CullenSharp/Etch-A-Tune/Prototype/Prttyp_V0.1_img1.jpg

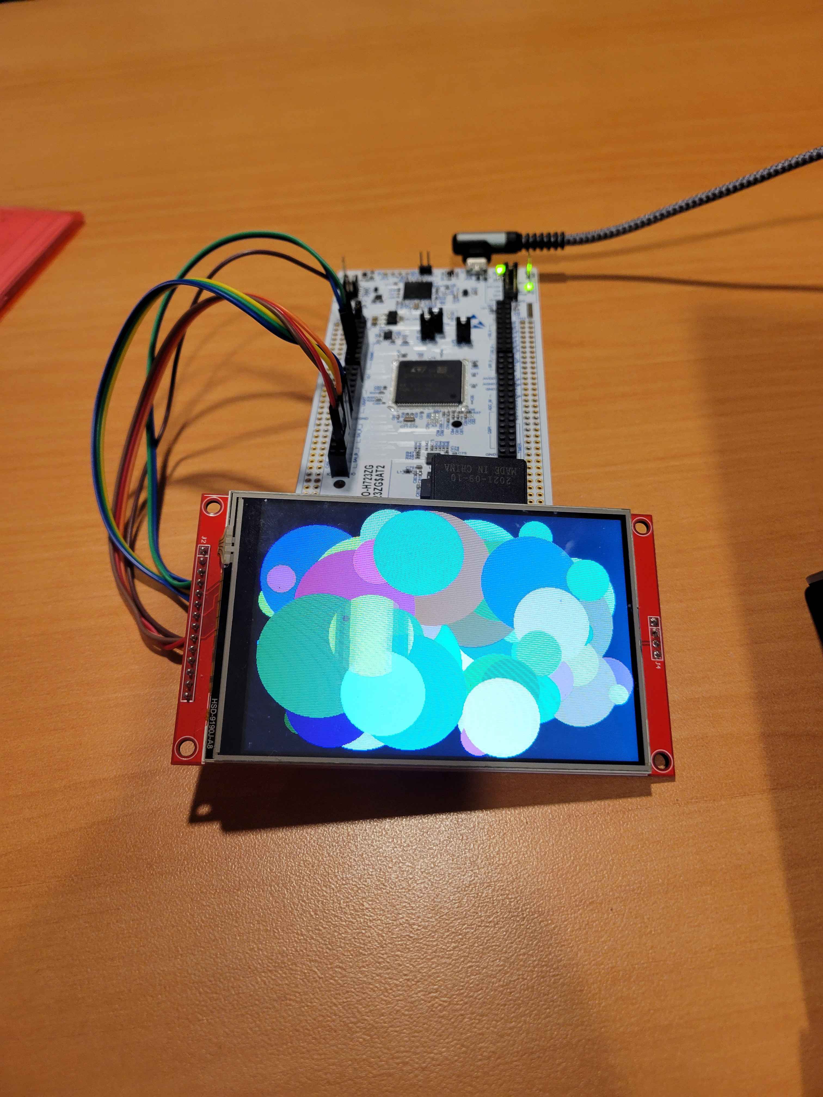
Prototype/Prttyp_V0.1_img1.jpg
