CullenSharp/Etch-A-Tune/Etch_A_Tune/Etch a Tune Bom.xlsx

Bill Of Materials for: [7] [Etch A Tune]
Last modified: [11/21/25]
PCB version: [PCB VERSION 1.0]
BOM revision: [BOM REVISION 1.0]
Qty | Reference Designators | Mfr | Mfr Part Number | Description | Dist | Dist Part Number | Cost Ea. | Cost Total
1 | BT1 | Keystone Electronics | 1042P | BATTERY HOLDER 18650 SMD | Digikey | 36-1042P-ND | $5.54 | $5.54
6 | C1,C2,C12,C25,C30,C31 | Samsung Electro-Mechanics | CL10B105KA8NNNC | CAP CER 1UF 25V X7R 0603 | Digikey | 1276-1184-1-ND | $0.08 | $0.48
20 | C3,C6,C7,C10,C11,C13,C14,C15,C16,C17,C18,C19,C20,C21,C22,C23,C24,C26,C28,C29 | Samsung Electro-Mechanics | CL10E104KC8VPNC | CAP CER 100NF 100V X8L 0603 | Digikey | 1276-CL10E104KC8VPNCCT-ND | $0.25 | $5.00
2 | C4,C9 | Samsung Electro-Mechanics | CL10A106KP8NNNC | CAP CER 10UF 10V X5R 0603 | Digikey | 1276-1192-1-ND | $0.08 | $0.16
1 | C5 | KEMET | C0603C220J5GACTU | CAP CER 22PF 50V C0G/NP0 0603 | Digikey | 399-C0603C220J5GACTUCT-ND | $0.12 | $0.12
1 | C8 | Cal-Chip Electronics, Inc. | GMC32X5R337M6R3NT | CAP1210 X5R 330UF 20% 6.3V | Digikey | 4713-GMC32X5R337M6R3NTCT-ND | $4.26 | $4.26
1 | C27 | Samsung Electro-Mechanics | CL10A475KO8NNNC | CAP CER 4.7UF 16V X5R 0603 | Digikey | 1276-1784-1-ND | $0.08 | $0.08
1 | C32 | KEMET | C0603C221K5RACTU | CAP CER 220PF 50V X7R 0603 | Digikey | 399-C0603C221K5RACTUCT-ND | $0.10 | $0.10
1 | C33 | KEMET | C0603C102J8HACAUTO | CAP CER 0603 1NF 10V ULTRA STABL | Digikey | 399-C0603C102J8HACAUTOCT-ND | $0.13 | $0.13
2 | C36,C37 | KEMET | CBR04C180F5GAC | CAP CER 18PF 50V C0G/NP0 0402 | Digikey | 399-8828-1-ND | $0.35 | $0.70
2 | CR1,CR2 | Toshiba Semiconductor and Storage | CMS06(TE12L,Q,M) | DIODE SCHOTTKY 30V 2A MFLAT | Digikey | CMS06QMCT-ND | $0.23 | $0.46
2 | D1,D2 | WÃ¼rth Elektronik | 150060GS75000 | LED GREEN CLEAR 0603 SMD | Digikey | 732-4971-1-ND | $0.15 | $0.30
1 | FB1 | Murata Electronics | BLM18AG601SN1D | FERRITE BEAD 600 OHM 0603 1LN | Digikey | 490-1014-1-ND | $0.10 | $0.10
1 | J1 | Amphenol | 75915-414LF | Board to Board & Mezzanine Connectors 14P VRT SR RECEPT MATTE TIN | Digikey | 609-75915-414LF-ND | $1.86 | $1.86
3 | J2,J3,J6 | Amphenol ICC (FCI) | 91601-304ALF | 4 Position Receptacle, Bottom or Top Entry Connector 0.100" (2.54mm) Surface Mount Gold | Digikey | 609-91601-304ALFCT-ND | $0.76 | $2.28
1 | J4 | Molex | 2171790001 | USB-C (USB TYPE-C) USB 2.0 Receptacle Connector 24 (16+8 Dummy) Position Surface Mount, Right Angle; Through Hole | Digikey | 900-2171790001CT-ND | $0.83 | $0.83
1 | J5 | Same Sky (Formerly CUI Devices) | SJ-3524-SMT-TR-PI | CONN JACK STEREO 3.5MM SMD R/A | Digikey | CP-3524SJPICT-ND | $1.22 | $1.22
1 | J7 | CNC Tech | 3220-10-0300-00 | CONN HEADER SMD 10POS 1.27MM | Digikey | 1175-1629-ND | $0.81 | $0.81
1 | L1 | Taiyo Yuden | BRL3225T1R0M | FIXED IND 1UH 2.2A 51.6 MOHM SMD | Digikey | 587-2164-1-ND | $0.18 | $0.18
2 | MT1,MT2 | Same Sky (Formerly CUI Devices) | RIC11-31S15D7-GSMT | ENCODER INCREM QUAD VERT SMD/SMT | Digikey | 2223-RIC11-31S15D7-GSMT-ND | $2.14 | $4.28
1 | R1 | TE Connectivity Passive Product | CRGCQ0603F27K | 27 kOhms Â±1% 0.1W, 1/10W Chip Resistor 0603 (1608 Metric) Automotive AEC-Q200, Moisture Resistant Thick Film | Digikey | A129705CT-ND | $0.10 | $0.10
1 | R2 | Panasonic Electronic Components | ERA-3AEB6040V | 604 Ohms Â±0.1% 0.1W, 1/10W Chip Resistor 0603 (1608 Metric) Automotive AEC-Q200 Thin Film | Digikey | P604DBCT-ND | $0.10 | $0.10
1 | R3 | YAGEO | RC0603JR-07330RL | 330 Ohms Â±5% 0.1W, 1/10W Chip Resistor 0603 (1608 Metric) Moisture Resistant Thick Film | Digikey | 311-330GRCT-ND | $0.10 | $0.10
1 | R4 | YAGEO | RC0603JR-072K2L | 2.2 kOhms Â±5% 0.1W, 1/10W Chip Resistor 0603 (1608 Metric) Moisture Resistant Thick Film | Digikey | 311-2.2KGRCT-ND | $0.11 | $0.11
1 | R5 | Panasonic Electronic Components | ERJ-3EKF3603V | 360 kOhms Â±1% 0.1W, 1/10W Chip Resistor 0603 (1608 Metric) Automotive AEC-Q200 Thick Film | Digikey | P360KHCT-ND | $0.10 | $0.10
1 | R6 | YAGEO | RC0603JR-07180KL | 180 kOhms Â±5% 0.1W, 1/10W Chip Resistor 0603 (1608 Metric) Moisture Resistant Thick Film | Digikey | 311-180KGRCT-ND | $0.10 | $0.10
14 | R7,R8,R9,R10,R11,R12,R13,R14,R15,R16,R17,R18,R19,R31 | YAGEO | RC0603FR-0710KL | 10 kOhms Â±1% 0.1W, 1/10W Chip Resistor 0603 (1608 Metric) Moisture Resistant Thick Film | Digikey | 311-10.0KHRCT-ND | $0.10 | $1.40
2 | R20,R21 | Stackpole Electronics Inc | RMCF0603FT10R0 | 10 Ohms Â±1% 0.1W, 1/10W Chip Resistor 0603 (1608 Metric) Automotive AEC-Q200 Thick Film | Digikey | RMCF0603FT10R0CT-ND | $0.10 | $0.20
2 | R22,R23 | YAGEO | RC0603JR-075K1L | 5.1 kOhms Â±5% 0.1W, 1/10W Chip Resistor 0603 (1608 Metric) Moisture Resistant Thick Film | Digikey | 311-5.1KGRCT-ND | $0.10 | $0.20
12 | R24,R25,R26,R27,R28,R29,R30,R33,R34,R35,R36,R39 | YAGEO | RC0603JR-070RL | RES 0 OHM JUMPER 1/10W 0603 | Digikey | 311-0.0GRCT-ND | $0.10 | $1.20
4 | R32,R37,R38,R40 | YAGEO | RC0603JR-070RL | RES 0 OHM JUMPER 1/10W 0603 | Digikey | 311-0.0GRCT-ND | $0.10 | $0.40
5 | S1,S2,S3,S4,S5 | OMRON Electronics | B3AL-1005P | Tactile Switches 4.50N OF Long Stroke Pink Button | Digikey | Z7816CT-ND | $1.53 | $7.65
1 | S6 | WÃ¼rth Elektronik | 450404015514 | Slide Switch SPDT Surface Mount | Digikey | 732-13665-1-ND | $0.80 | $0.80
1 | U1 | Texas Instruments | BQ29700DSER | Voltage and Current Protection for Single-Cell Li-Ion and Li-Polymer Batteries | Digikey | 296-43985-1-ND | $0.51 | $0.51
2 | U2,U3 | Texas Instruments | CSD16406Q3 | MOSFET N-CH 25V 19A/60A 8VSON | Digikey | 296-24251-1-ND | $1.65 | $3.30
1 | U4 | Texas Instruments | TPS62063DSGR | Buck Switching Regulator IC Positive Fixed 3.3V 1 Output 1.6A 8-WFDFN Exposed Pad | Digikey | 296-38304-1-ND | $2.12 | $2.12
1 | U5 | STMicroelectronics | STM32H7A3ZIT6Q | ARMÂ® CortexÂ®-M7 STM32H7 Microcontroller IC 32-Bit 280MHz 2MB (2M x 8) FLASH 144-LQFP (20x20) | Digikey | 497-STM32H7A3ZIT6Q-ND | $14.86 | $14.86
1 | U6 | Texas Instruments | BQ25170DSGR | 800-MA LINEAR BATTERY CHARGER FO | Digikey | 296-BQ25170DSGRCT-ND | $0.96 | $0.96
1 | Y2 | Abracon LLC | ABM8G-12.000MHZ-D2Y-T | CRYSTAL 12.0000MHZ 18PF SMD | Digikey | 535-ABM8G-12.000MHZ-D2Y-TCT-ND | $0.57 | $0.57
VERSION INFO
 |  |  |  |  |  |  | Total: | $63.67
Rev | Date
1.0r1 | 2025-11-21
