CullenSharp/Etch-A-Tune/Enclosure Parts/Painted Capture.pdf

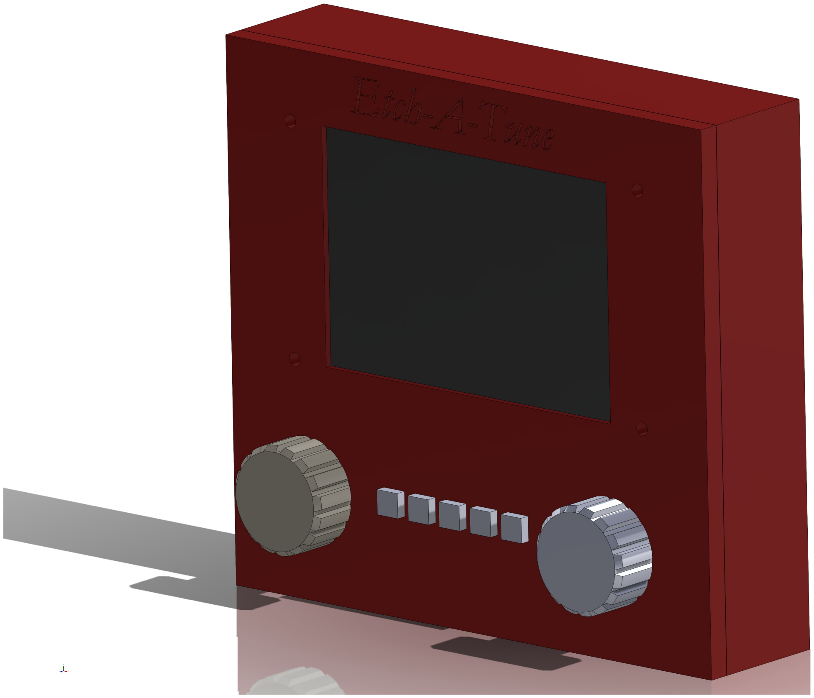
[picture p2: page 1]
