CullenSharp/Etch-A-Tune/Enclosure Parts/Assembly V1.SLDASM

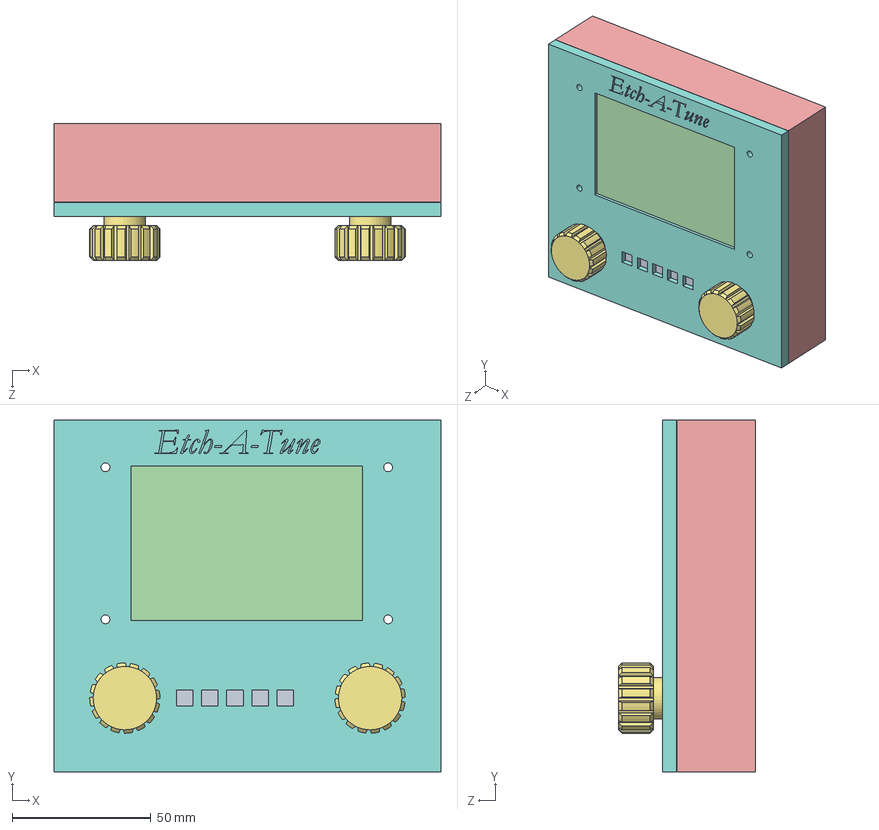
[picture p3: CAD file, 2025-12-13]
Enclosure Parts/Assembly V1.SLDASM
139.7 x 127.0 x 49.6 mm
Front Panel(Old Screen)
Knob x 2
PCB
Back Plate
Screen(Old)
Battery Holder
Battery Cover
Button x 5
