CullenSharp/Etch-A-Tune/Enclosure Parts/Front Panel.SLDPRT

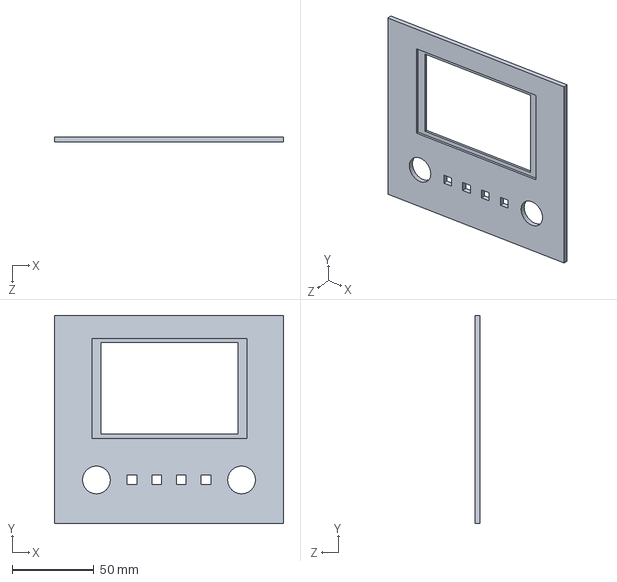
[picture p4: CAD file, 2025-12-13]
Enclosure Parts/Front Panel.SLDPRT
139.7 x 127.0 x 3.17 mm
