CullenSharp/Etch-A-Tune/Enclosure Parts/PCB.SLDPRT

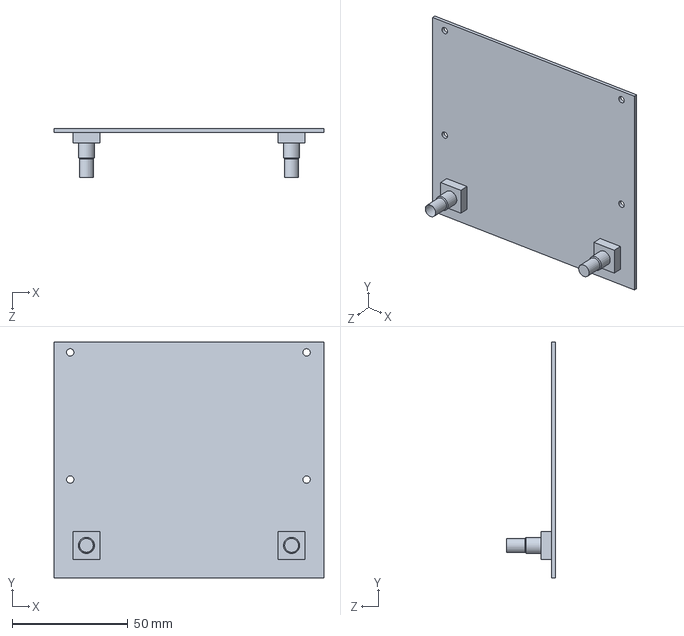
[picture p5: CAD file, 2025-12-13]
Enclosure Parts/PCB.SLDPRT
116.5 x 101.7 x 21.2 mm
