CullenSharp/Etch-A-Tune/Enclosure Parts/Screen.SLDPRT

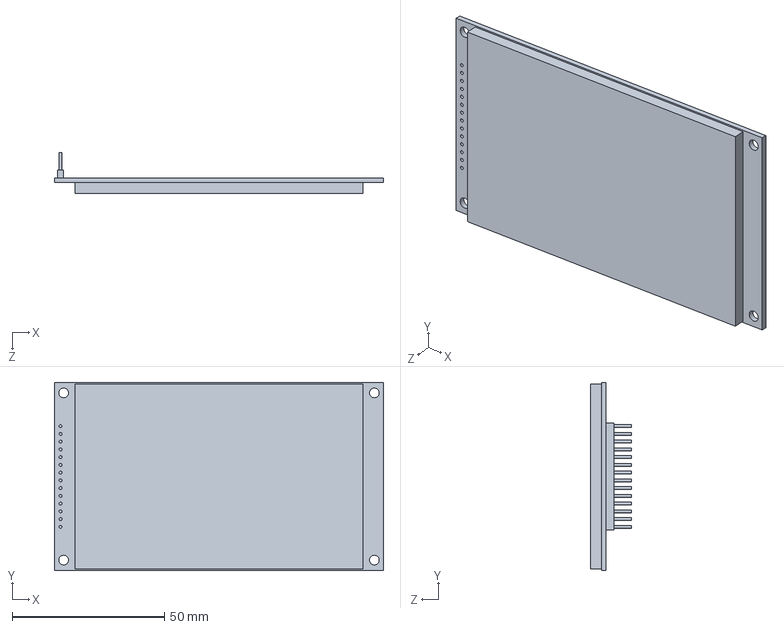
[picture p6: CAD file, 2025-12-13]
Enclosure Parts/Screen.SLDPRT
108.0 x 61.7 x 13.5 mm
