CullenSharp/Etch-A-Tune/Enclosure Parts/Front Panel Test Print V4.SLDPRT

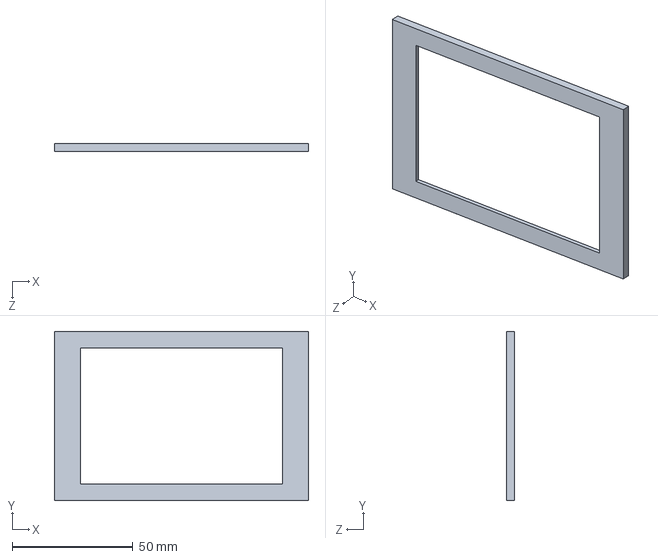
[picture p7: CAD file, 2025-12-13]
Enclosure Parts/Front Panel Test Print V4.SLDPRT
105.0 x 70.0 x 3.17 mm
