CullenSharp/Etch-A-Tune/Enclosure Parts/Back Plate.SLDPRT

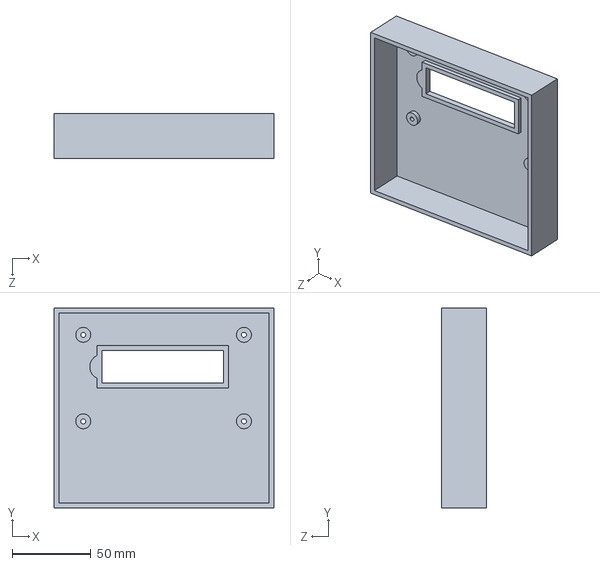
[picture p8: CAD file, 2025-12-13]
Enclosure Parts/Back Plate.SLDPRT
139.7 x 127.0 x 28.4 mm
