CullenSharp/Etch-A-Tune/Enclosure Parts/Battery Cover.SLDPRT

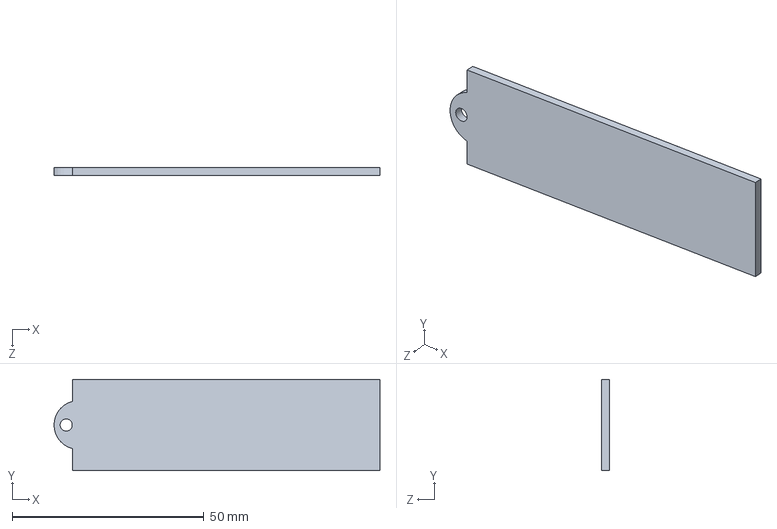
[picture p9: CAD file, 2025-12-13]
Enclosure Parts/Battery Cover.SLDPRT
85.0 x 23.8 x 2.00 mm
