CullenSharp/Etch-A-Tune/Enclosure Parts/Knob.SLDPRT

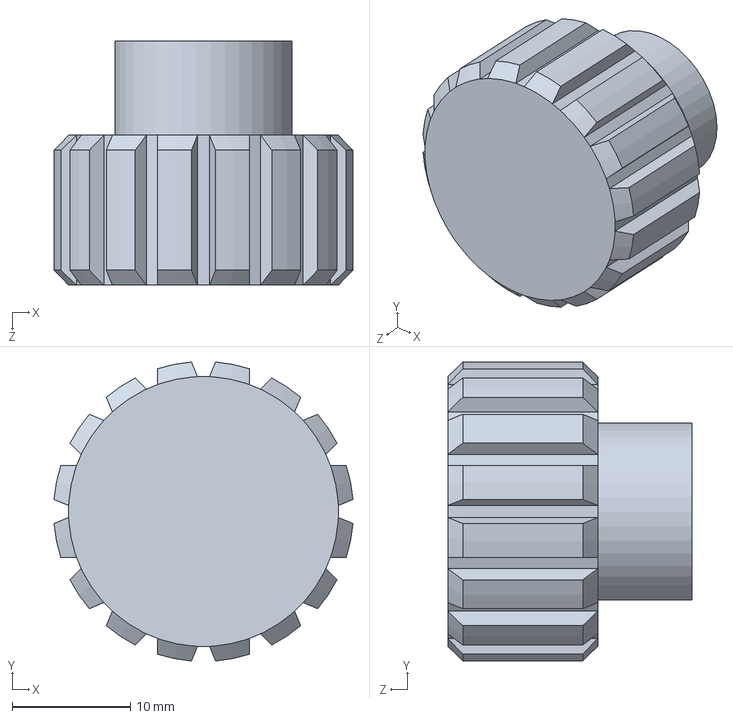
[picture p10: CAD file, 2025-12-13]
Enclosure Parts/Knob.SLDPRT
25.3 x 25.3 x 20.7 mm
