CullenSharp/Etch-A-Tune/Enclosure Parts/Battery Holder.SLDPRT

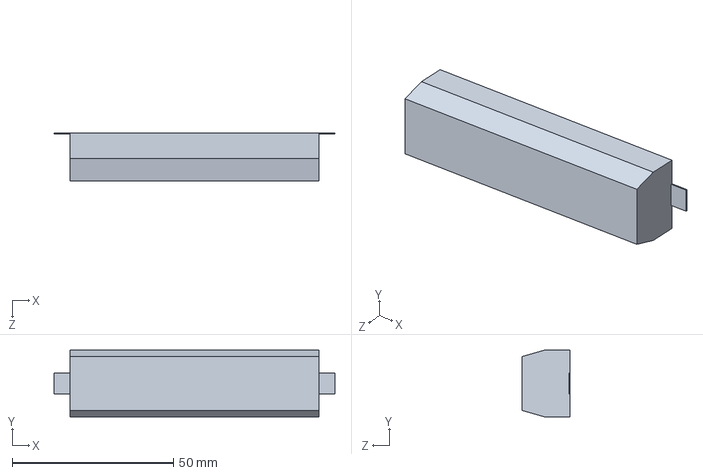
[picture p11: CAD file, 2025-12-13]
Enclosure Parts/Battery Holder.SLDPRT
87.1 x 20.6 x 15.0 mm
