CullenSharp/Etch-A-Tune/Enclosure Parts/Front Panel Test Print.SLDPRT

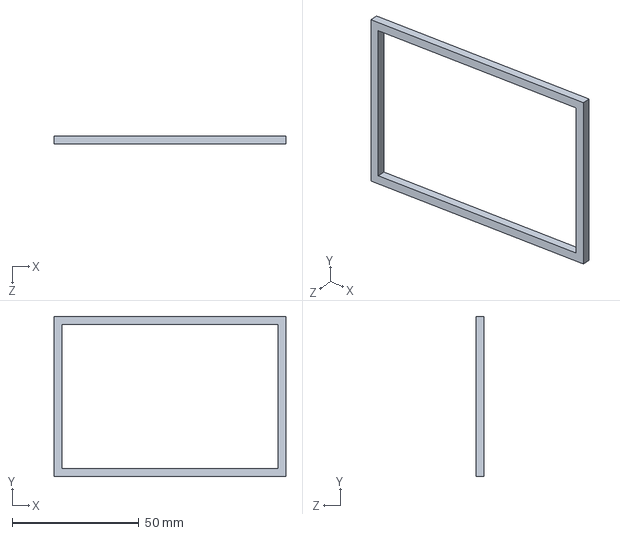
[picture p12: CAD file, 2025-12-13]
Enclosure Parts/Front Panel Test Print.SLDPRT
91.6 x 63.2 x 3.17 mm
