CullenSharp/Etch-A-Tune/Enclosure Parts/Button.SLDPRT

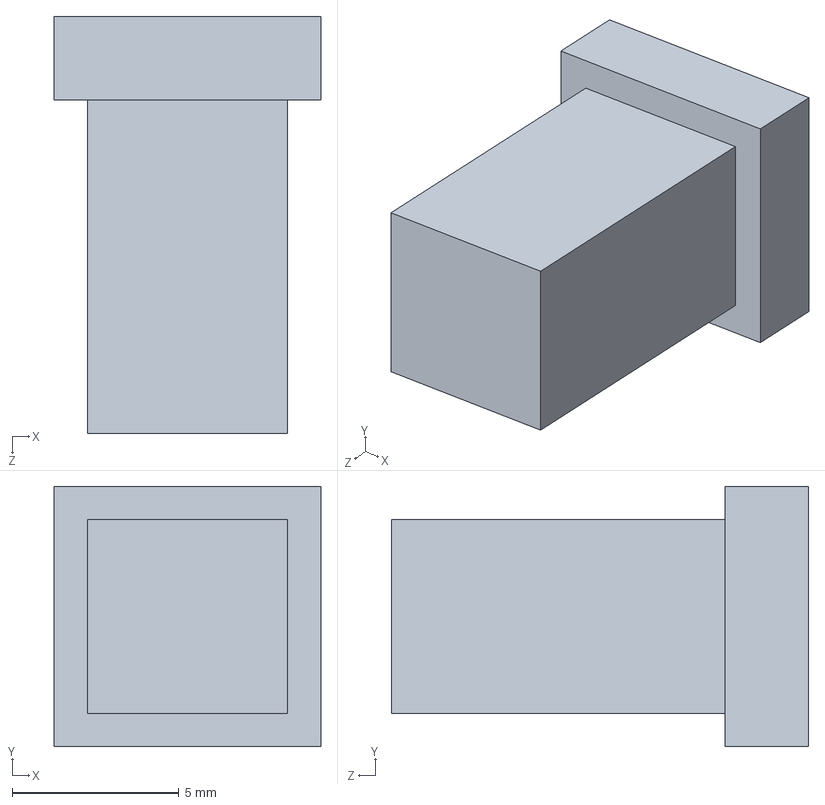
[picture p13: CAD file, 2025-12-13]
Enclosure Parts/Button.SLDPRT
8.00 x 7.80 x 12.5 mm
