CullenSharp/Etch-A-Tune/Enclosure Parts/Old Screen Assembly.SLDASM

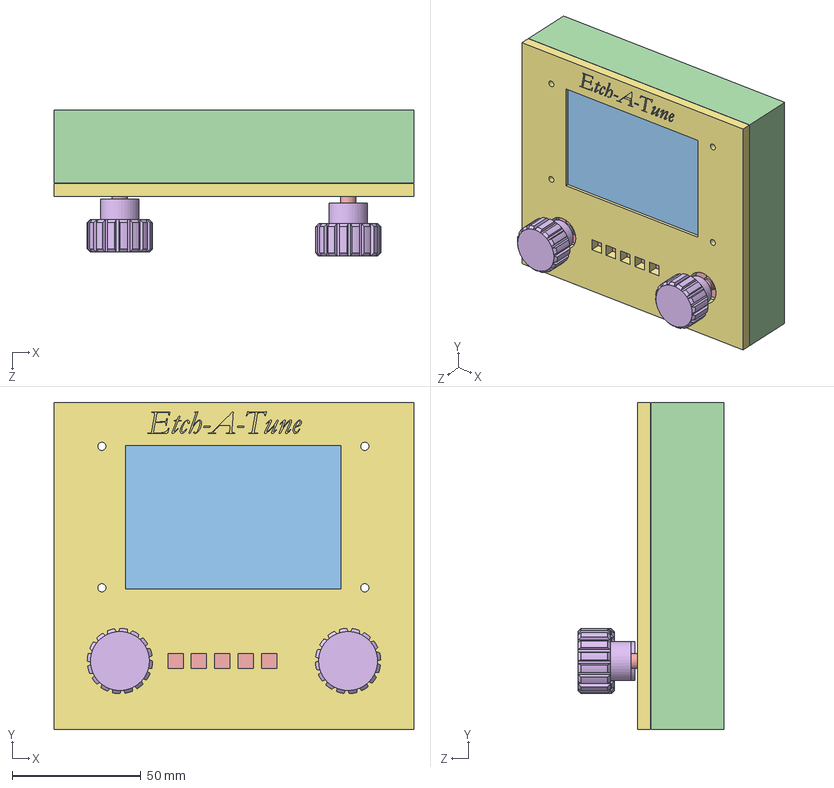
[picture p14: CAD file, 2025-12-13, an earlier design]
Enclosure Parts/Old Screen Assembly.SLDASM
139.7 x 127.0 x 56.8 mm
Front Panel(Old Screen)
Knob x 2
PCB
Back Plate
Screen(Old)
Battery Holder
Battery Cover
