CullenSharp/Etch-A-Tune/Enclosure Parts/Front Panel Test Print V3.STL

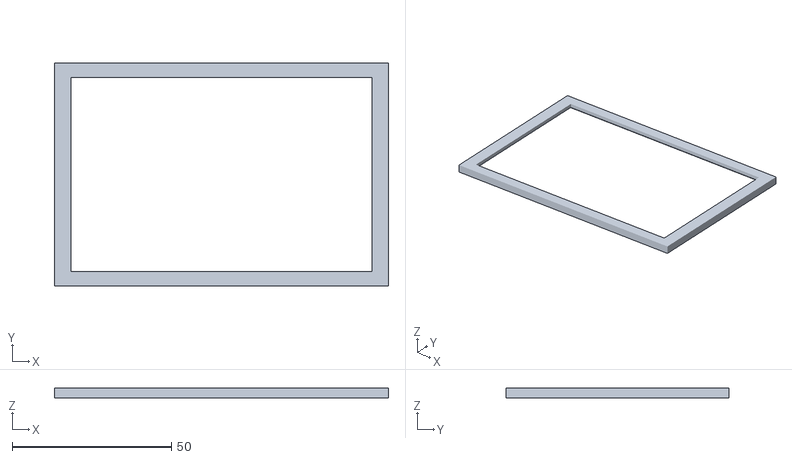
[picture p15: CAD file, 2025-12-13, an earlier design]
Enclosure Parts/Front Panel Test Print V3.STL
105.0 x 70.0 x 3.17
