CullenSharp/Etch-A-Tune/Enclosure Parts/Front Panel(Old Screen).SLDPRT

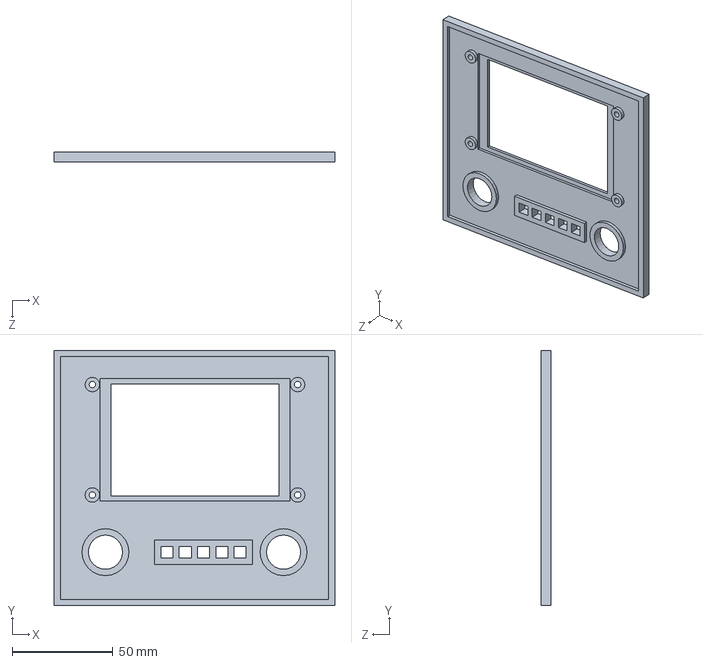
[picture p16: CAD file, 2025-12-13, an earlier design]
Enclosure Parts/Front Panel(Old Screen).SLDPRT
139.7 x 127.0 x 5.14 mm
