CullenSharp/Etch-A-Tune/(list of files, cad)

Other CAD files:
Enclosure Parts/Front Panel Test Print 2.SLDPRT
Enclosure Parts/Screen(Old).SLDPRT
Enclosure Parts/Front Panel Test Print 2.STL
Enclosure Parts/Front Panel Test Print V4.STL
