CullenSharp/Etch-A-Tune/Enclosure Parts/Assembly Capture.pdf

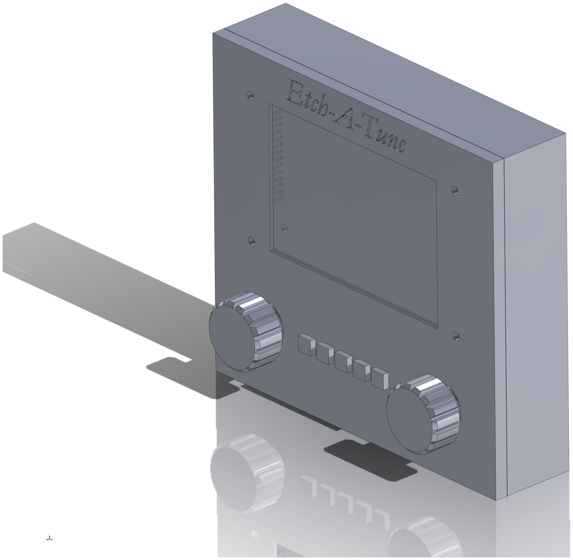
[picture p17: page 1]
