CullenSharp/Etch-A-Tune/Etch_A_Tune/Etch_a_Sketch_Schematic_V0.2/Etch A Tune PCB v.02.pdf

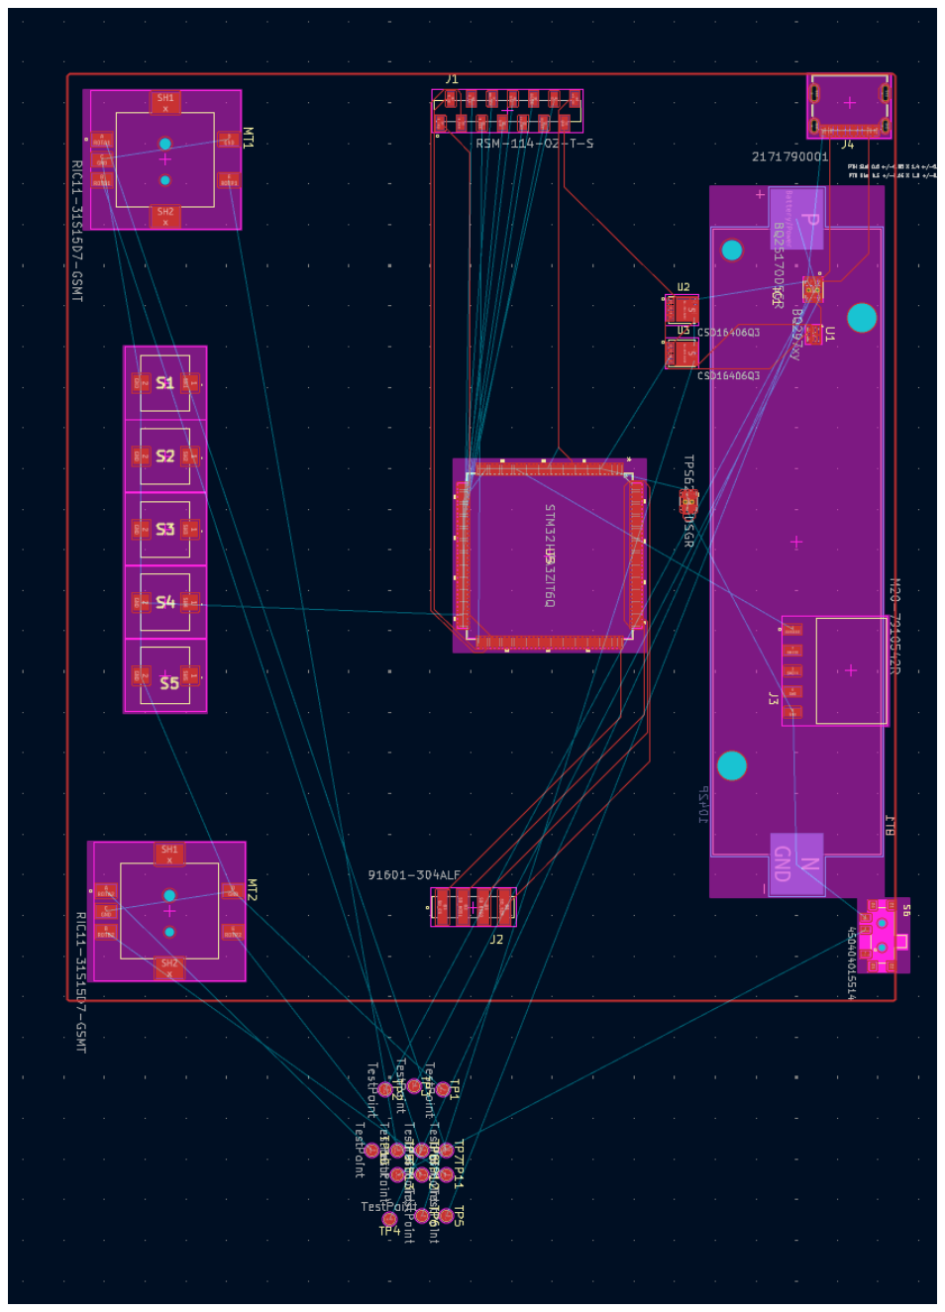
[picture p19: page 1]
