CullenSharp/Etch-A-Tune/Test Data/Test Image A 480x320.png

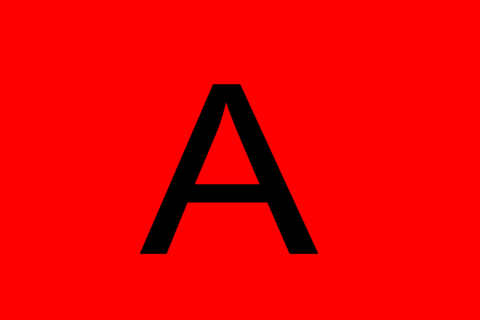
Test Data/Test Image A 480x320.png
