CullenSharp/Etch-A-Tune/Etch_A_Tune.pdf

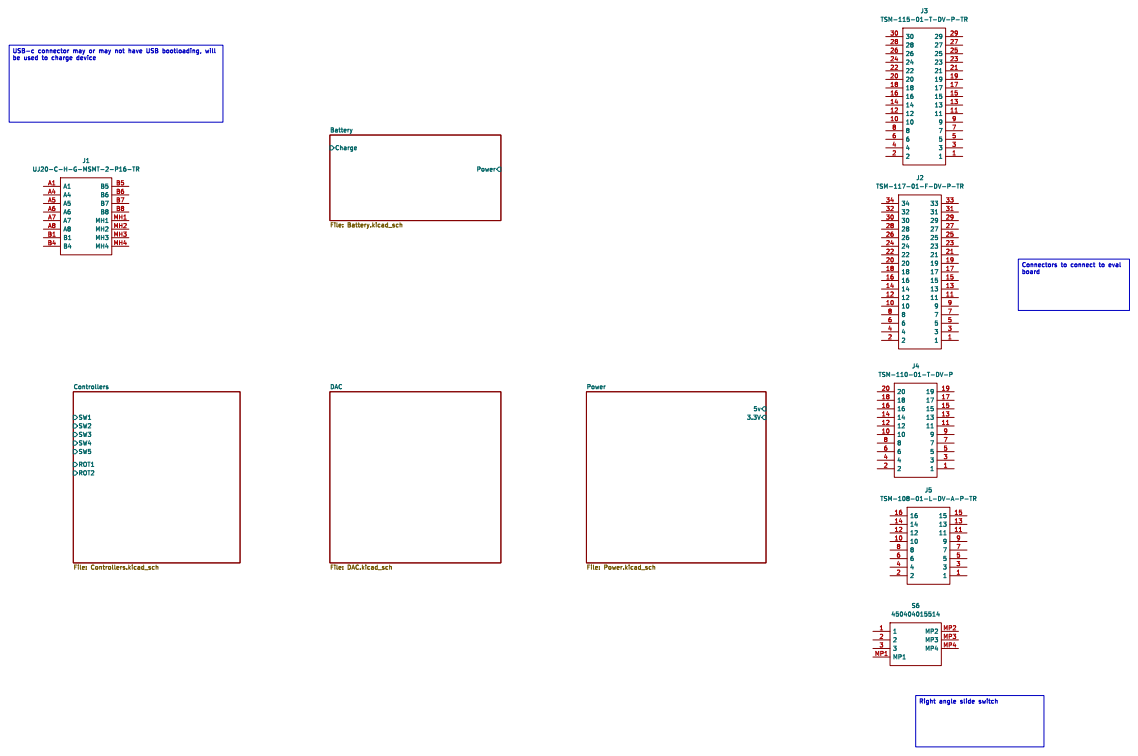
[picture p21: page 1]

File: DAC.kicad_sch SW3 ROT2 SW4 SW5 ROT1 SW2 SW1 Controllers File: Controllers.kicad_sch

Power File: Power.kicad_sch DAC

Right angle slide switch

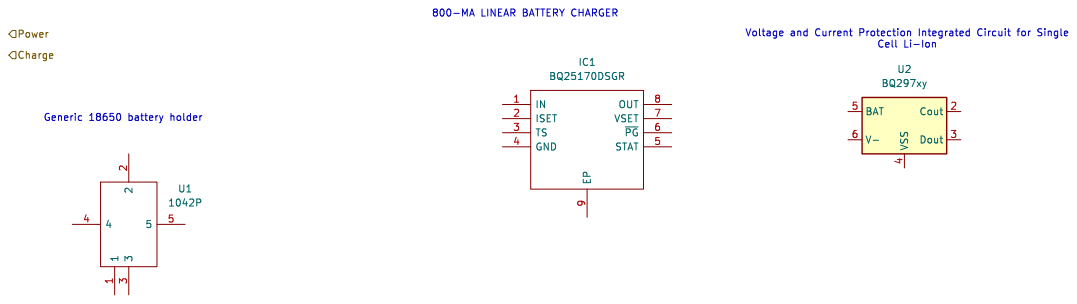
[picture p22: page 2]

9 OUT 8 VSET 7 ~{PG} 6 STAT 5

Id: 2/5 Title: File: Battery.kicad_sch Sheet: /Battery/

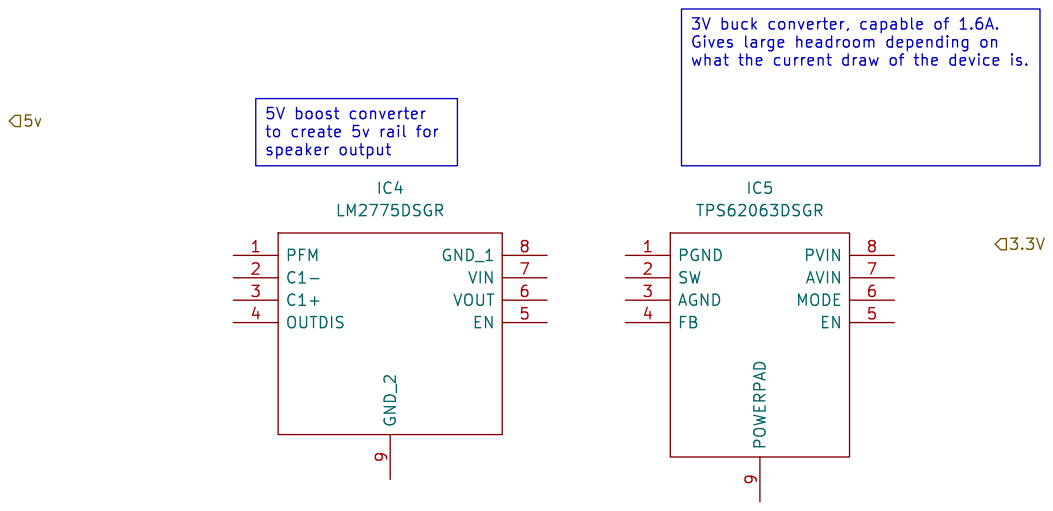
[picture p23: page 3]

to create 5v rail for speaker output

9 PVIN 8 AVIN 7 MODE 6 EN 5

Id: 3/5 Title: File: Power.kicad_sch Sheet: /Power/

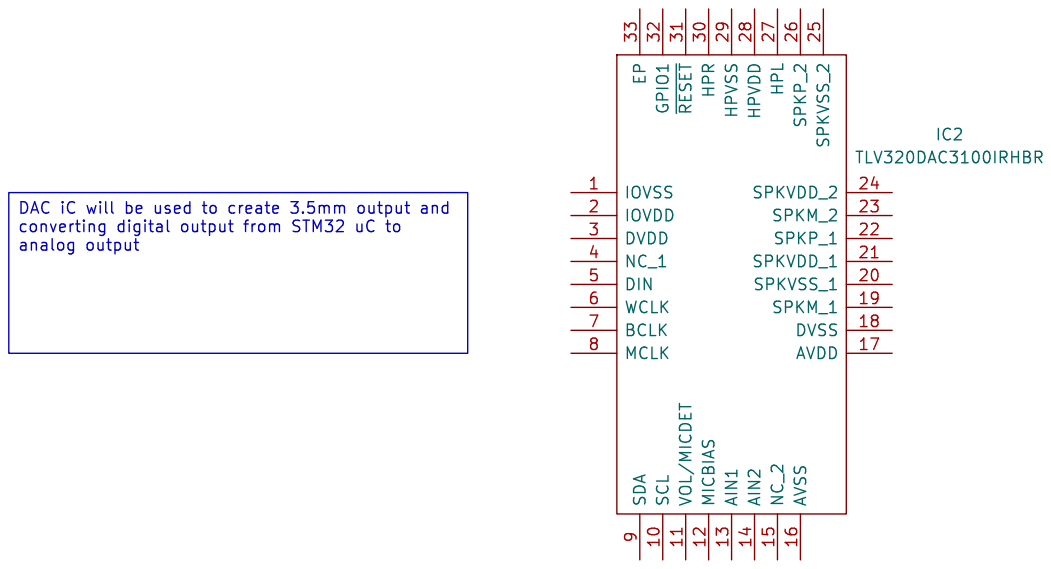
[picture p24: page 4]

9 GPIO1 32 SCL 10 ~{RESET}31 VOL/MICDET 11 HPR 30 MICBIAS 12 HPVSS 29 AIN1 13 HPVDD 28 AIN2 14 HPL 27 NC_2 15 SPKP_2 26 AVSS 16 SPKVSS_2 25 SPKVDD_2 24 SPKM_2 23 SPKP_1 22 SPKVDD_1 21 SPKVSS_1 20 SPKM_1 19 DVSS 18 AVDD 17

DAC iC will be used to create 3.5mm output and
analog output

Id: 4/5 Title: File: DAC.kicad_sch Sheet: /DAC/

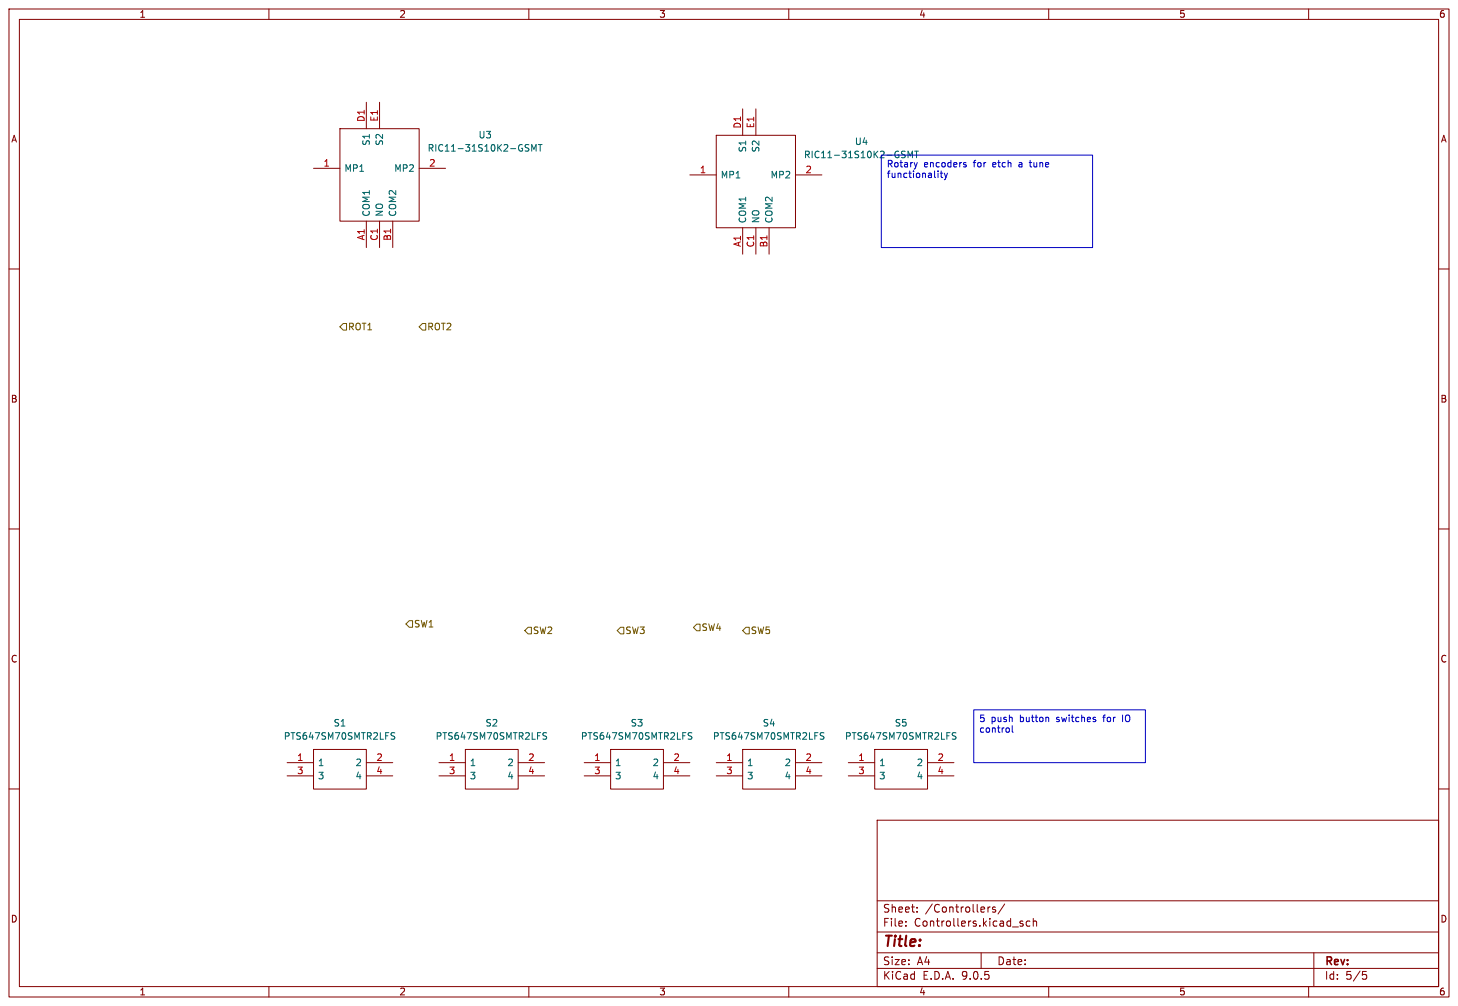
[picture p25: page 5]

Rotary encoders for etch a tune
functionality

5 push button switches for IO
control

Id: 5/5 Title: File: Controllers.kicad_sch Sheet: /Controllers/
