CullenSharp/Etch-A-Tune/Etch_A_Tune/Etch_a_Sketch_Schematic_V1.0/Etch_A_Tune.pdf

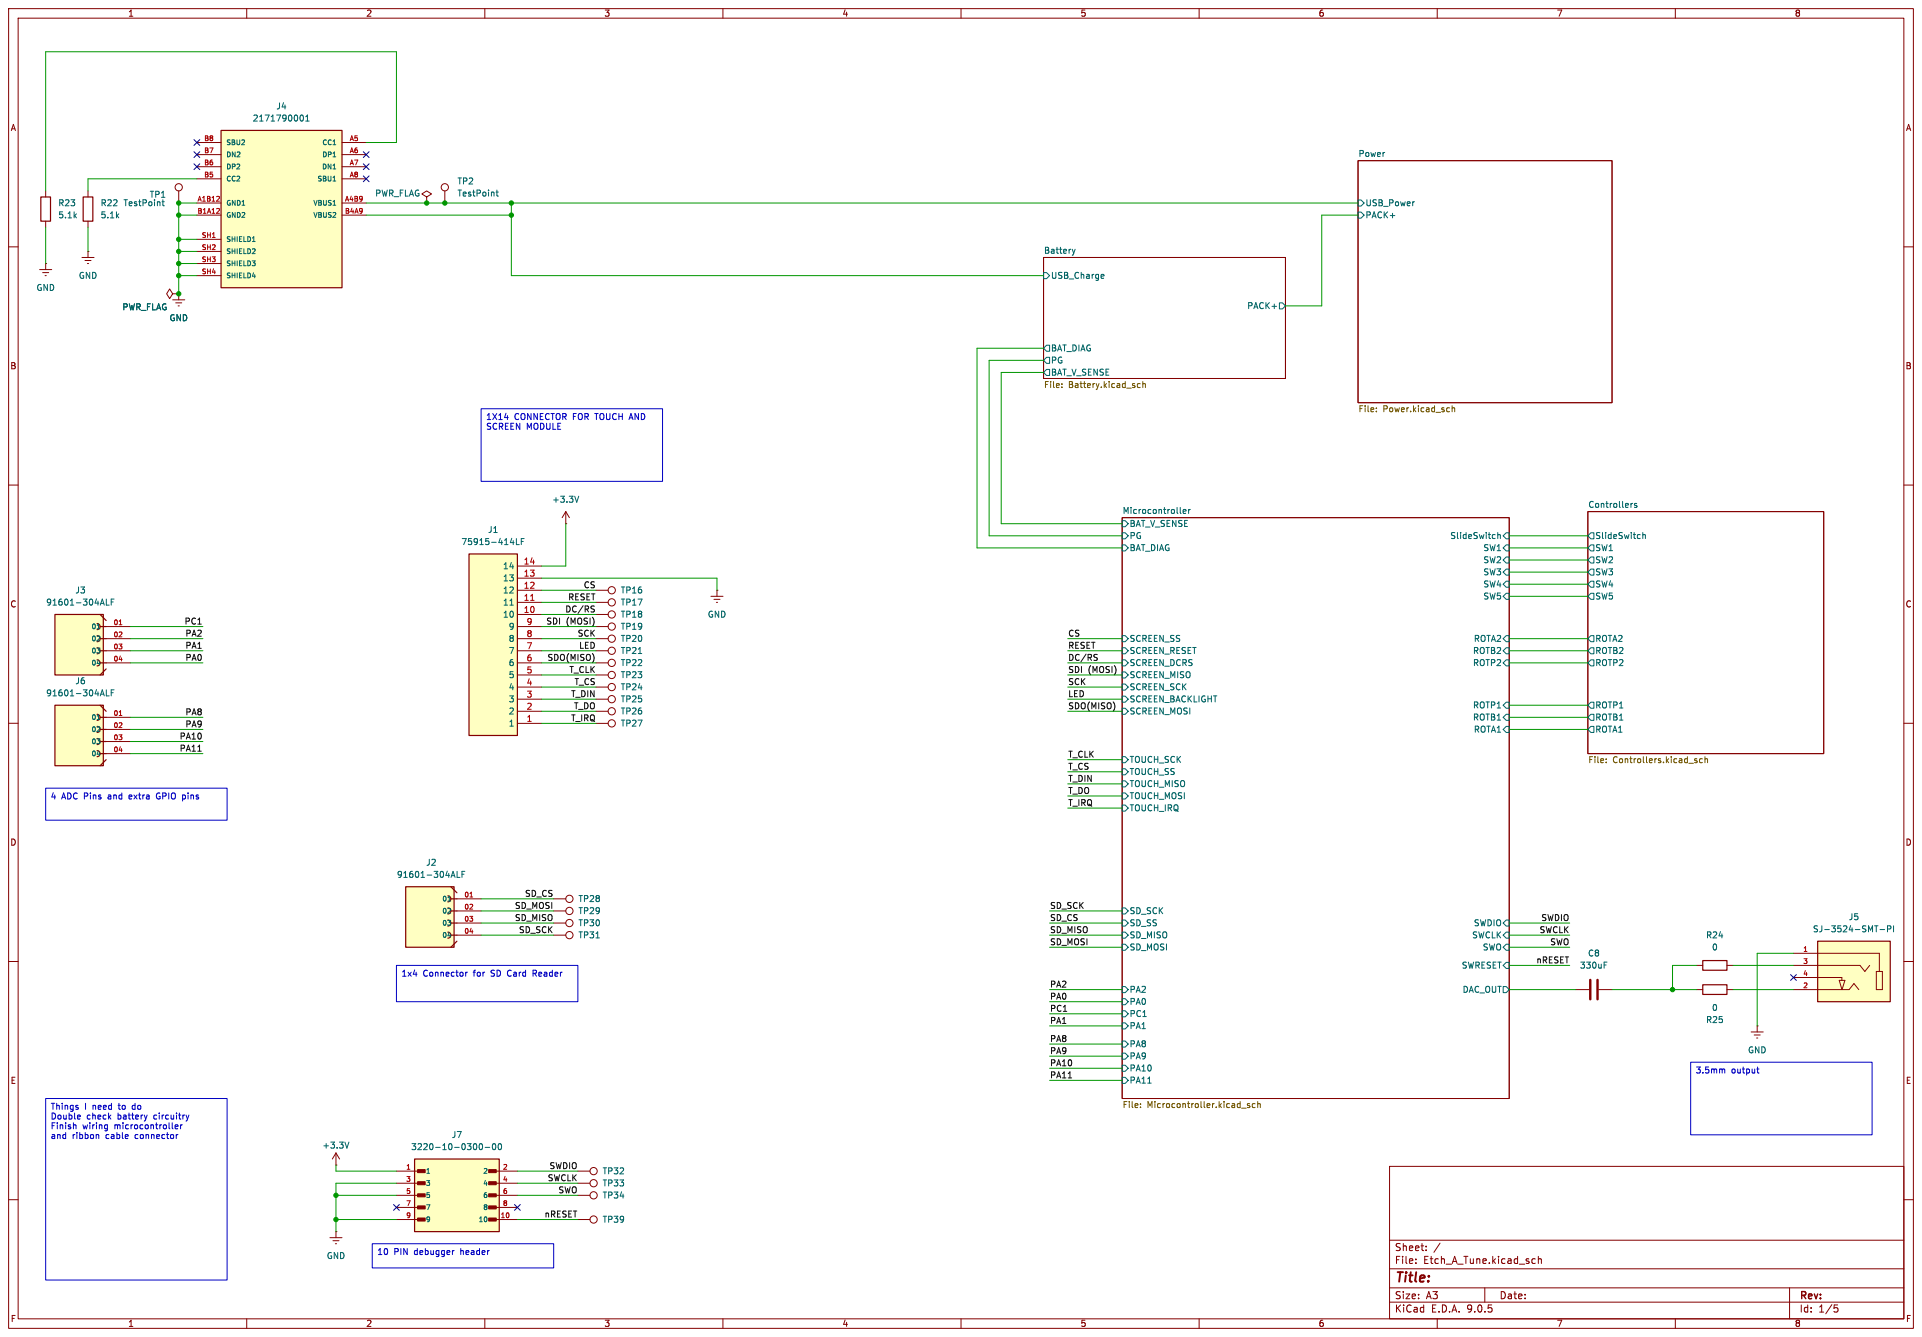
[picture p26: page 1]

1X14 CONNECTOR FOR TOUCH AND
SCREEN MODULE

SDO(MISO) SDI (MOSI) DC/RS RESET CS

3.5mm output 4 ADC Pins and extra GPIO pins

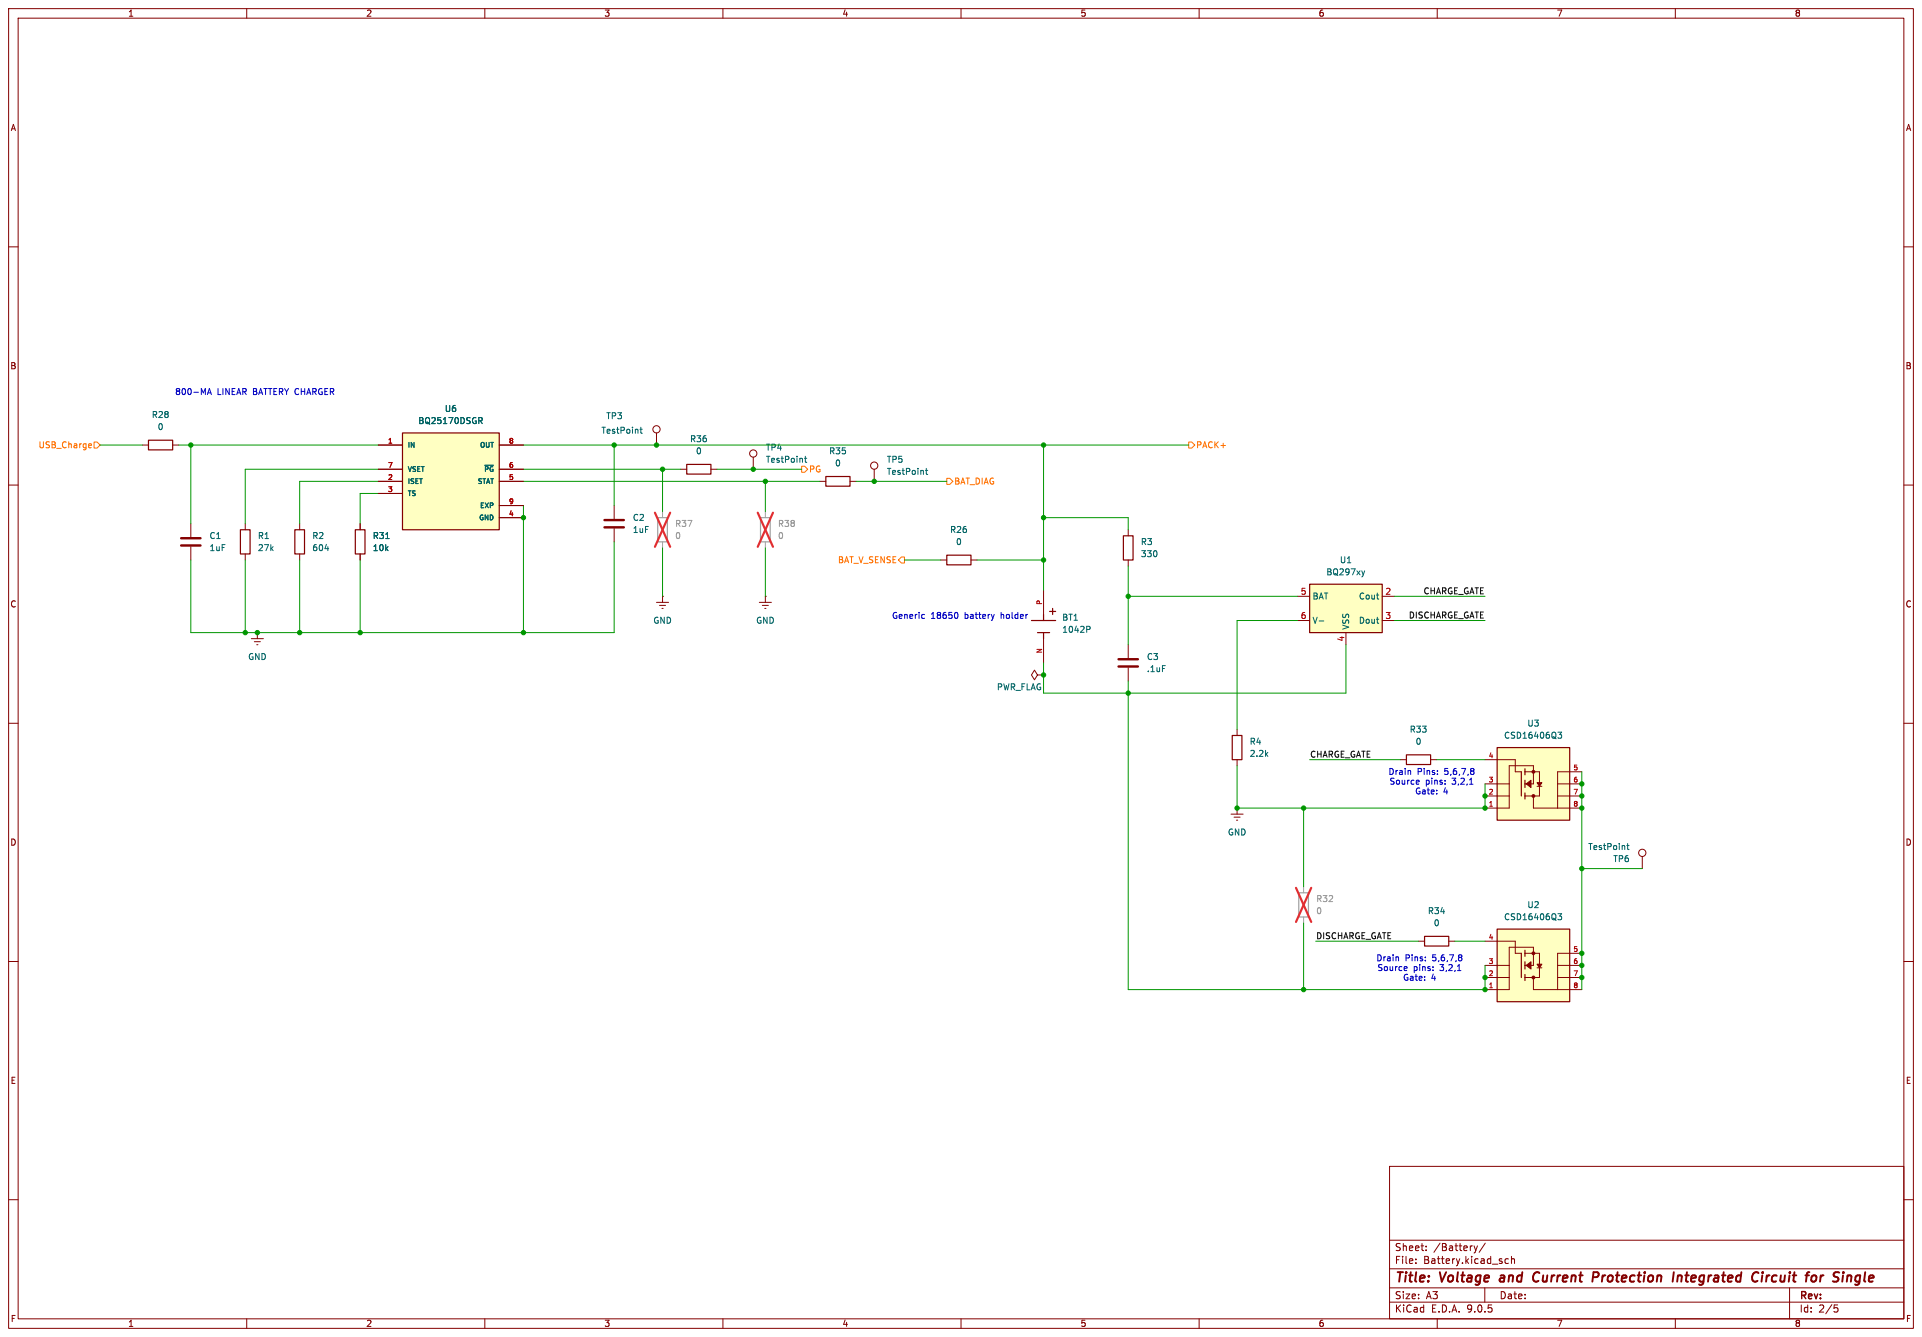
[picture p27: page 2]

Drain Pins: 5,6,7,8 Source pins: 3,2,1 Gate: 4 Generic 18650 battery holder U6 BQ25170DSGR

Id: 2/5 Title: Voltage and Current Protection Integrated Circuit for Single

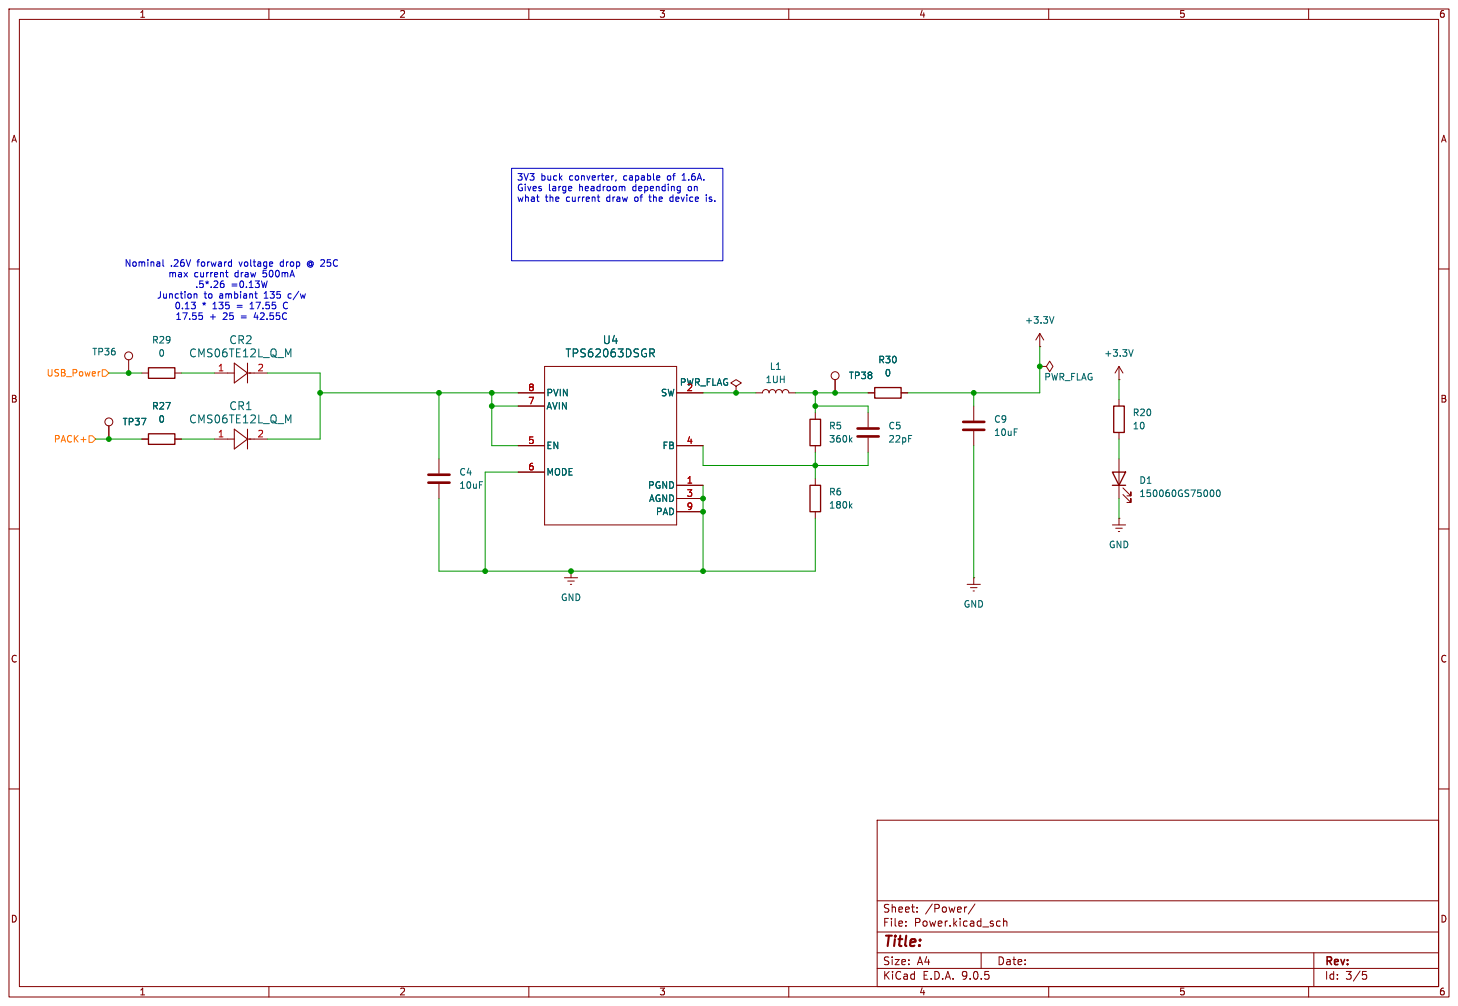
[picture p28: page 3]

Id: 3/5 Title: File: Power.kicad_sch Sheet: /Power/ C4

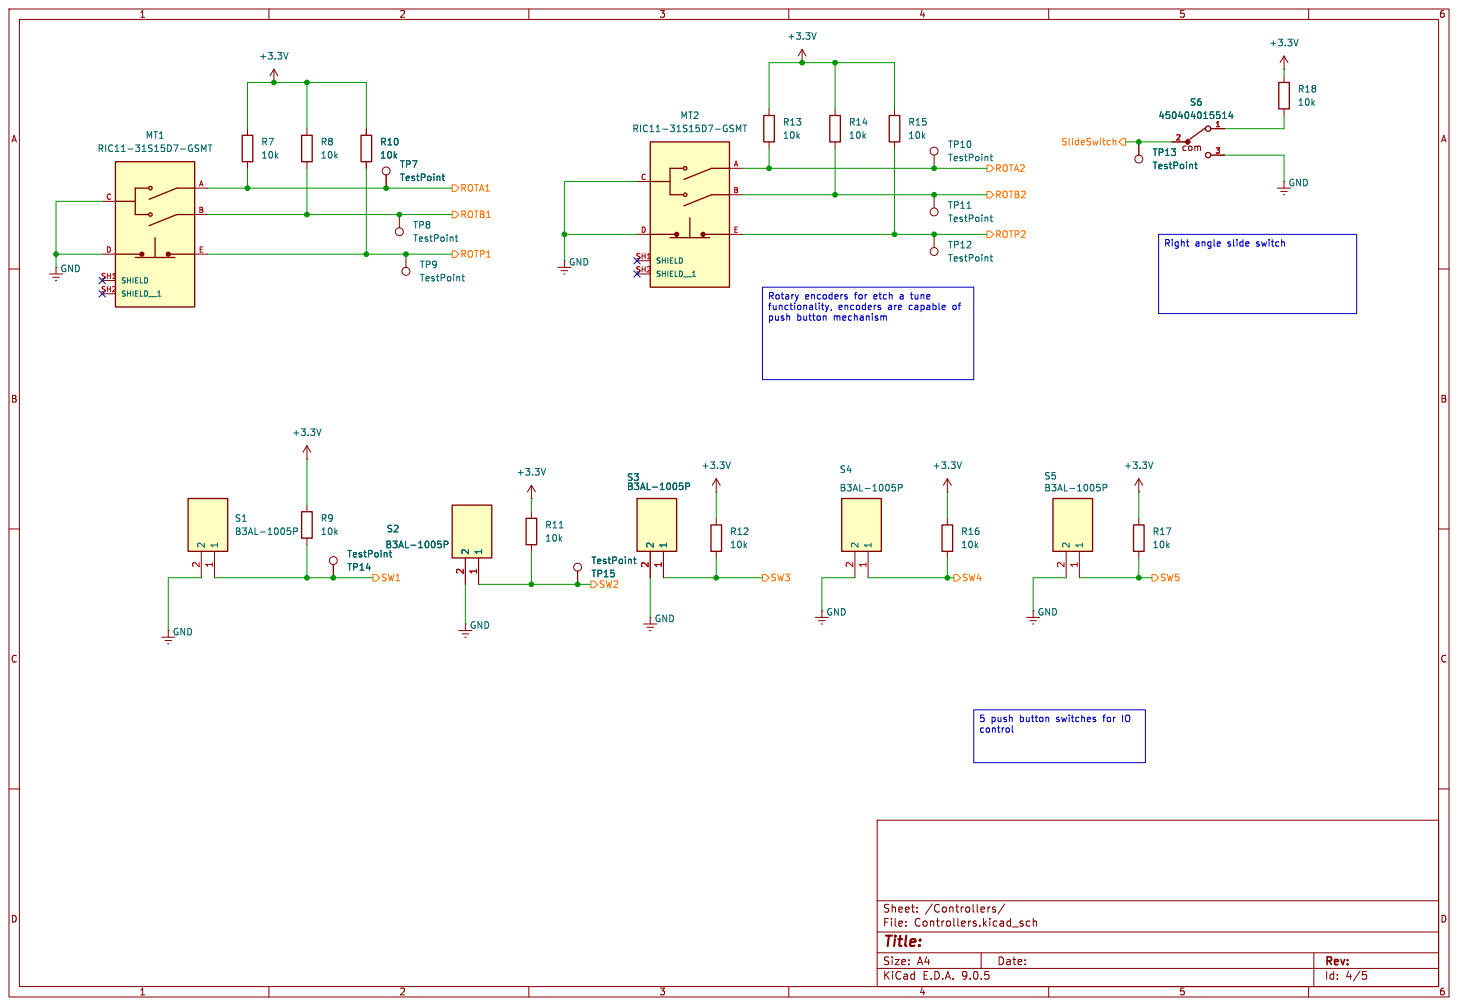
[picture p29: page 4]

E MT2 RIC11-31S15D7-GSMT

E MT1 RIC11-31S15D7-GSMT

Right angle slide switch Rotary encoders for etch a tune

5 push button switches for IO
control

Id: 4/5 Title: File: Controllers.kicad_sch Sheet: /Controllers/

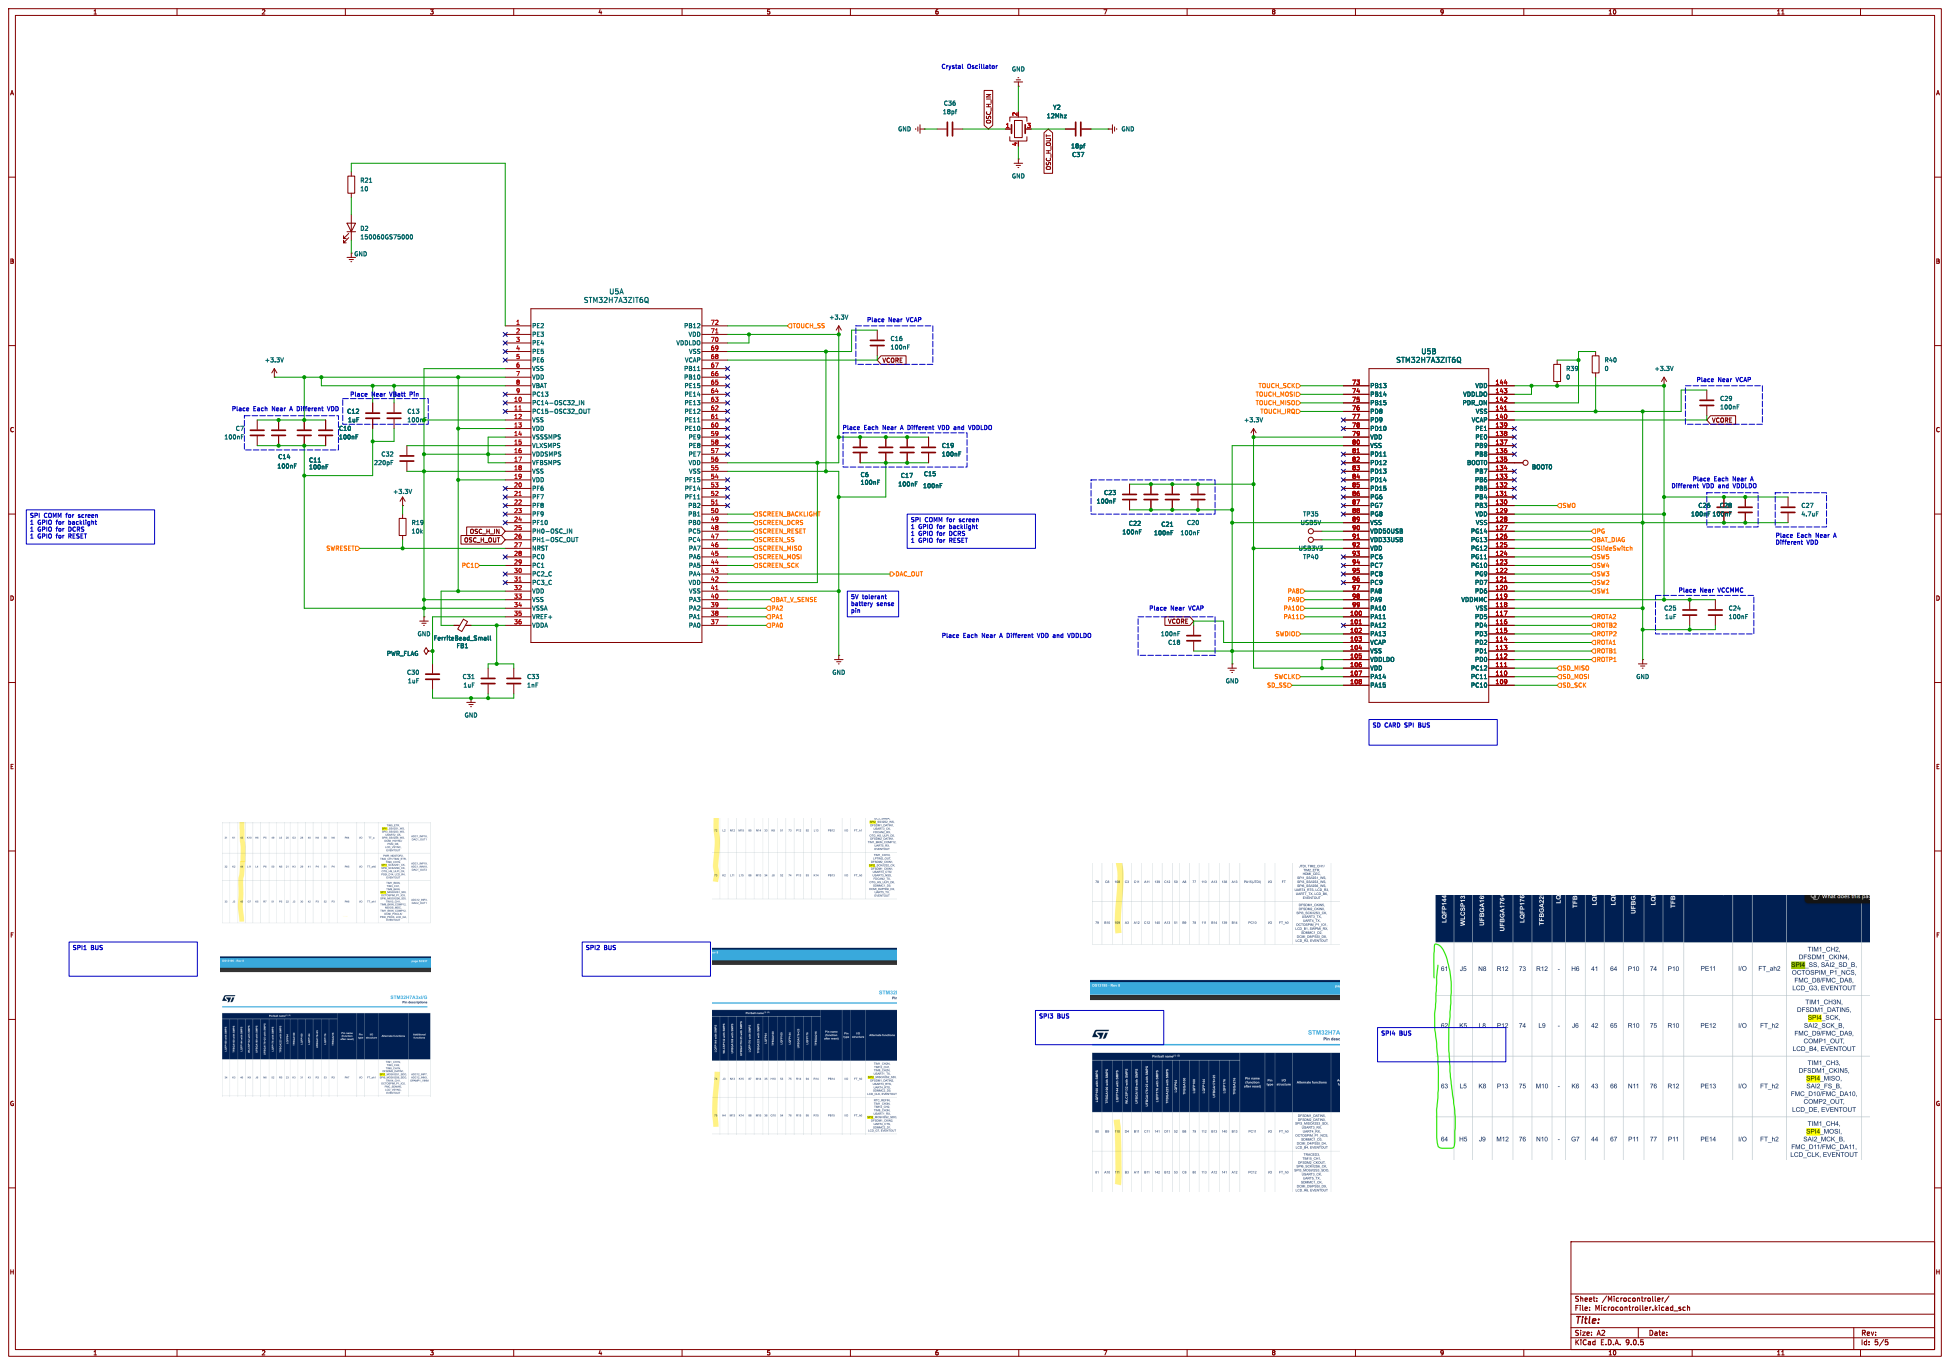
[picture p30: page 5]

SPI COMM for screen
1 GPIO for backlight 1 GPIO for DCRS
