CullenSharp/Etch-A-Tune/docs/ECE 411 Team 7 Design Review Notes.pdf

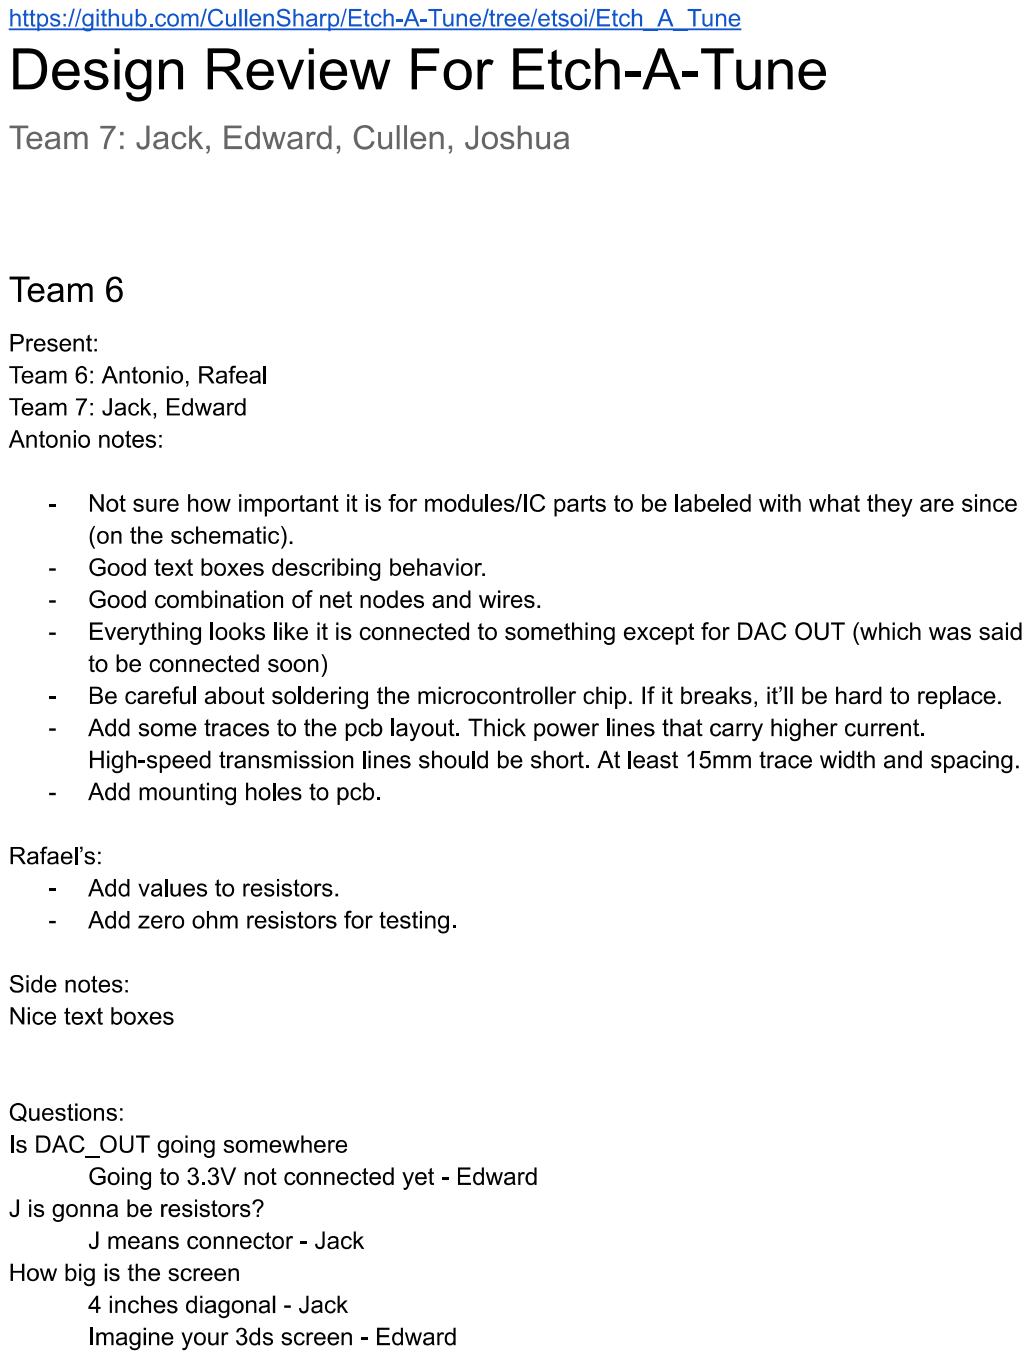
[picture p31: page 1]

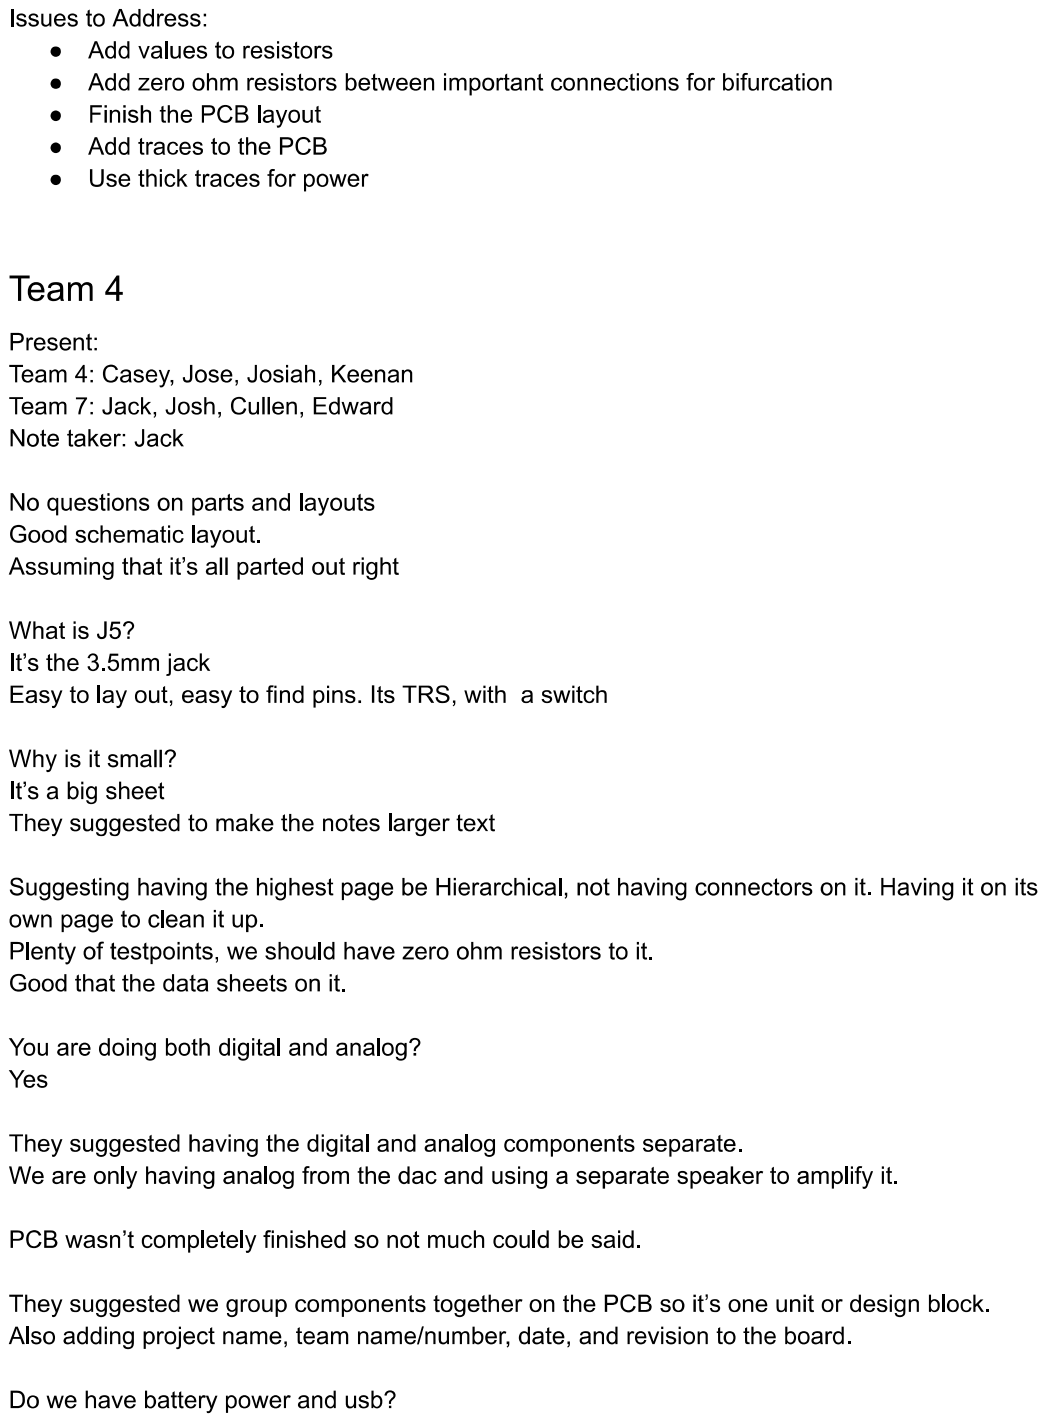
[picture p32: page 2]

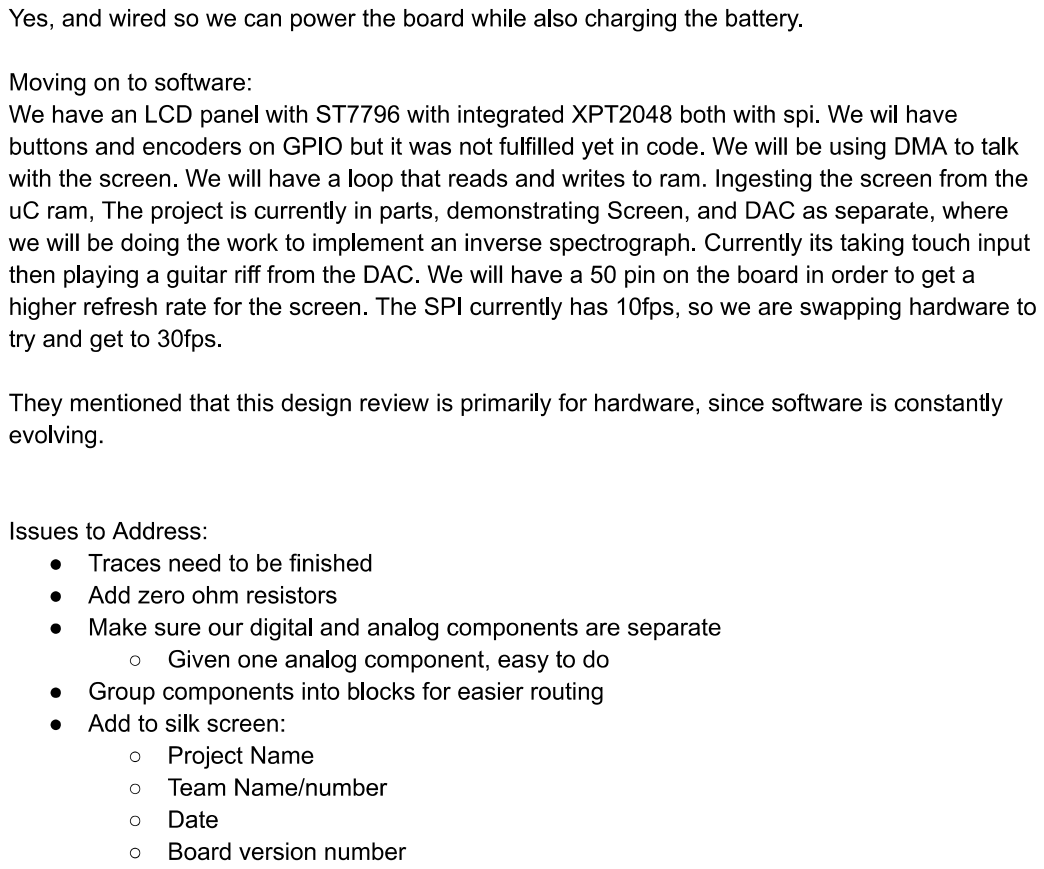
[picture p33: page 3]
