CullenSharp/Etch-A-Tune/docs/ECE 411 Team 7 Make a Decision.pdf

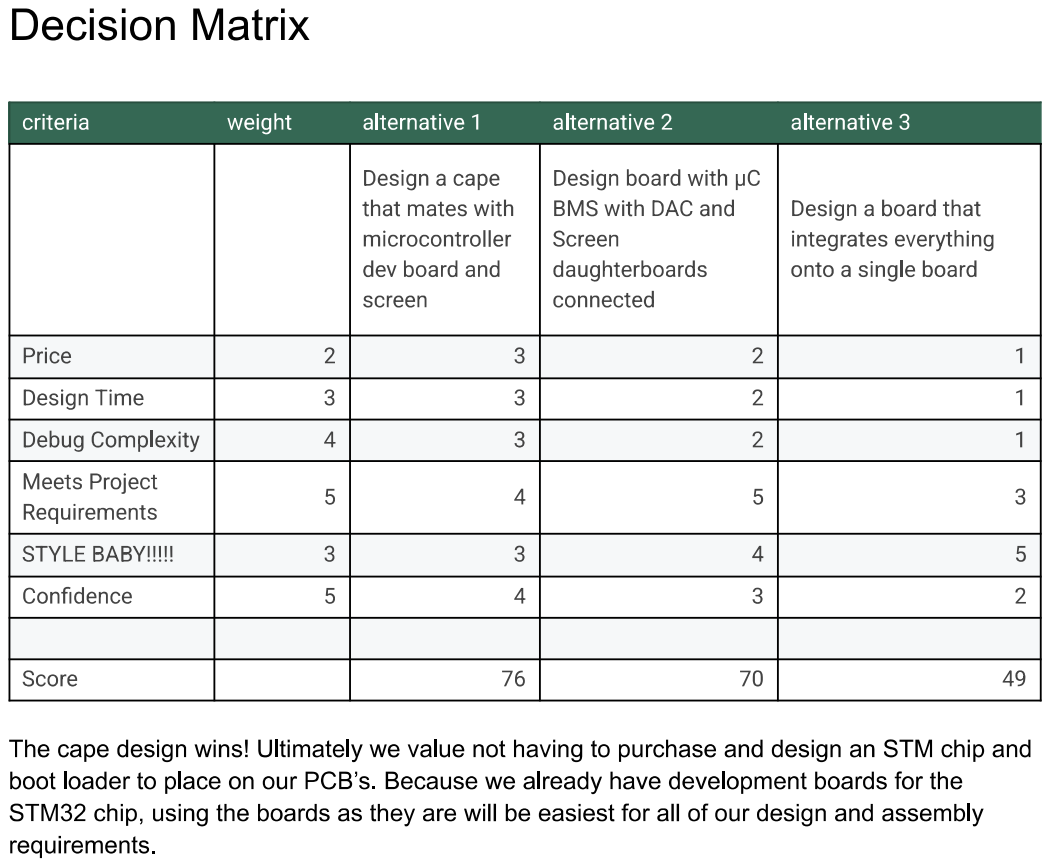
[picture p34: page 1]

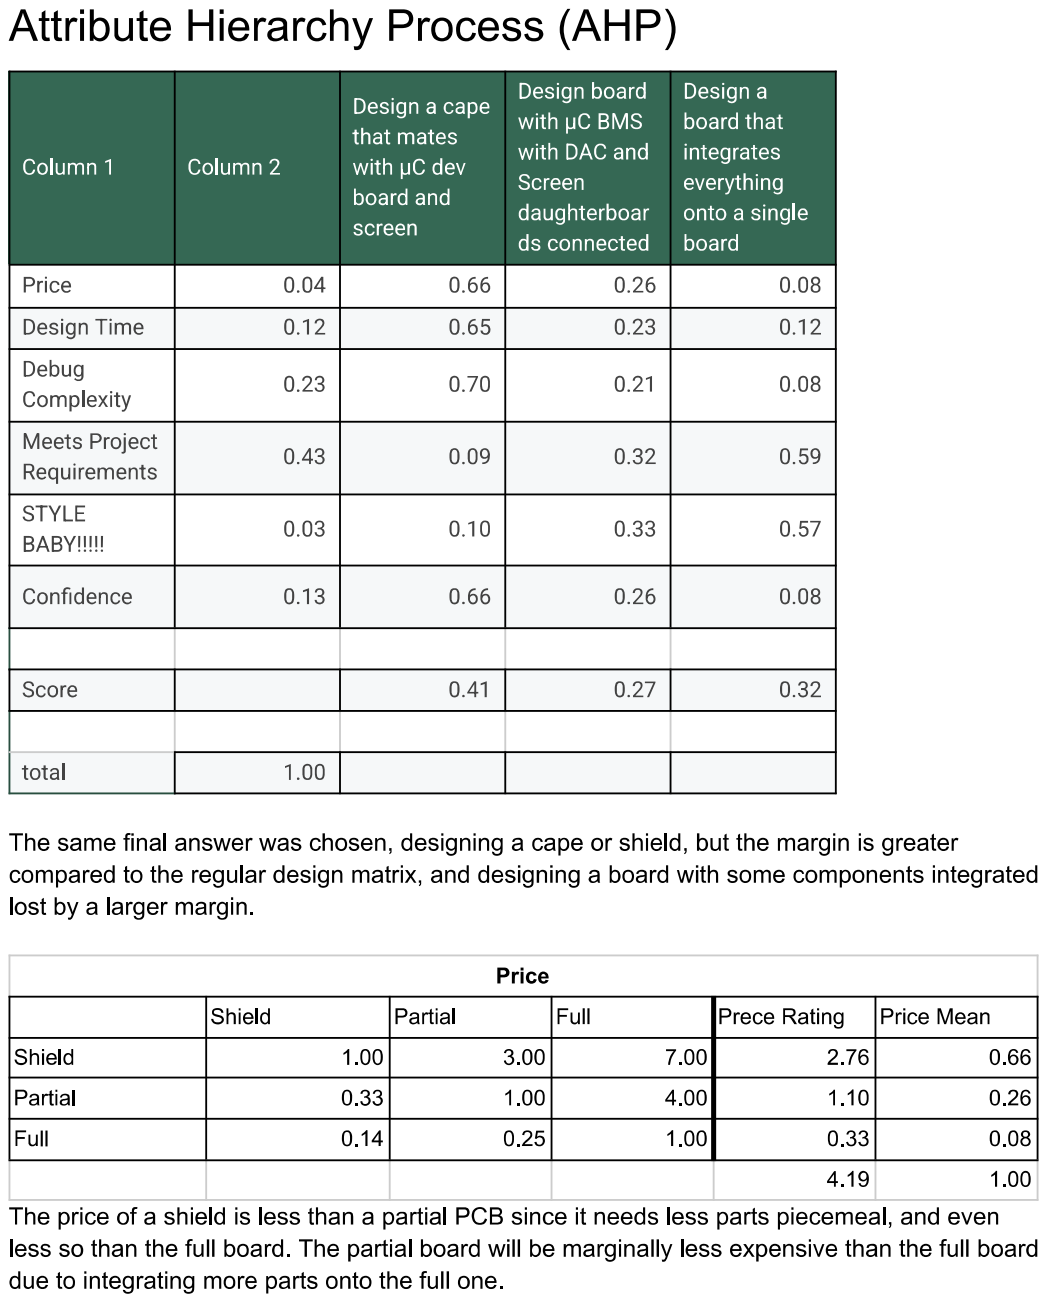
[picture p35: page 2]

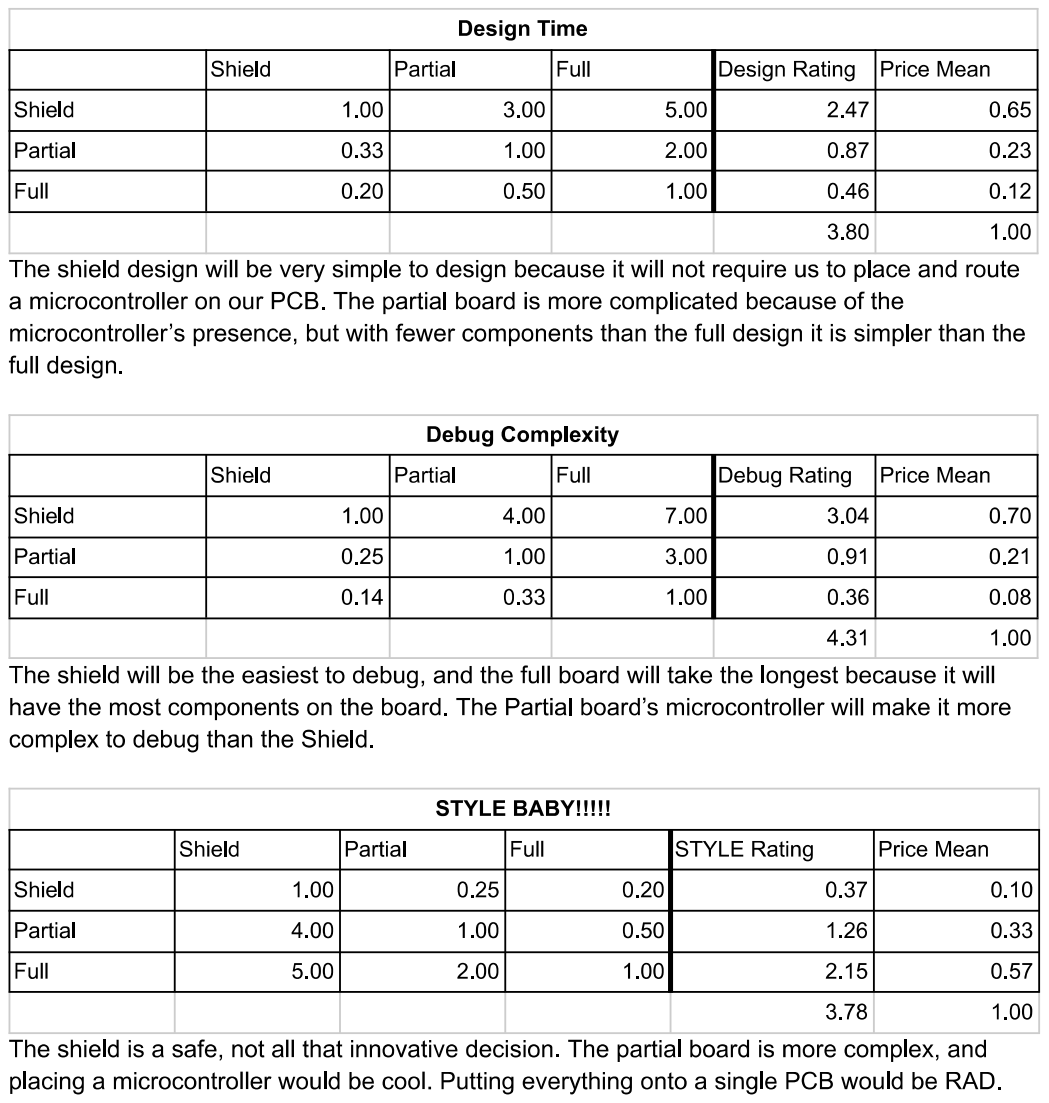
[picture p36: page 3]

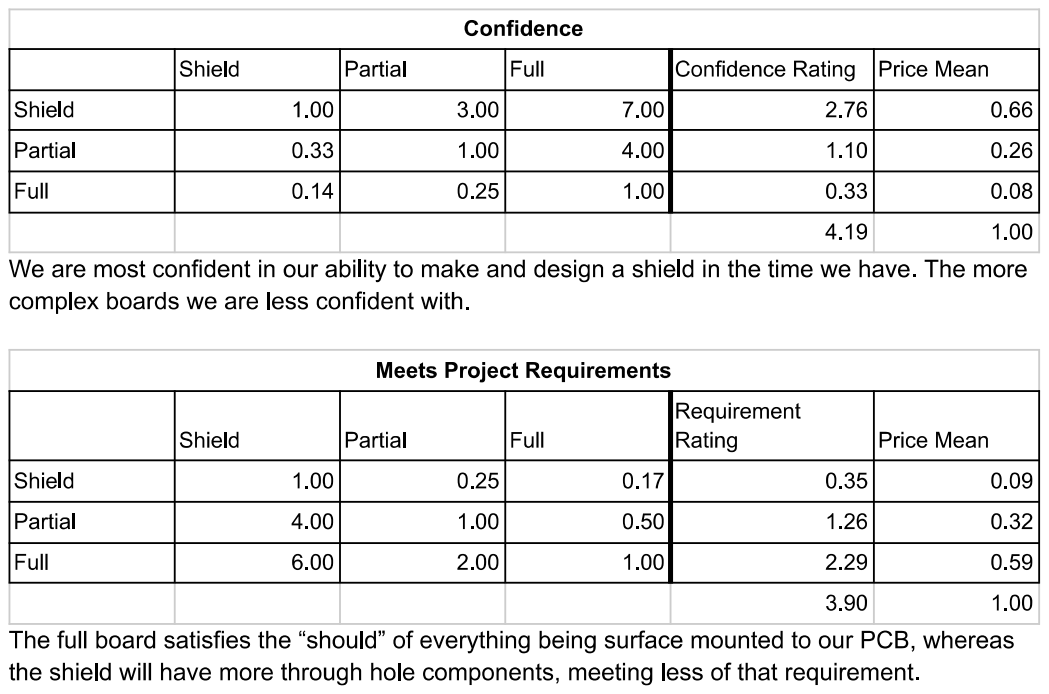
[picture p37: page 4]
