CullenSharp/Etch-A-Tune/Etch_A_Tune/Team7_HW_WK08_FINAL_CAD/Etch_A_Tune-B_Mask.pdf

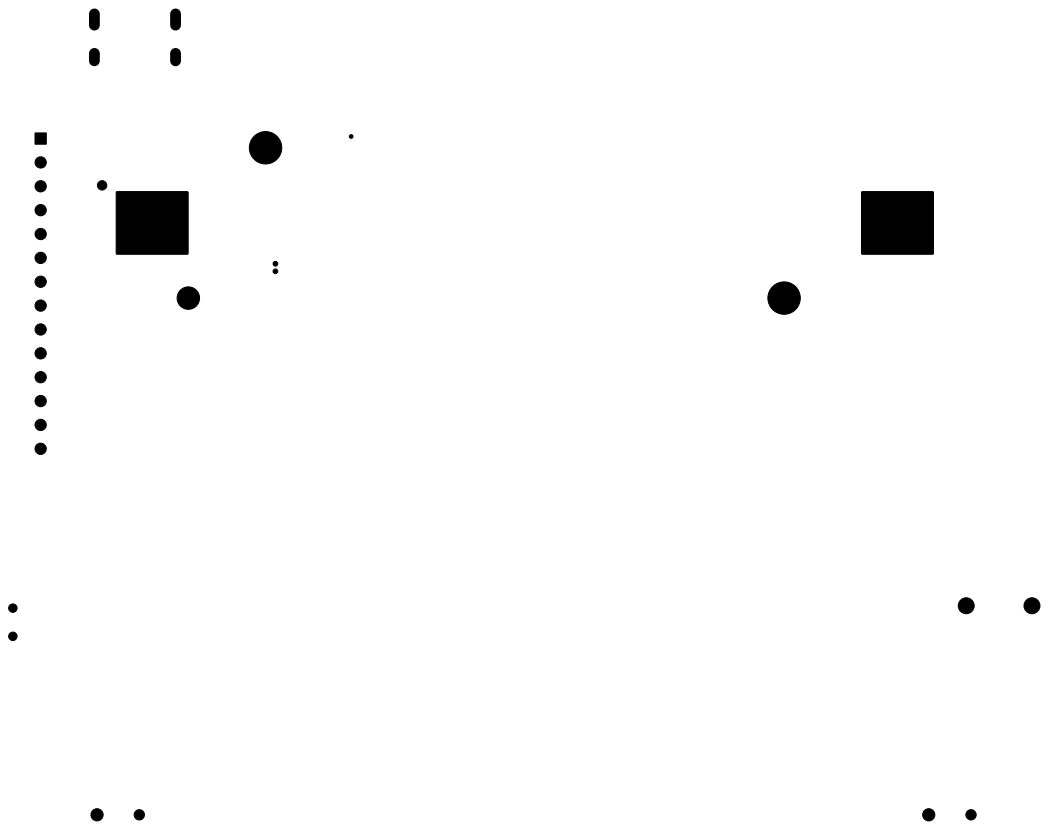
[picture p39: page 1]
