CullenSharp/Etch-A-Tune/Etch_A_Tune/Team7_HW_WK08_FINAL_CAD/Etch_A_Tune-Edge_Cuts.pdf

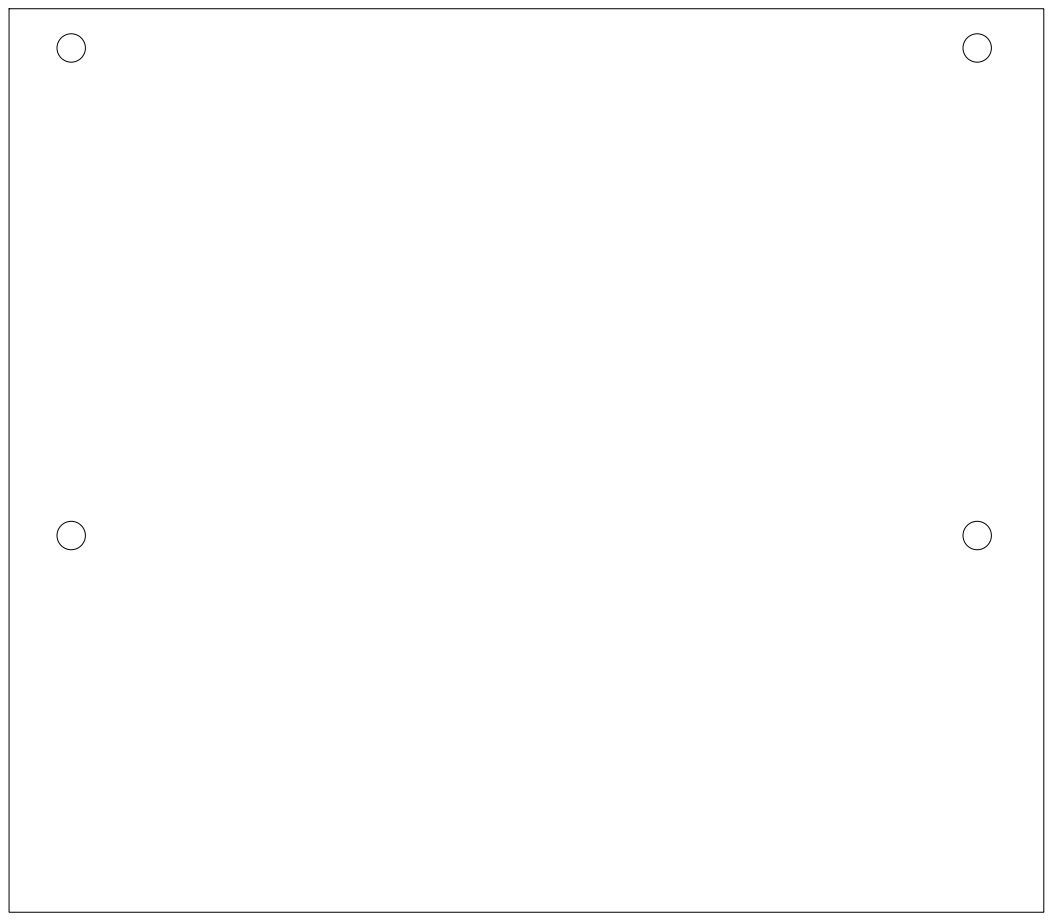
[picture p41: page 1]
