CullenSharp/Etch-A-Tune/Etch_A_Tune/Team7_HW_WK08_FINAL_CAD/Etch_A_Tune-F_Cu.pdf

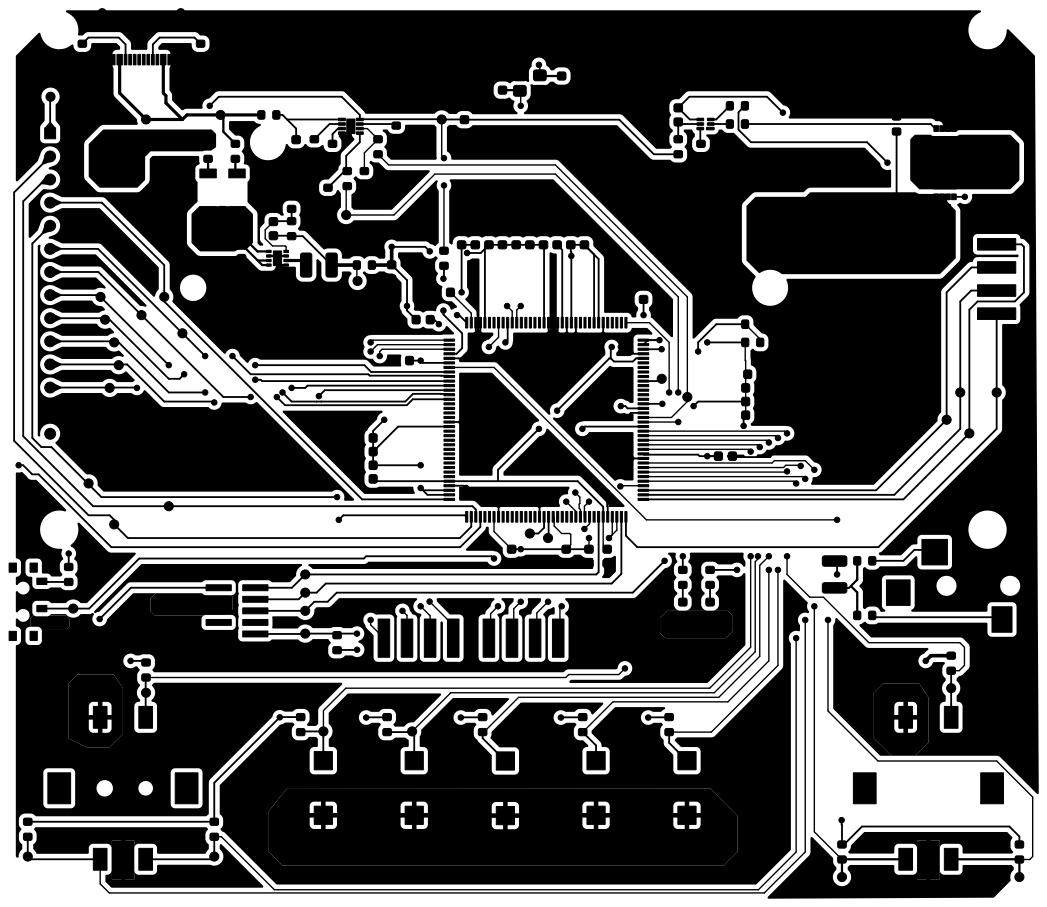
[picture p42: page 1]
