CullenSharp/Etch-A-Tune/Etch_A_Tune/Team7_HW_WK08_FINAL_CAD/Etch_A_Tune-F_Silkscreen.pdf

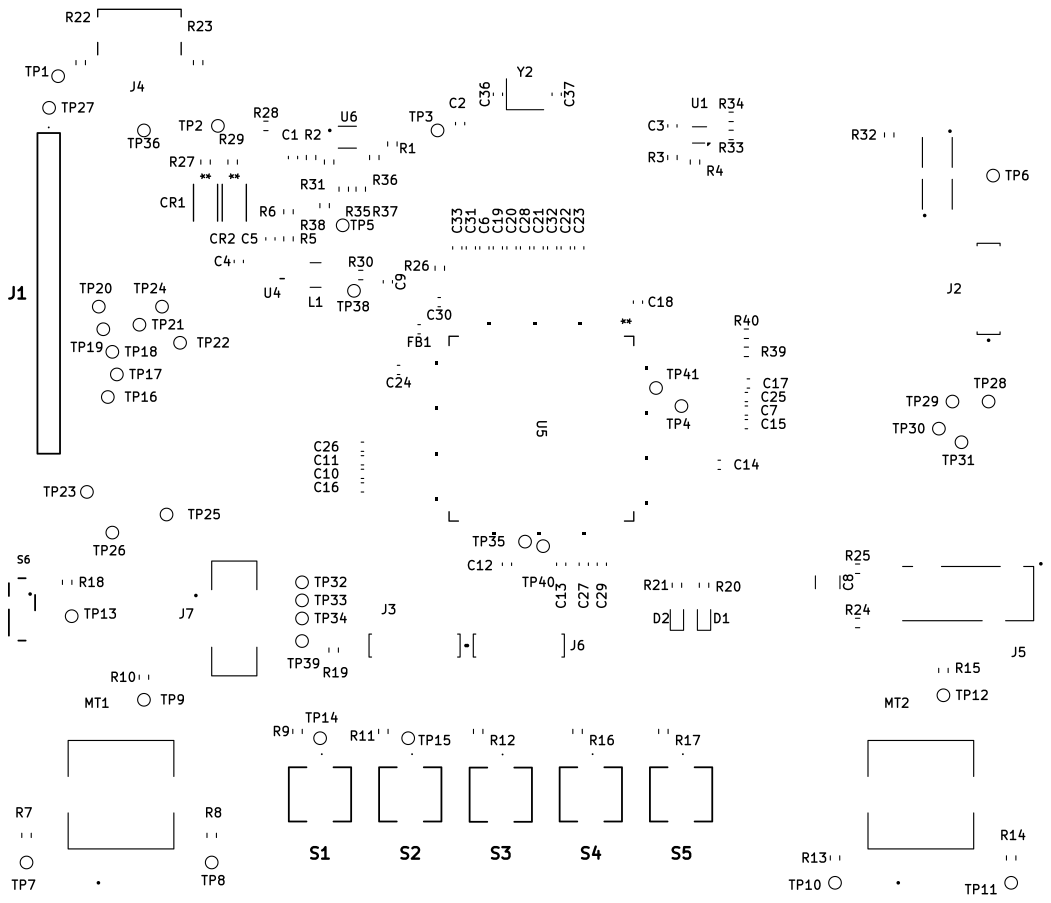
[picture p45: page 1]
