CullenSharp/Etch-A-Tune/docs/ECE 411 Team 7 Functional Decomposition.pdf

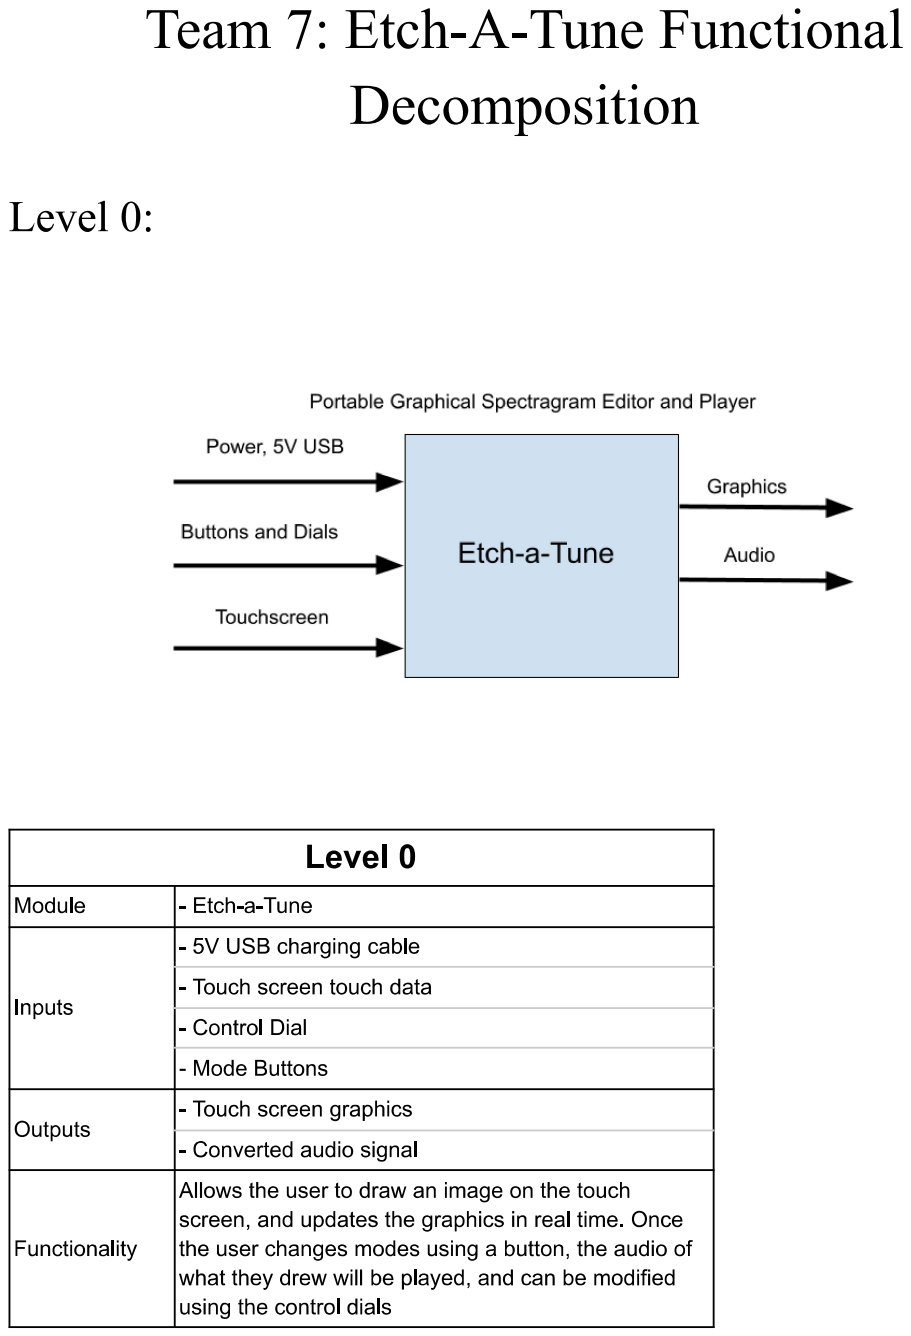
[picture p46: page 1]

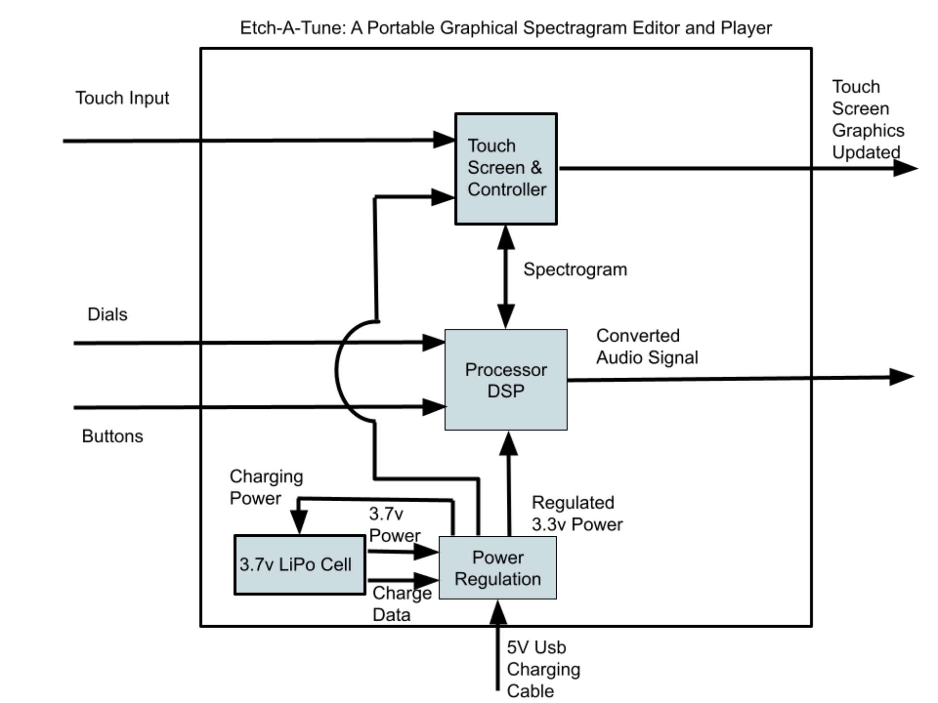
[picture p47: figure]
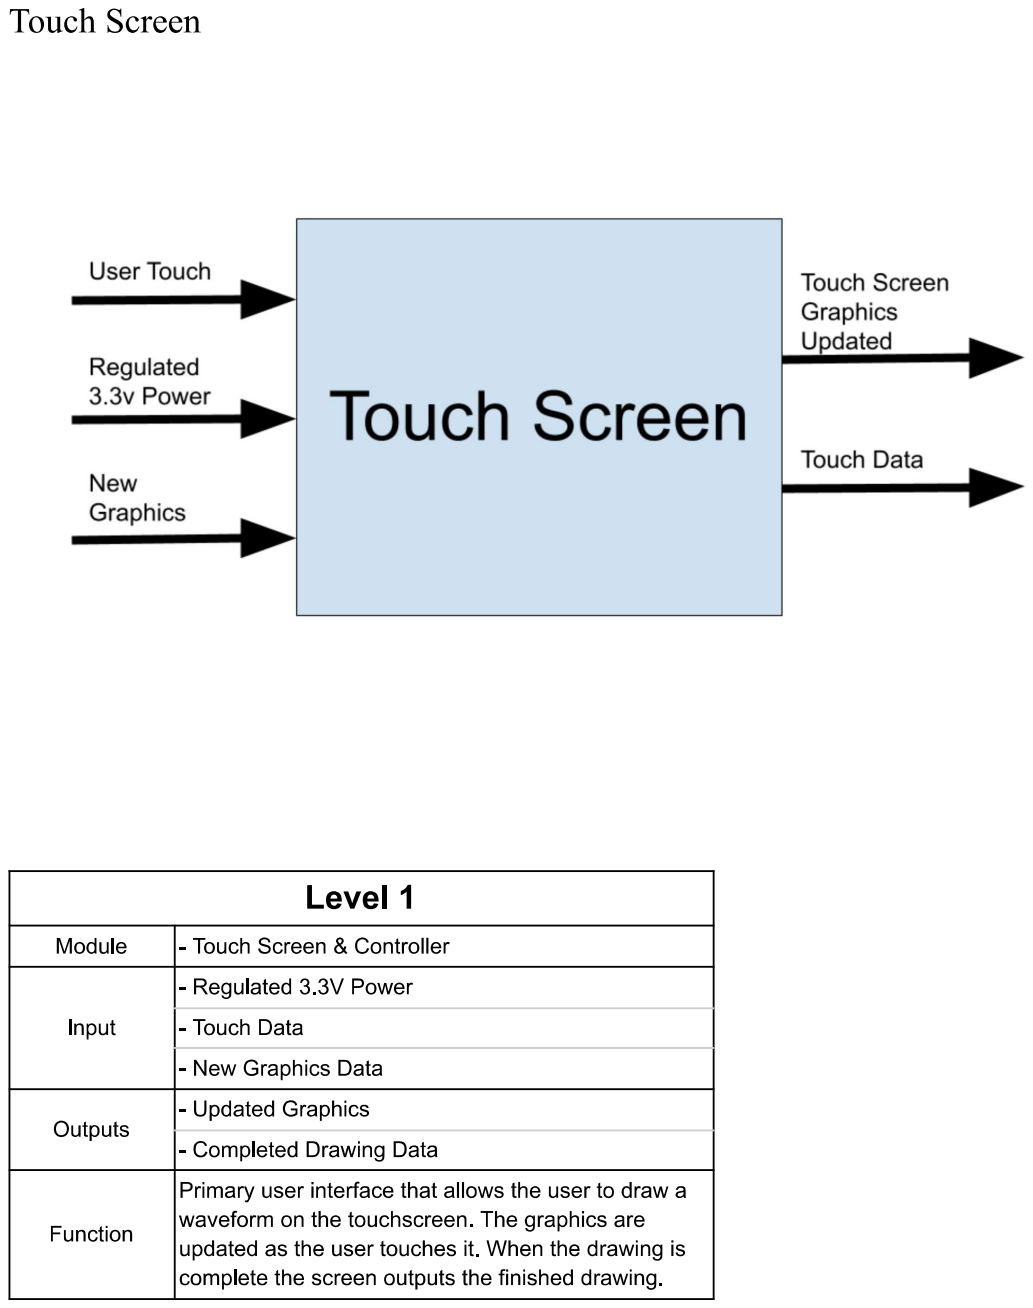
[picture p48: page 3]

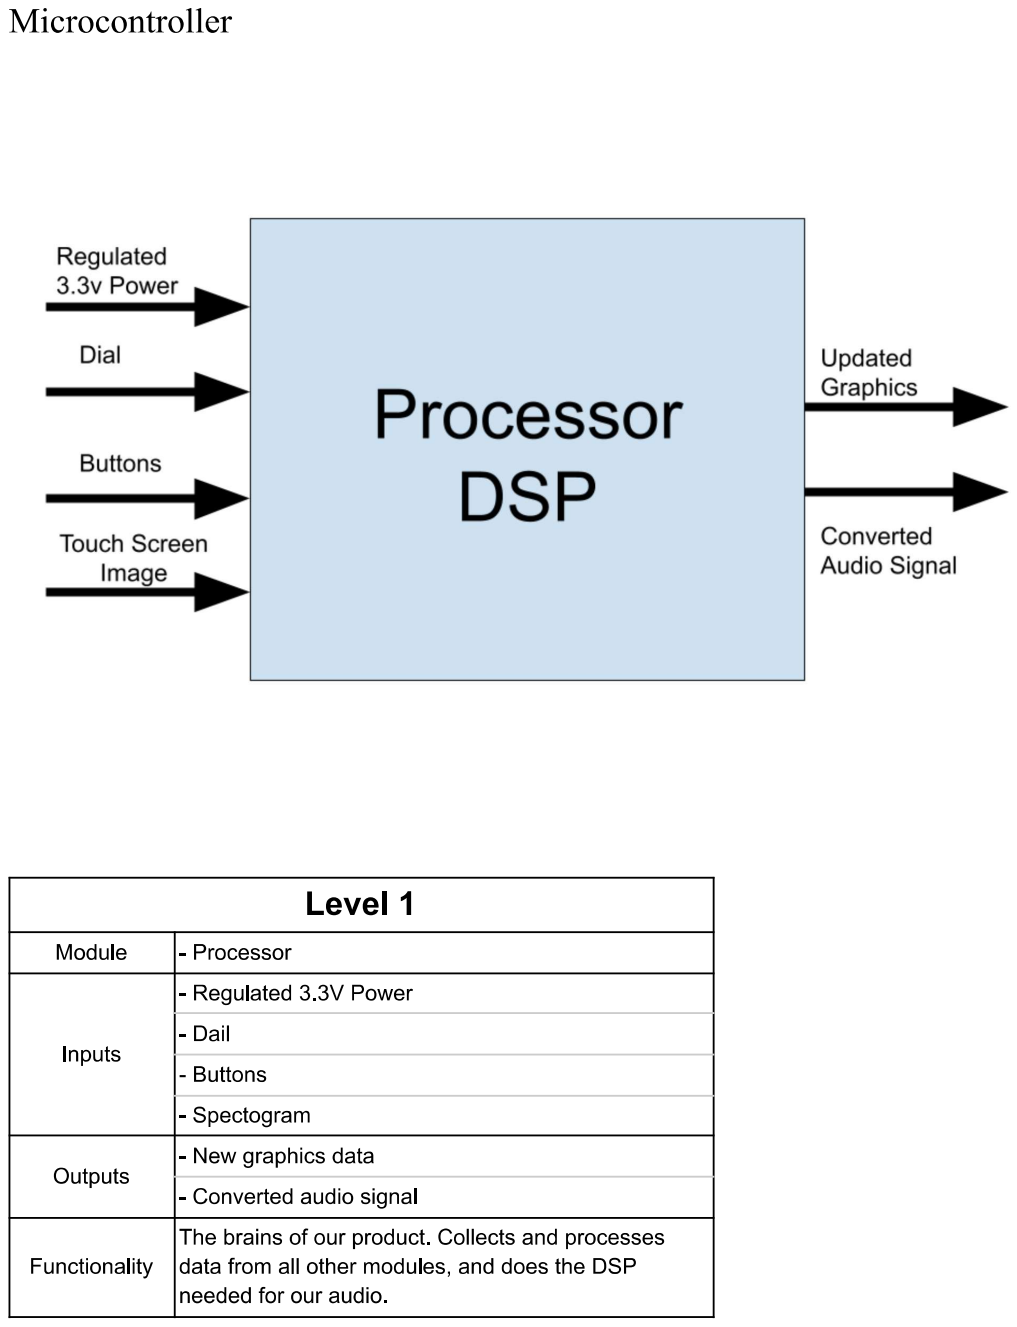
[picture p49: page 4]

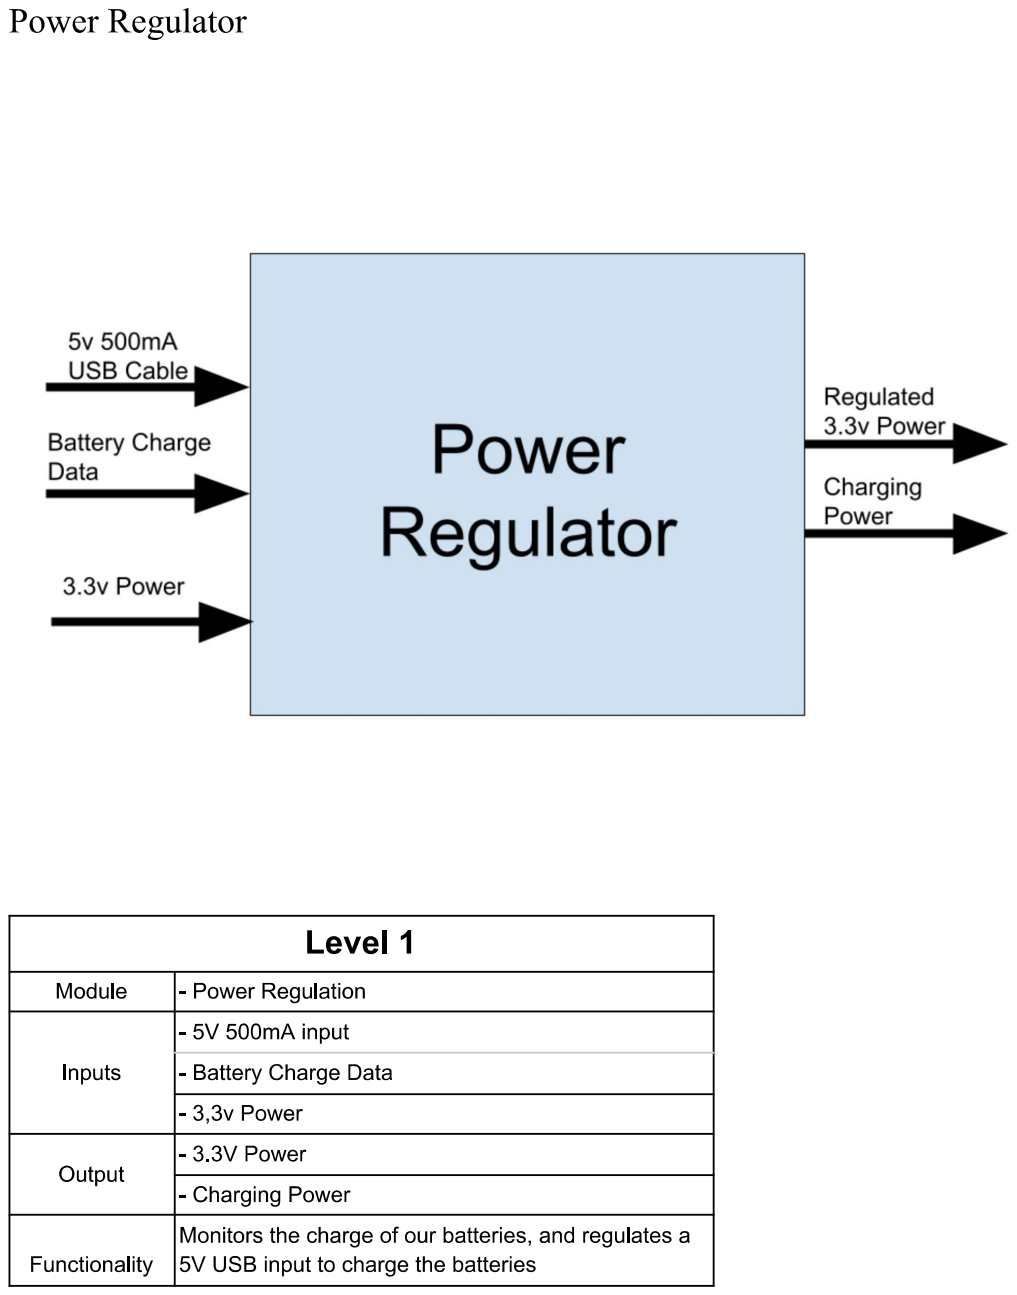
[picture p50: page 5]

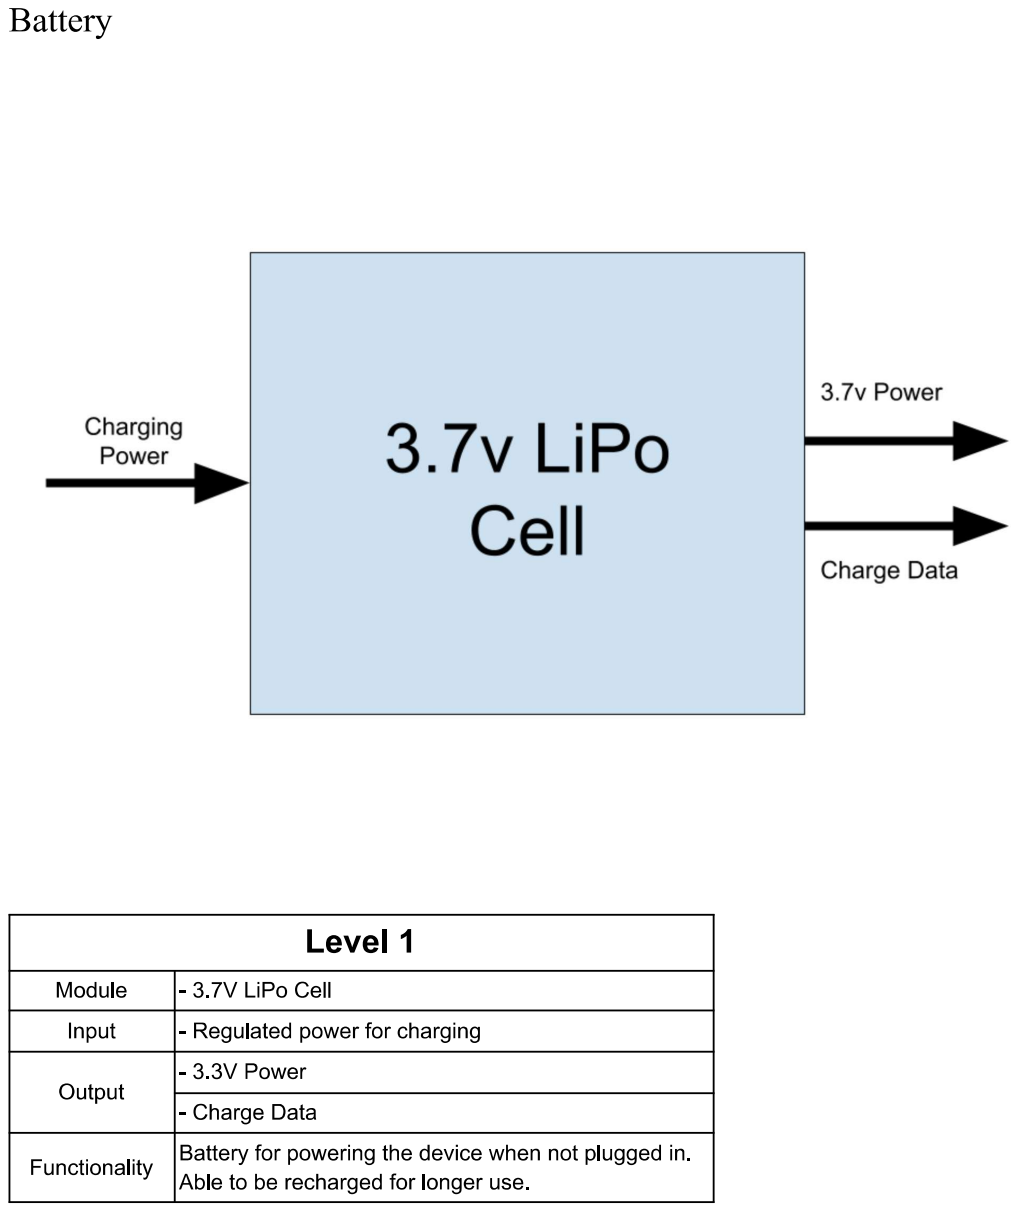
[picture p51: page 6]
