CullenSharp/Etch-A-Tune/docs/ECE 411 Team 7 Project Ideas Assignment.pdf

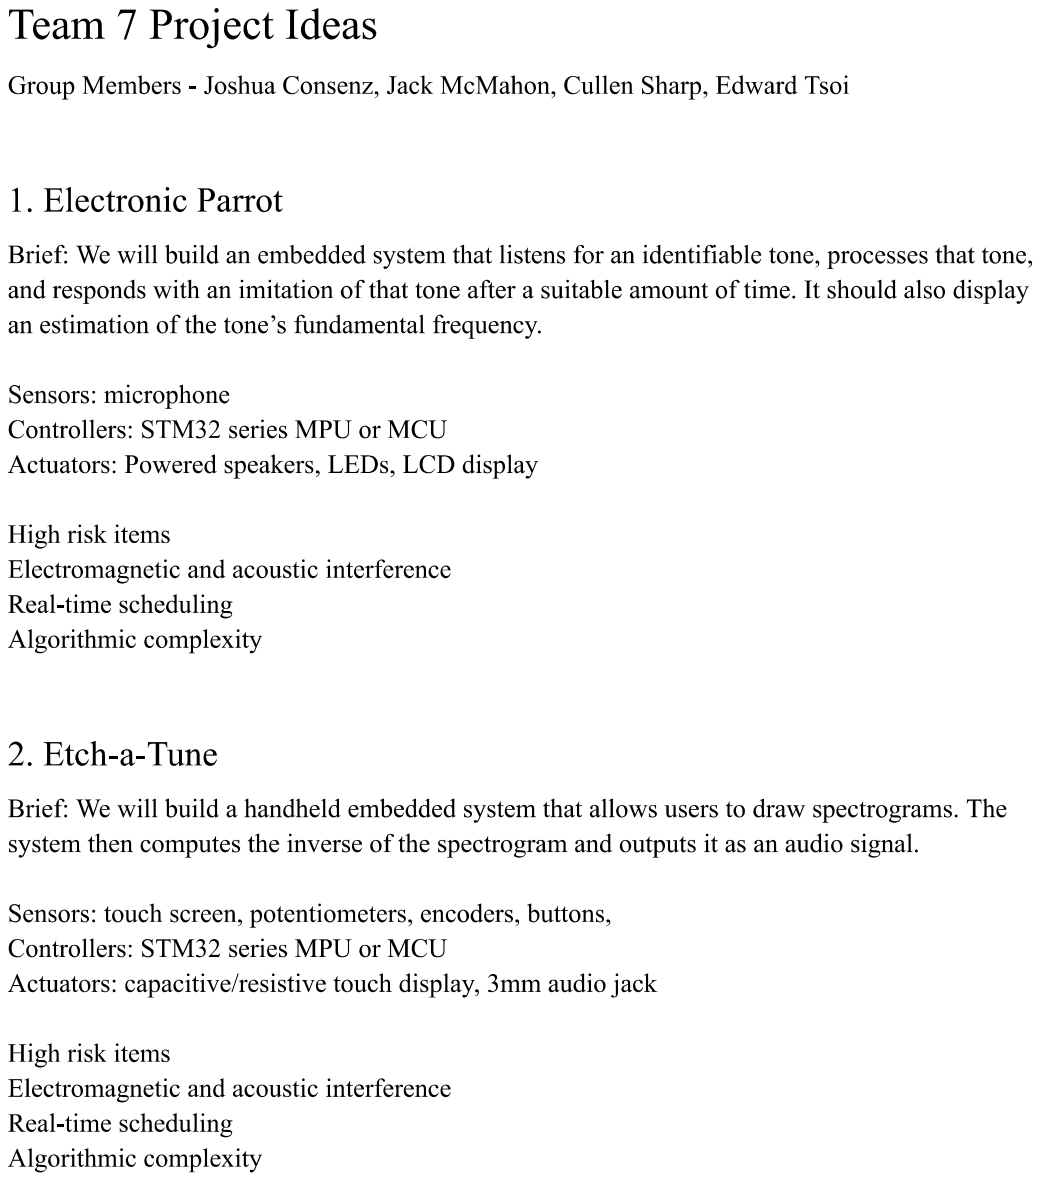
[picture p52: page 1]

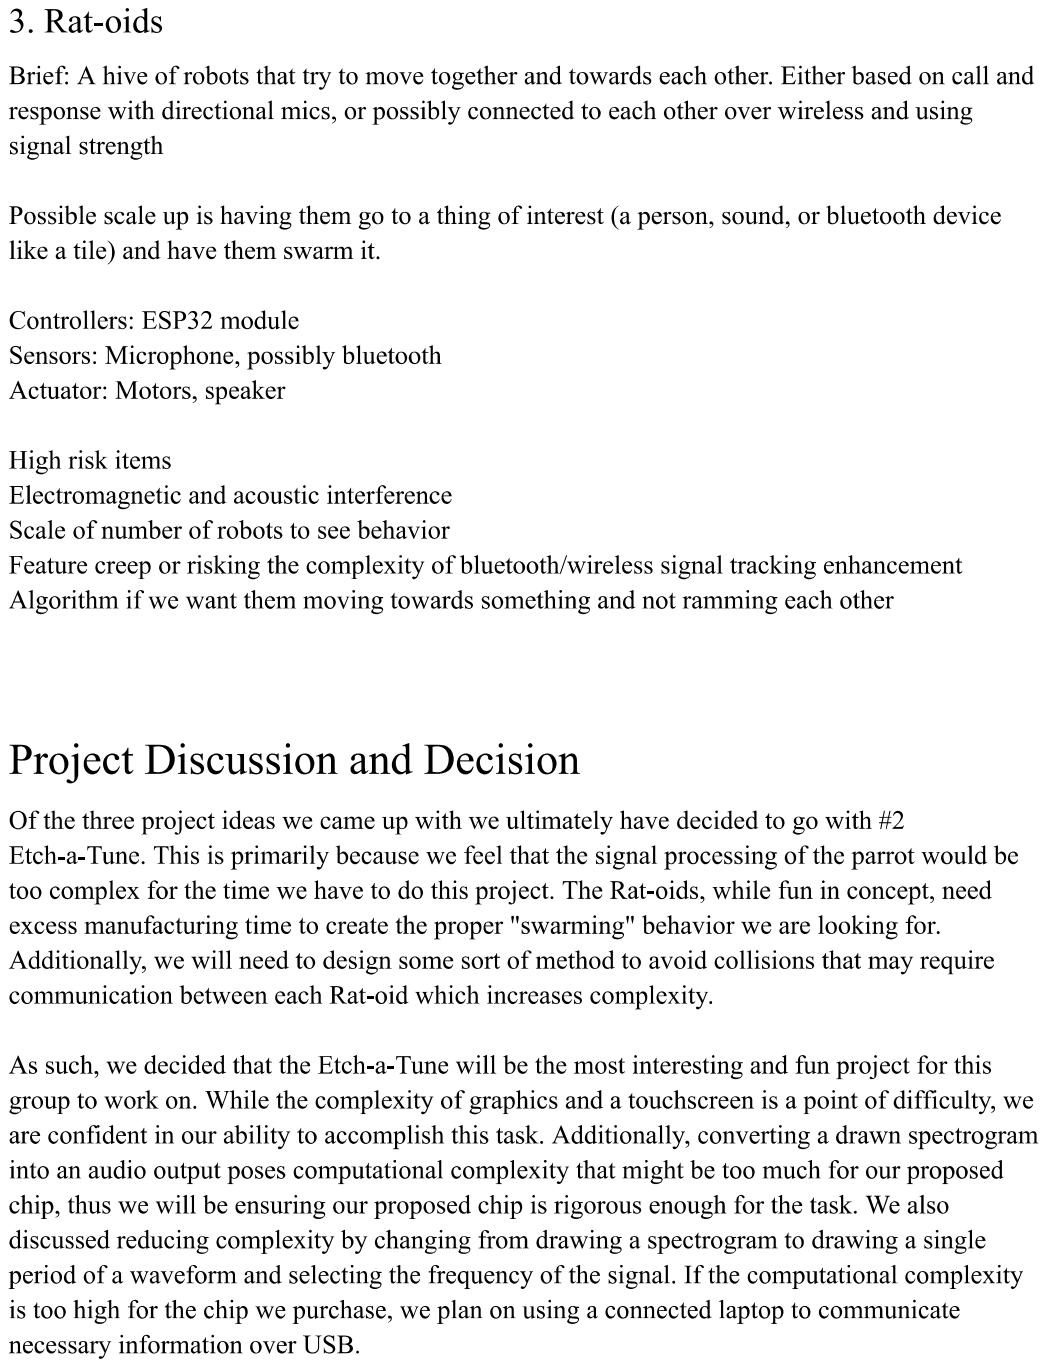
[picture p53: page 2]
