CullenSharp/Etch-A-Tune/docs/ECE 411 Team 7 PDS.pdf

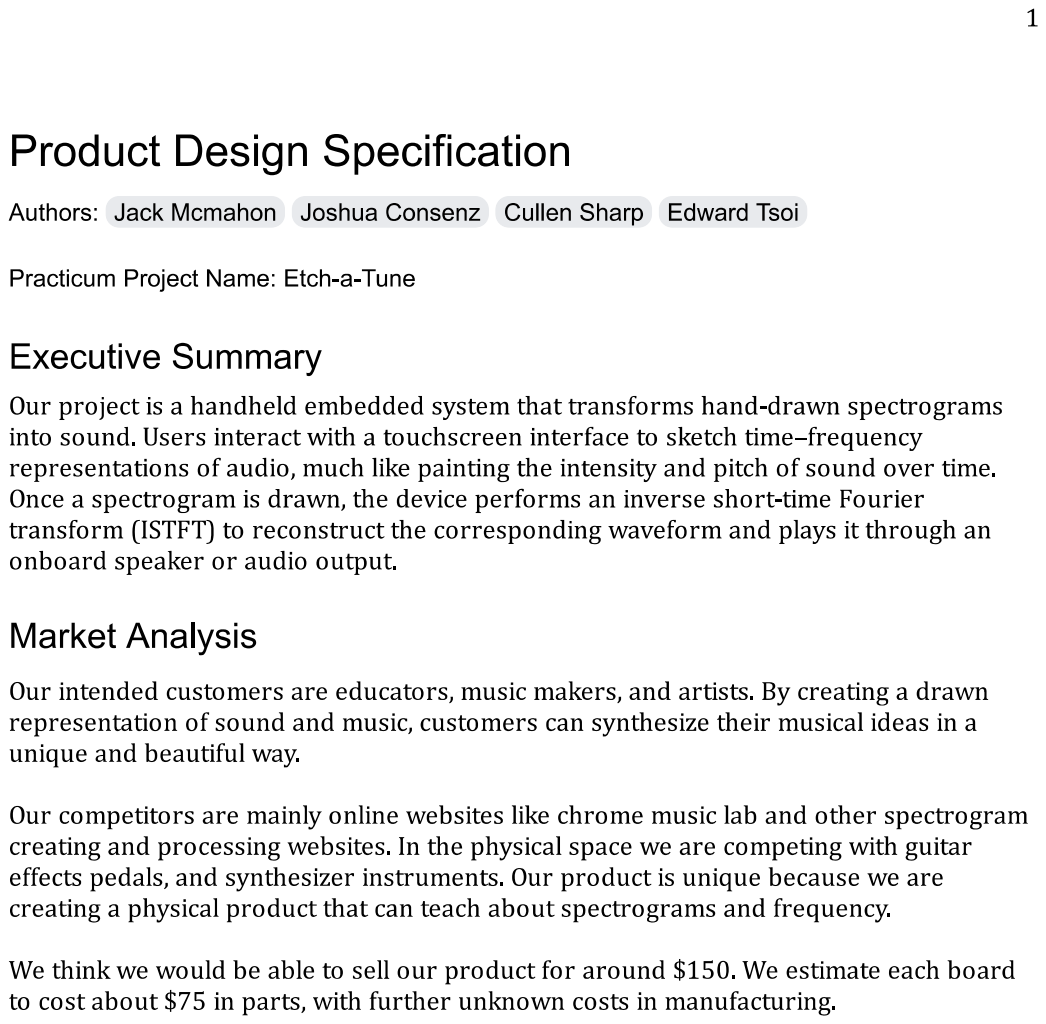
[picture p54: page 1]

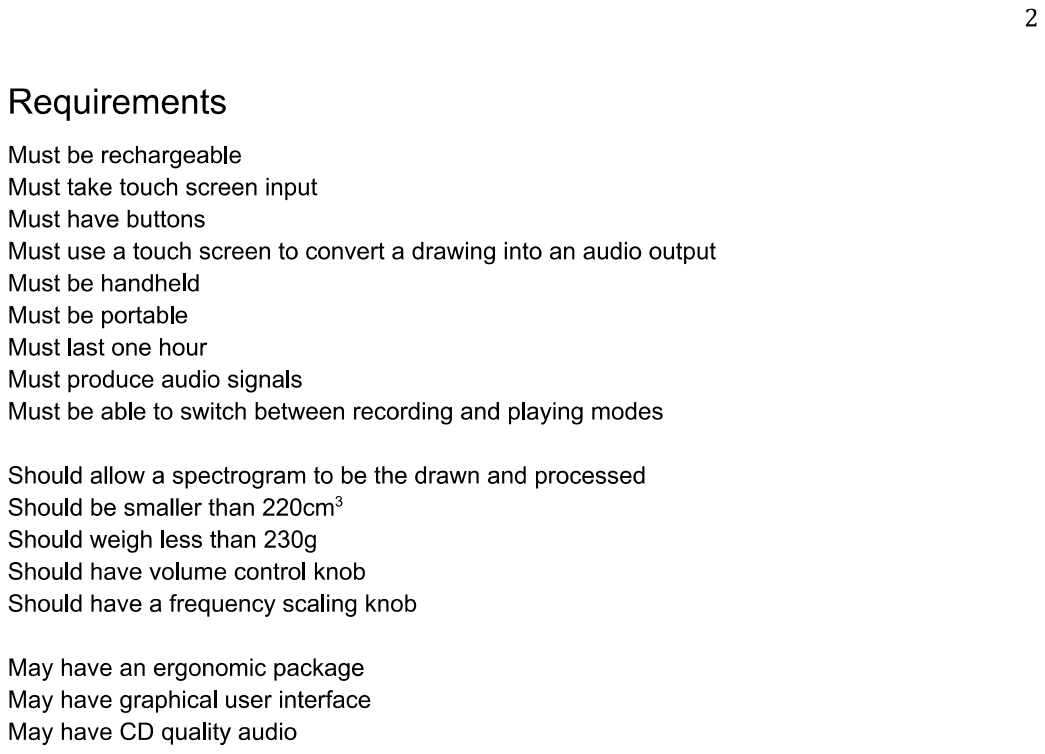
[picture p55: page 2]

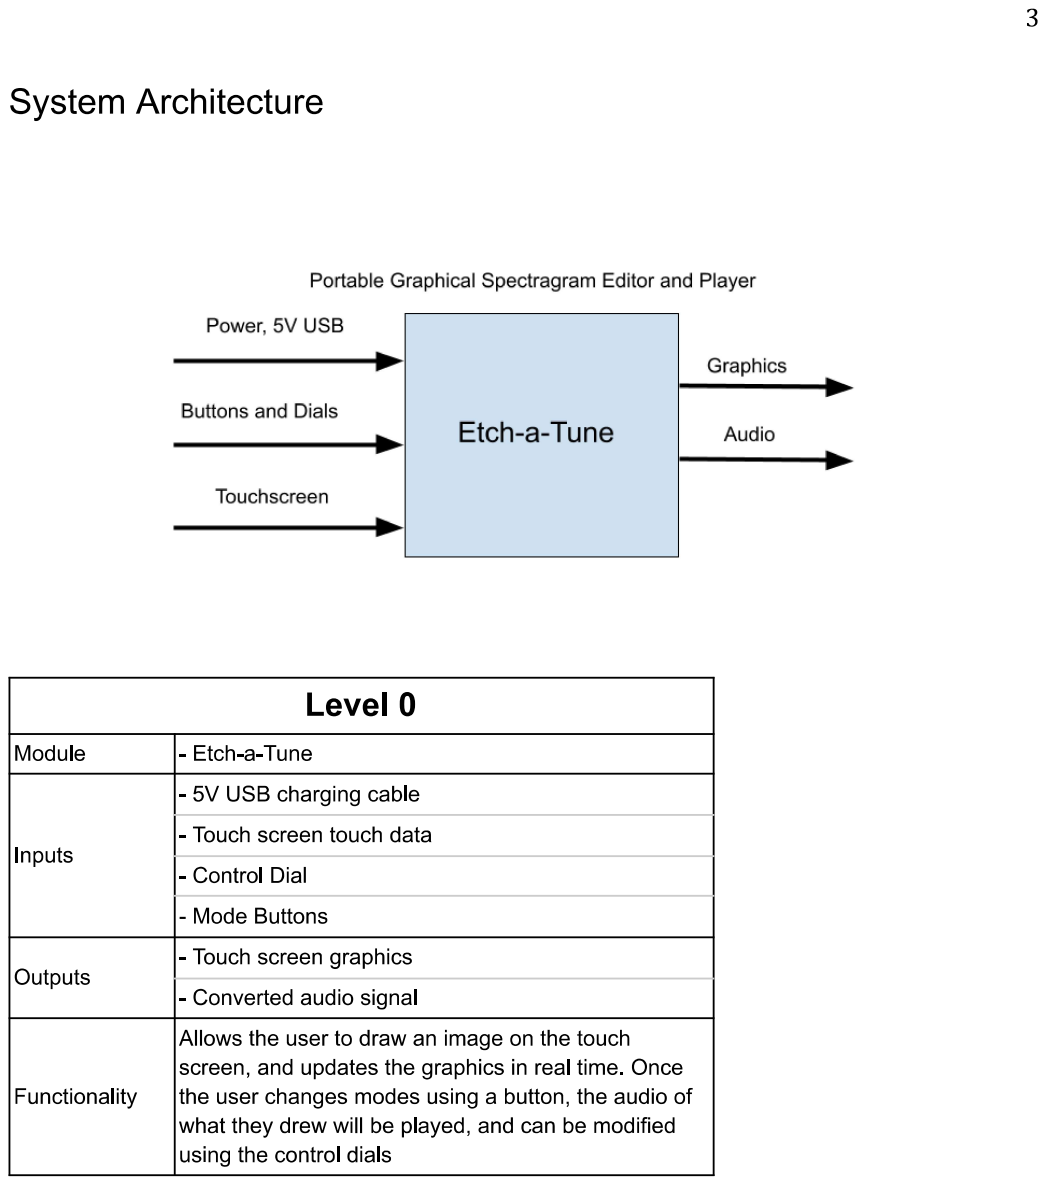
[picture p56: page 3]

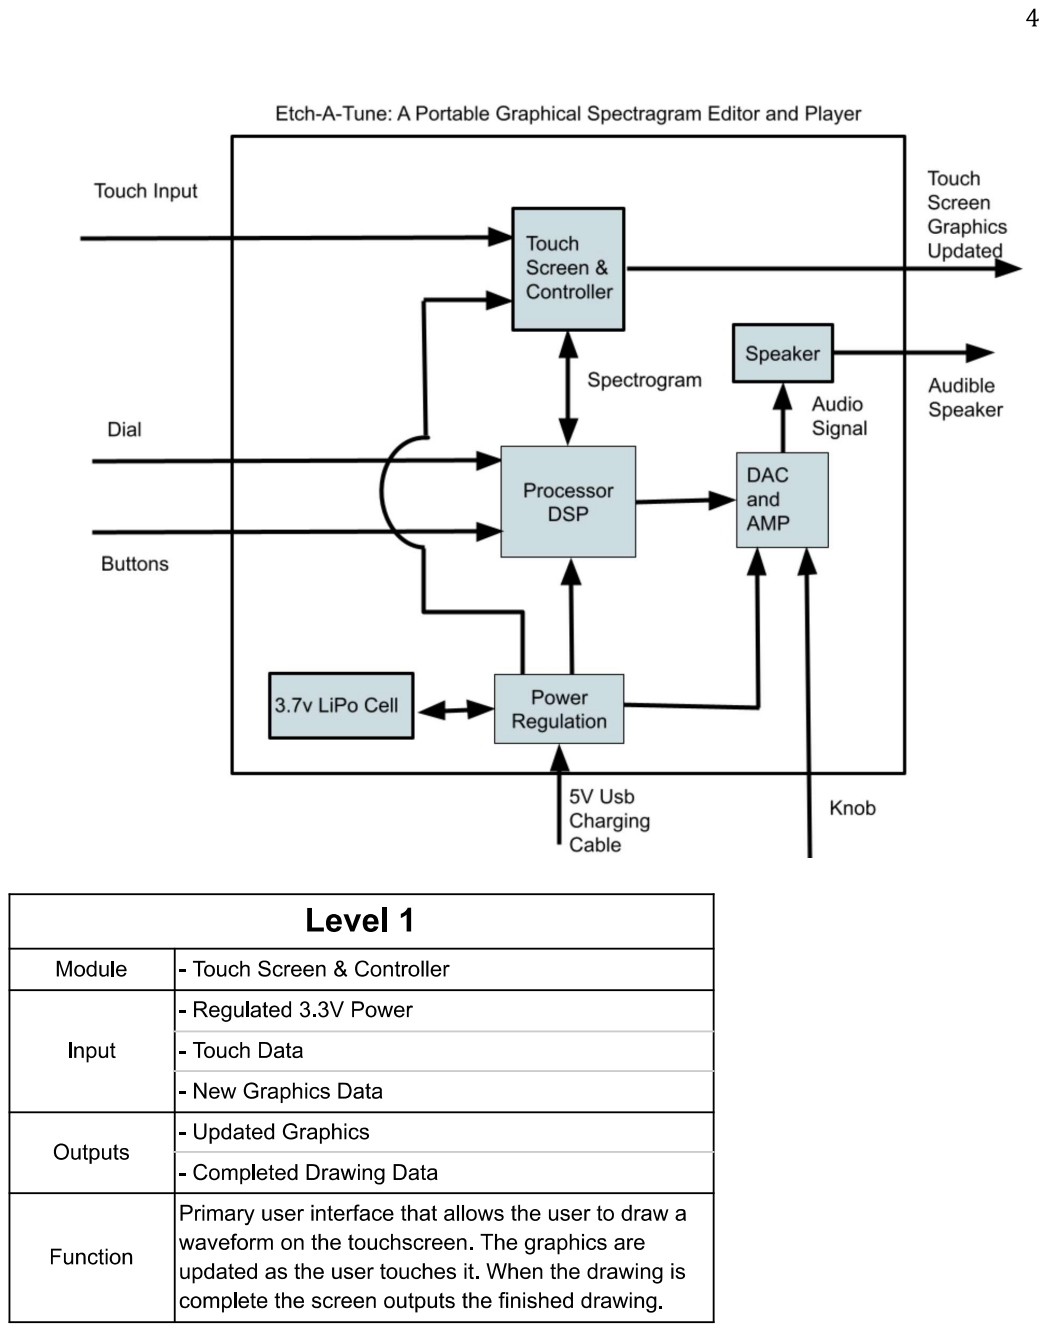
[picture p57: page 4]

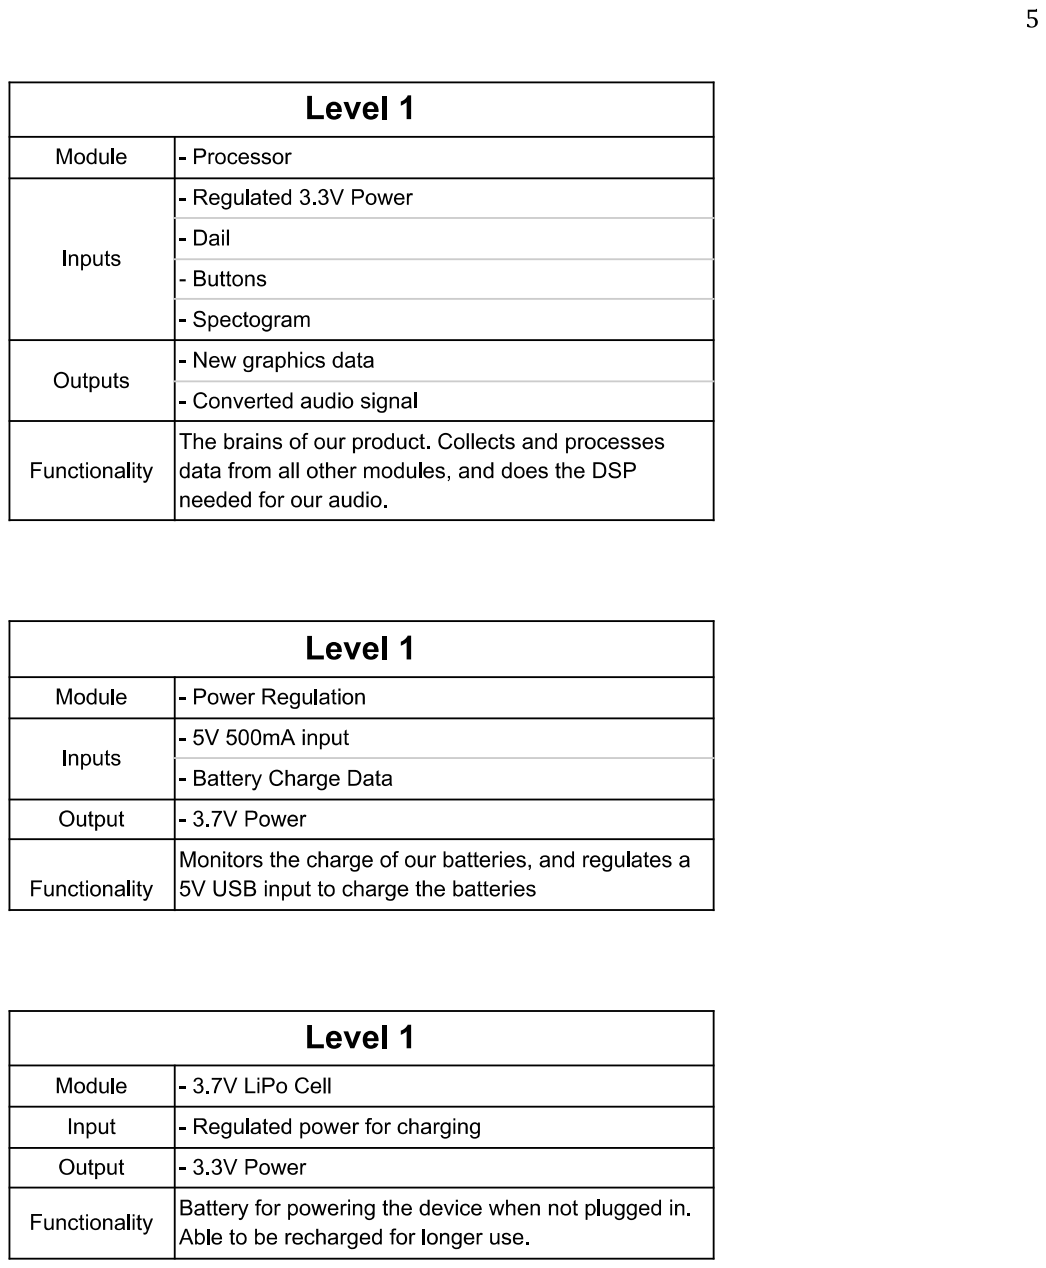
[picture p58: page 5]

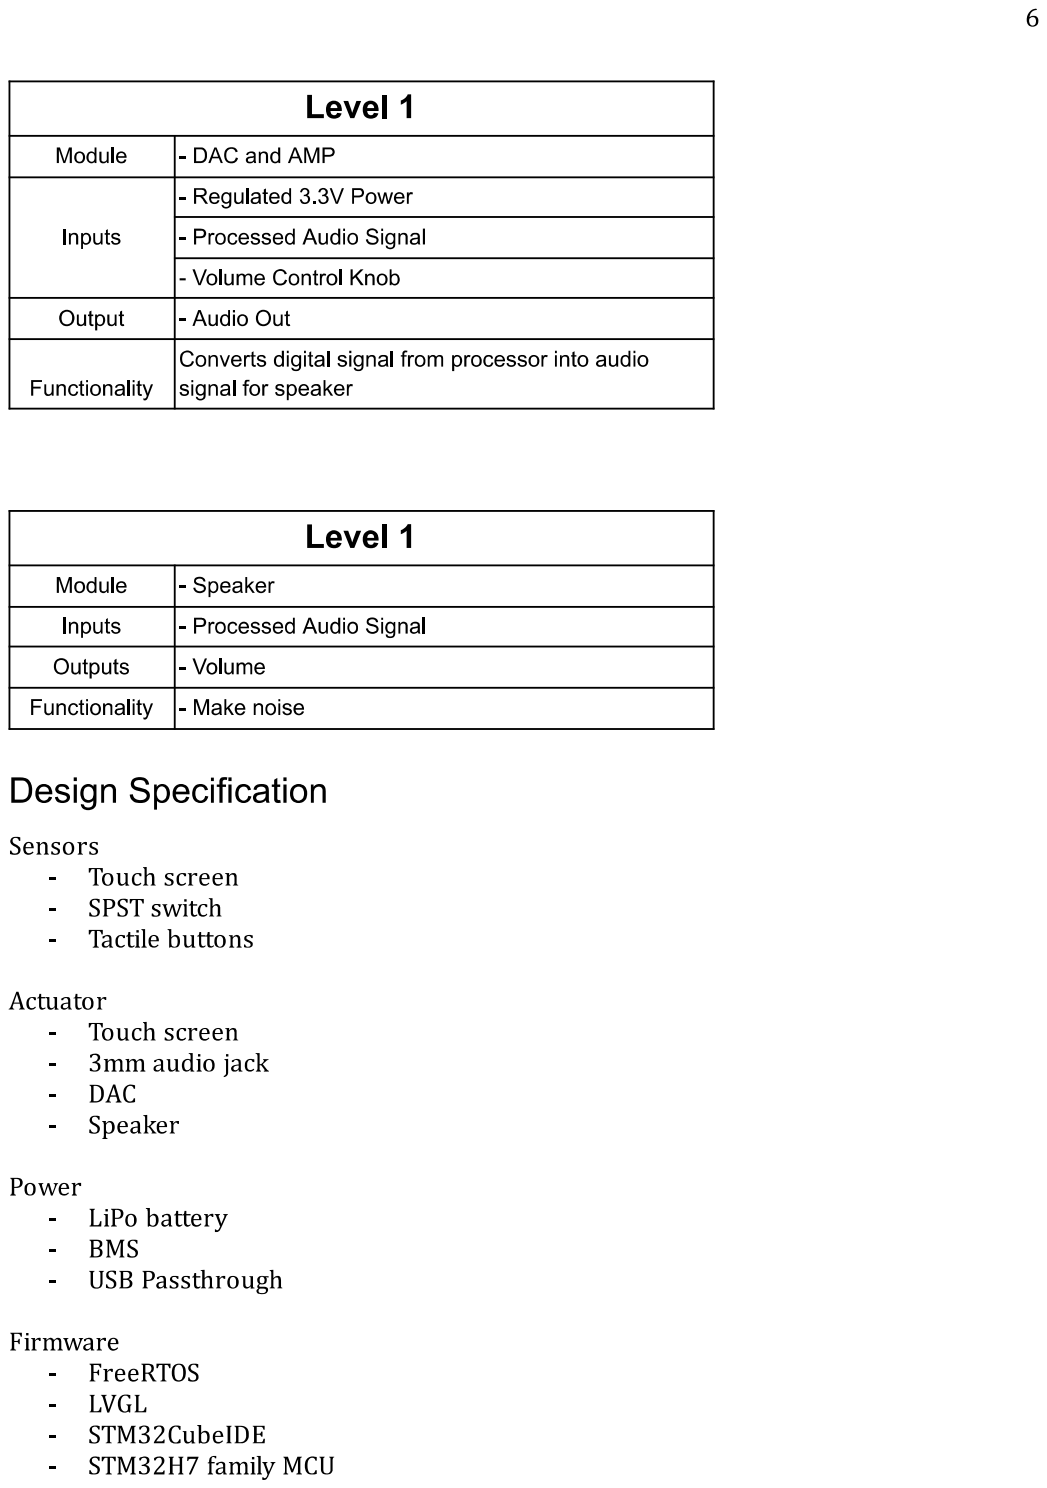
[picture p59: page 6]
