CullenSharp/Etch-A-Tune/Etch_A_Tune/Etch_a_Sketch_Schematic_V0.2/Etch_A_Tune.pdf

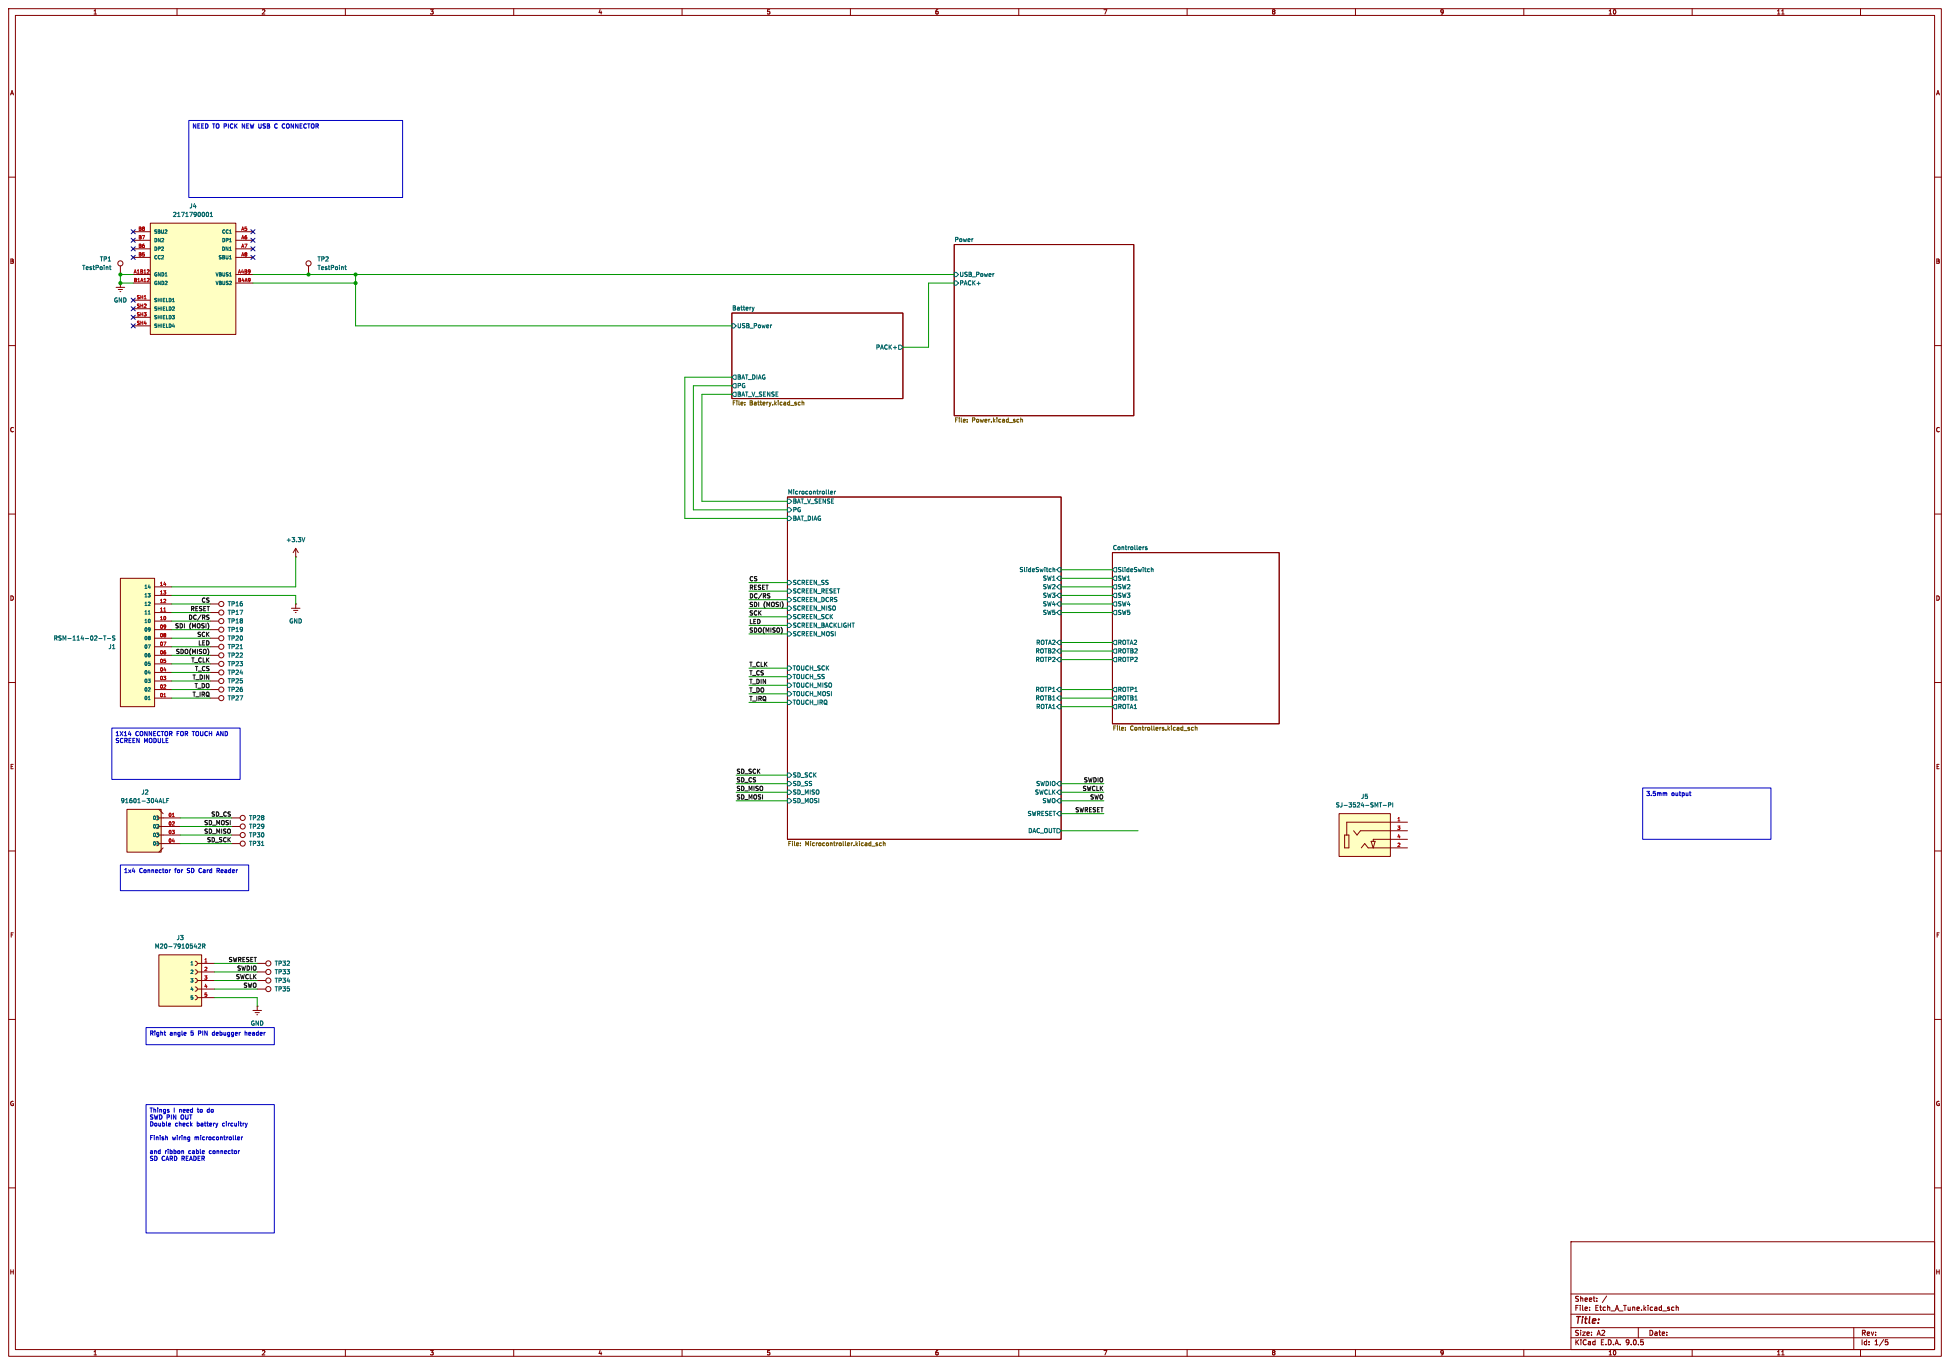
[picture p60: page 1]

NEED TO PICK NEW USB C CONNECTOR

PACK+ USB_Power Power File: Power.kicad_sch

SDI (MOSI) 1X14 CONNECTOR FOR TOUCH AND

SDI (MOSI) DC/RS RESET

2 J5 SJ-3524-SMT-PI GND

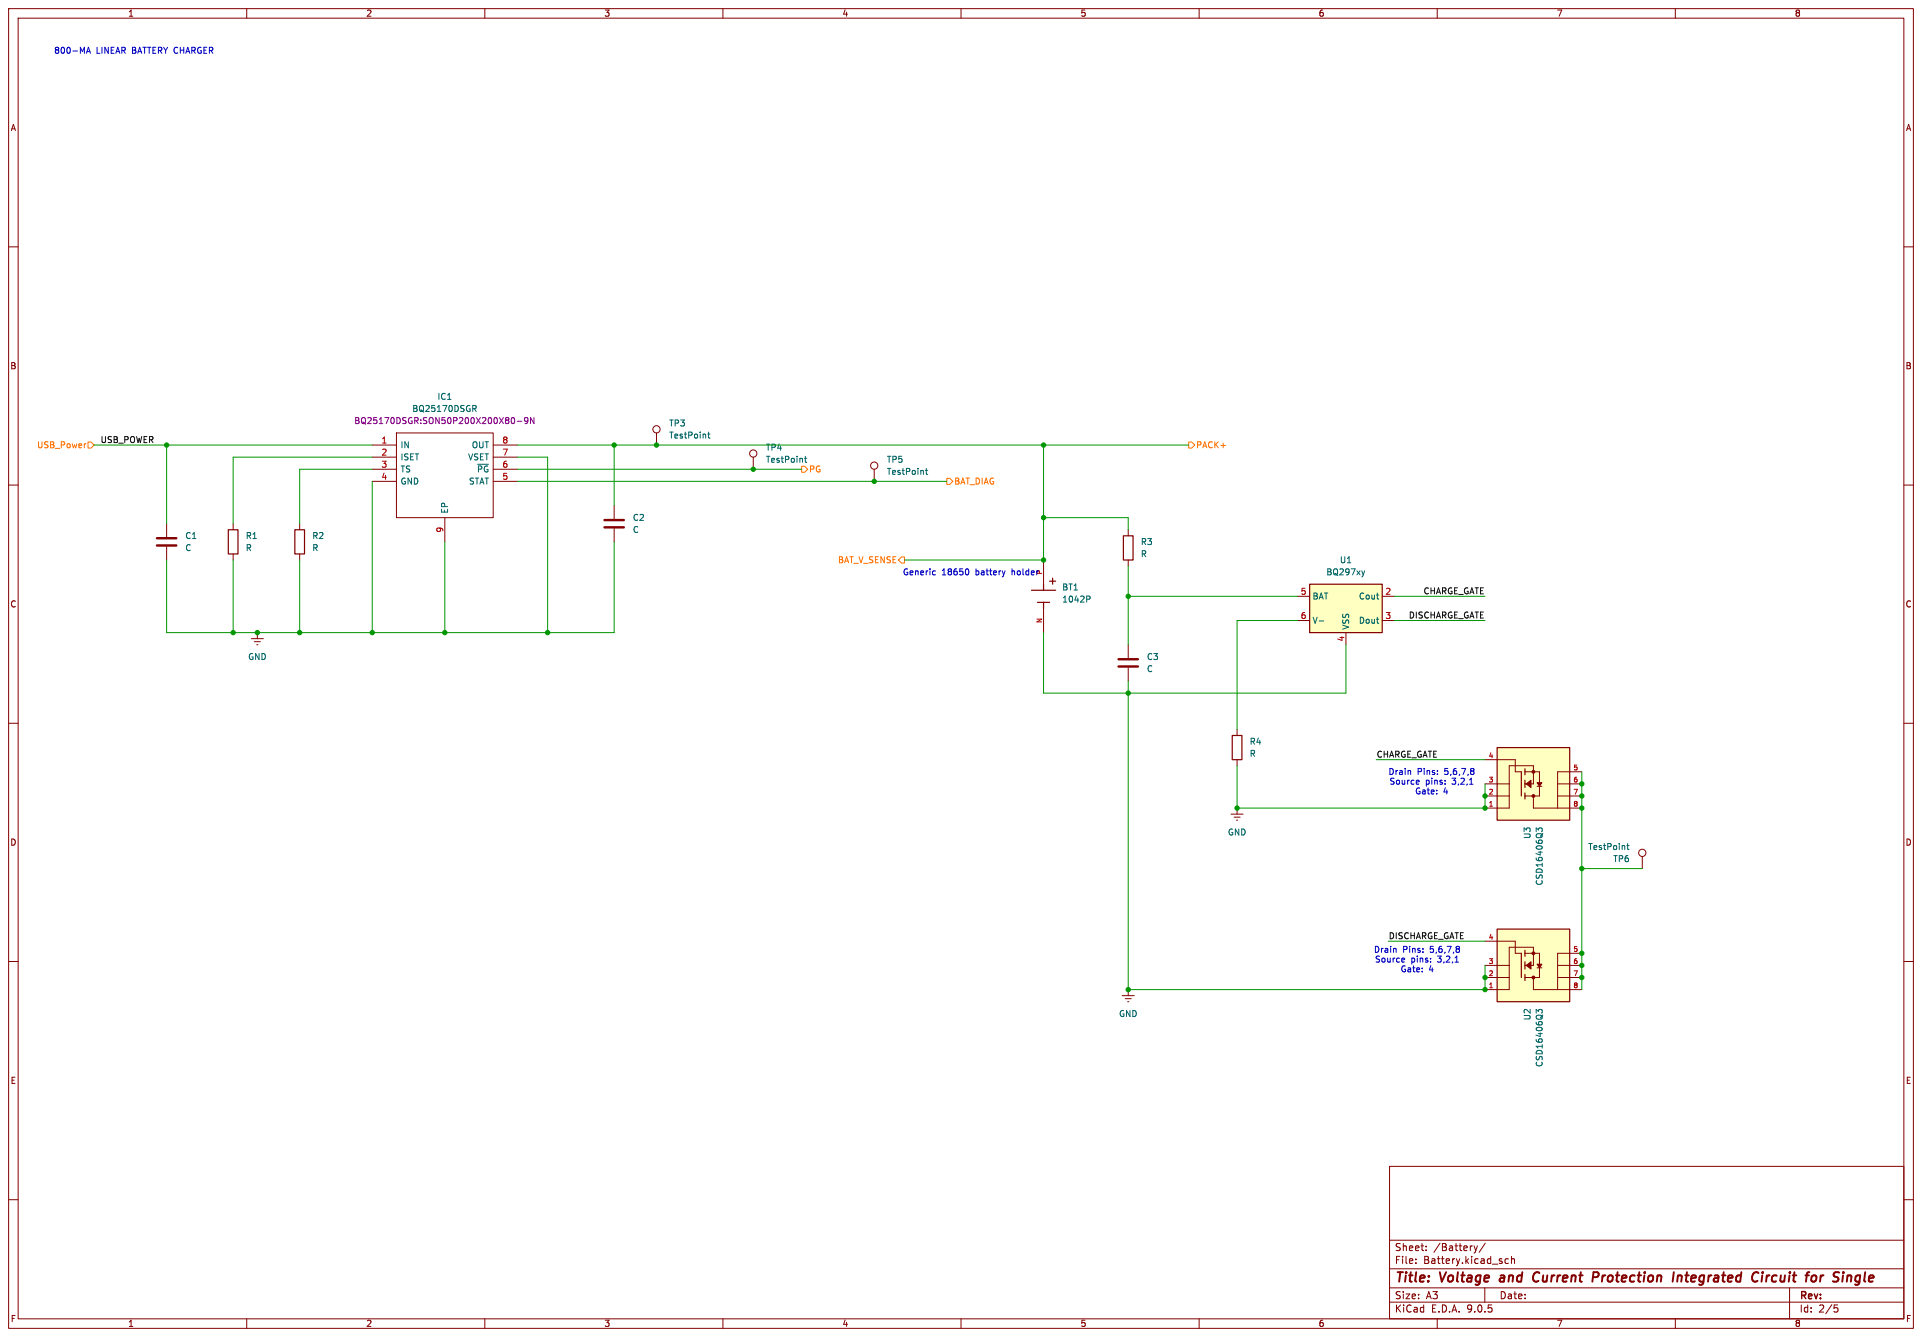
[picture p61: page 2]

9 OUT 8 VSET 7 ~{PG} 6 STAT 5

4 Cout 2 Dout 3 U1 BQ297xy C1 C GND GND

Id: 2/5 Title: Voltage and Current Protection Integrated Circuit for Single

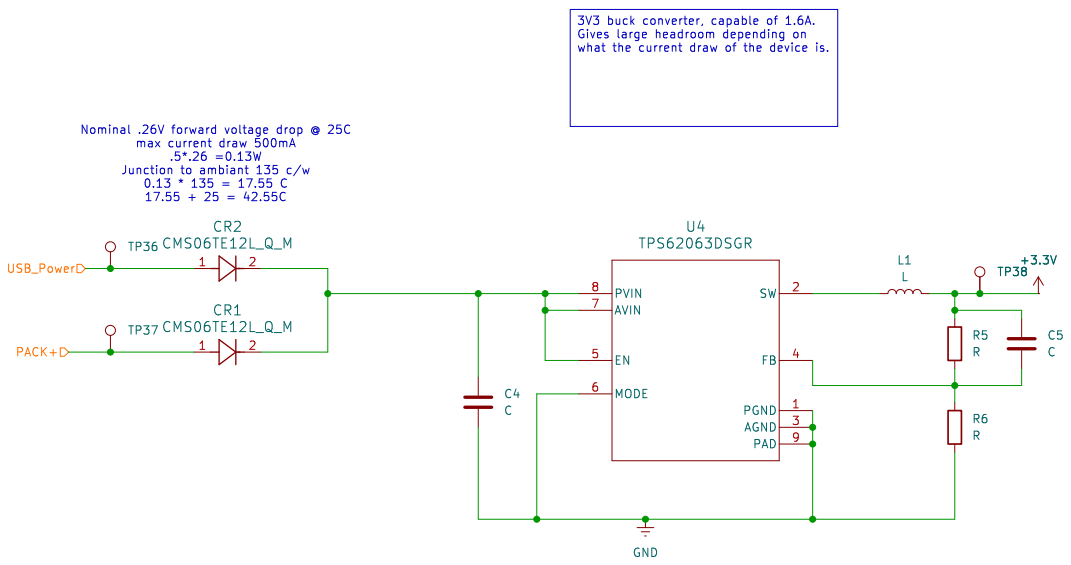
[picture p62: page 3]

Id: 3/5 Title: File: Power.kicad_sch Sheet: /Power/ C4 C

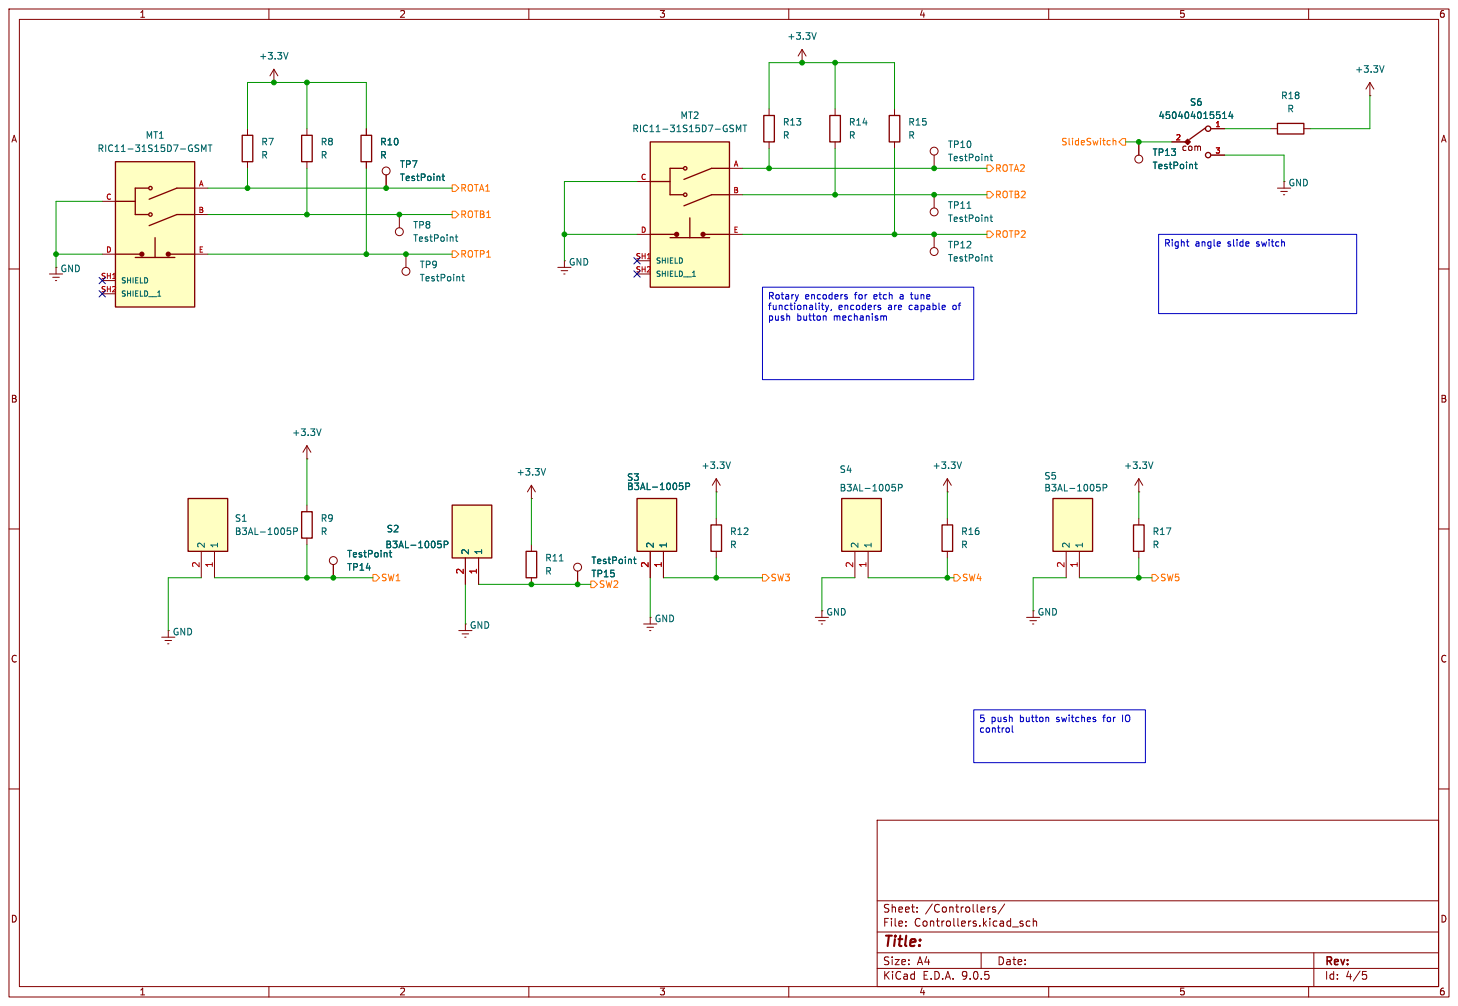
[picture p63: page 4]

E MT2 RIC11-31S15D7-GSMT

5 push button switches for IO
control

Id: 4/5 Title: File: Controllers.kicad_sch Sheet: /Controllers/

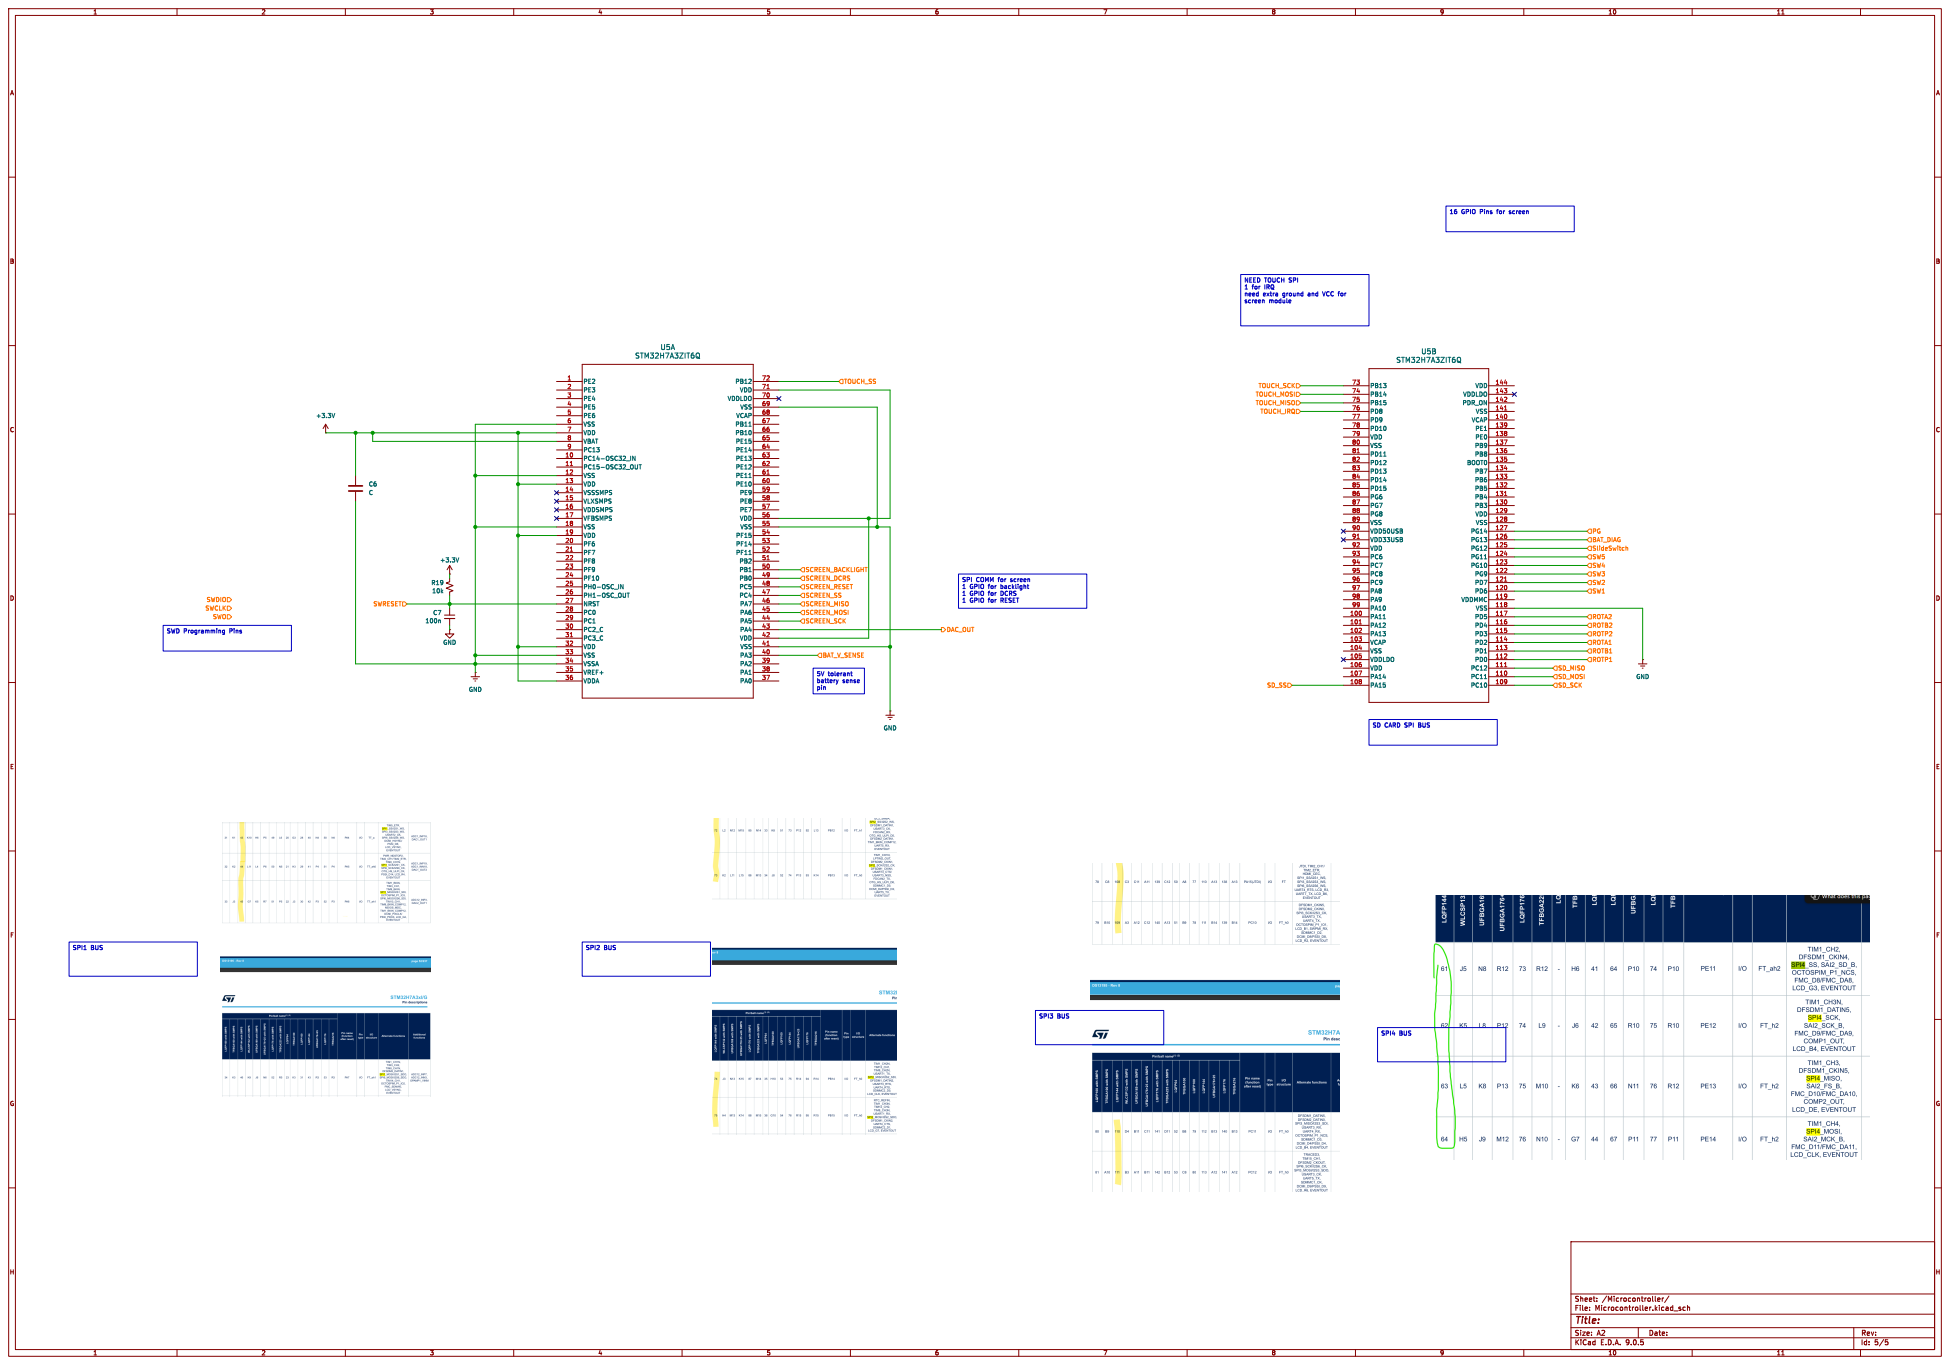
[picture p64: page 5]

16 GPIO Pins for screen

NEED TOUCH SPI 1 for IRQ

need extra ground and VCC for screen module

1 GPIO for backlight 1 GPIO for DCRS
