CullenSharp/Etch-A-Tune/Etch_A_Tune/Etch_a_Sketch_Schematic_V0.4/Etch_A_Tune.pdf

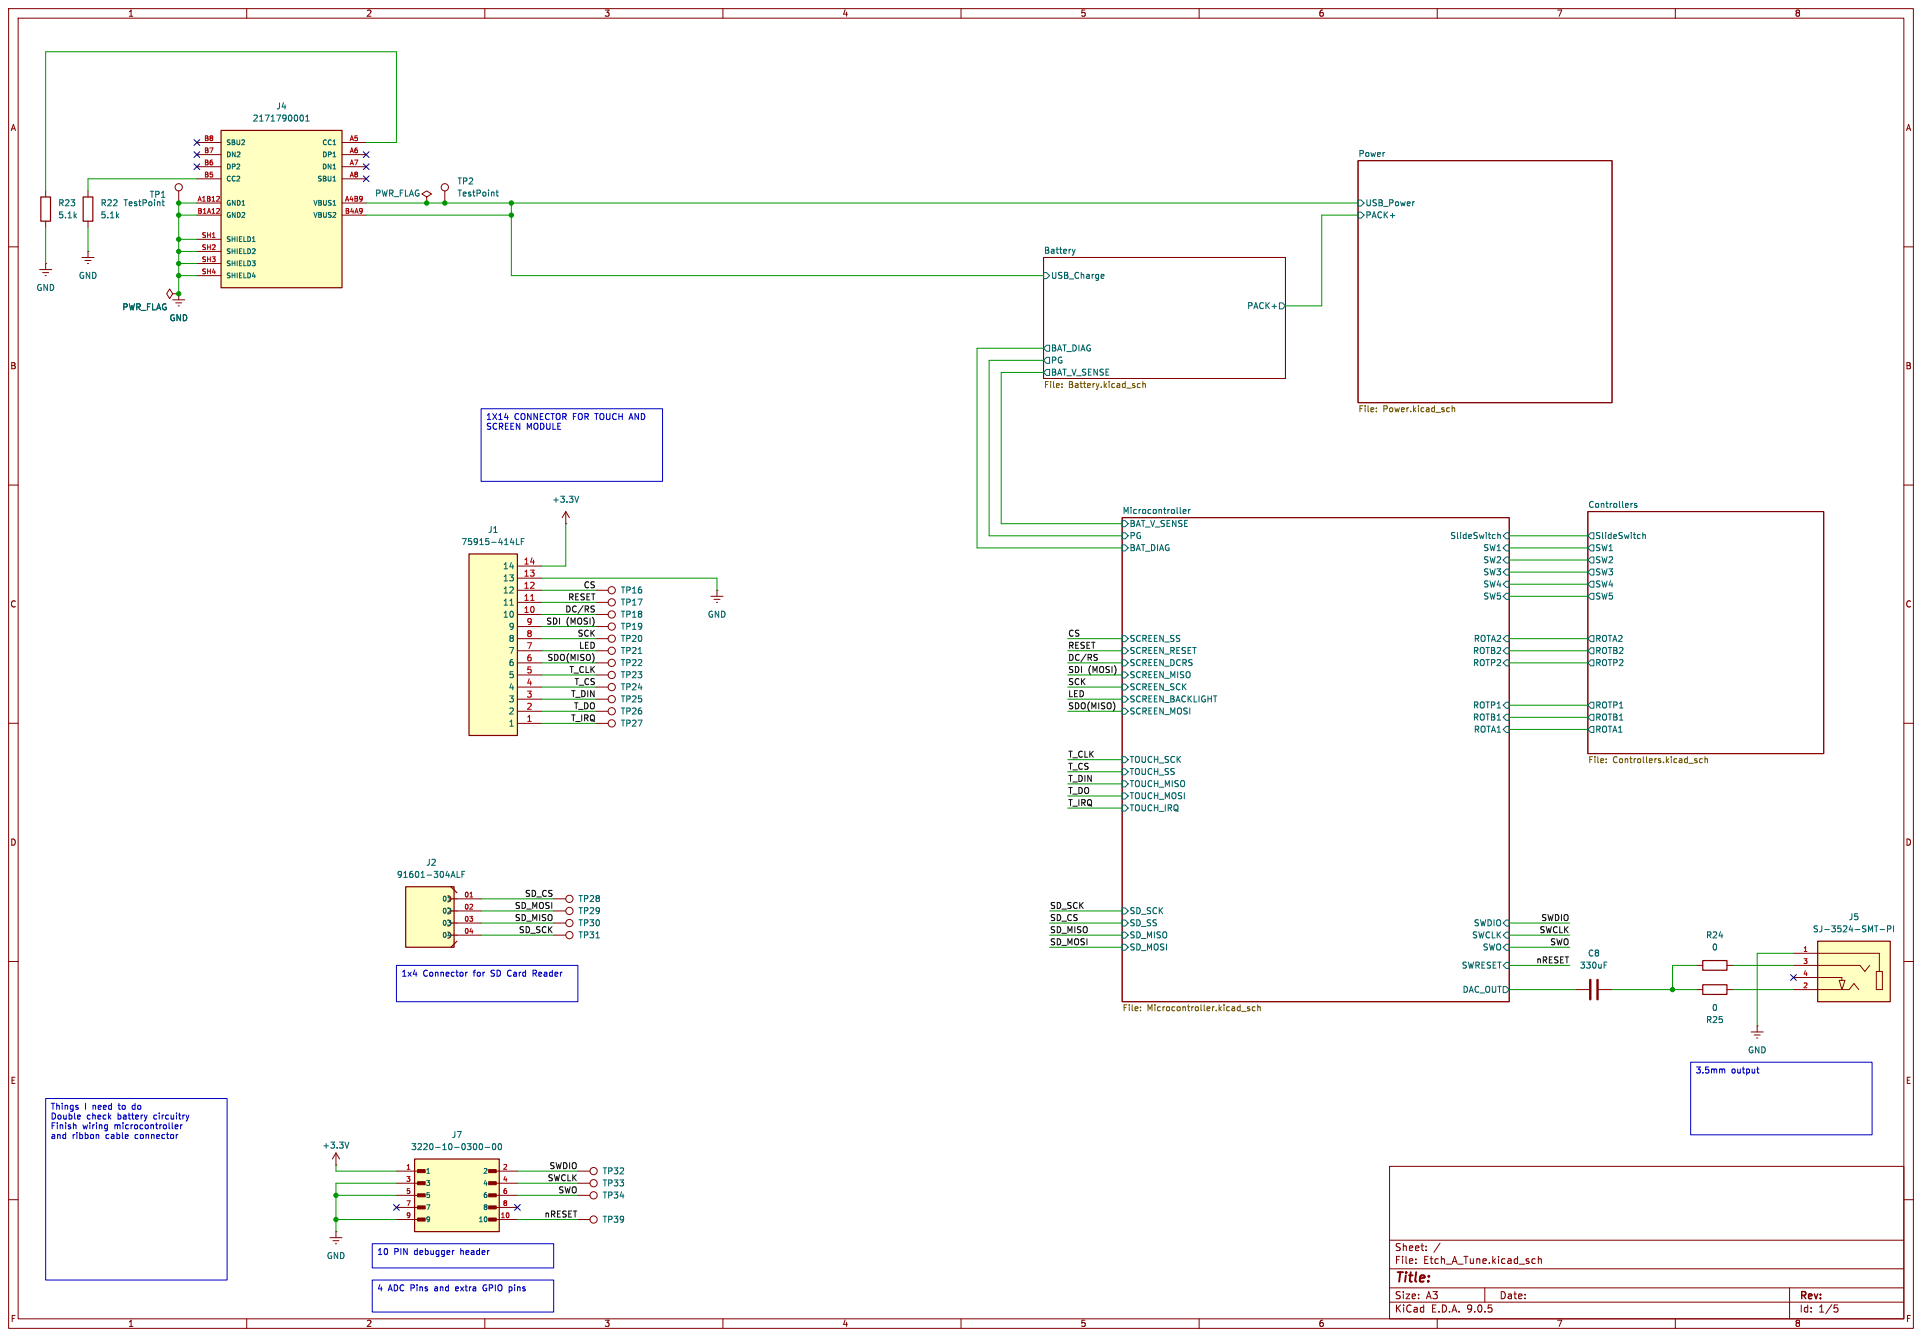
[picture p65: page 1]

PACK+ USB_Power Power File: Power.kicad_sch

1X14 CONNECTOR FOR TOUCH AND
SCREEN MODULE

SCK DC/RSCS
SD_CS RESET SDI (MOSI) LED

CSRESET SDI (MOSI) DC/RS

SCK
nRESET SDO(MISO) LED

10 PIN debugger header 4 ADC Pins and extra GPIO pins


Drain Pins: 5,6,7,8 Source pins: 3,2,1 Gate: 4

Id: 2/5 Title: Voltage and Current Protection Integrated Circuit for Single


Id: 3/5 Title: File: Power.kicad_sch Sheet: /Power/ C4

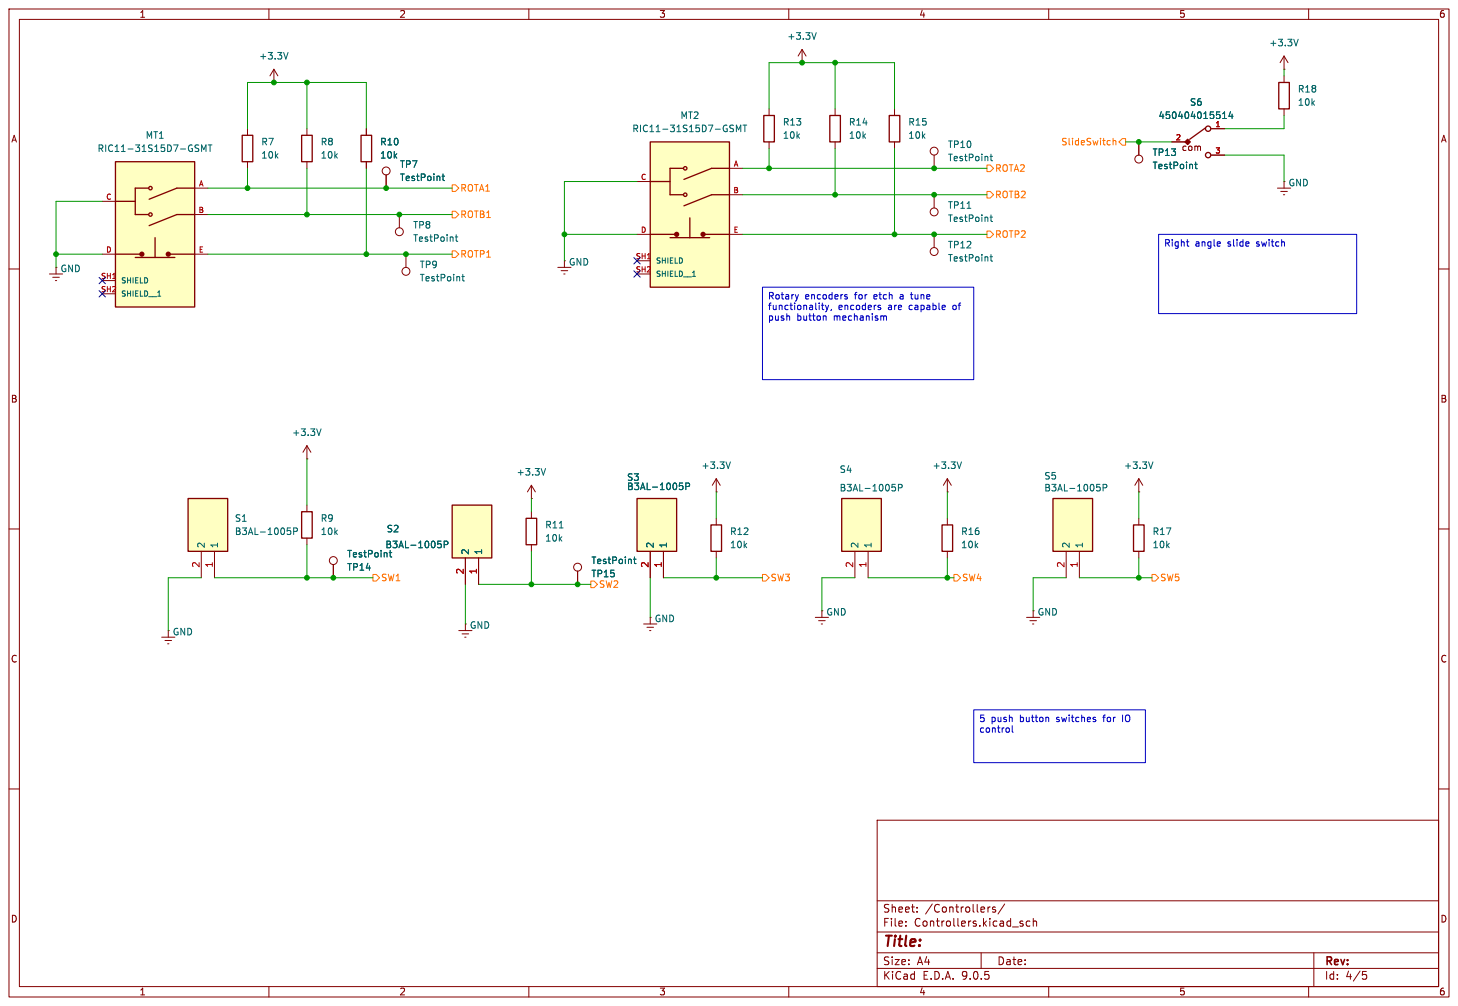
[picture p66: page 4]

E MT1 RIC11-31S15D7-GSMT

Right angle slide switch Rotary encoders for etch a tune

5 push button switches for IO
control

Id: 4/5 Title: File: Controllers.kicad_sch Sheet: /Controllers/

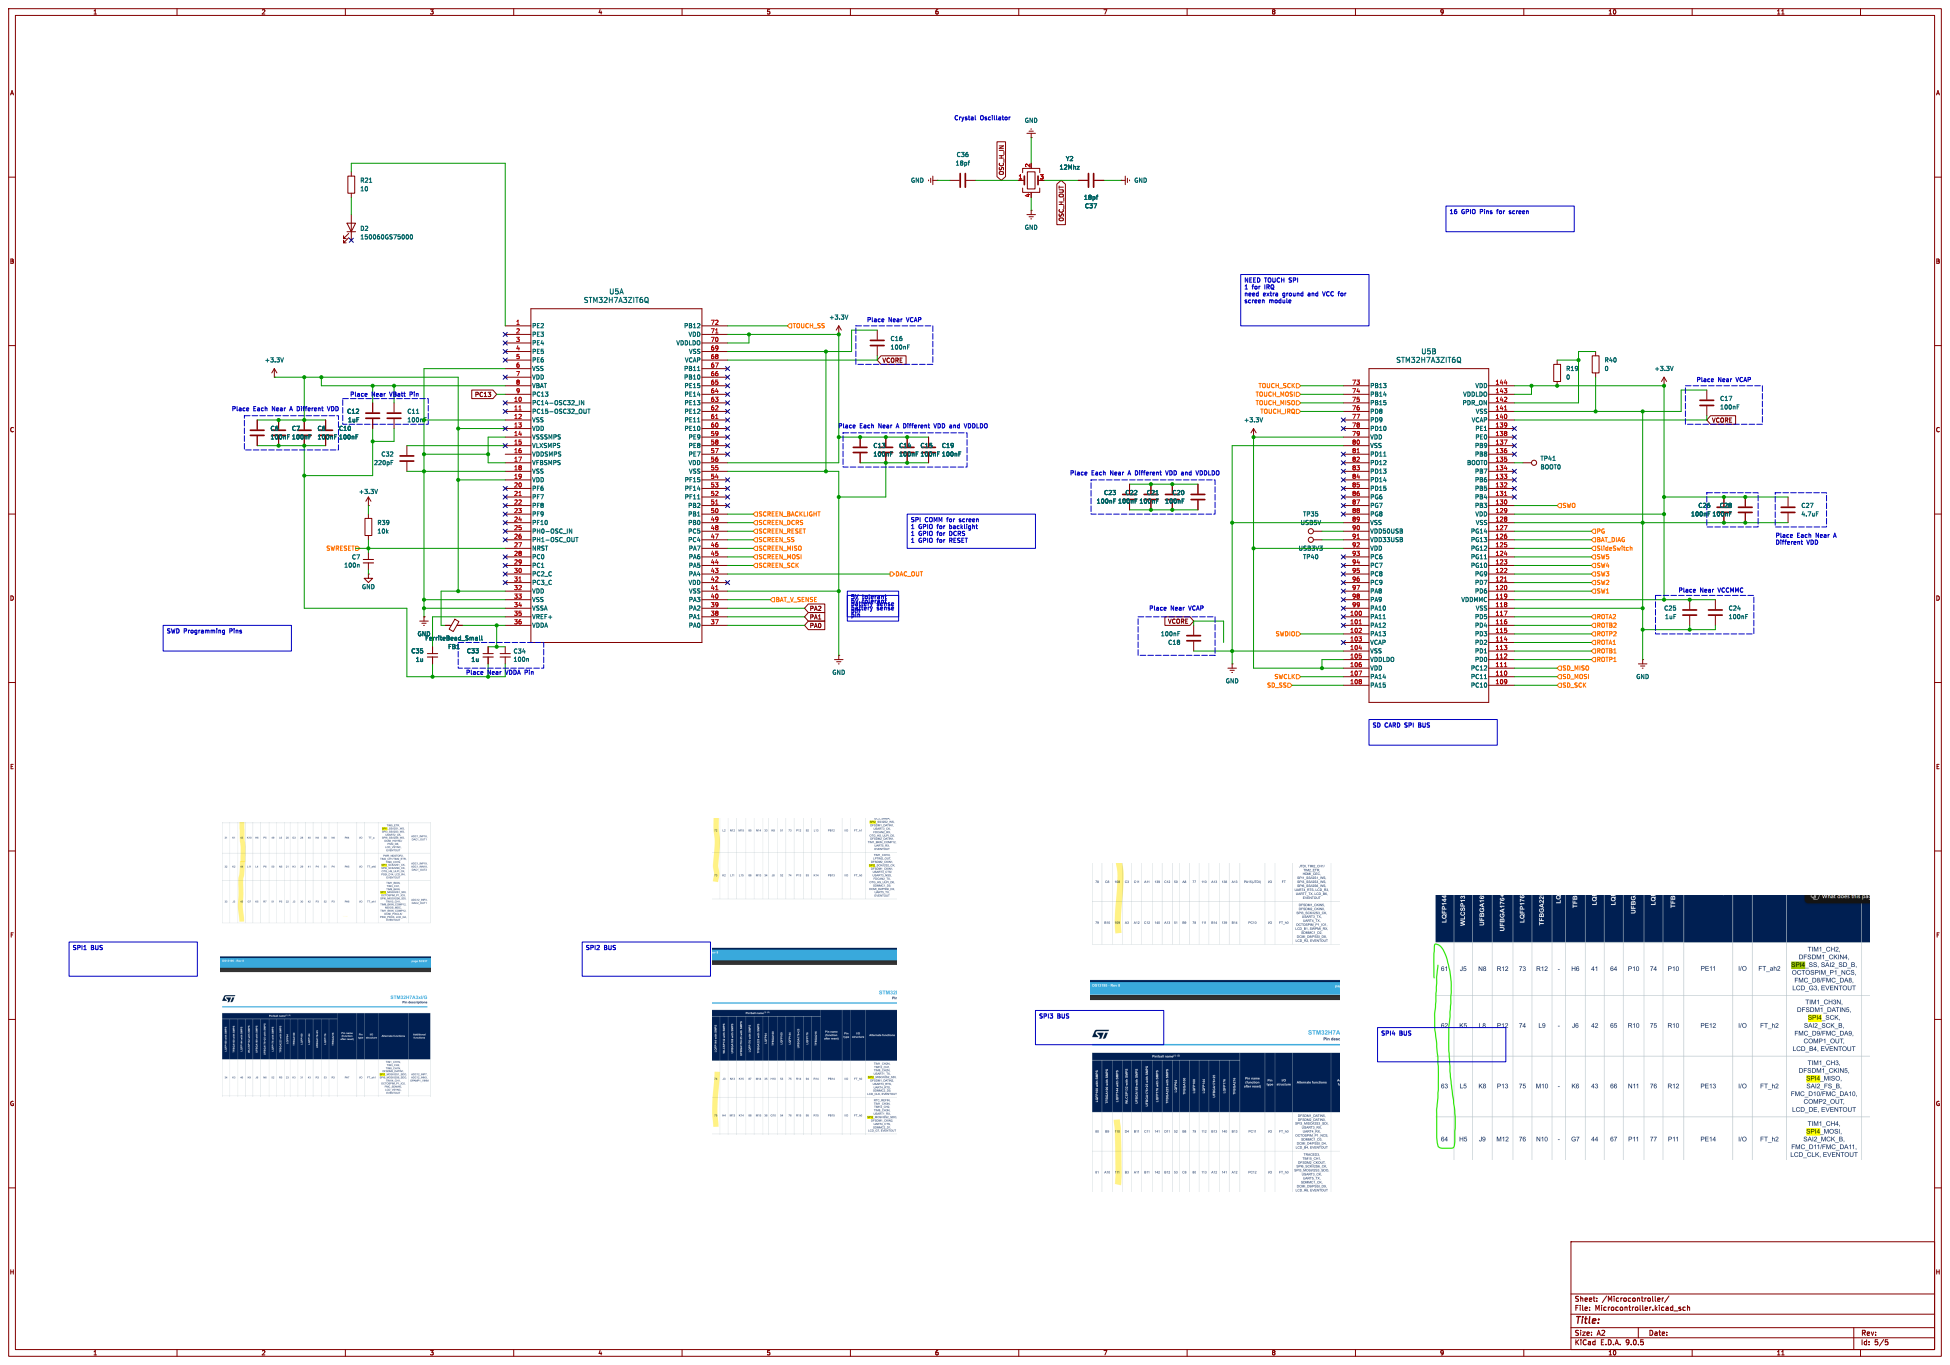
[picture p67: page 5]

16 GPIO Pins for screen

NEED TOUCH SPI 1 for IRQ

need extra ground and VCC for screen module

SPI COMM for screen
1 GPIO for backlight 1 GPIO for DCRS

SD CARD SPI BUS
