CullenSharp/Etch-A-Tune/Etch_A_Tune/Etch_a_Sketch_Schematic_V0.2/Etch_A_Tune_V_02.pdf

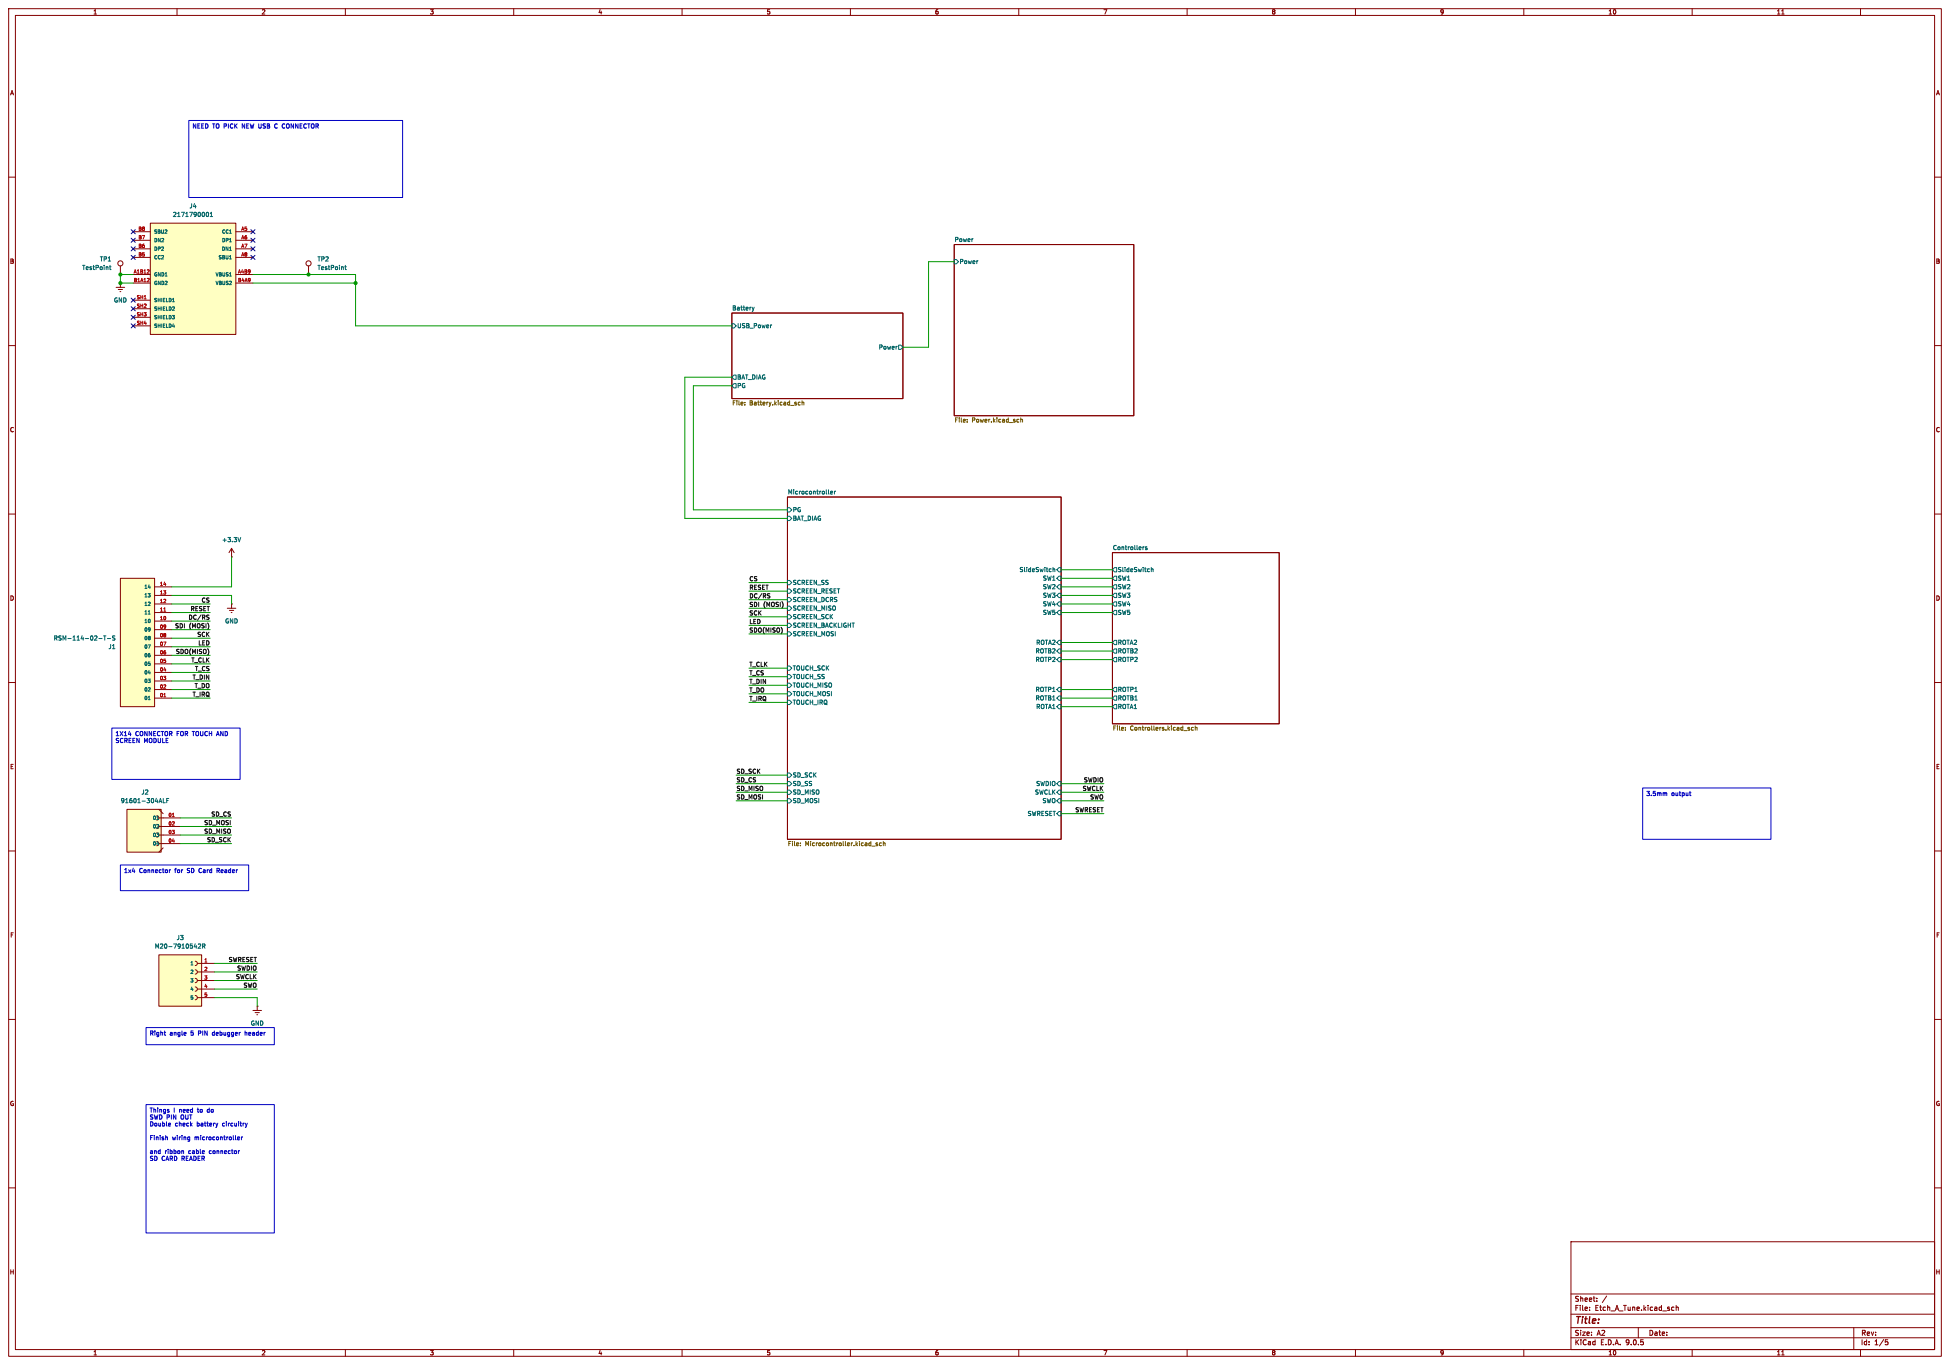
[picture p68: page 1]

NEED TO PICK NEW USB C CONNECTOR

Power Power File: Power.kicad_sch

SWDIO Microcontroller File: Microcontroller.kicad_sch

ROTB2 SlideSwitch ROTP1 ROTA1 ROTA2 ROTP2 ROTB1 SW5 SW3 SW4 SW2 SW1 Controllers File: Controllers.kicad_sch

SDI (MOSI) DC/RS RESET

1X14 CONNECTOR FOR TOUCH AND

3.5mm output Things I need to do SWD PIN OUT Double check battery circuitry Finish wiring microcontroller and ribbon cable connector SD CARD READER

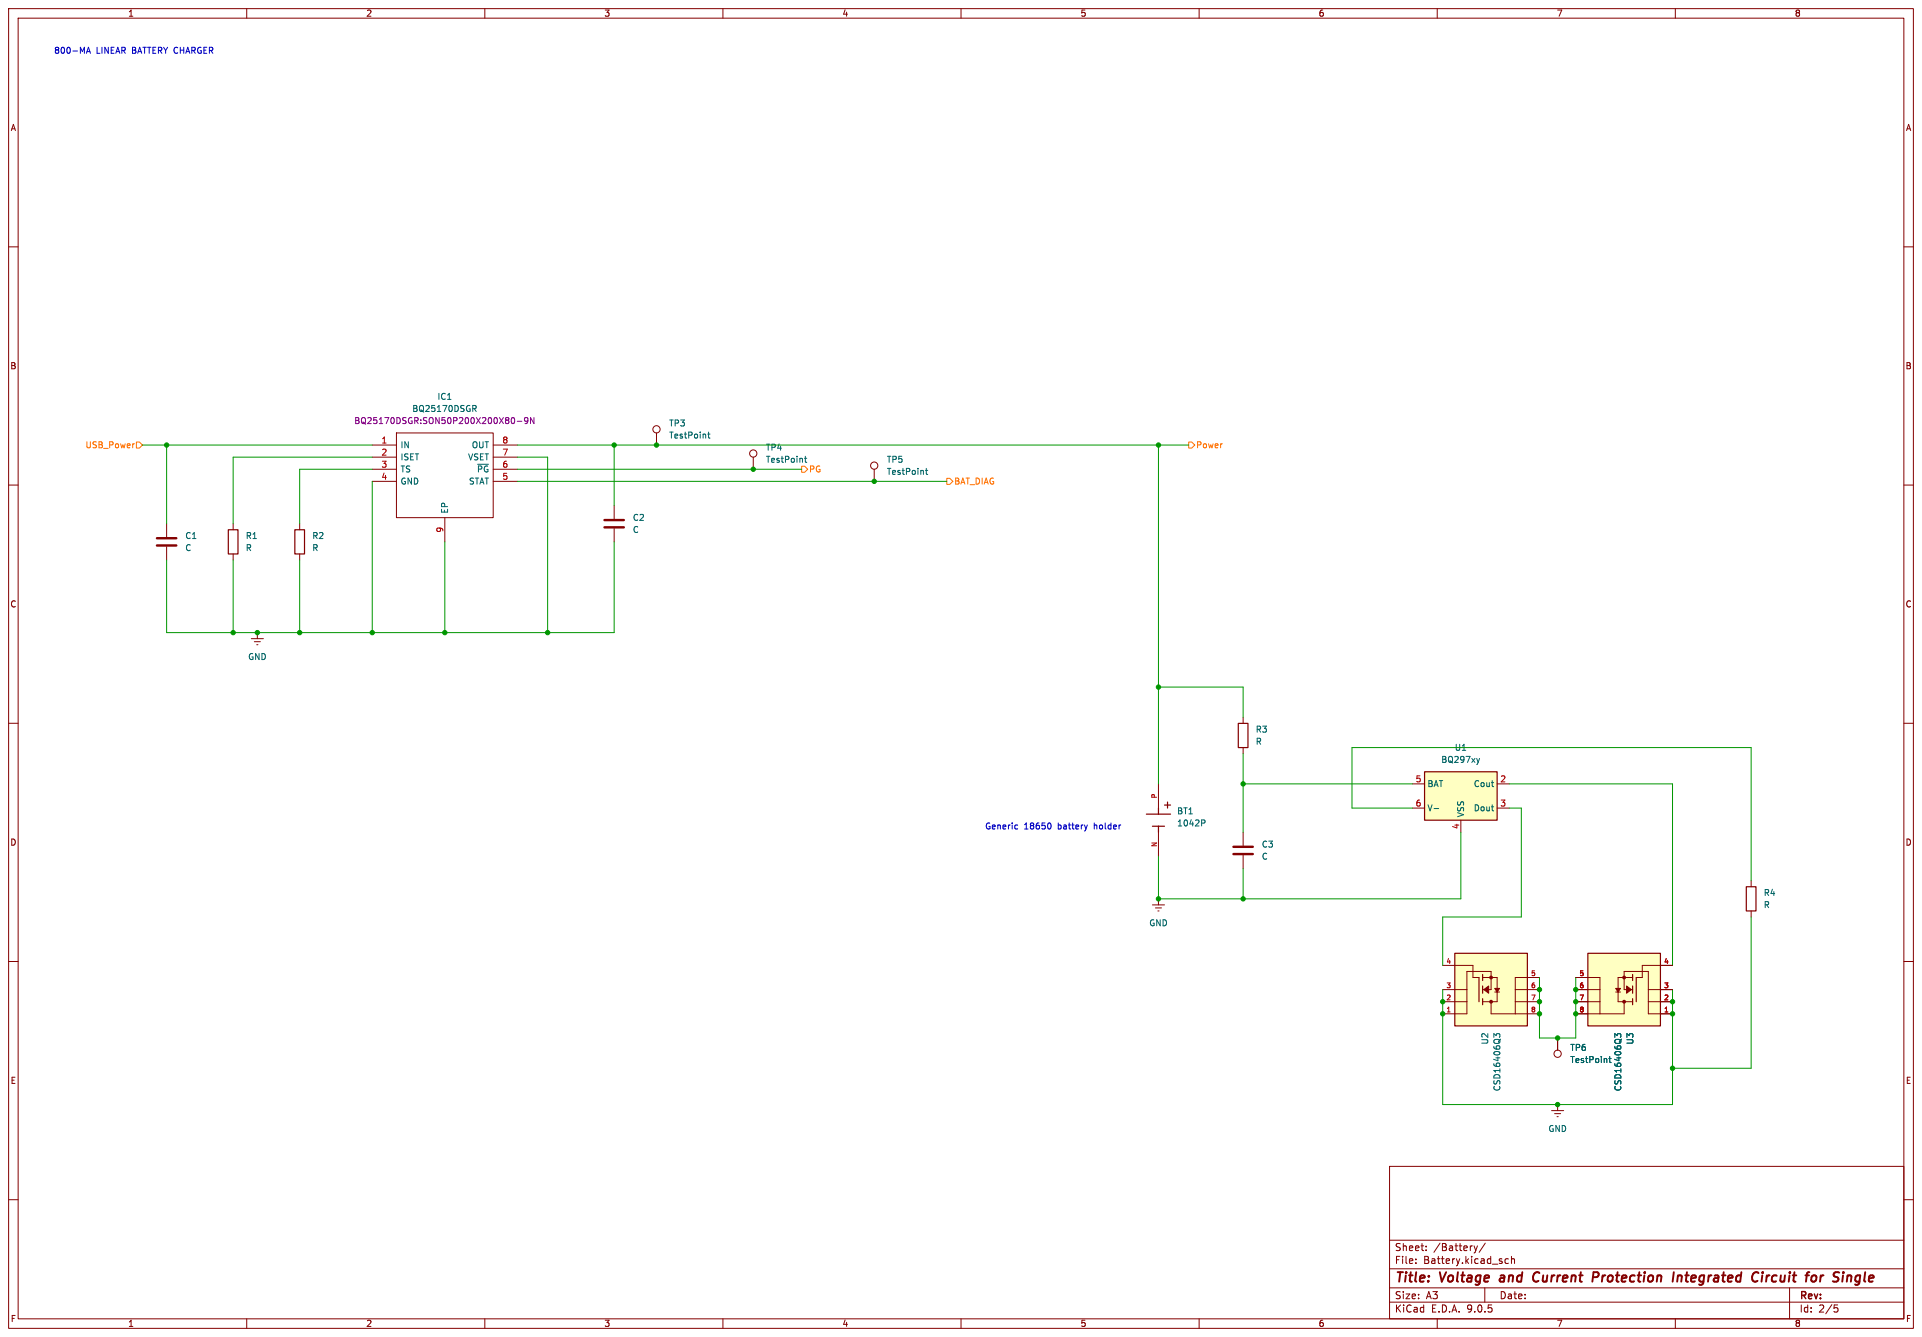
[picture p69: page 2]

9 OUT 8 VSET 7 ~{PG} 6 STAT 5

Id: 2/5 Title: Voltage and Current Protection Integrated Circuit for Single

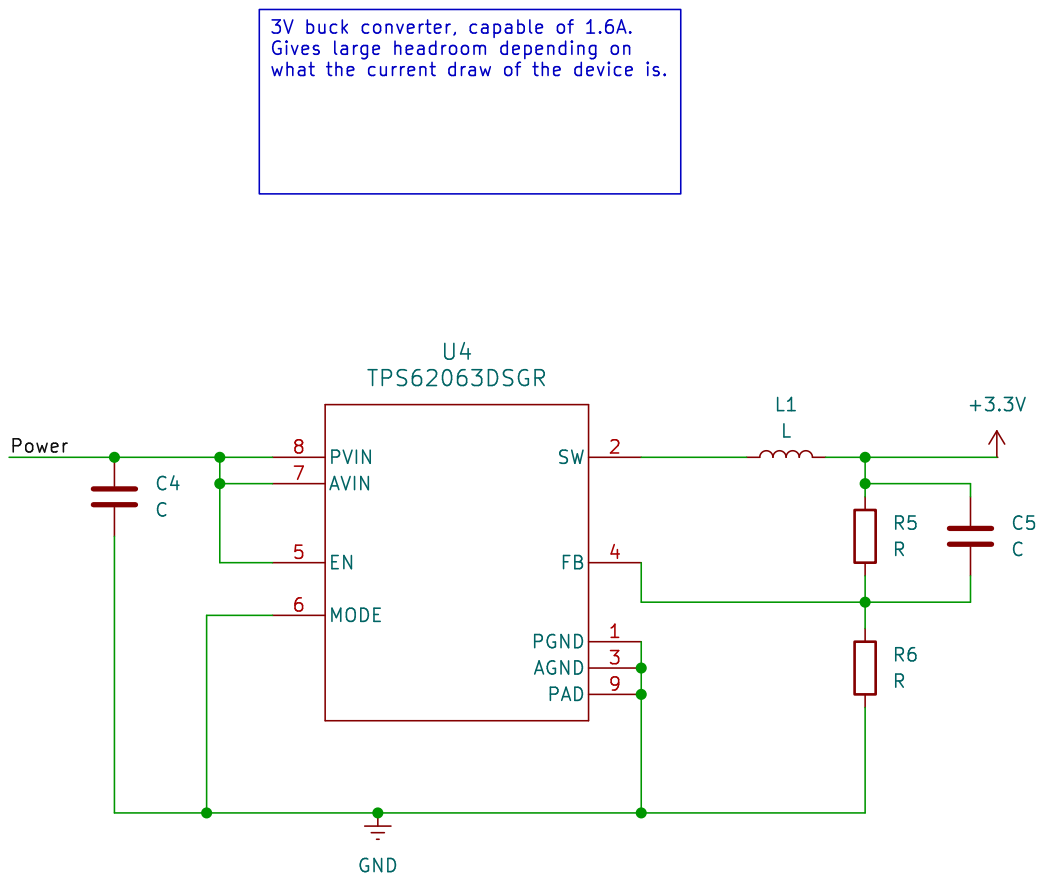
[picture p70: page 3]

Id: 3/5 Title: File: Power.kicad_sch Sheet: /Power/

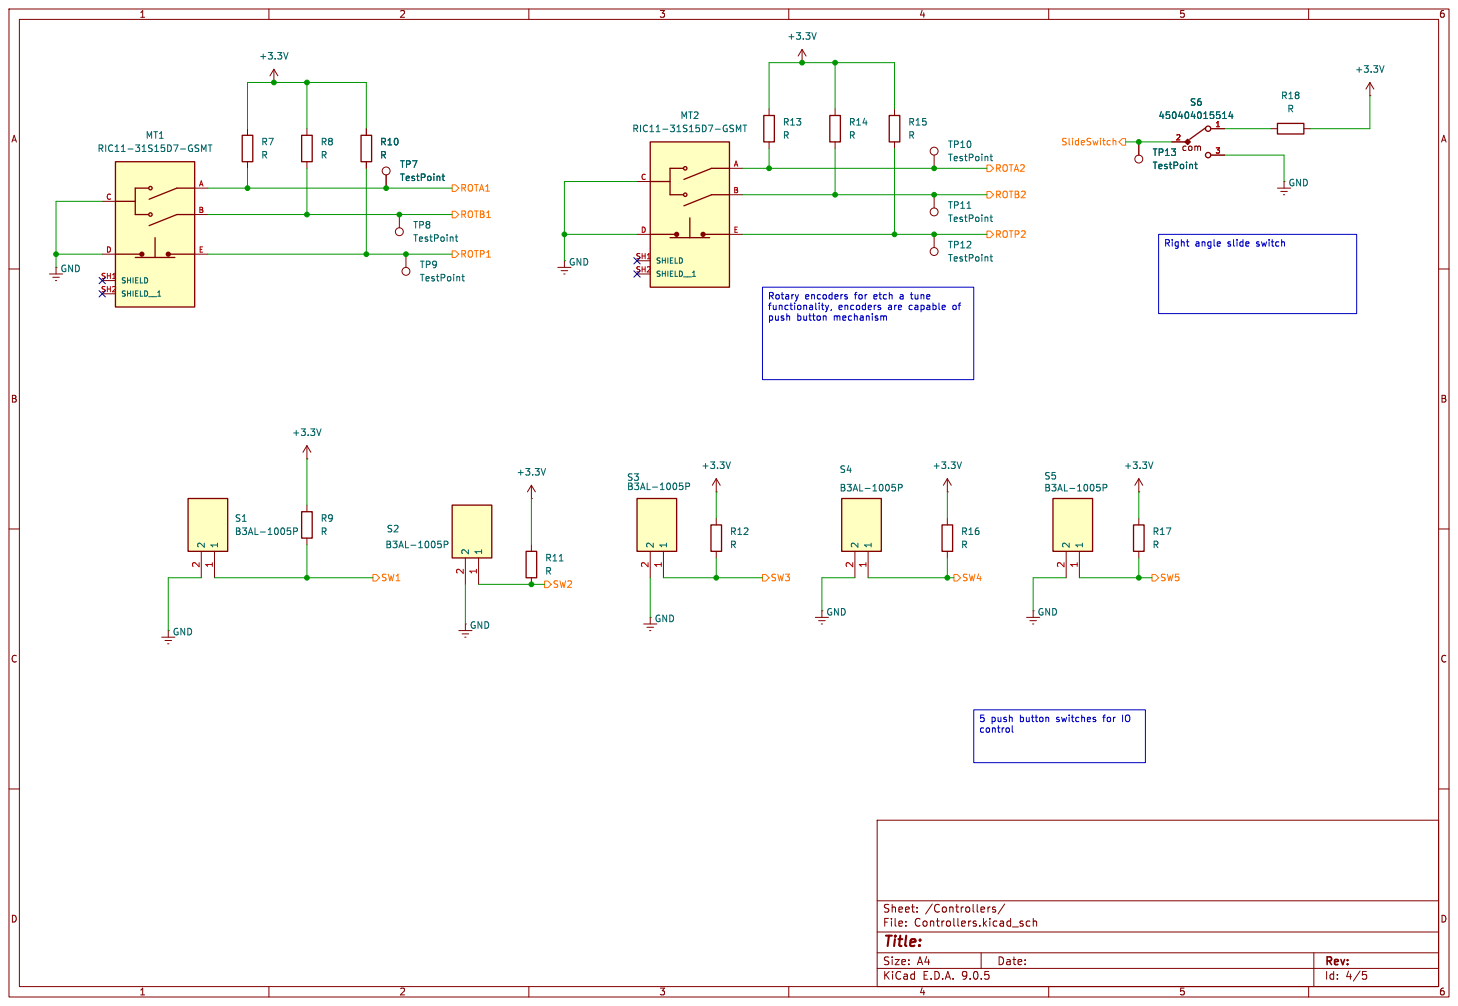
[picture p71: page 4]

E MT2 RIC11-31S15D7-GSMT

Right angle slide switch Rotary encoders for etch a tune

5 push button switches for IO
control

Id: 4/5 Title: File: Controllers.kicad_sch Sheet: /Controllers/

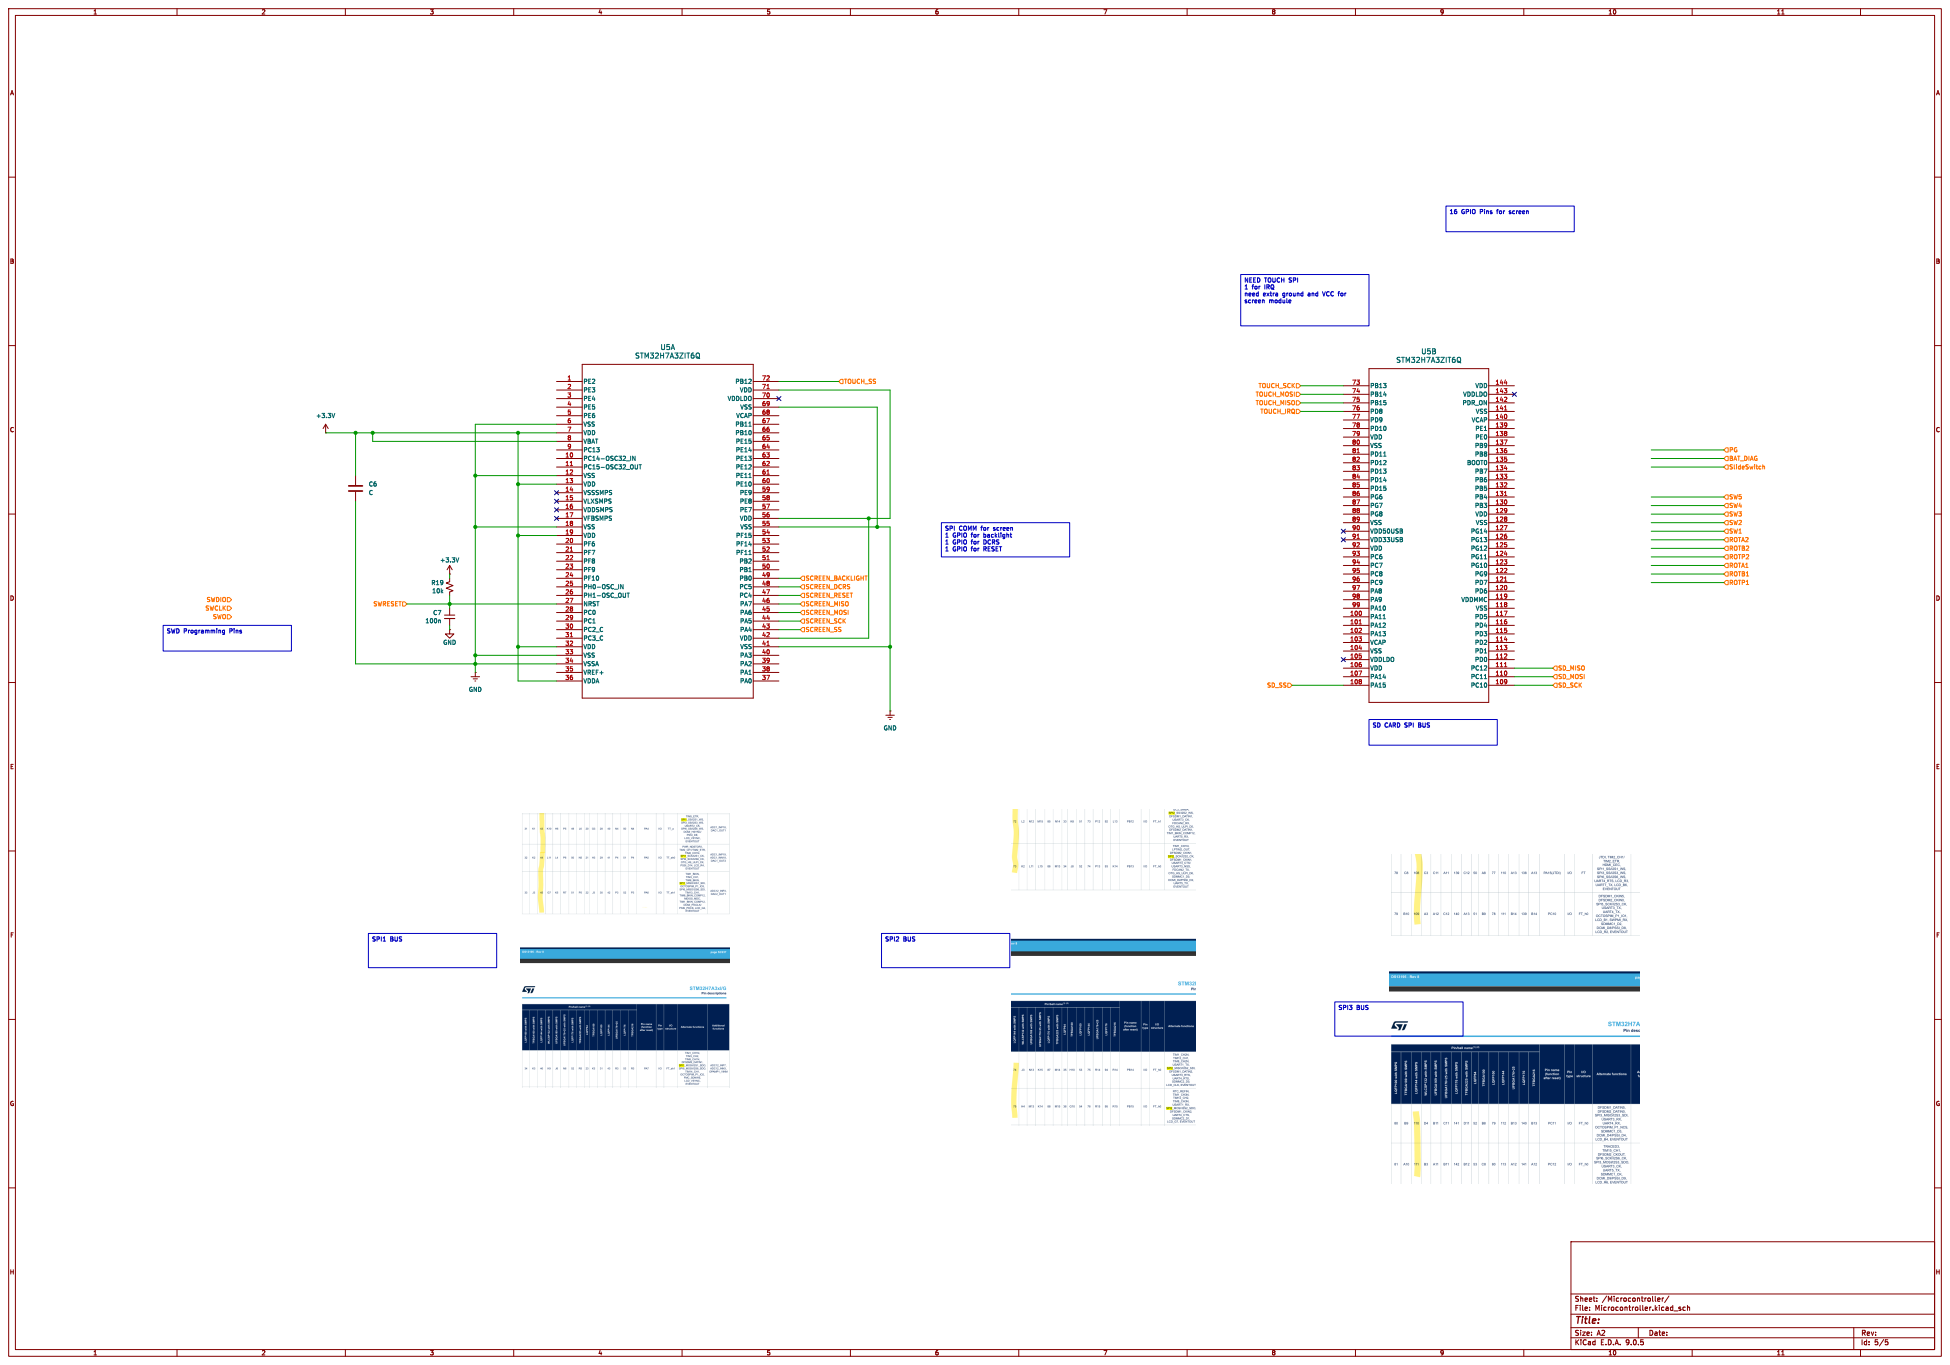
[picture p72: page 5]

16 GPIO Pins for screen

NEED TOUCH SPI 1 for IRQ

need extra ground and VCC for screen module

1 GPIO for backlight 1 GPIO for DCRS
