CullenSharp/Etch-A-Tune/Etch_A_Tune/Etch_a_Sketch_Schematic_V0.1/Etch_A_Tune.pdf

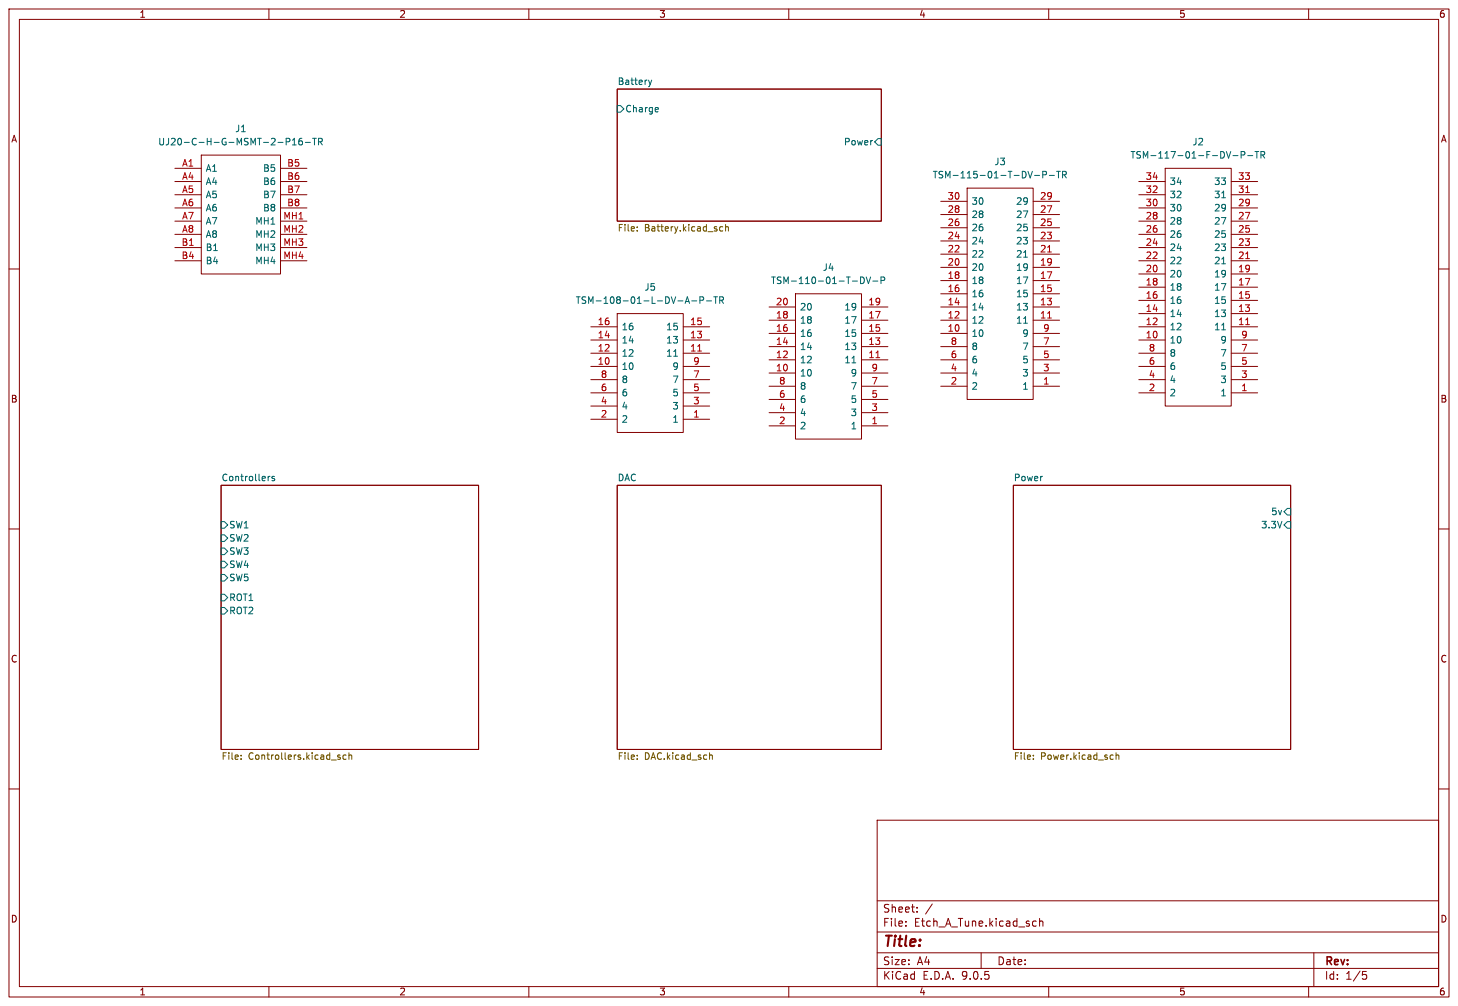
[picture p73: page 1]

Battery File: Battery.kicad_sch SW3 ROT2 SW4 SW5 ROT1 SW2 SW1 Controllers File: Controllers.kicad_sch

Power File: Power.kicad_sch DAC

Id: 1/5 Title: File: Etch_A_Tune.kicad_sch Sheet: /

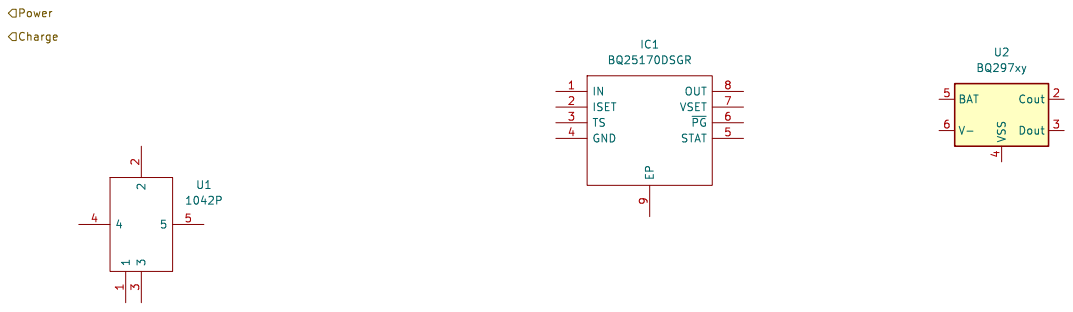
[picture p74: page 2]

9 OUT 8 VSET 7 ~{PG} 6 STAT 5

Id: 2/5 Title: File: Battery.kicad_sch Sheet: /Battery/

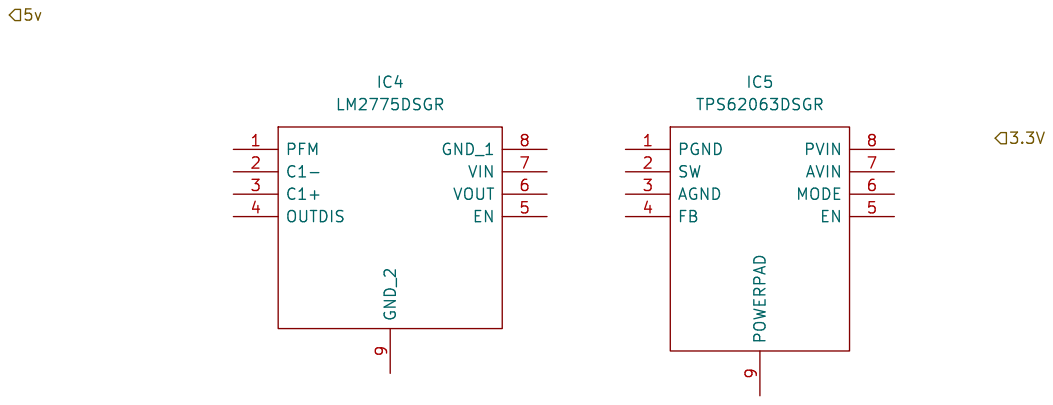
[picture p75: page 3]

9 PVIN 8 AVIN 7 MODE 6 EN 5

Id: 3/5 Title: File: Power.kicad_sch Sheet: /Power/

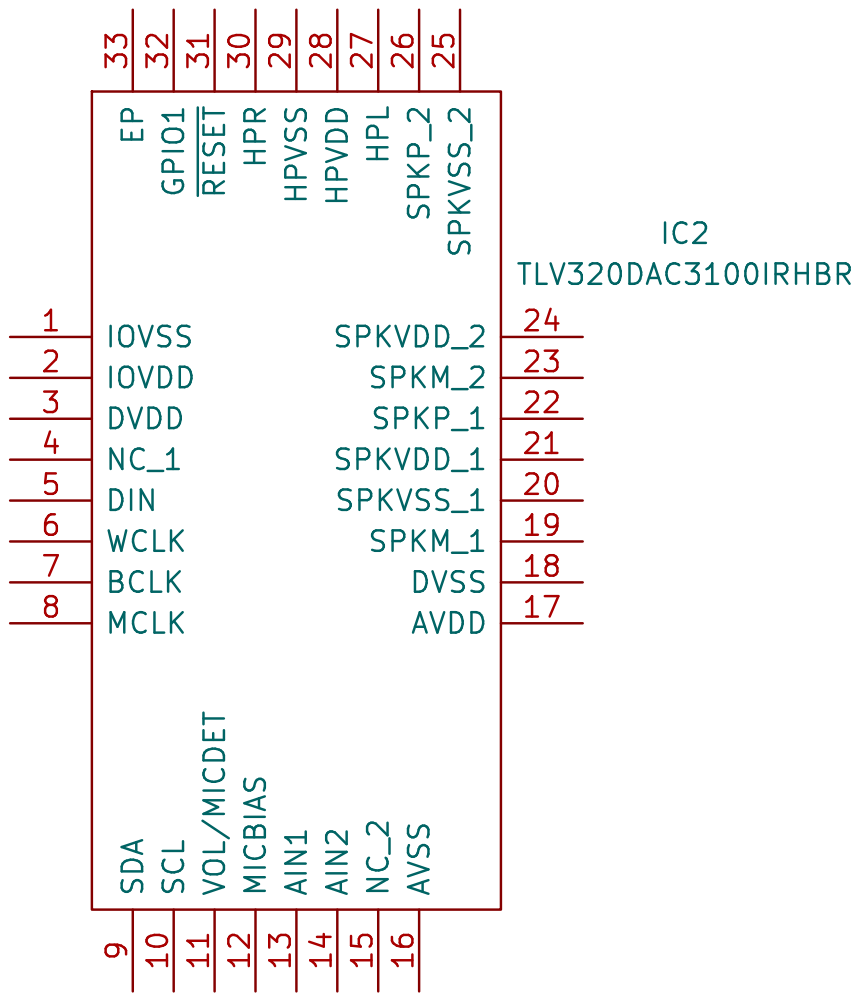
[picture p76: page 4]

Id: 4/5 Title: File: DAC.kicad_sch Sheet: /DAC/

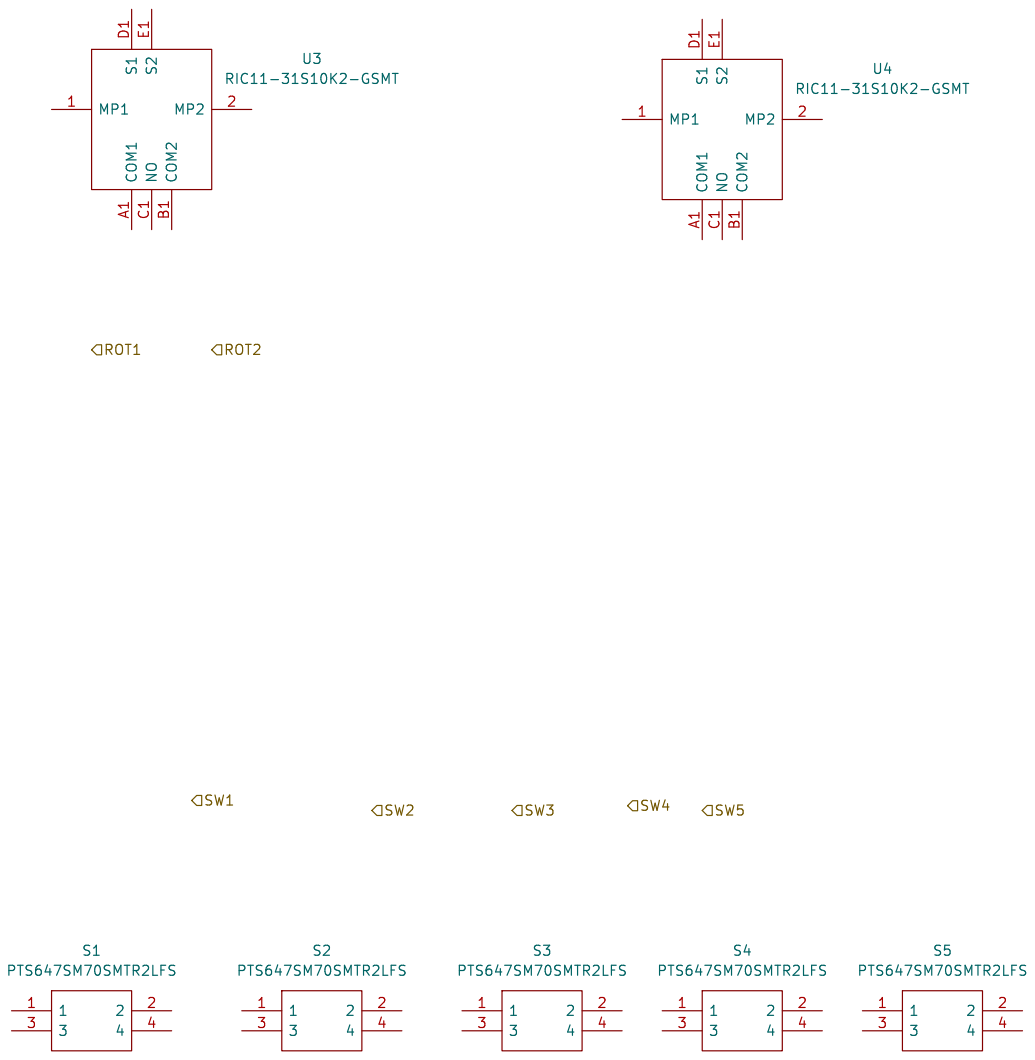
[picture p77: page 5]

Id: 5/5 Title: File: Controllers.kicad_sch Sheet: /Controllers/
