CullenSharp/Etch-A-Tune/Etch_A_Tune/Etch_A_Tune.kicad_pcb

## KiCad design Etch_A_Tune/Etch_A_Tune.kicad_pcb (2025-11-20)

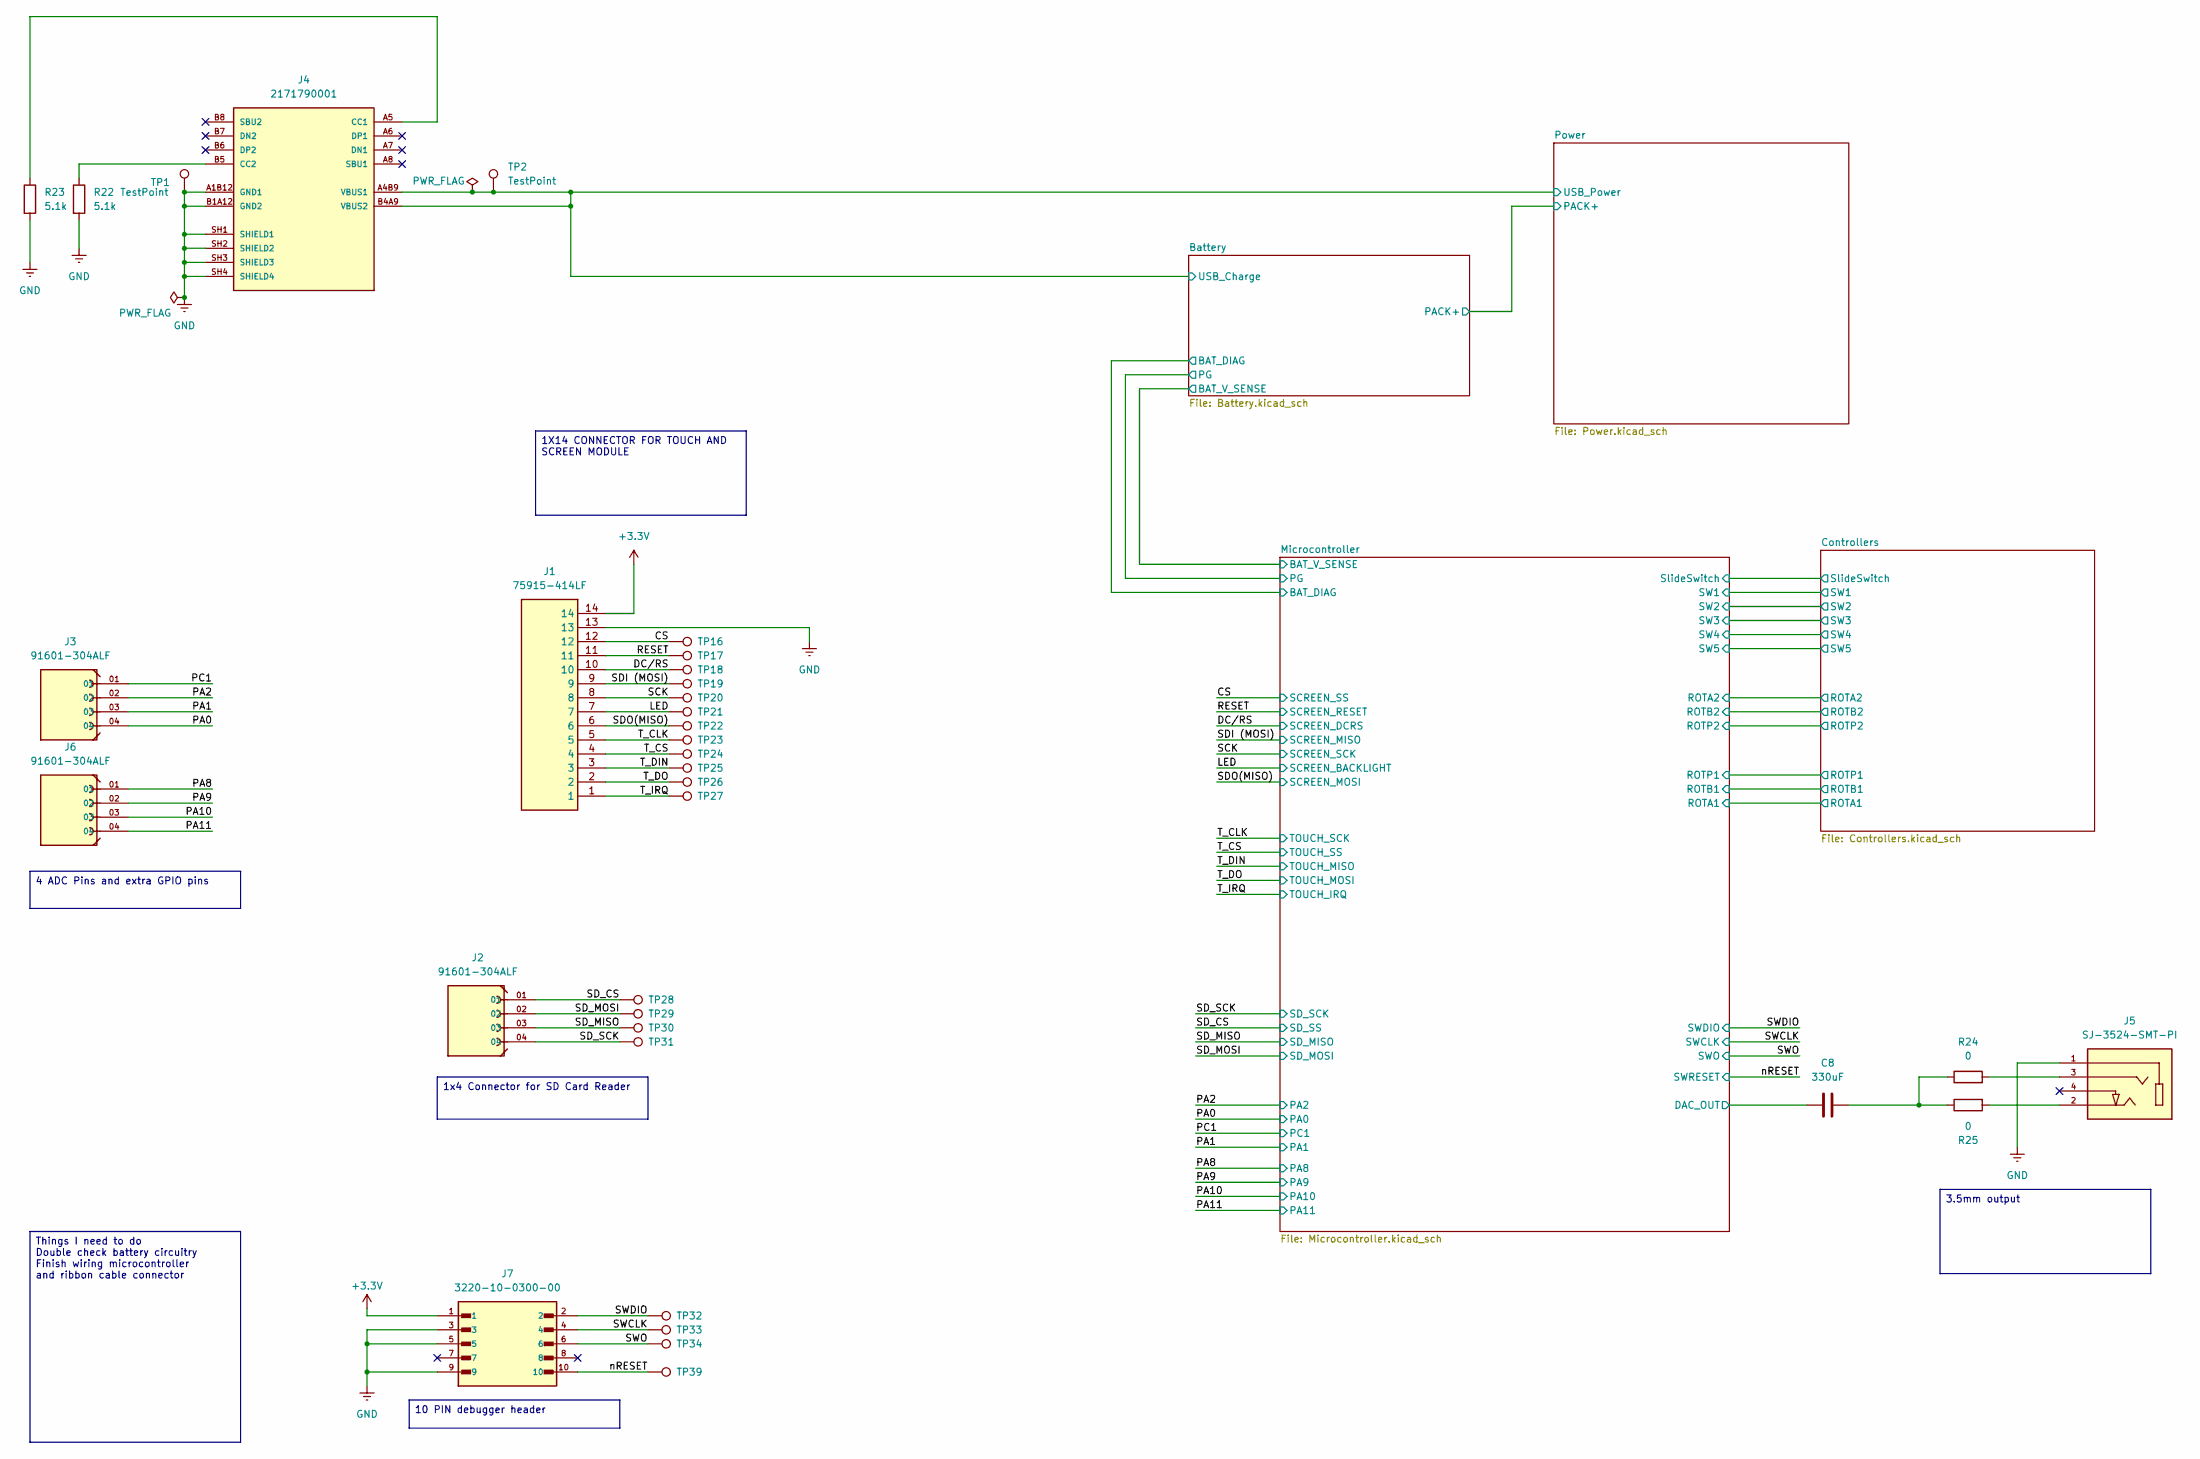
[picture p78: schematic Etch_A_Tune.kicad_sch]

Parts:
C8: 330uF; C_1210_3225Metric
J1: 75915-414LF; 75915414LF; Mouser Part Number 649-75915-414LF
J2, J3, J6: 91601-304ALF; AMPHENOL_91601-304ALF; PARTREV AJ
J4: 2171790001; MOLEX_2171790001; PARTREV A1
J5: SJ-3524-SMT-PI; CUI_SJ-3524-SMT-PI
J7: 3220-10-0300-00; CNC_3220-10-0300-00; PARTREV D
R22, R23: 5.1k; R_0603_1608Metric
R24, R25: 0; R_0603_1608Metric
TP1, TP2, TP16, TP17, TP18, TP19, TP20, TP21, TP22, TP23, TP24, TP25, TP26, TP27, TP28, TP29, TP30, TP31, TP32, TP33, TP34, TP39: TestPoint; TestPoint_Pad_D1.0mm

Connections:
+3.3V: J1.14, J7.1; also elsewhere on the board
/Battery/USB_Charge: J4.A4B9 (VBUS1), J4.B4A9 (VBUS2), TP2.1; also elsewhere on the board
/CS: J1.12, TP16.1; also elsewhere on the board
/DC/RS: J1.10, TP18.1; also elsewhere on the board
/LED: J1.7, TP21.1; also elsewhere on the board
/Microcontroller/DAC_OUT: C8.1; also elsewhere on the board
/PA0: J3.04; also elsewhere on the board
/PA1: J3.03; also elsewhere on the board
/PA2: J3.02; also elsewhere on the board
/PA8: J6.01; also elsewhere on the board
/PA9: J6.02; also elsewhere on the board
/PA10: J6.03; also elsewhere on the board
/PA11: J6.04; also elsewhere on the board
/PC1: J3.01; also elsewhere on the board
/RESET: J1.11, TP17.1; also elsewhere on the board
/SCK: J1.8, TP20.1; also elsewhere on the board
/SDI (MOSI): J1.9, TP19.1; also elsewhere on the board
/SDO(MISO): J1.6, TP22.1; also elsewhere on the board
/SD_CS: J2.01, TP28.1; also elsewhere on the board
/SD_MISO: J2.03, TP30.1; also elsewhere on the board
/SD_MOSI: J2.02, TP29.1; also elsewhere on the board
/SD_SCK: J2.04, TP31.1; also elsewhere on the board
/SWCLK: J7.4, TP33.1; also elsewhere on the board
/SWDIO: J7.2, TP32.1; also elsewhere on the board
/SWO: J7.6, TP34.1; also elsewhere on the board
/T_CLK: J1.5, TP23.1; also elsewhere on the board
/T_CS: J1.4, TP24.1; also elsewhere on the board
/T_DIN: J1.3, TP25.1; also elsewhere on the board
/T_DO: J1.2, TP26.1; also elsewhere on the board
/T_IRQ: J1.1, TP27.1; also elsewhere on the board
/nRESET: J7.10, TP39.1; also elsewhere on the board
GND: J1.13, J4.A1B12 (GND1), J4.B1A12 (GND2), J4.SH1 (SHIELD1), J4.SH2 (SHIELD2), J4.SH3 (SHIELD3), J4.SH4 (SHIELD4), J5.1, J7.3, J7.5, J7.9, R22.2, R23.2, TP1.1; also elsewhere on the board
unnamed: C8.2, R24.1, R25.1
unnamed: J4.A5 (CC1), R23.1
unnamed: J4.B5 (CC2), R22.1
unnamed: J5.2, R25.2
unnamed: J5.3, R24.2

Notes on the sheet:
10 PIN debugger header
Things I need to do Double check battery circuitry Finish wiring microcontroller and ribbon cable connector
4 ADC Pins and extra GPIO pins
1x4 Connector for SD Card Reader
1X14 CONNECTOR FOR TOUCH AND SCREEN MODULE
3.5mm output

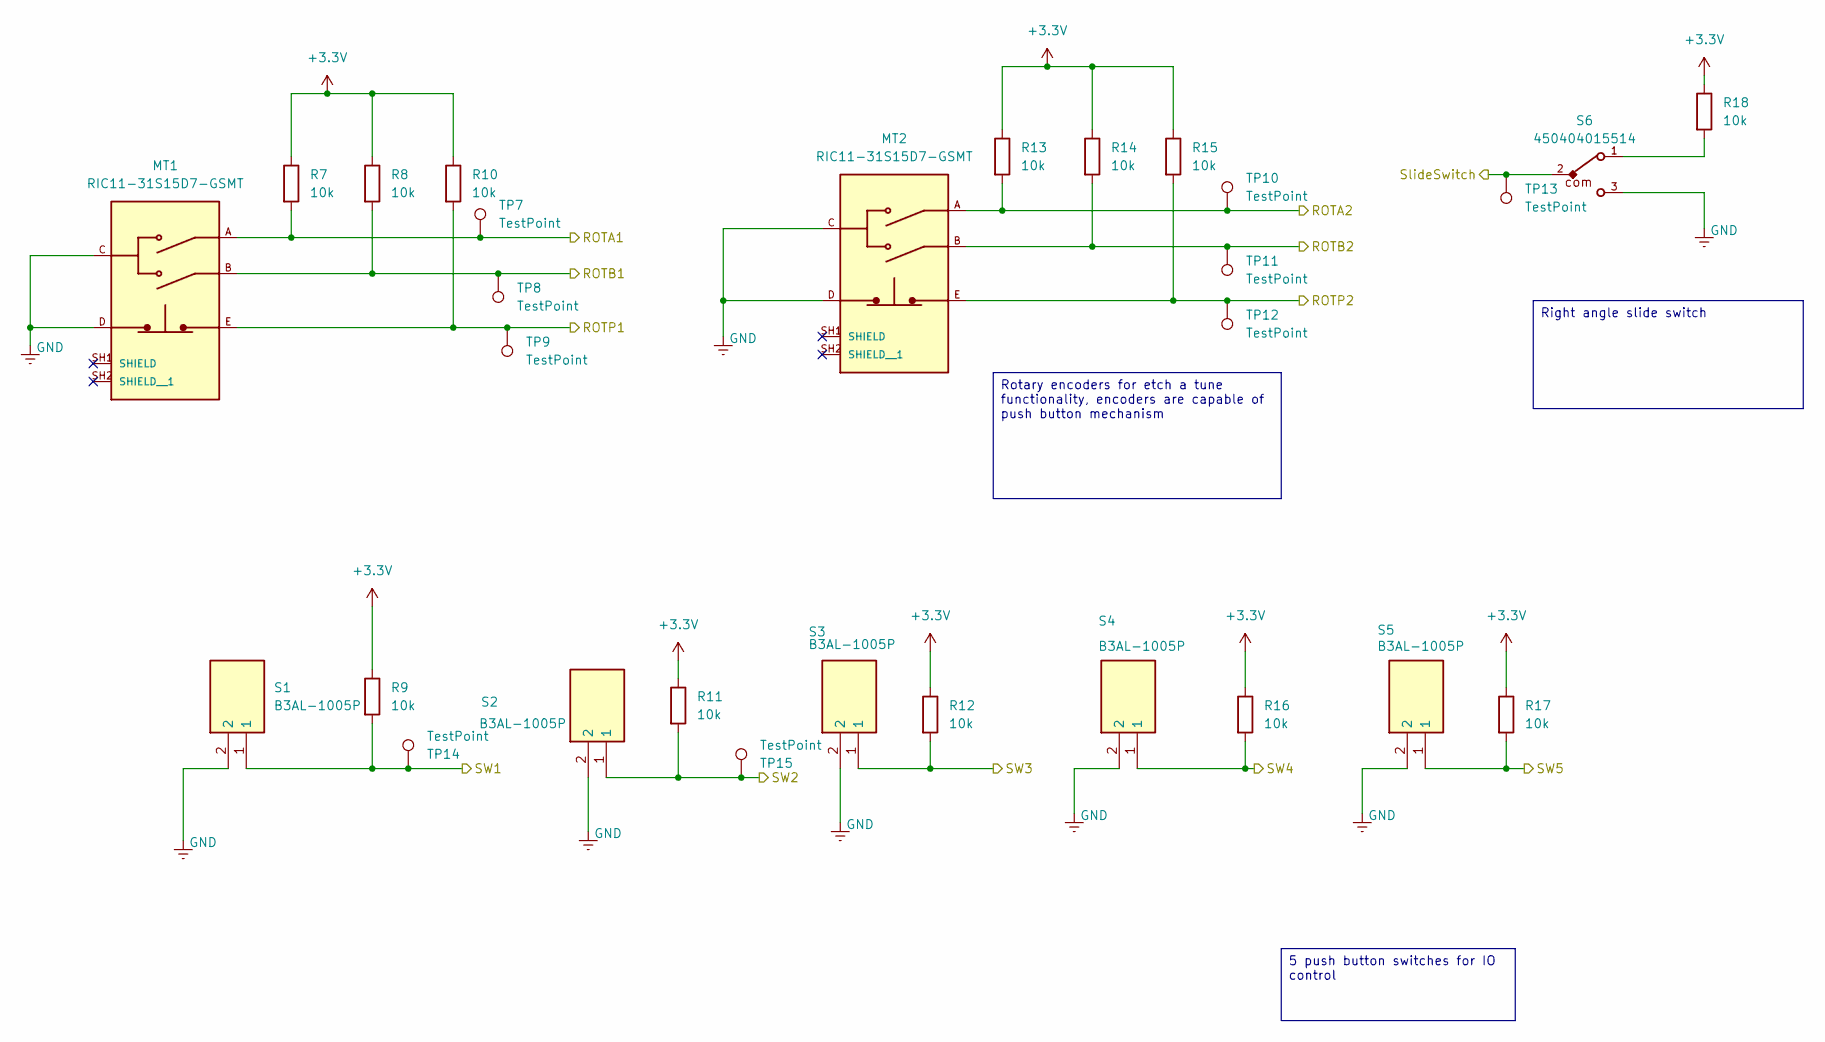
[picture p79: schematic Controllers.kicad_sch]

Parts:
MT1, MT2: RIC11-31S15D7-GSMT; XDCR_RIC11-31S15D7-GSMT; PARTREV 1.01
R7, R8, R9, R10, R11, R12, R13, R14, R15, R16, R17, R18: 10k; R_0603_1608Metric
S1, S2, S3, S4, S5: B3AL-1005P; B3AL1005P; Mouser Part Number 653-B3AL-1005P
S6: 450404015514
TP7, TP8, TP9, TP10, TP11, TP12, TP13, TP14, TP15: TestPoint; TestPoint_Pad_D1.0mm

Connections:
+3.3V: R7.1, R8.1, R9.1, R10.1, R11.1, R12.1, R13.1, R14.1, R15.1, R16.1, R17.1, R18.1; also elsewhere on the board
/Controllers/ROTA1: MT1.A, R7.2, TP7.1; also elsewhere on the board
/Controllers/ROTA2: MT2.A, R13.2, TP10.1; also elsewhere on the board
/Controllers/ROTB1: MT1.B, R8.2, TP8.1; also elsewhere on the board
/Controllers/ROTB2: MT2.B, R14.2, TP11.1; also elsewhere on the board
/Controllers/ROTP1: MT1.E, R10.2, TP9.1; also elsewhere on the board
/Controllers/ROTP2: MT2.E, R15.2, TP12.1; also elsewhere on the board
/Controllers/SW1: R9.2, S1.1, TP14.1; also elsewhere on the board
/Controllers/SW2: R11.2, S2.1, TP15.1; also elsewhere on the board
/Controllers/SW3: R12.2, S3.1; also elsewhere on the board
/Controllers/SW4: R16.2, S4.1; also elsewhere on the board
/Controllers/SW5: R17.2, S5.1; also elsewhere on the board
/Controllers/SlideSwitch: S6.2, TP13.1; also elsewhere on the board
GND: MT1.C, MT1.D, MT2.C, MT2.D, S1.2, S2.2, S3.2, S4.2, S5.2, S6.3; also elsewhere on the board
unnamed: R18.2, S6.1

Notes on the sheet:
Right angle slide switch
5 push button switches for IO control
Rotary encoders for etch a tune functionality, encoders are capable of push button mechanism

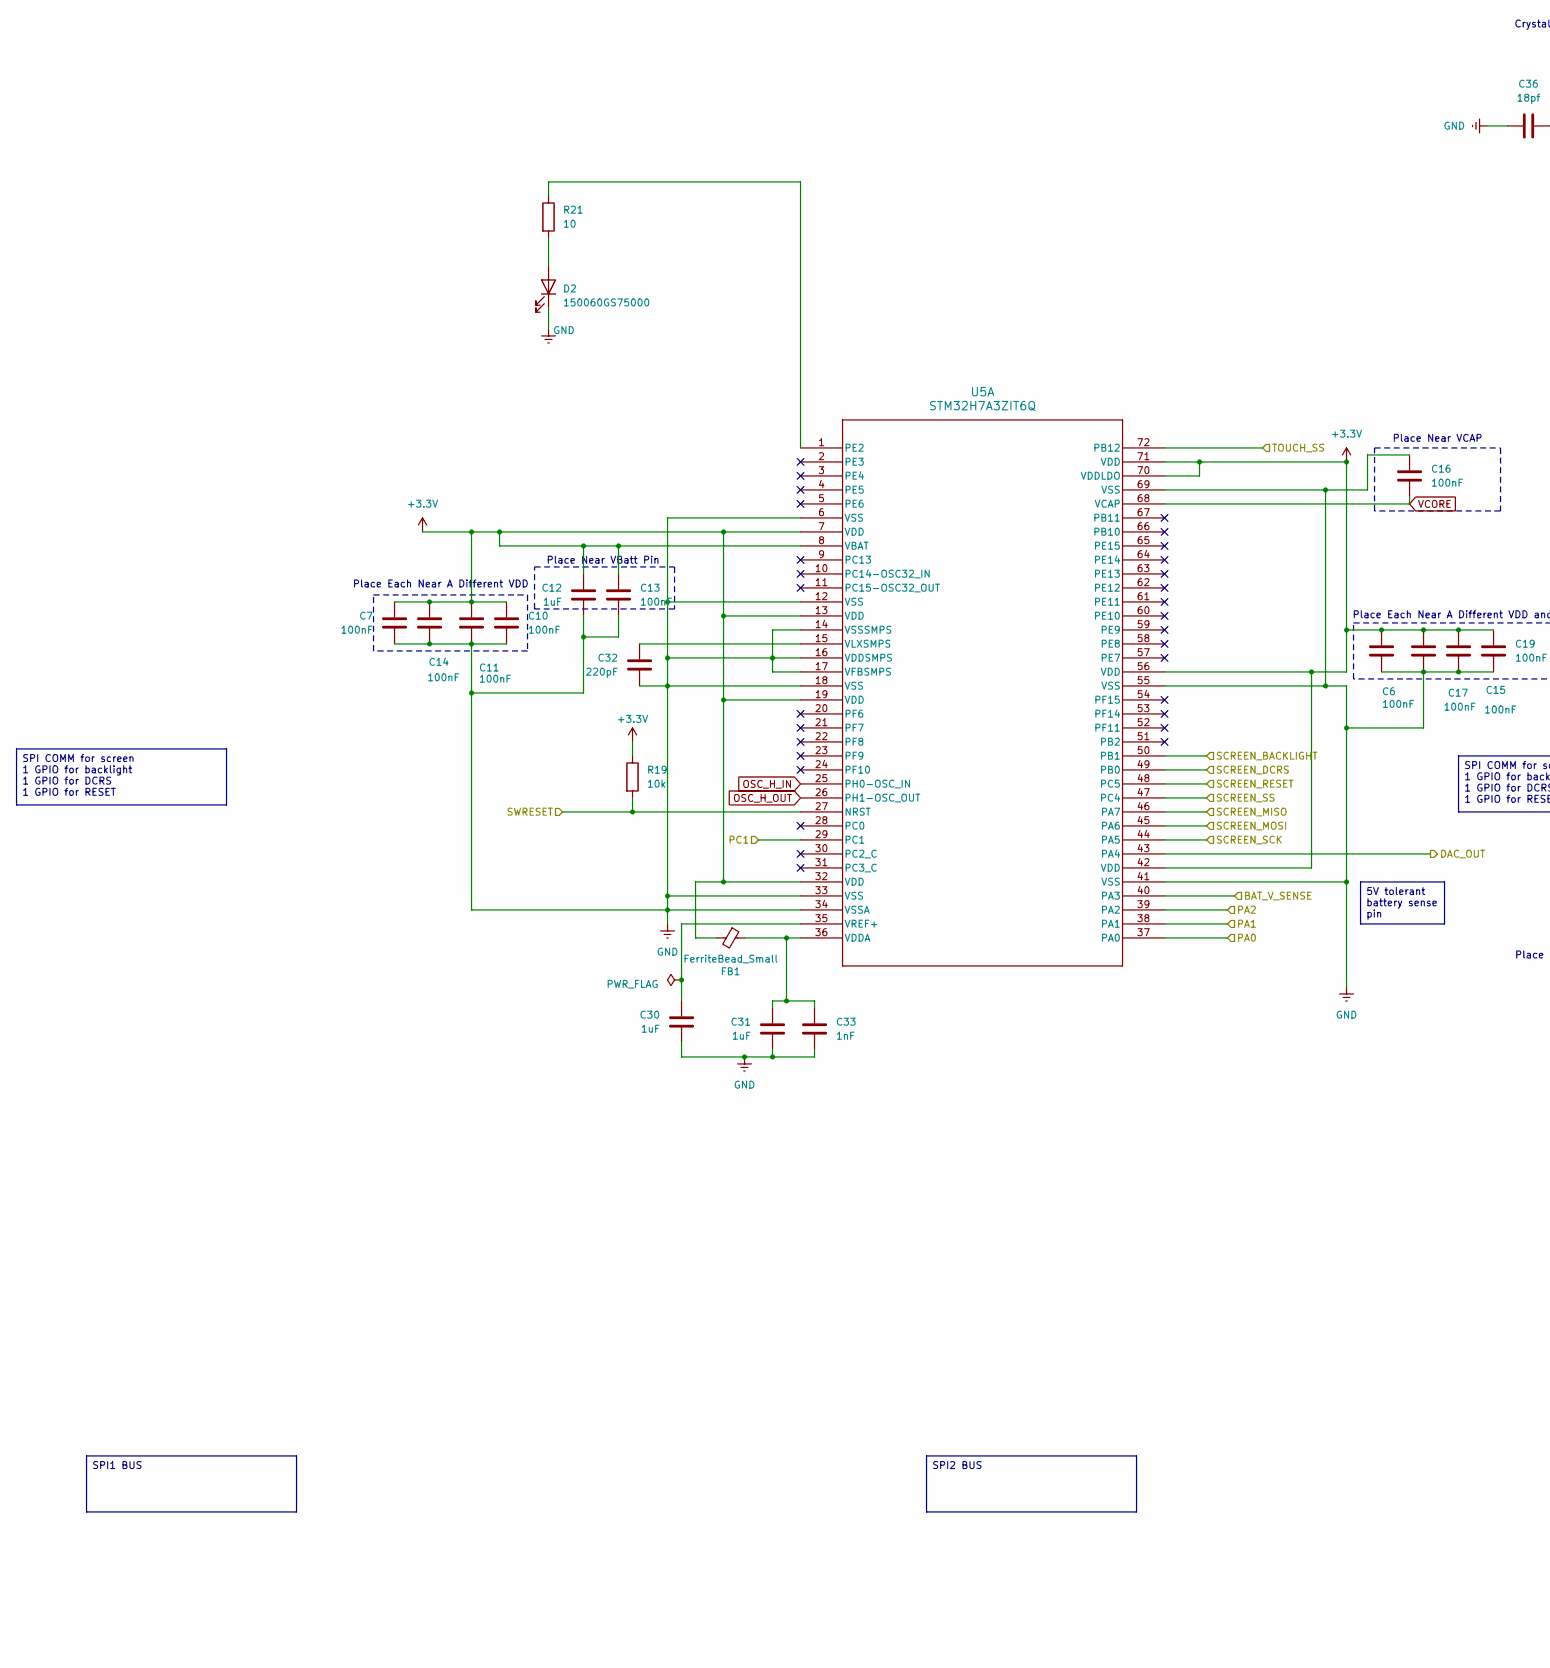
[picture p80: schematic Microcontroller.kicad_sch, part in row 1, column 1]

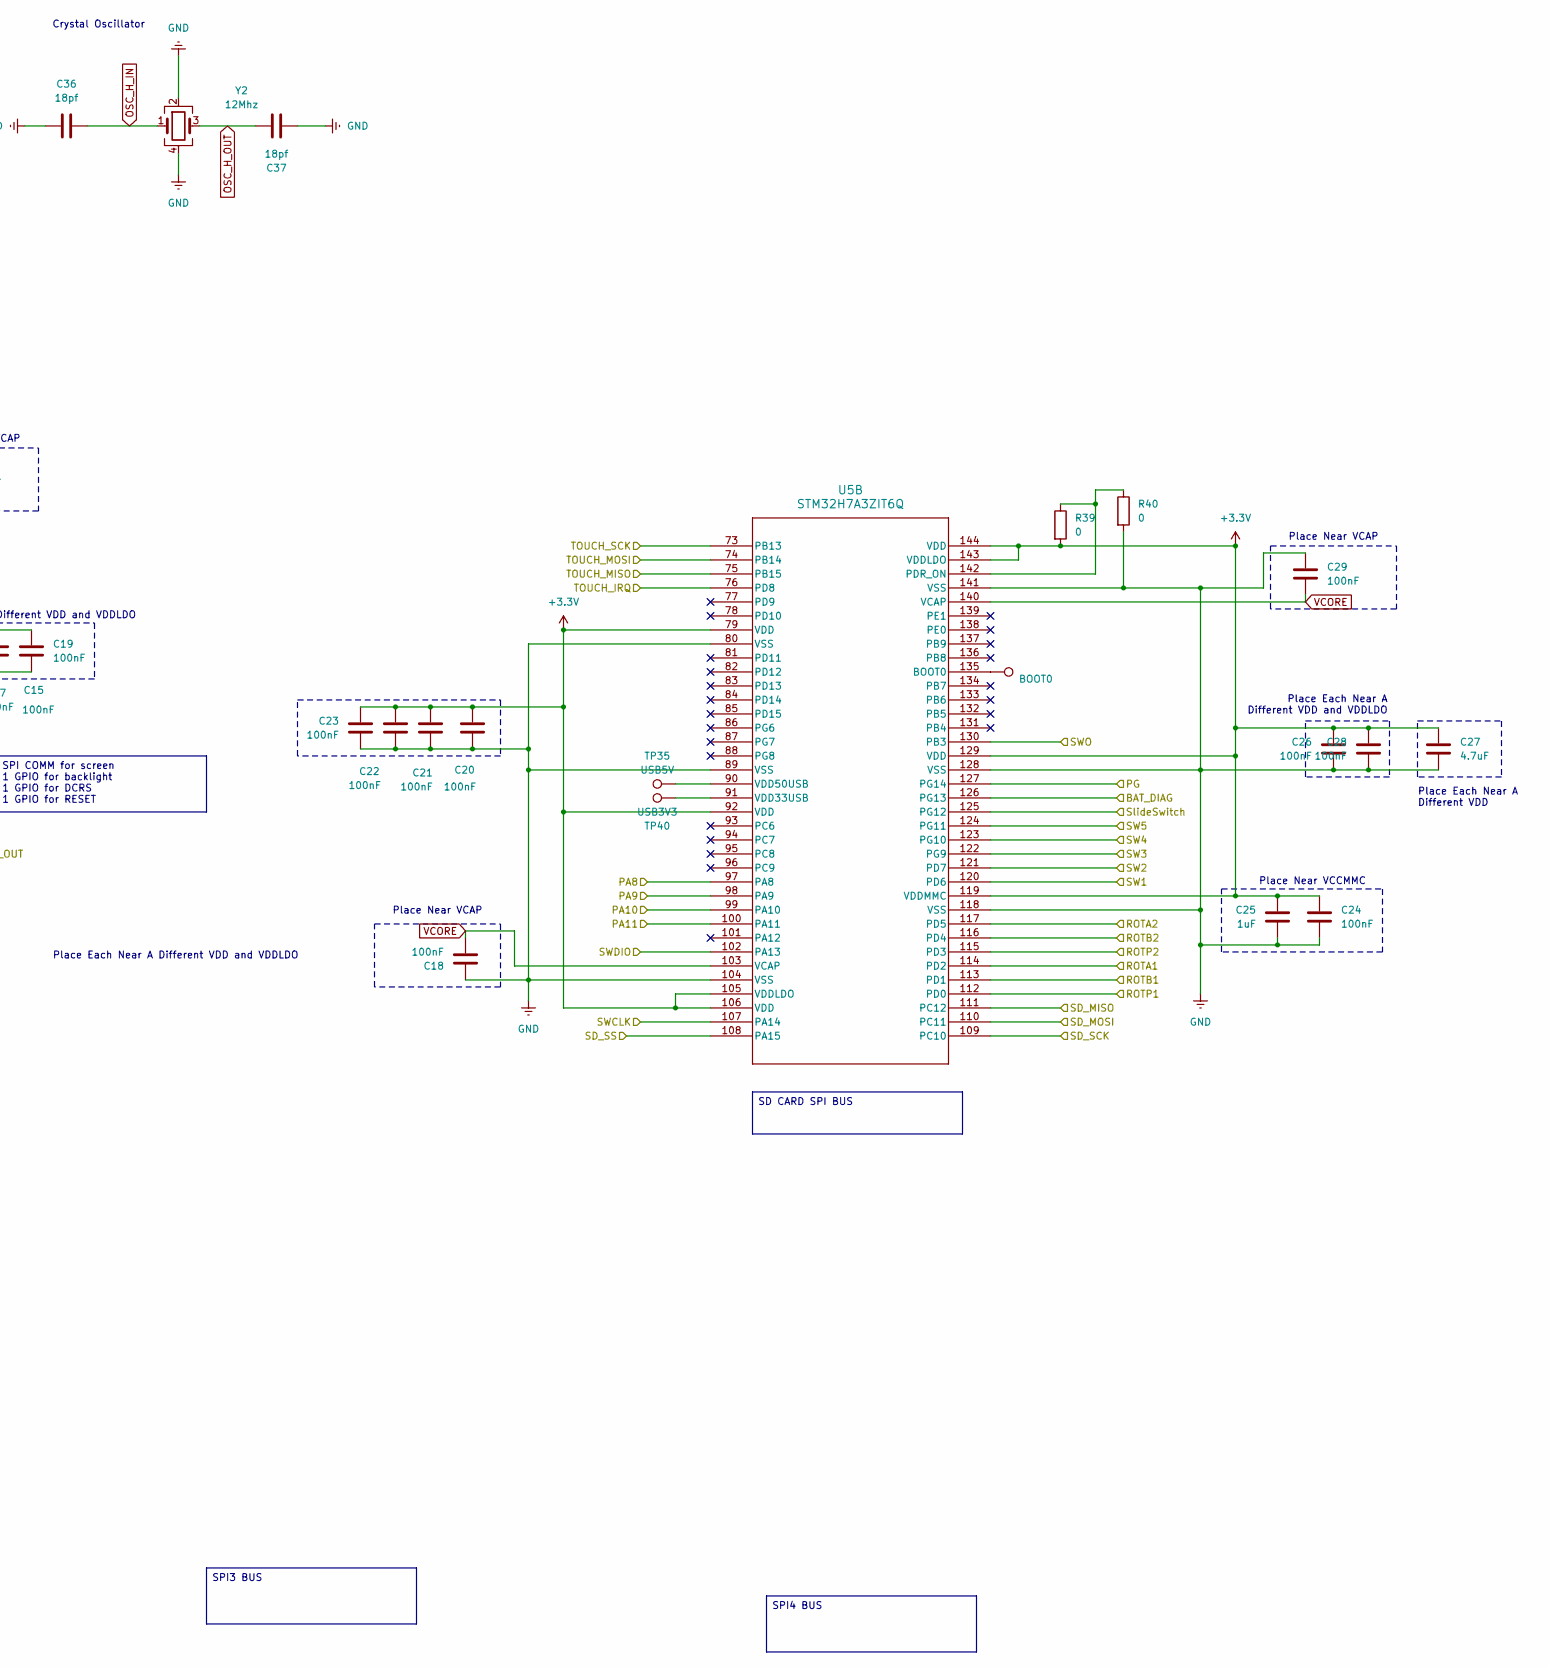
[picture p81: schematic Microcontroller.kicad_sch, part in row 1, column 2]

Parts:
C6, C7, C10, C11, C13, C14, C15, C16, C17, C18, C19, C20, C21, C22, C23, C24, C26, C28, C29: 100nF; C_0603_1608Metric
C12, C25, C30, C31: 1uF; C_0603_1608Metric
C27: 4.7uF; C_0603_1608Metric
C32: 220pF; C_0603_1608Metric
C33: 1nF; C_0603_1608Metric
C36, C37: 18pf; C_0603_1608Metric
D2: 150060GS75000; LED_0603_1608Metric
FB1: FerriteBead_Small; C_0603_1608Metric
R19: 10k; R_0603_1608Metric
R21: 10; R_0603_1608Metric
R39, R40: 0; R_0603_1608Metric
TP35: USB5V; TestPoint_Pad_D1.0mm
TP40: USB3V3; TestPoint_Pad_D1.0mm
TP41: BOOT0; TestPoint_Pad_D1.0mm
U5: STM32H7A3ZIT6Q; LQFP-144-L
Y2: 12Mhz; Crystal_SMD_Abracon_ABM8G-4Pin_3.2x2.5mm

Connections:
+3.3V: C6.1, C7.1, C10.1, C11.1, C12.1, C13.1, C14.1, C15.1, C17.1, C19.1, C20.1, C21.1, C22.1, C23.1, C24.1, C25.1, C26.1, C27.1, C28.1, FB1.2, R19.1, R39.2, U5.7 (VDD), U5.8 (VBAT), U5.13 (VDD), U5.19 (VDD), U5.32 (VDD), U5.42 (VDD), U5.56 (VDD), U5.70 (VDDLDO), U5.71 (VDD), U5.79 (VDD), U5.92 (VDD), U5.105 (VDDLDO), U5.106 (VDD), U5.119 (VDDMMC), U5.129 (VDD), U5.143 (VDDLDO), U5.144 (VDD); also elsewhere on the board
/Battery/BAT_DIAG: U5.126 (PG13); also elsewhere on the board
/Battery/BAT_V_SENSE: U5.40 (PA3); also elsewhere on the board
/Battery/PG: U5.127 (PG14); also elsewhere on the board
/CS: U5.47 (PC4); also elsewhere on the board
/Controllers/ROTA1: U5.114 (PD2); also elsewhere on the board
/Controllers/ROTA2: U5.117 (PD5); also elsewhere on the board
/Controllers/ROTB1: U5.113 (PD1); also elsewhere on the board
/Controllers/ROTB2: U5.116 (PD4); also elsewhere on the board
/Controllers/ROTP1: U5.112 (PD0); also elsewhere on the board
/Controllers/ROTP2: U5.115 (PD3); also elsewhere on the board
/Controllers/SW1: U5.120 (PD6); also elsewhere on the board
/Controllers/SW2: U5.121 (PD7); also elsewhere on the board
/Controllers/SW3: U5.122 (PG9); also elsewhere on the board
/Controllers/SW4: U5.123 (PG10); also elsewhere on the board
/Controllers/SW5: U5.124 (PG11); also elsewhere on the board
/Controllers/SlideSwitch: U5.125 (PG12); also elsewhere on the board
/DC/RS: U5.49 (PB0); also elsewhere on the board
/LED: U5.50 (PB1); also elsewhere on the board
/Microcontroller/DAC_OUT: U5.43 (PA4); also elsewhere on the board
/PA0: U5.37 (PA0); also elsewhere on the board
/PA1: U5.38 (PA1); also elsewhere on the board
/PA2: U5.39 (PA2); also elsewhere on the board
/PA8: U5.97 (PA8); also elsewhere on the board
/PA9: U5.98 (PA9); also elsewhere on the board
/PA10: U5.99 (PA10); also elsewhere on the board
/PA11: U5.100 (PA11); also elsewhere on the board
/PC1: U5.29 (PC1); also elsewhere on the board
/RESET: U5.48 (PC5); also elsewhere on the board
/SCK: U5.44 (PA5); also elsewhere on the board
/SDI (MOSI): U5.46 (PA7); also elsewhere on the board
/SDO(MISO): U5.45 (PA6); also elsewhere on the board
/SD_CS: U5.108 (PA15); also elsewhere on the board
/SD_MISO: U5.111 (PC12); also elsewhere on the board
/SD_MOSI: U5.110 (PC11); also elsewhere on the board
/SD_SCK: U5.109 (PC10); also elsewhere on the board
/SWCLK: U5.107 (PA14); also elsewhere on the board
/SWDIO: U5.102 (PA13); also elsewhere on the board
/SWO: U5.130 (PB3); also elsewhere on the board
/T_CLK: U5.73 (PB13); also elsewhere on the board
/T_CS: U5.72 (PB12); also elsewhere on the board
/T_DIN: U5.75 (PB15); also elsewhere on the board
/T_DO: U5.74 (PB14); also elsewhere on the board
/T_IRQ: U5.76 (PD8); also elsewhere on the board
/nRESET: R19.2, U5.27 (NRST); also elsewhere on the board
GND: C6.2, C7.2, C10.2, C11.2, C12.2, C13.2, C14.2, C15.2, C16.1, C17.2, C18.1, C19.2, C20.2, C21.2, C22.2, C23.2, C24.2, C25.2, C26.2, C27.2, C28.2, C29.1, C30.2, C31.2, C32.2, C33.2, C36.2, C37.2, D2.1 (K), R40.2, U5.6 (VSS), U5.12 (VSS), U5.14 (VSSSMPS), U5.16 (VDDSMPS), U5.17 (VFBSMPS), U5.18 (VSS), U5.33 (VSS), U5.34 (VSSA), U5.41 (VSS), U5.55 (VSS), U5.69 (VSS), U5.80 (VSS), U5.89 (VSS), U5.104 (VSS), U5.118 (VSS), U5.128 (VSS), U5.141 (VSS), Y2.2, Y2.4; also elsewhere on the board
unnamed: D2.2 (A), R21.2
unnamed: R21.1, U5.1 (PE2)
unnamed: C31.1, C33.1, FB1.1, U5.36 (VDDA)
unnamed: C32.1, U5.15 (VLXSMPS)
unnamed: C30.1, U5.35 (VREF+)
unnamed: TP41.1, U5.135 (BOOT0)
unnamed: R39.1, R40.1, U5.142 (PDR_ON)
unnamed: TP40.1, U5.91 (VDD33USB)
unnamed: TP35.1, U5.90 (VDD50USB)
OSC_H_IN: C36.1, U5.25 (PH0-OSC_IN), Y2.1
OSC_H_OUT: C37.1, U5.26 (PH1-OSC_OUT), Y2.3
VCORE: C16.2, C18.2, C29.2, U5.68 (VCAP), U5.103 (VCAP), U5.140 (VCAP)

Notes on the sheet:
Place Each Near A Different VDD and VDDLDO
Place Near VBatt Pin
Place Each Near A Different VDD
Place Each Near A Different VDD and VDDLDO
Crystal Oscillator
Place Near VCAP
Place Near VCCMMC
Place Each Near A Different VDD
SPI COMM for screen 1 GPIO for backlight 1 GPIO for DCRS 1 GPIO for RESET
SPI3 BUS
SD CARD SPI BUS
SPI2 BUS
SPI1 BUS
SPI4 BUS
5V tolerant battery sense pin

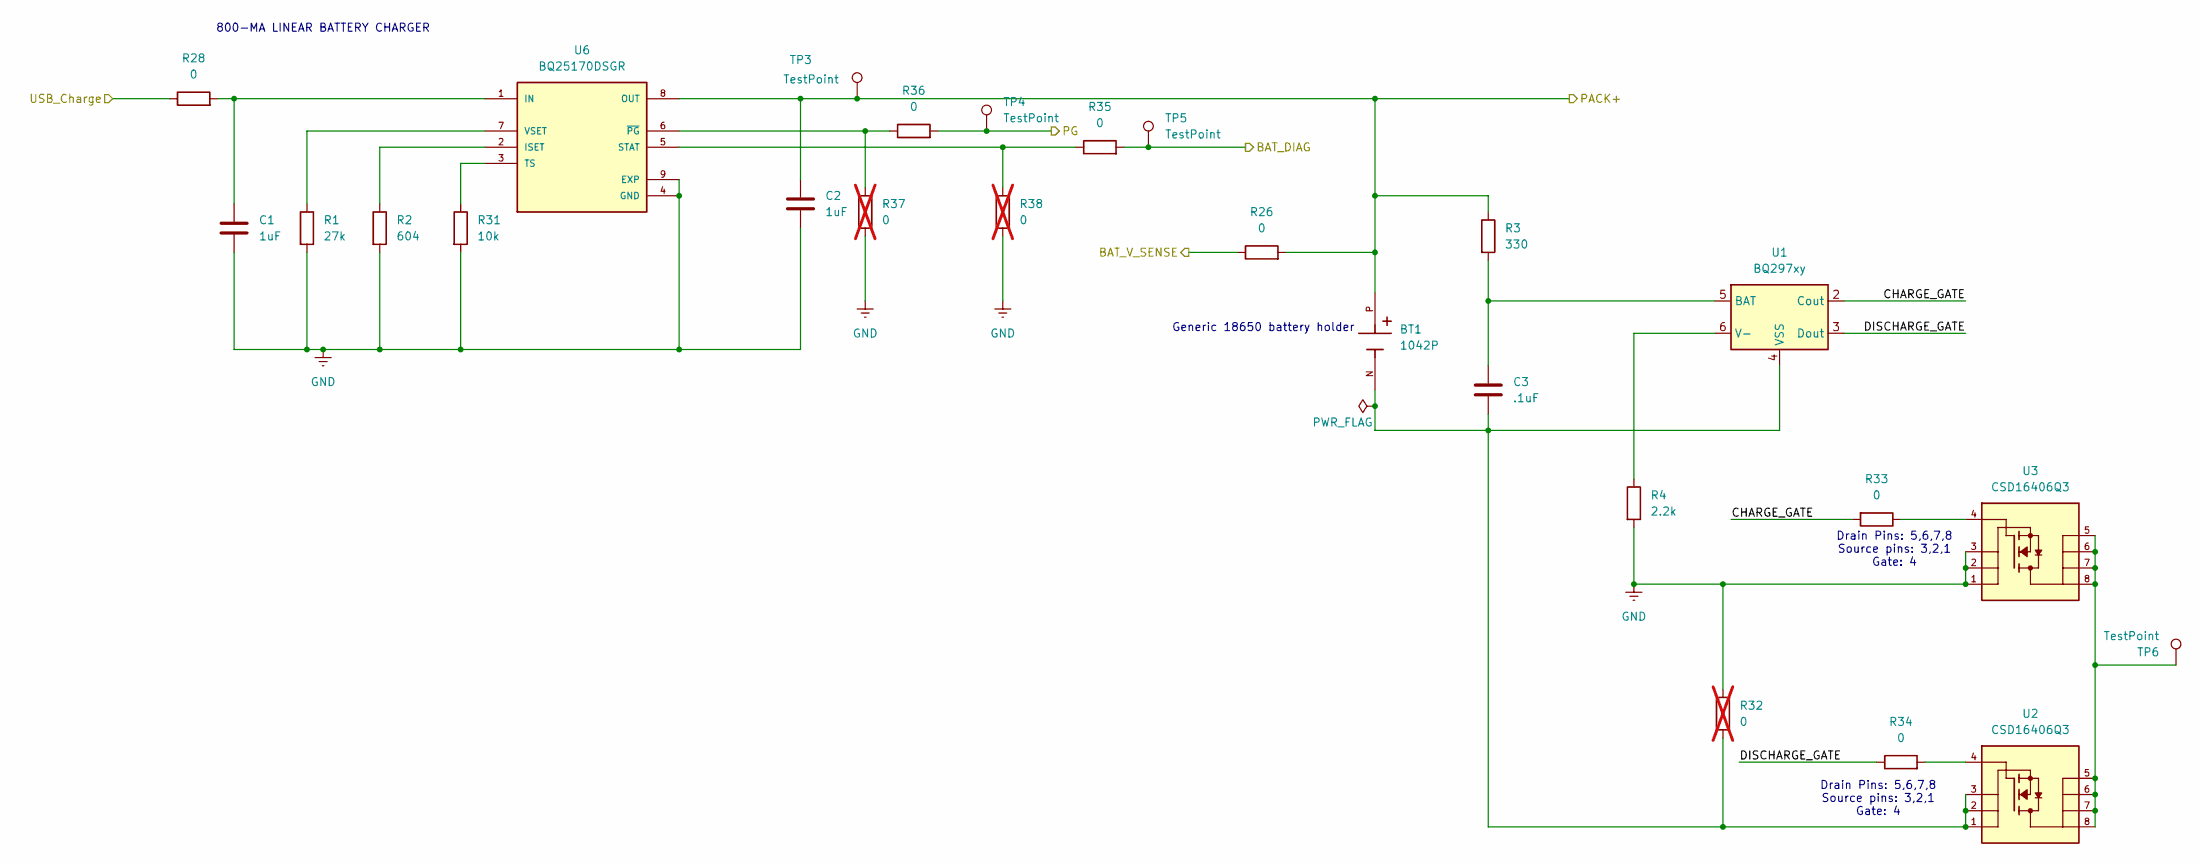
[picture p82: schematic Battery.kicad_sch, Voltage and Current Protection Integrated Circuit for Single]

Parts:
BT1: 1042P; BAT_1042P; PARTREV E
C1, C2: 1uF; C_0603_1608Metric
C3: .1uF; C_0603_1608Metric
R1: 27k; R_0603_1608Metric
R2: 604; R_0603_1608Metric
R3: 330; R_0603_1608Metric
R4: 2.2k; R_0603_1608Metric
R26, R28, R33, R34, R35, R36: 0; R_0603_1608Metric
R31: 10k; R_0603_1608Metric
R32, R37, R38: 0; R_0603_1608Metric; not fitted
TP3, TP4, TP5, TP6: TestPoint; TestPoint_Pad_D1.0mm
U1: BQ297xy; WSON-6_1.5x1.5mm_P0.5mm
U2, U3: CSD16406Q3; TRANS_CSD16406Q3
U6: BQ25170DSGR; SON50P200X200X80-9N; PARTREV A

Connections:
/Battery/BAT_DIAG: R35.2, TP5.1; also elsewhere on the board
/Battery/BAT_V_SENSE: R26.1; also elsewhere on the board
/Battery/CHARGE_GATE: R33.2, U1.2 (Cout)
/Battery/DISCHARGE_GATE: R34.1, U1.3 (Dout)
/Battery/PACK+: BT1.P, C2.1, R3.1, R26.2, TP3.1, U6.8 (OUT); also elsewhere on the board
/Battery/PG: R36.2, TP4.1; also elsewhere on the board
/Battery/USB_Charge: R28.1; also elsewhere on the board
GND: C1.2, C2.2, R1.2, R2.2, R4.2, R31.2, R32.2, R37.1, R38.1, U3.1, U3.2, U3.3, U6.4 (GND), U6.9 (EXP), U6.10, U6.11; also elsewhere on the board
unnamed: R33.1, U3.4
unnamed: R34.2, U2.4
unnamed: TP6.1, U2.5, U2.6, U2.7, U2.8, U3.5, U3.6, U3.7, U3.8
unnamed: C3.1, R3.2, U1.5 (BAT)
unnamed: R4.1, U1.6 (V-)
unnamed: BT1.N, C3.2, R32.1, U1.4 (VSS), U2.1, U2.2, U2.3
unnamed: C1.1, R28.2, U6.1 (IN)
unnamed: R2.1, U6.2 (ISET)
unnamed: R35.1, R38.2, U6.5 (STAT)
unnamed: R31.1, U6.3 (TS)
unnamed: R1.1, U6.7 (VSET)
unnamed: R36.1, R37.2, U6.6 (~PG)

Notes on the sheet:
800-MA LINEAR BATTERY CHARGER
Generic 18650 battery holder
Drain Pins: 5,6,7,8 Source pins: 3,2,1 Gate: 4

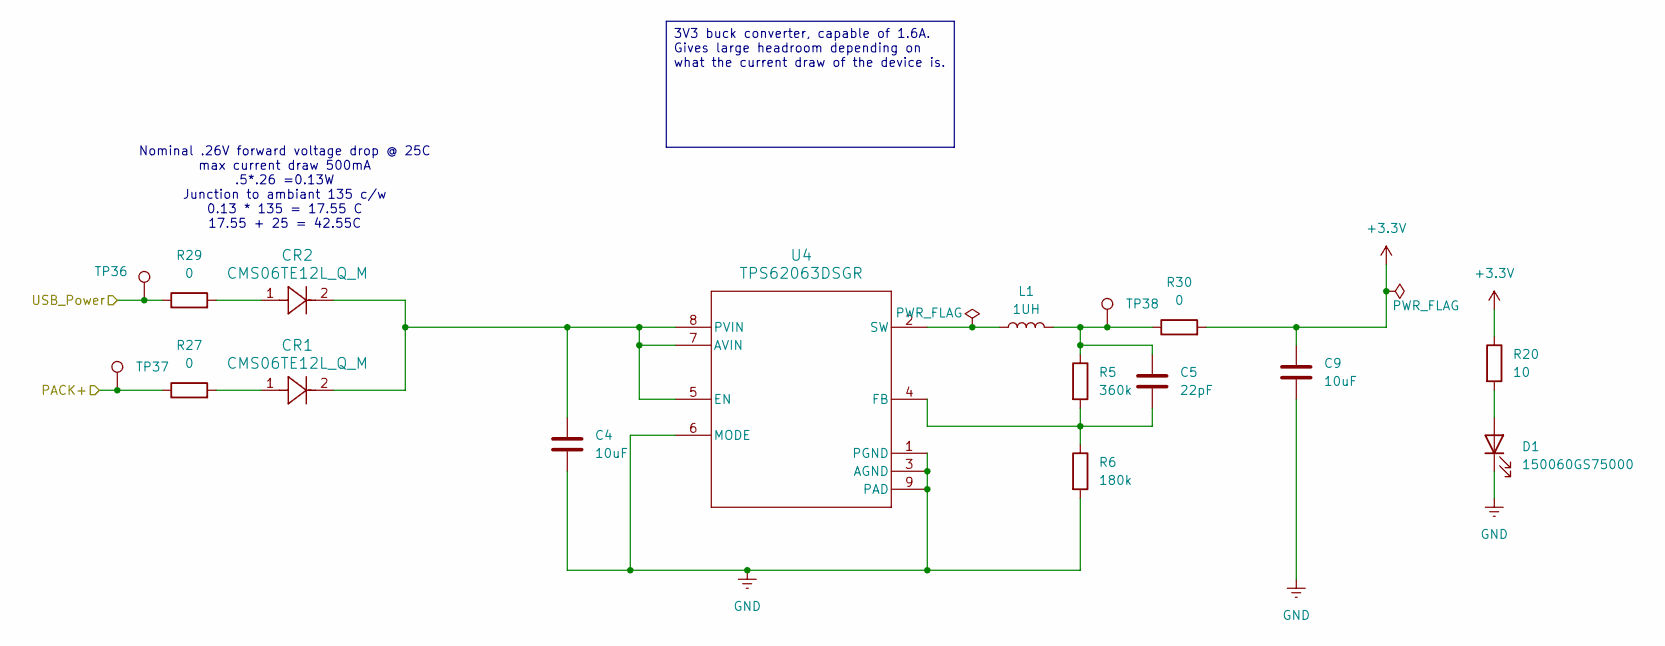
[picture p83: schematic Power.kicad_sch]

Parts:
C4, C9: 10uF; C_0603_1608Metric
C5: 22pF; C_0603_1608Metric
CR1, CR2: CMS06TE12L_Q_M; M-FLAT_TOS-L
D1: 150060GS75000; LED_0603_1608Metric
L1: 1UH; L_1210_3225Metric
R5: 360k; R_0603_1608Metric
R6: 180k; R_0603_1608Metric
R20: 10; R_0603_1608Metric
R27, R29, R30: 0; R_0603_1608Metric
TP36, TP37, TP38: TestPoint; TestPoint_Pad_D1.0mm
U4: TPS62063DSGR; DSG0008A

Connections:
+3.3V: C9.1, R20.1, R30.2; also elsewhere on the board
/Battery/PACK+: R27.1, TP37.1; also elsewhere on the board
/Battery/USB_Charge: R29.1, TP36.1; also elsewhere on the board
GND: C4.2, C9.2, D1.1 (K), R6.2, U4.1 (PGND), U4.3 (AGND), U4.6 (MODE), U4.9 (PAD), U4.GND; also elsewhere on the board
unnamed: C5.1, L1.2, R5.1, R30.1, TP38.1
unnamed: CR1.1, R27.2
unnamed: CR2.1, R29.2
unnamed: D1.2 (A), R20.2
unnamed: C4.1, CR1.2, CR2.2, U4.5 (EN), U4.7 (AVIN), U4.8 (PVIN)
unnamed: C5.2, R5.2, R6.1, U4.4 (FB)
unnamed: L1.1, U4.2 (SW)

Notes on the sheet:
Nominal .26V forward voltage drop @ 25C max current draw 500mA .5*.26 =0.13W Junction to ambiant 135 c/w 0.13 * 135 = 17.55 C 17.55 + 25 = 42.55C
3V3 buck converter, capable of 1.6A. Gives large headroom depending on what the current draw of the device is.
