CullenSharp/Etch-A-Tune/Etch_A_Tune/Etch_A_Tune.kicad_pcb

## KiCad design Etch_A_Tune/Etch_A_Tune.kicad_pcb (continued)

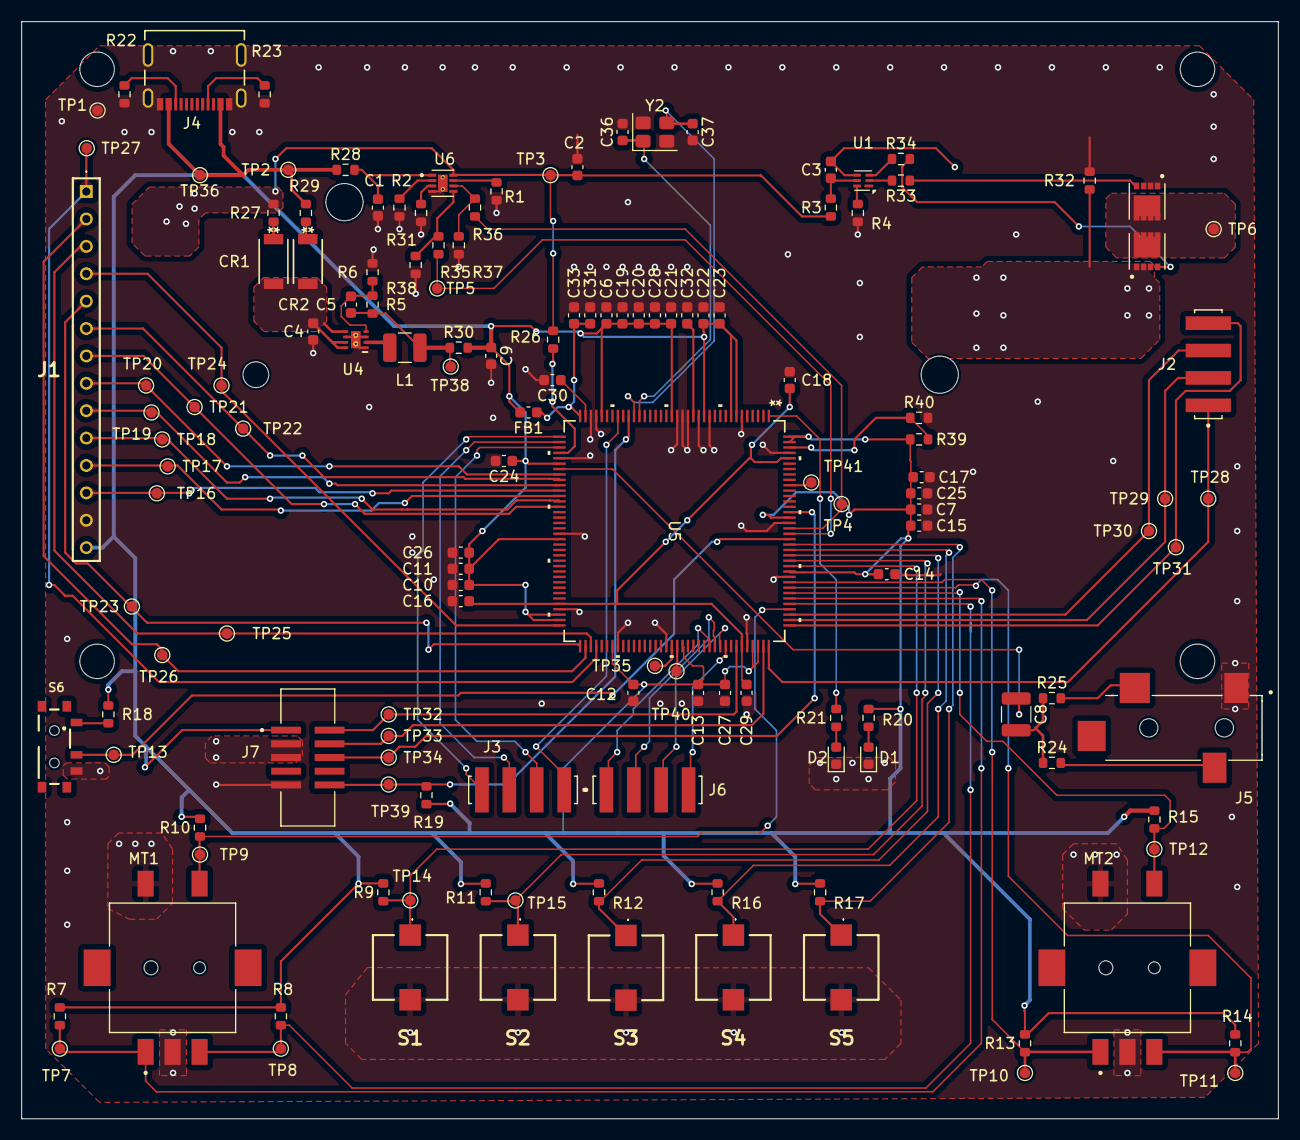
[picture p84: board Etch_A_Tune.kicad_pcb from above]

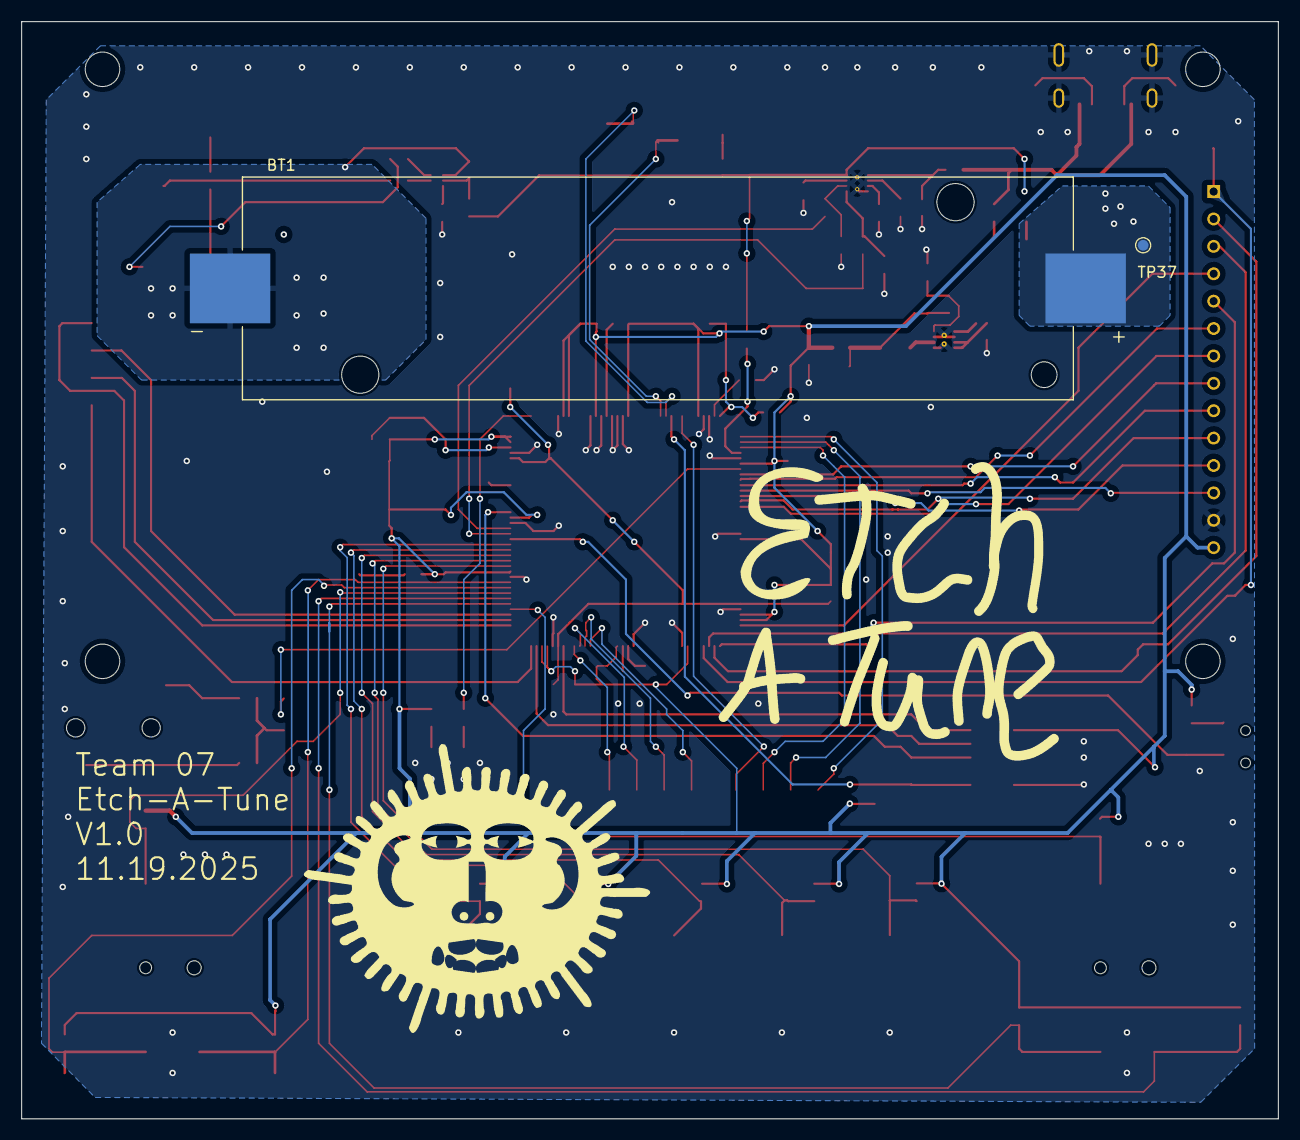
[picture p85: board Etch_A_Tune.kicad_pcb from below]

Board: 2 copper layers, 116.5 x 101.7 mm, 145 parts (2 on the bottom side), 87 nets.
