CullenSharp/Etch-A-Tune/SPI_screen/Core/Src/main.c

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
/* Includes ------------------------------------------------------------------*/
#include "main.h"
#include "cmsis_os.h"

/* USER CODE BEGIN Includes */
#include <string.h>
#include "Lcd/ts.h"
#include "Lcd/ili9341.h"
#include "Lcd/stm32_adafruit_lcd.h"
#include "Encoder/encoder.h"

/* USER CODE END Includes */

typedef StaticTask_t osStaticThreadDef_t;
ADC_HandleTypeDef hadc1;

DAC_HandleTypeDef hdac1;

TIM_HandleTypeDef htim6;
TIM_HandleTypeDef htim13;

/* Definitions for touch_io */
osThreadId_t touch_ioHandle;
uint32_t touch_ioBuffer[ 128 ];
osStaticThreadDef_t touch_ioControlBlock;
const osThreadAttr_t touch_io_attributes = {
  .name = "touch_io",
  .cb_mem = &touch_ioControlBlock,
  .cb_size = sizeof(touch_ioControlBlock),
  .stack_mem = &touch_ioBuffer[0],
  .stack_size = sizeof(touch_ioBuffer),
  .priority = (osPriority_t) osPriorityNormal,
};
/* Definitions for lcd_display */
osThreadId_t lcd_displayHandle;
uint32_t lcd_displayBuffer[ 128 ];
osStaticThreadDef_t lcd_displayControlBlock;
const osThreadAttr_t lcd_display_attributes = {
  .name = "lcd_display",
  .cb_mem = &lcd_displayControlBlock,
  .cb_size = sizeof(lcd_displayControlBlock),
  .stack_mem = &lcd_displayBuffer[0],
  .stack_size = sizeof(lcd_displayBuffer),
  .priority = (osPriority_t) osPriorityBelowNormal7,
};
/* USER CODE BEGIN PV */
extern GRTS_Drv *ts_drv;
TS_Point p;
uint32_t x, y;

uint16_t write_buffer[ILI9341_LCD_PIXEL_WIDTH * ILI9341_LCD_PIXEL_HEIGHT];
uint16_t draw_buffer[ILI9341_LCD_PIXEL_WIDTH * ILI9341_LCD_PIXEL_HEIGHT];

uint16_t *write_to = write_buffer;
uint16_t *draw_from = draw_buffer;

extern Rotary_Encoder encoders[2];
/* USER CODE END PV */

void SystemClock_Config(void);
static void MPU_Config(void);
static void MX_GPIO_Init(void);
static void MX_TIM6_Init(void);
static void MX_DAC1_Init(void);
static void MX_ADC1_Init(void);
static void MX_TIM13_Init(void);
void start_touch_io(void *argument);
void start_lcd_display(void *argument);

/* USER CODE BEGIN 0 */
static inline uint32_t map(uint32_t x, uint32_t in_min, uint32_t in_max,
		uint32_t out_min, uint32_t out_max) {
	return (x - in_min) * (out_max - out_min) / (in_max - in_min) + out_min;
}
/* USER CODE END 0 */

/**
  * @brief  The application entry point.
  * @retval int
  */
int main(void)
{

  /* MPU Configuration--------------------------------------------------------*/
  MPU_Config();

  /* MCU Configuration--------------------------------------------------------*/

  /* Reset of all peripherals, Initializes the Flash interface and the Systick. */
  HAL_Init();

  /* Configure the system clock */
  SystemClock_Config();

  /* Initialize all configured peripherals */
  MX_GPIO_Init();
  MX_TIM6_Init();
  MX_DAC1_Init();
  MX_ADC1_Init();
  MX_TIM13_Init();
  /* USER CODE BEGIN 2 */
	HAL_Delay(300);
	BSP_LCD_Init();
	BSP_LCD_Clear(LCD_COLOR_BLACK);
  /* USER CODE END 2 */

  /* Init scheduler */
  osKernelInitialize();

  /* USER CODE BEGIN RTOS_MUTEX */
	/* add mutexes, ... */
  /* USER CODE END RTOS_MUTEX */

  /* USER CODE BEGIN RTOS_SEMAPHORES */
	/* add semaphores, ... */
  /* USER CODE END RTOS_SEMAPHORES */

  /* USER CODE BEGIN RTOS_TIMERS */
	/* start timers, add new ones, ... */
  /* USER CODE END RTOS_TIMERS */

  /* USER CODE BEGIN RTOS_QUEUES */
	/* add queues, ... */
  /* USER CODE END RTOS_QUEUES */

  /* Create the thread(s) */
  /* creation of touch_io */
  touch_ioHandle = osThreadNew(start_touch_io, NULL, &touch_io_attributes);

  /* creation of lcd_display */
  lcd_displayHandle = osThreadNew(start_lcd_display, NULL, &lcd_display_attributes);

  /* USER CODE BEGIN RTOS_THREADS */
	/* add threads, ... */
//  osThreadSuspend(touch_ioHandle);
//  osThreadSuspend(lcd_displayHandle);
  /* USER CODE END RTOS_THREADS */

  /* USER CODE BEGIN RTOS_EVENTS */
	/* add events, ... */
  /* USER CODE END RTOS_EVENTS */

  /* Start scheduler */
  osKernelStart();

  /* We should never get here as control is now taken by the scheduler */

  /* Infinite loop */
  /* USER CODE BEGIN WHILE */
	while (1) {
    /* USER CODE END WHILE */

    /* USER CODE BEGIN 3 */
	}
  /* USER CODE END 3 */
}

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
/* USER CODE BEGIN 4 */
void HAL_GPIO_EXTI_Callback(uint16_t GPIO_Pin)
{
	// Todo: write mode switch logic
	if (GPIO_Pin == SLIDE_SW_Pin) {
		__NOP();
	}

	if ((GPIO_Pin == ROTA1_Pin) || (GPIO_Pin == ROTB1_Pin)) {
		encoders[0].irq_handler(&encoders[0]);
	}
}
/* USER CODE END 4 */

/* USER CODE BEGIN Header_start_touch_io */
/**
 * @brief  Function implementing the touch_io thread.
 * @param  argument: Not used
 * @retval None
 */
/* USER CODE END Header_start_touch_io */
void start_touch_io(void *argument)
{
  /* USER CODE BEGIN 5 */
	/* Infinite loop */
	for (;;) {
		p = ts_drv->Get_Point();

		if (p.z < 5000) {
			if ((p.x < MIN_X) || (p.x > MAX_X)) {
				__NOP();
			}
			else if ((p.y < MIN_Y) || (p.y > MAX_Y)) {
				__NOP();
			} else {
				x = map(p.x, MIN_X, MAX_X, 0, ILI9341_LCD_PIXEL_HEIGHT);
				y = map(p.y, MIN_Y, MAX_Y, 0, ILI9341_LCD_PIXEL_WIDTH);

				// draw pixel to the buffer
				write_to[x + ILI9341_LCD_PIXEL_WIDTH * y] = 0x7E0;
			}
		}
		osDelay(TOUCH_IO_REFRESH_RATE);
	}
  /* USER CODE END 5 */
}

/* USER CODE BEGIN Header_start_lcd_display */
/**
 * @brief Function implementing the lcd_display thread.
 * @param argument: Not used
 * @retval None
 */
/* USER CODE END Header_start_lcd_display */
void start_lcd_display(void *argument)
{
  /* USER CODE BEGIN start_lcd_display */
	/* Infinite loop */
	for (;;) {
		BSP_LCD_DrawRGB16Image(0, 0, ILI9341_LCD_PIXEL_WIDTH,
				ILI9341_LCD_PIXEL_HEIGHT, draw_from);
	}
  /* USER CODE END start_lcd_display */
}

 /* MPU Configuration */

void MPU_Config(void)
{
  MPU_Region_InitTypeDef MPU_InitStruct = {0};

  /* Disables the MPU */
  HAL_MPU_Disable();

  /** Initializes and configures the Region and the memory to be protected
  */
  MPU_InitStruct.Enable = MPU_REGION_ENABLE;
  MPU_InitStruct.Number = MPU_REGION_NUMBER0;
  MPU_InitStruct.BaseAddress = 0x0;
  MPU_InitStruct.Size = MPU_REGION_SIZE_4GB;
  MPU_InitStruct.SubRegionDisable = 0x87;
  MPU_InitStruct.TypeExtField = MPU_TEX_LEVEL0;
  MPU_InitStruct.AccessPermission = MPU_REGION_NO_ACCESS;
  MPU_InitStruct.DisableExec = MPU_INSTRUCTION_ACCESS_DISABLE;
  MPU_InitStruct.IsShareable = MPU_ACCESS_SHAREABLE;
  MPU_InitStruct.IsCacheable = MPU_ACCESS_NOT_CACHEABLE;
  MPU_InitStruct.IsBufferable = MPU_ACCESS_NOT_BUFFERABLE;

  HAL_MPU_ConfigRegion(&MPU_InitStruct);
  /* Enables the MPU */
  HAL_MPU_Enable(MPU_PRIVILEGED_DEFAULT);

}

/**
  * @brief  Period elapsed callback in non blocking mode
  * @note   This function is called  when TIM12 interrupt took place, inside
  * HAL_TIM_IRQHandler(). It makes a direct call to HAL_IncTick() to increment
  * a global variable "uwTick" used as application time base.
  * @param  htim : TIM handle
  * @retval None
  */
void HAL_TIM_PeriodElapsedCallback(TIM_HandleTypeDef *htim)
{
  if (htim->Instance == TIM12)
  {
    HAL_IncTick();
  }
}

/**
  * @brief  This function is executed in case of error occurrence.
  * @retval None
  */
void Error_Handler(void)
{
  /* USER CODE BEGIN Error_Handler_Debug */
	/* User can add his own implementation to report the HAL error return state */
	__disable_irq();
	while (1) {
	}
  /* USER CODE END Error_Handler_Debug */
}
#ifdef USE_FULL_ASSERT
/**
  * @brief  Reports the name of the source file and the source line number
  *         where the assert_param error has occurred.
  * @param  file: pointer to the source file name
  * @param  line: assert_param error line source number
  * @retval None
  */
void assert_failed(uint8_t *file, uint32_t line)
{
  /* USER CODE BEGIN 6 */
  /* User can add his own implementation to report the file name and line number,
     ex: printf("Wrong parameters value: file %s on line %d\r\n", file, line) */
  /* USER CODE END 6 */
}
#endif /* USE_FULL_ASSERT */
