CullenSharp/Etch-A-Tune/SPI_screen/SPI_screen.ioc

Mcu.UserName=STM32H7A3ZITxQ
PA0.GPIO_Label=XP
PA0.Signal=GPIO_Output
PA1.GPIO_Label=YP
PA1.Signal=SharedAnalog_PA1
PA13.Signal=DEBUG_JTMS-SWDIO
PA14.Signal=DEBUG_JTCK-SWCLK
PA2.GPIO_Label=XM
PA2.Signal=ADCx_INP14
PA3.GPIO_Label=BAT_V_SENSE
PA3.Signal=ADC1_INP15
PA4.GPIO_Label=AUDIO_OUT
PA4.Signal=COMP_DAC11_group
PA5.GPIO_Label=LCD_RD
PA5.Signal=GPIO_Output
PA6.GPIO_Label=LCD_D0
PA6.Signal=GPIO_Output
PA7.GPIO_Label=LCD_WR
PA7.Signal=GPIO_Output
PA8.GPIO_Label=LCD_D6
PA8.Signal=GPIO_Output
PA9.GPIO_Label=LCD_D7
PA9.Signal=GPIO_Output
PB0.GPIO_Label=LCD_RS
PB0.Signal=GPIO_Output
PB1.GPIO_Label=LCD_BL
PB1.Signal=GPIO_Output
PB12.GPIO_Label=LCD_D2
PB12.Signal=GPIO_Output
PB13.GPIO_Label=LCD_D1
PB13.Signal=GPIO_Output
PB14.GPIO_Label=LCD_D4
PB14.Signal=GPIO_Output
PB15.GPIO_Label=LCD_D3
PB15.Signal=GPIO_Output
PC1.GPIO_Label=YM
PC1.Signal=GPIO_Output
PC14-OSC32_IN.GPIO_Label=OSC32_IN
PC14-OSC32_IN.Signal=RCC_OSC32_IN
PC15-OSC32_OUT.GPIO_Label=OSC32_OUT
PC15-OSC32_OUT.Signal=RCC_OSC32_OUT
PC4.GPIO_Label=LCD_CS
PC4.Signal=GPIO_Output
PC5.GPIO_Label=LCD_RST
PC5.Signal=GPIO_Output
PD0.GPIO_Label=ROTP1
PD0.Signal=GPIO_Input
PD1.GPIO_Label=ROTA1
PD1.Signal=GPXTI1
PD2.GPIO_Label=ROTB1
PD2.Signal=GPXTI2
PD3.GPIO_Label=ROTP2
PD3.Signal=GPIO_Input
PD4.GPIO_Label=ROTB2
PD4.Signal=GPIO_Input
PD5.GPIO_Label=ROTA2
PD5.Signal=GPIO_Input
PD6.GPIO_Label=SW1
PD6.Signal=GPIO_Input
PD7.GPIO_Label=SW2
PD7.Signal=GPIO_Input
PD8.GPIO_Label=LCD_D5
PD8.Signal=GPIO_Output
PD9.Signal=USART3_RX
PE2.GPIO_Label=LED
PE2.Signal=GPIO_Output
PE4.GPIO_Label=TS_CS
PE4.Signal=GPIO_Output
PG10.GPIO_Label=SW3
PG10.Signal=GPIO_Input
PG11.GPIO_Label=SW5
PG11.Signal=GPIO_Input
PG12.GPIO_Label=SLIDE_SW
PG12.Signal=GPXTI12
PG13.GPIO_Label=BAT_DIAG
PG13.Signal=GPIO_Input
PG14.GPIO_Label=POWER_GOOD
PG14.Signal=GPIO_Input
PG9.GPIO_Label=SW3
PG9.Signal=GPIO_Input
PH0-OSC_IN.GPIO_Label=PH0-MCU
PH0-OSC_IN.Signal=RCC_OSC_IN
PH1-OSC_OUT.GPIO_Label=PH1-MCU
PH1-OSC_OUT.Signal=RCC_OSC_OUT
