CullenSharp/Etch-A-Tune/SPI_screen/Core/Inc/main.h

#define TOUCH_IO_REFRESH_RATE 10
#define LED_Pin GPIO_PIN_2
#define LED_GPIO_Port GPIOE
#define TS_CS_Pin GPIO_PIN_4
#define TS_CS_GPIO_Port GPIOE
#define OSC32_IN_Pin GPIO_PIN_14
#define OSC32_IN_GPIO_Port GPIOC
#define OSC32_OUT_Pin GPIO_PIN_15
#define OSC32_OUT_GPIO_Port GPIOC
#define PH0_MCU_Pin GPIO_PIN_0
#define PH0_MCU_GPIO_Port GPIOH
#define PH1_MCU_Pin GPIO_PIN_1
#define PH1_MCU_GPIO_Port GPIOH
#define YM_Pin GPIO_PIN_1
#define YM_GPIO_Port GPIOC
#define XP_Pin GPIO_PIN_0
#define XP_GPIO_Port GPIOA
#define YP_Pin GPIO_PIN_1
#define YP_GPIO_Port GPIOA
#define XM_Pin GPIO_PIN_2
#define XM_GPIO_Port GPIOA
#define BAT_V_SENSE_Pin GPIO_PIN_3
#define BAT_V_SENSE_GPIO_Port GPIOA
#define AUDIO_OUT_Pin GPIO_PIN_4
#define AUDIO_OUT_GPIO_Port GPIOA
#define LCD_RD_Pin GPIO_PIN_5
#define LCD_RD_GPIO_Port GPIOA
#define LCD_D0_Pin GPIO_PIN_6
#define LCD_D0_GPIO_Port GPIOA
#define LCD_WR_Pin GPIO_PIN_7
#define LCD_WR_GPIO_Port GPIOA
#define LCD_CS_Pin GPIO_PIN_4
#define LCD_CS_GPIO_Port GPIOC
#define LCD_RST_Pin GPIO_PIN_5
#define LCD_RST_GPIO_Port GPIOC
#define LCD_RS_Pin GPIO_PIN_0
#define LCD_RS_GPIO_Port GPIOB
#define LCD_BL_Pin GPIO_PIN_1
#define LCD_BL_GPIO_Port GPIOB
#define LCD_D2_Pin GPIO_PIN_12
#define LCD_D2_GPIO_Port GPIOB
#define LCD_D1_Pin GPIO_PIN_13
#define LCD_D1_GPIO_Port GPIOB
#define LCD_D4_Pin GPIO_PIN_14
#define LCD_D4_GPIO_Port GPIOB
#define LCD_D3_Pin GPIO_PIN_15
#define LCD_D3_GPIO_Port GPIOB
#define LCD_D5_Pin GPIO_PIN_8
#define LCD_D5_GPIO_Port GPIOD
#define LCD_D6_Pin GPIO_PIN_8
#define LCD_D6_GPIO_Port GPIOA
#define LCD_D7_Pin GPIO_PIN_9
#define LCD_D7_GPIO_Port GPIOA
#define ROTP1_Pin GPIO_PIN_0
#define ROTP1_GPIO_Port GPIOD
#define ROTA1_Pin GPIO_PIN_1
#define ROTA1_GPIO_Port GPIOD
#define ROTA1_EXTI_IRQn EXTI1_IRQn
#define ROTB1_Pin GPIO_PIN_2
#define ROTB1_GPIO_Port GPIOD
#define ROTB1_EXTI_IRQn EXTI2_IRQn
#define ROTP2_Pin GPIO_PIN_3
#define ROTP2_GPIO_Port GPIOD
#define ROTB2_Pin GPIO_PIN_4
#define ROTB2_GPIO_Port GPIOD
#define ROTA2_Pin GPIO_PIN_5
#define ROTA2_GPIO_Port GPIOD
#define SW1_Pin GPIO_PIN_6
#define SW1_GPIO_Port GPIOD
#define SW2_Pin GPIO_PIN_7
#define SW2_GPIO_Port GPIOD
#define SW3_Pin GPIO_PIN_9
#define SW3_GPIO_Port GPIOG
#define SW3G10_Pin GPIO_PIN_10
#define SW3G10_GPIO_Port GPIOG
#define SW5_Pin GPIO_PIN_11
#define SW5_GPIO_Port GPIOG
#define SLIDE_SW_Pin GPIO_PIN_12
#define SLIDE_SW_GPIO_Port GPIOG
#define SLIDE_SW_EXTI_IRQn EXTI15_10_IRQn
#define BAT_DIAG_Pin GPIO_PIN_13
#define BAT_DIAG_GPIO_Port GPIOG
#define POWER_GOOD_Pin GPIO_PIN_14
#define POWER_GOOD_GPIO_Port GPIOG
