CullenSharp/Etch-A-Tune/SPI_screen/Core/Src/Lcd/ili9341.c

#include "main.h"
#include "Lcd/lcd.h"
#include "Lcd/lcd_io.h"
#include "Lcd/bmp.h"
#include "Lcd/ili9341.h"

void     ili9341_Init(void);
uint32_t ili9341_ReadID(void);
void     ili9341_DisplayOn(void);
void     ili9341_DisplayOff(void);
void     ili9341_SetCursor(uint16_t Xpos, uint16_t Ypos);
void     ili9341_WritePixel(uint16_t Xpos, uint16_t Ypos, uint16_t RGB_Code);
uint16_t ili9341_ReadPixel(uint16_t Xpos, uint16_t Ypos);
void     ili9341_SetDisplayWindow(uint16_t Xpos, uint16_t Ypos, uint16_t Width, uint16_t Height);
void     ili9341_DrawHLine(uint16_t RGBCode, uint16_t Xpos, uint16_t Ypos, uint16_t Length);
void     ili9341_DrawVLine(uint16_t RGBCode, uint16_t Xpos, uint16_t Ypos, uint16_t Length);
void     ili9341_FillRect(uint16_t Xpos, uint16_t Ypos, uint16_t Xsize, uint16_t Ysize, uint16_t RGBCode);
uint16_t ili9341_GetLcdPixelWidth(void);
uint16_t ili9341_GetLcdPixelHeight(void);
void     ili9341_DrawBitmap(uint16_t Xpos, uint16_t Ypos, uint8_t *pbmp);
void     ili9341_DrawRGBImage(uint16_t Xpos, uint16_t Ypos, uint16_t Xsize, uint16_t Ysize, uint16_t *pData);
void     ili9341_ReadRGBImage(uint16_t Xpos, uint16_t Ypos, uint16_t Xsize, uint16_t Ysize, uint16_t *pData);
void     ili9341_Scroll(int16_t Scroll, uint16_t TopFix, uint16_t BottonFix);
void     ili9341_UserCommand(uint16_t Command, uint8_t * pData, uint32_t Size, uint8_t Mode);

LCD_DrvTypeDef   ili9341_drv =
{
  ili9341_Init,
  ili9341_ReadID,
  ili9341_DisplayOn,
  ili9341_DisplayOff,
  ili9341_SetCursor,
  ili9341_WritePixel,
  ili9341_ReadPixel,
  ili9341_SetDisplayWindow,
  ili9341_DrawHLine,
  ili9341_DrawVLine,
  ili9341_GetLcdPixelWidth,
  ili9341_GetLcdPixelHeight,
  ili9341_DrawBitmap,
  ili9341_DrawRGBImage,
  ili9341_FillRect,
  ili9341_ReadRGBImage,
  ili9341_Scroll,
  ili9341_UserCommand
};

LCD_DrvTypeDef  *lcd_drv = &ili9341_drv;

/* transaction data */
#define TRANSDATAMAXSIZE  4
union
{
  char       c[TRANSDATAMAXSIZE];
  uint8_t   d8[TRANSDATAMAXSIZE];
  uint16_t d16[TRANSDATAMAXSIZE / 2];
}transdata;

#define ILI9341_NOP            0x00
#define ILI9341_SWRESET        0x01

#define ILI9341_RDDID          0x04
#define ILI9341_RDDST          0x09
#define ILI9341_RDMODE         0x0A
#define ILI9341_RDMADCTL       0x0B
#define ILI9341_RDPIXFMT       0x0C
#define ILI9341_RDIMGFMT       0x0D
#define ILI9341_RDSELFDIAG     0x0F

#define ILI9341_SLPIN          0x10
#define ILI9341_SLPOUT         0x11
#define ILI9341_PTLON          0x12
#define ILI9341_NORON          0x13

#define ILI9341_INVOFF         0x20
#define ILI9341_INVON          0x21
#define ILI9341_GAMMASET       0x26
#define ILI9341_DISPOFF        0x28
#define ILI9341_DISPON         0x29

#define ILI9341_CASET          0x2A
#define ILI9341_PASET          0x2B
#define ILI9341_RAMWR          0x2C
#define ILI9341_RAMRD          0x2E

#define ILI9341_PTLAR          0x30
#define ILI9341_VSCRDEF        0x33
#define ILI9341_MADCTL         0x36
#define ILI9341_VSCRSADD       0x37     /* Vertical Scrolling Start Address */
#define ILI9341_PIXFMT         0x3A     /* COLMOD: Pixel Format Set */

#define ILI9341_RGB_INTERFACE  0xB0     /* RGB Interface Signal Control */
#define ILI9341_FRMCTR1        0xB1
#define ILI9341_FRMCTR2        0xB2
#define ILI9341_FRMCTR3        0xB3
#define ILI9341_INVCTR         0xB4
#define ILI9341_DFUNCTR        0xB6     /* Display Function Control */

#define ILI9341_PWCTR1         0xC0
#define ILI9341_PWCTR2         0xC1
#define ILI9341_PWCTR3         0xC2
#define ILI9341_PWCTR4         0xC3
#define ILI9341_PWCTR5         0xC4
#define ILI9341_VMCTR1         0xC5
#define ILI9341_VMCTR2         0xC7

#define ILI9341_RDID1          0xDA
#define ILI9341_RDID2          0xDB
#define ILI9341_RDID3          0xDC
#define ILI9341_RDID4          0xDD

#define ILI9341_GMCTRP1        0xE0
#define ILI9341_GMCTRN1        0xE1

#define ILI9341_PWCTR6         0xFC
#define ILI9341_INTERFACE      0xF6   /* Interface control register */

/* Extend register commands */
#define ILI9341_POWERA         0xCB   /* Power control A register */
#define ILI9341_POWERB         0xCF   /* Power control B register */
#define ILI9341_DTCA           0xE8   /* Driver timing control A */
#define ILI9341_DTCB           0xEA   /* Driver timing control B */
#define ILI9341_POWER_SEQ      0xED   /* Power on sequence register */
#define ILI9341_3GAMMA_EN      0xF2   /* 3 Gamma enable register */
#define ILI9341_PRC            0xF7   /* Pump ratio control register */

//-----------------------------------------------------------------------------
#define ILI9341_MAD_RGB        0x00
#define ILI9341_MAD_BGR        0x08

#define ILI9341_MAD_VERTICAL   0x20
#define ILI9341_MAD_X_LEFT     0x00
#define ILI9341_MAD_X_RIGHT    0x40
#define ILI9341_MAD_Y_UP       0x80
#define ILI9341_MAD_Y_DOWN     0x00

#if ILI9341_COLORMODE == 0
#define ILI9341_MAD_COLORMODE  ILI9341_MAD_RGB
#else
#define ILI9341_MAD_COLORMODE  ILI9341_MAD_BGR
#endif

#if (ILI9341_ORIENTATION == 0)
#define ILI9341_SIZE_X                     ILI9341_LCD_PIXEL_WIDTH
#define ILI9341_SIZE_Y                     ILI9341_LCD_PIXEL_HEIGHT
#define ILI9341_MAD_DATA_RIGHT_THEN_UP     (ILI9341_MAD_COLORMODE | ILI9341_MAD_X_RIGHT | ILI9341_MAD_Y_UP)
#define ILI9341_MAD_DATA_RIGHT_THEN_DOWN   (ILI9341_MAD_COLORMODE | ILI9341_MAD_X_RIGHT | ILI9341_MAD_Y_DOWN)
#define XSIZE                              Xsize
#define YSIZE                              Ysize
#elif (ILI9341_ORIENTATION == 1)
#define ILI9341_SIZE_X                     ILI9341_LCD_PIXEL_HEIGHT
#define ILI9341_SIZE_Y                     ILI9341_LCD_PIXEL_WIDTH
#define ILI9341_MAD_DATA_RIGHT_THEN_UP     (ILI9341_MAD_COLORMODE | ILI9341_MAD_X_RIGHT | ILI9341_MAD_Y_DOWN | ILI9341_MAD_VERTICAL)
#define ILI9341_MAD_DATA_RIGHT_THEN_DOWN   (ILI9341_MAD_COLORMODE | ILI9341_MAD_X_LEFT  | ILI9341_MAD_Y_DOWN | ILI9341_MAD_VERTICAL)
#define XSIZE                              Ysize
#define YSIZE                              Xsize
#elif (ILI9341_ORIENTATION == 2)
#define ILI9341_SIZE_X                     ILI9341_LCD_PIXEL_WIDTH
#define ILI9341_SIZE_Y                     ILI9341_LCD_PIXEL_HEIGHT
#define ILI9341_MAD_DATA_RIGHT_THEN_UP     (ILI9341_MAD_COLORMODE | ILI9341_MAD_X_LEFT  | ILI9341_MAD_Y_DOWN)
#define ILI9341_MAD_DATA_RIGHT_THEN_DOWN   (ILI9341_MAD_COLORMODE | ILI9341_MAD_X_LEFT  | ILI9341_MAD_Y_UP)
#define XSIZE                              Xsize
#define YSIZE                              Ysize
#elif (ILI9341_ORIENTATION == 3)
#define ILI9341_SIZE_X                     ILI9341_LCD_PIXEL_HEIGHT
#define ILI9341_SIZE_Y                     ILI9341_LCD_PIXEL_WIDTH
#define ILI9341_MAD_DATA_RIGHT_THEN_UP     (ILI9341_MAD_COLORMODE | ILI9341_MAD_X_LEFT  | ILI9341_MAD_Y_UP   | ILI9341_MAD_VERTICAL)
#define ILI9341_MAD_DATA_RIGHT_THEN_DOWN   (ILI9341_MAD_COLORMODE | ILI9341_MAD_X_RIGHT | ILI9341_MAD_Y_UP   | ILI9341_MAD_VERTICAL)
#define XSIZE                              Ysize
#define YSIZE                              Xsize
#endif

#define ILI9341_SETWINDOW(x1, x2, y1, y2) \
  { transdata.d16[0] = __REVSH(x1); transdata.d16[1] = __REVSH(x2); LCD_IO_WriteCmd8MultipleData8(ILI9341_CASET, &transdata, 4); \
    transdata.d16[0] = __REVSH(y1); transdata.d16[1] = __REVSH(y2); LCD_IO_WriteCmd8MultipleData8(ILI9341_PASET, &transdata, 4); }

#define ILI9341_SETCURSOR(x, y)            ILI9341_SETWINDOW(x, x, y, y)

//-----------------------------------------------------------------------------
#define ILI9341_LCD_INITIALIZED    0x01
#define ILI9341_IO_INITIALIZED     0x02
static  uint8_t   Is_ili9341_Initialized = 0;

const uint8_t EntryRightThenUp = ILI9341_MAD_DATA_RIGHT_THEN_UP;
const uint8_t EntryRightThenDown = ILI9341_MAD_DATA_RIGHT_THEN_DOWN;

/* the last set drawing direction is stored here */
uint8_t LastEntry = ILI9341_MAD_DATA_RIGHT_THEN_DOWN;

static  uint16_t  yStart, yEnd;

//-----------------------------------------------------------------------------
/* Pixel draw and read functions */

#if ILI9341_WRITEBITDEPTH == ILI9341_READBITDEPTH
/* 16/16 and 24/24 bit, no need to change bitdepth data */
#define SetWriteDir()
#define SetReadDir()
#else /* #if ILI9341_WRITEBITDEPTH == ILI9341_READBITDEPTH */
uint8_t lastdir = 0;
#if ILI9341_WRITEBITDEPTH == 16
/* 16/24 bit */
#define SetWriteDir() {                                      \
  if(lastdir != 0)                                           \
  {                                                          \
    LCD_IO_WriteCmd8MultipleData8(ILI9341_PIXFMT, "\55", 1); \
    lastdir = 0;                                             \
  }                                                          }
#define SetReadDir() {                                       \
  if(lastdir == 0)                                           \
  {                                                          \
    LCD_IO_WriteCmd8MultipleData8(ILI9341_PIXFMT, "\66", 1); \
    lastdir = 1;                                             \
  }                                                          }
#elif ILI9341_WRITEBITDEPTH == 24
/* 24/16 bit */
#define SetWriteDir() {                                      \
  if(lastdir != 0)                                           \
  {                                                          \
    LCD_IO_WriteCmd8MultipleData8(ILI9341_PIXFMT, "\66", 1); \
    lastdir = 0;                                             \
  }                                                          }
#define SetReadDir() {                                       \
  if(lastdir == 0)                                           \
  {                                                          \
    LCD_IO_WriteCmd8MultipleData8(ILI9341_PIXFMT, "\55", 1); \
    lastdir = 1;                                             \
  }                                                          }
#endif /* #elif ILI9488_WRITEBITDEPTH == 24 */
#endif /* #else ILI9488_WRITEBITDEPTH == ILI9488_READBITDEPTH */

#if ILI9341_WRITEBITDEPTH == 16
#define  LCD_IO_DrawFill(Color, Size) { \
  SetWriteDir(); \
  LCD_IO_WriteCmd8DataFill16(ILI9341_RAMWR, Color, Size); }           /* Fill 16 bit pixel(s) */
#define  LCD_IO_DrawBitmap(pData, Size) { \
  SetWriteDir(); \
  LCD_IO_WriteCmd8MultipleData16(ILI9341_RAMWR, pData, Size); }       /* Draw 16 bit bitmap */
#elif ILI9341_WRITEBITDEPTH == 24
#define  LCD_IO_DrawFill(Color, Size) { \
  SetWriteDir(); \
  LCD_IO_WriteCmd8DataFill16to24(ILI9341_RAMWR, Color, Size); }       /* Fill 24 bit pixel(s) from 16 bit color code */
#define  LCD_IO_DrawBitmap(pData, Size) { \
  SetWriteDir(); \
  LCD_IO_WriteCmd8MultipleData16to24(ILI9341_RAMWR, pData, Size); }   /* Draw 24 bit Lcd bitmap from 16 bit bitmap data */
#endif /* #elif ILI9341_WRITEBITDEPTH == 24 */

#if ILI9341_READBITDEPTH == 16
#define  LCD_IO_ReadBitmap(pData, Size) { \
  SetReadDir(); \
  LCD_IO_ReadCmd8MultipleData16(ILI9341_RAMRD, pData, Size, 1); }     /* Read 16 bit LCD */
#elif ILI9341_READBITDEPTH == 24
#define  LCD_IO_ReadBitmap(pData, Size) { \
  SetReadDir(); \
  LCD_IO_ReadCmd8MultipleData24to16(ILI9341_RAMRD, pData, Size, 1); } /* Read 24 bit Lcd and convert to 16 bit bitmap */
#endif /* #elif ILI9341_READBITDEPTH == 24 */

//-----------------------------------------------------------------------------
/**
  * @brief  Enables the Display.
  * @param  None
  * @retval None
  */
void ili9341_DisplayOn(void)
{
  LCD_IO_Bl_OnOff(1);
  LCD_IO_WriteCmd8MultipleData8(ILI9341_SLPOUT, NULL, 0);    // Exit Sleep
}

//-----------------------------------------------------------------------------
/**
  * @brief  Disables the Display.
  * @param  None
  * @retval None
  */
void ili9341_DisplayOff(void)
{
  LCD_IO_WriteCmd8MultipleData8(ILI9341_SLPIN, NULL, 0);    // Sleep
  LCD_IO_Bl_OnOff(0);
}

//-----------------------------------------------------------------------------
/**
  * @brief  Get the LCD pixel Width.
  * @param  None
  * @retval The Lcd Pixel Width
  */
uint16_t ili9341_GetLcdPixelWidth(void)
{
  return ILI9341_SIZE_X;
}

//-----------------------------------------------------------------------------
/**
  * @brief  Get the LCD pixel Height.
  * @param  None
  * @retval The Lcd Pixel Height
  */
uint16_t ili9341_GetLcdPixelHeight(void)
{
  return ILI9341_SIZE_Y;
}

//-----------------------------------------------------------------------------
/**
  * @brief  Get the ILI9341 ID.
  * @param  None
  * @retval The ILI9341 ID
  */
uint32_t ili9341_ReadID(void)
{
  uint32_t dt = 0;
  LCD_IO_ReadCmd8MultipleData8(0xD3, (uint8_t *)&dt, 3, 1);
  return dt;
}

//-----------------------------------------------------------------------------
void ili9341_Init(void)
{
  if((Is_ili9341_Initialized & ILI9341_LCD_INITIALIZED) == 0)
  {
    Is_ili9341_Initialized |= ILI9341_LCD_INITIALIZED;
    if((Is_ili9341_Initialized & ILI9341_IO_INITIALIZED) == 0)
      LCD_IO_Init();
    Is_ili9341_Initialized |= ILI9341_IO_INITIALIZED;
  }

  LCD_Delay(10);
  LCD_IO_WriteCmd8MultipleData8(ILI9341_SWRESET, NULL, 0);
  LCD_Delay(10);

  LCD_IO_WriteCmd8MultipleData8(0xEF, (uint8_t *)"\x03\x80\x02", 3);
  LCD_IO_WriteCmd8MultipleData8(0xCF, (uint8_t *)"\x00\xC1\x30", 3);
  LCD_IO_WriteCmd8MultipleData8(0xED, (uint8_t *)"\x64\x03\x12\x81", 4);
  LCD_IO_WriteCmd8MultipleData8(0xE8, (uint8_t *)"\x85\x00\x78", 3);
  LCD_IO_WriteCmd8MultipleData8(0xCB, (uint8_t *)"\x39\x2C\x00\x34\x02", 5);
  LCD_IO_WriteCmd8MultipleData8(0xF7, (uint8_t *)"\x20", 1);
  LCD_IO_WriteCmd8MultipleData8(0xEA, (uint8_t *)"\x00\x00", 2);

  // Power Control 1 (Vreg1out, Verg2out)
  LCD_IO_WriteCmd8MultipleData8(ILI9341_PWCTR1, (uint8_t *)"\x23", 1);

  // Power Control 2 (VGH,VGL)
  LCD_IO_WriteCmd8MultipleData8(ILI9341_PWCTR2, (uint8_t *)"\x10", 1);

  // Power Control 3 (Vcom)
  LCD_IO_WriteCmd8MultipleData8(ILI9341_VMCTR1, (uint8_t *)"\x3E\x28", 2);

  // Power Control 3 (Vcom)
  LCD_IO_WriteCmd8MultipleData8(ILI9341_VMCTR2, (uint8_t *)"\x86", 1);

  // Vertical scroll zero
  LCD_IO_WriteCmd8MultipleData8(ILI9341_VSCRSADD, (uint8_t *)"\x00", 1);
  #if ILI9341_WRITEBITDEPTH == 16
  LCD_IO_WriteCmd8MultipleData8(ILI9341_PIXFMT, (uint8_t *)"\x55", 1);
  #elif ILI9341_WRITEBITDEPTH == 24
  LCD_IO_WriteCmd8MultipleData8(ILI9341_PIXFMT, (uint8_t *)"\x66", 1);
  #endif

  LCD_IO_WriteCmd8MultipleData8(ILI9341_FRMCTR1, (uint8_t *)"\x00\x18", 2);
  LCD_IO_WriteCmd8MultipleData8(ILI9341_DFUNCTR, (uint8_t *)"\x08\x82\x27", 3);  // Display Function Control
  LCD_IO_WriteCmd8MultipleData8(0xF2, (uint8_t *)"\x00", 1);            // 3Gamma Function Disable
  LCD_IO_WriteCmd8MultipleData8(ILI9341_GAMMASET, (uint8_t *)"\x01", 1);// Gamma curve selected

  // positive gamma control
  LCD_IO_WriteCmd8MultipleData8(ILI9341_GMCTRP1, (uint8_t *)"\x0F\x31\x2B\x0C\x0E\x08\x4E\xF1\x37\x07\x10\x03\x0E\x09\x00", 15);

  // negative gamma control
  LCD_IO_WriteCmd8MultipleData8(ILI9341_GMCTRN1, (uint8_t *)"\x00\x0E\x14\x03\x11\x07\x31\xC1\x48\x08\x0F\x0C\x31\x36\x0F", 15);

  LCD_IO_WriteCmd8MultipleData8(ILI9341_MADCTL, &EntryRightThenDown, 1);
  LCD_IO_WriteCmd8MultipleData8(ILI9341_SLPOUT, NULL, 0);    // Exit Sleep
  LCD_Delay(10);

  #if ILI9341_INITCLEAR == 1
  ili9341_FillRect(0, 0, ILI9341_SIZE_X, ILI9341_SIZE_Y, 0x0000);
  LCD_Delay(10);
  #endif
  
  LCD_IO_WriteCmd8MultipleData8(ILI9341_DISPON, NULL, 0);    // Display on
  LCD_Delay(10);
}

//-----------------------------------------------------------------------------
/**
  * @brief  Set Cursor position.
  * @param  Xpos: specifies the X position.
  * @param  Ypos: specifies the Y position.
  * @retval None
  */
void ili9341_SetCursor(uint16_t Xpos, uint16_t Ypos)
{
  ILI9341_SETCURSOR(Xpos, Ypos);
}

//-----------------------------------------------------------------------------
/**
  * @brief  Write pixel.
  * @param  Xpos: specifies the X position.
  * @param  Ypos: specifies the Y position.
  * @param  RGBCode: the RGB pixel color
  * @retval None
  */
void ili9341_WritePixel(uint16_t Xpos, uint16_t Ypos, uint16_t RGBCode)
{
  if(LastEntry != ILI9341_MAD_DATA_RIGHT_THEN_DOWN)
  {
    LastEntry = ILI9341_MAD_DATA_RIGHT_THEN_DOWN;
    LCD_IO_WriteCmd8MultipleData8(ILI9341_MADCTL, &EntryRightThenDown, 1);
  }
  ILI9341_SETCURSOR(Xpos, Ypos);
  LCD_IO_DrawFill(RGBCode, 1);
}


//-----------------------------------------------------------------------------
/**
  * @brief  Read pixel.
  * @param  None
  * @retval the RGB pixel color
  */
uint16_t ili9341_ReadPixel(uint16_t Xpos, uint16_t Ypos)
{
  uint16_t ret;
  if(LastEntry != ILI9341_MAD_DATA_RIGHT_THEN_DOWN)
  {
    LastEntry = ILI9341_MAD_DATA_RIGHT_THEN_DOWN;
    LCD_IO_WriteCmd8MultipleData8(ILI9341_MADCTL, &EntryRightThenDown, 1);
  }
  ILI9341_SETCURSOR(Xpos, Ypos);
  LCD_IO_ReadBitmap(&ret, 1);
  return(ret);
}

//-----------------------------------------------------------------------------
/**
  * @brief  Sets a display window
  * @param  Xpos:   specifies the X bottom left position.
  * @param  Ypos:   specifies the Y bottom left position.
  * @param  Height: display window height.
  * @param  Width:  display window width.
  * @retval None
  */
void ili9341_SetDisplayWindow(uint16_t Xpos, uint16_t Ypos, uint16_t Width, uint16_t Height)
{
  yStart = Ypos; yEnd = Ypos + Height - 1;
  ILI9341_SETWINDOW(Xpos, Xpos + Width - 1, Ypos, Ypos + Height - 1);
}

//-----------------------------------------------------------------------------
/**
  * @brief  Draw vertical line.
  * @param  RGBCode: Specifies the RGB color
  * @param  Xpos:     specifies the X position.
  * @param  Ypos:     specifies the Y position.
  * @param  Length:   specifies the Line length.
  * @retval None
  */
void ili9341_DrawHLine(uint16_t RGBCode, uint16_t Xpos, uint16_t Ypos, uint16_t Length)
{
  if(LastEntry != ILI9341_MAD_DATA_RIGHT_THEN_DOWN)
  {
    LastEntry = ILI9341_MAD_DATA_RIGHT_THEN_DOWN;
    LCD_IO_WriteCmd8MultipleData8(ILI9341_MADCTL, &EntryRightThenDown, 1);
  }
  ILI9341_SETWINDOW(Xpos, Xpos + Length - 1, Ypos, Ypos);
  LCD_IO_DrawFill(RGBCode, Length);
}

//-----------------------------------------------------------------------------
/**
  * @brief  Draw vertical line.
  * @param  RGBCode: Specifies the RGB color
  * @param  Xpos:     specifies the X position.
  * @param  Ypos:     specifies the Y position.
  * @param  Length:   specifies the Line length.
  * @retval None
  */
void ili9341_DrawVLine(uint16_t RGBCode, uint16_t Xpos, uint16_t Ypos, uint16_t Length)
{
  if(LastEntry != ILI9341_MAD_DATA_RIGHT_THEN_DOWN)
  {
    LastEntry = ILI9341_MAD_DATA_RIGHT_THEN_DOWN;
    LCD_IO_WriteCmd8MultipleData8(ILI9341_MADCTL, &EntryRightThenDown, 1);
  }
  ILI9341_SETWINDOW(Xpos, Xpos, Ypos, Ypos + Length - 1);
  LCD_IO_DrawFill(RGBCode, Length);
}

//-----------------------------------------------------------------------------
/**
  * @brief  Draw Filled rectangle
  * @param  Xpos:     specifies the X position.
  * @param  Ypos:     specifies the Y position.
  * @param  Xsize:    specifies the X size
  * @param  Ysize:    specifies the Y size
  * @param  RGBCode:  specifies the RGB color
  * @retval None
  */
void ili9341_FillRect(uint16_t Xpos, uint16_t Ypos, uint16_t Xsize, uint16_t Ysize, uint16_t RGBCode)
{
  if(LastEntry != ILI9341_MAD_DATA_RIGHT_THEN_DOWN)
  {
    LastEntry = ILI9341_MAD_DATA_RIGHT_THEN_DOWN;
    LCD_IO_WriteCmd8MultipleData8(ILI9341_MADCTL, &EntryRightThenDown, 1);
  }
  ILI9341_SETWINDOW(Xpos, Xpos + Xsize - 1, Ypos, Ypos + Ysize - 1);
  LCD_IO_DrawFill(RGBCode, Xsize * Ysize);
}

//-----------------------------------------------------------------------------
/**
  * @brief  Displays a 16bit bitmap picture..
  * @param  BmpAddress: Bmp picture address.
  * @param  Xpos:  Bmp X position in the LCD
  * @param  Ypos:  Bmp Y position in the LCD
  * @retval None
  * @brief  Draw direction: right then up
  */
void ili9341_DrawBitmap(uint16_t Xpos, uint16_t Ypos, uint8_t *pbmp)
{
  uint32_t index, size;
  /* Read bitmap size */
  size = ((BITMAPSTRUCT *)pbmp)->fileHeader.bfSize;
  /* Get bitmap data address offset */
  index = ((BITMAPSTRUCT *)pbmp)->fileHeader.bfOffBits;
  size = (size - index) / 2;
  pbmp += index;

  if(LastEntry != ILI9341_MAD_DATA_RIGHT_THEN_UP)
  {
    LastEntry = ILI9341_MAD_DATA_RIGHT_THEN_UP;
    LCD_IO_WriteCmd8MultipleData8(ILI9341_MADCTL, &EntryRightThenUp, 1);
  }
  transdata.d16[0] = __REVSH(ILI9341_SIZE_Y - 1 - yEnd);
  transdata.d16[1] = __REVSH(ILI9341_SIZE_Y - 1 - yStart);
  LCD_IO_WriteCmd8MultipleData8(ILI9341_PASET, &transdata, 4);
  LCD_IO_DrawBitmap(pbmp, size);
}

//-----------------------------------------------------------------------------
/**
  * @brief  Displays 16bit/pixel picture..
  * @param  pdata: picture address.
  * @param  Xpos:  Image X position in the LCD
  * @param  Ypos:  Image Y position in the LCD
  * @param  Xsize: Image X size in the LCD
  * @param  Ysize: Image Y size in the LCD
  * @retval None
  * @brief  Draw direction: right then down
  */
void ili9341_DrawRGBImage(uint16_t Xpos, uint16_t Ypos, uint16_t Xsize, uint16_t Ysize, uint16_t *pData)
{
  if(LastEntry != ILI9341_MAD_DATA_RIGHT_THEN_DOWN)
  {
    LastEntry = ILI9341_MAD_DATA_RIGHT_THEN_DOWN;
    LCD_IO_WriteCmd8MultipleData8(ILI9341_MADCTL, &EntryRightThenDown, 1);
  }
  ili9341_SetDisplayWindow(Xpos, Ypos, Xsize, Ysize);
  LCD_IO_DrawBitmap(pData, Xsize * Ysize);
}

//-----------------------------------------------------------------------------
/**
  * @brief  Read 16bit/pixel picture from Lcd and store to RAM
  * @param  pdata: picture address.
  * @param  Xpos:  Image X position in the LCD
  * @param  Ypos:  Image Y position in the LCD
  * @param  Xsize: Image X size in the LCD
  * @param  Ysize: Image Y size in the LCD
  * @retval None
  * @brief  Draw direction: right then down
  */
void ili9341_ReadRGBImage(uint16_t Xpos, uint16_t Ypos, uint16_t Xsize, uint16_t Ysize, uint16_t *pData)
{
  if(LastEntry != ILI9341_MAD_DATA_RIGHT_THEN_DOWN)
  {
    LastEntry = ILI9341_MAD_DATA_RIGHT_THEN_DOWN;
    LCD_IO_WriteCmd8MultipleData8(ILI9341_MADCTL, &EntryRightThenDown, 1);
  }
  ili9341_SetDisplayWindow(Xpos, Ypos, Xsize, Ysize);
  LCD_IO_ReadBitmap(pData, Xsize * Ysize);
}

//-----------------------------------------------------------------------------
/**
  * @brief  Set display scroll parameters
  * @param  Scroll    : Scroll size [pixel]
  * @param  TopFix    : Top fix size [pixel]
  * @param  BottonFix : Botton fix size [pixel]
  * @retval None
  */
void ili9341_Scroll(int16_t Scroll, uint16_t TopFix, uint16_t BottonFix)
{
  static uint16_t scrparam[4] = {0, 0, 0, 0};
  #if (ILI9341_ORIENTATION == 0)
  if((TopFix != __REVSH(scrparam[1])) || (BottonFix != __REVSH(scrparam[3])))
  {
    scrparam[1] = __REVSH(TopFix);
    scrparam[3] = __REVSH(BottonFix);
    scrparam[2] = __REVSH(ILI9341_LCD_PIXEL_HEIGHT - TopFix - BottonFix);
    LCD_IO_WriteCmd8MultipleData8(ILI9341_VSCRDEF, &scrparam[1], 6);
  }
  Scroll = (0 - Scroll) % __REVSH(scrparam[2]);
  if(Scroll < 0)
    Scroll = __REVSH(scrparam[2]) + Scroll + __REVSH(scrparam[1]);
  else
    Scroll = Scroll + __REVSH(scrparam[1]);
  #elif (ILI9341_ORIENTATION == 1)
  if((TopFix != __REVSH(scrparam[1])) || (BottonFix != __REVSH(scrparam[3])))
  {
    scrparam[1] = __REVSH(TopFix);
    scrparam[3] = __REVSH(BottonFix);
    scrparam[2] = __REVSH(ILI9341_LCD_PIXEL_HEIGHT - TopFix - BottonFix);
    LCD_IO_WriteCmd8MultipleData8(ILI9341_VSCRDEF, &scrparam[1], 6);
  }
  Scroll = (0 - Scroll) % __REVSH(scrparam[2]);
  if(Scroll < 0)
    Scroll = __REVSH(scrparam[2]) + Scroll + __REVSH(scrparam[1]);
  else
    Scroll = Scroll + __REVSH(scrparam[1]);
  #elif (ILI9341_ORIENTATION == 2)
  if((TopFix != __REVSH(scrparam[3])) || (BottonFix != __REVSH(scrparam[1])))
  {
    scrparam[3] = __REVSH(TopFix);
    scrparam[1] = __REVSH(BottonFix);
    scrparam[2] = __REVSH(ILI9341_LCD_PIXEL_HEIGHT - TopFix - BottonFix);
    LCD_IO_WriteCmd8MultipleData8(ILI9341_VSCRDEF, &scrparam[1], 6);
  }
  Scroll %= scrparam[2];
  if(Scroll < 0)
    Scroll = scrparam[2] + Scroll + scrparam[1];
  else
    Scroll = Scroll + scrparam[1];
  #elif (ILI9341_ORIENTATION == 3)
  if((TopFix != __REVSH(scrparam[3])) || (BottonFix != __REVSH(scrparam[1])))
  {
    scrparam[3] = __REVSH(TopFix);
    scrparam[1] = __REVSH(BottonFix);
    scrparam[2] = __REVSH(ILI9341_LCD_PIXEL_HEIGHT - TopFix - BottonFix);
    LCD_IO_WriteCmd8MultipleData8(ILI9341_VSCRDEF, &scrparam[1], 6);
  }
  Scroll %= __REVSH(scrparam[2]);
  if(Scroll < 0)
    Scroll = __REVSH(scrparam[2]) + Scroll + __REVSH(scrparam[1]);
  else
    Scroll = Scroll + __REVSH(scrparam[1]);
  #endif
  if(Scroll != __REVSH(scrparam[0]))
  {
    scrparam[0] = __REVSH(Scroll);
    LCD_IO_WriteCmd8MultipleData8(ILI9341_VSCRSADD, &scrparam[0], 2);
  }
}

//-----------------------------------------------------------------------------
/**
  * @brief  User command
  * @param  Command   : Lcd command
  * @param  pData     : data pointer
  * @param  Size      : data number
  * @param  Mode      : 0=write 8bits datas, 1=0=write 16bits datas, 2=read 8bits datas, 3=read 16bits datas
  * @retval None
  */
void ili9341_UserCommand(uint16_t Command, uint8_t* pData, uint32_t Size, uint8_t Mode)
{
  if(Mode == 0)
    LCD_IO_WriteCmd8MultipleData8((uint8_t)Command, pData, Size);
  else if(Mode == 1)
    LCD_IO_WriteCmd8MultipleData16((uint8_t)Command, pData, Size);
  else if(Mode == 2)
    LCD_IO_ReadCmd8MultipleData8((uint8_t)Command, pData, Size, 1);
  else if(Mode == 3)
    LCD_IO_ReadCmd8MultipleData16((uint8_t)Command, pData, Size, 1);
}
