CullenSharp/Etch-A-Tune/SPI_screen/Core/Src/Lcd/lcd_io_gpio8_hal.c

/*
 * 8 bit paralell LCD GPIO driver for all stm32 family
 * 5 controll pins (CS, RS, WR, RD, RST) + 8 data pins + 1 backlight pin
 */

/*
 * Author: Roberto Benjami
 * version:  2023.04
 */

#include "main.h"
#include "Lcd/lcd.h"
#include "Lcd/lcd_io.h"
#include "Lcd/lcd_io_gpio8_hal.h"

/* processor family dependent things */
#include "stm32h7xx_ll_gpio.h"

//-----------------------------------------------------------------------------
/* Bitdepth convert macros */
#if LCD_RGB24_ORDER == 0
#define  RGB565TO888(c16)     ((c16 & 0xF800) << 8) | ((c16 & 0x07E0) << 5) | ((c16 & 0x001F) << 3)
#define  RGB888TO565(c24)     ((c24 & 0XF80000) >> 8 | (c24 & 0xFC00) >> 5 | (c24 & 0xF8 ) >> 3)
#elif LCD_RGB24_ORDER == 1
#define  RGB565TO888(c16)     ((c16 & 0xF800) >> 8) | ((c16 & 0x07E0) << 5) | ((c16 & 0x001F) << 19)
#define  RGB888TO565(c24)     ((c24 & 0XF80000) >> 19 | (c24 & 0xFC00) >> 5 | (c24 & 0xF8 ) << 8)
#endif /* #elif LCD_RGB24_ORDER == 1 */

//-----------------------------------------------------------------------------
#if LCD_DATADIR == 1

/* Sets the data pins to input */
void LCDDirRead(void)
{
  #ifdef LCD_DIRREAD
  LCD_DIRREAD;
  #else
  LL_GPIO_SetPinMode(LCD_D0_GPIO_Port, LCD_D0_Pin, LL_GPIO_MODE_INPUT);
  LL_GPIO_SetPinMode(LCD_D1_GPIO_Port, LCD_D1_Pin, LL_GPIO_MODE_INPUT);
  LL_GPIO_SetPinMode(LCD_D2_GPIO_Port, LCD_D2_Pin, LL_GPIO_MODE_INPUT);
  LL_GPIO_SetPinMode(LCD_D3_GPIO_Port, LCD_D3_Pin, LL_GPIO_MODE_INPUT);
  LL_GPIO_SetPinMode(LCD_D4_GPIO_Port, LCD_D4_Pin, LL_GPIO_MODE_INPUT);
  LL_GPIO_SetPinMode(LCD_D5_GPIO_Port, LCD_D5_Pin, LL_GPIO_MODE_INPUT);
  LL_GPIO_SetPinMode(LCD_D6_GPIO_Port, LCD_D6_Pin, LL_GPIO_MODE_INPUT);
  LL_GPIO_SetPinMode(LCD_D7_GPIO_Port, LCD_D7_Pin, LL_GPIO_MODE_INPUT);
  #endif
}

//-----------------------------------------------------------------------------
/* Sets the data pins to output */
void LCDDirWrite(void)
{
  #ifdef LCD_DIRWRITE
  LCD_DIRWRITE;
  #else
  LL_GPIO_SetPinMode(LCD_D0_GPIO_Port, LCD_D0_Pin, LL_GPIO_MODE_OUTPUT);
  LL_GPIO_SetPinMode(LCD_D1_GPIO_Port, LCD_D1_Pin, LL_GPIO_MODE_OUTPUT);
  LL_GPIO_SetPinMode(LCD_D2_GPIO_Port, LCD_D2_Pin, LL_GPIO_MODE_OUTPUT);
  LL_GPIO_SetPinMode(LCD_D3_GPIO_Port, LCD_D3_Pin, LL_GPIO_MODE_OUTPUT);
  LL_GPIO_SetPinMode(LCD_D4_GPIO_Port, LCD_D4_Pin, LL_GPIO_MODE_OUTPUT);
  LL_GPIO_SetPinMode(LCD_D5_GPIO_Port, LCD_D5_Pin, LL_GPIO_MODE_OUTPUT);
  LL_GPIO_SetPinMode(LCD_D6_GPIO_Port, LCD_D6_Pin, LL_GPIO_MODE_OUTPUT);
  LL_GPIO_SetPinMode(LCD_D7_GPIO_Port, LCD_D7_Pin, LL_GPIO_MODE_OUTPUT);
  #endif
}

//-----------------------------------------------------------------------------
/* Read the data pins */
uint8_t LCDRead8(void)
{
  uint8_t ret = 0;
  HAL_GPIO_WritePin(LCD_RD_GPIO_Port, LCD_RD_Pin, GPIO_PIN_RESET);
  #ifdef LCD_READ
  LCD_READ(ret);
  #else
  if(HAL_GPIO_ReadPin(LCD_D0_GPIO_Port, LCD_D0_Pin))
    ret = 0x01;
  if(HAL_GPIO_ReadPin(LCD_D1_GPIO_Port, LCD_D1_Pin))
    ret |= 0x02;
  if(HAL_GPIO_ReadPin(LCD_D2_GPIO_Port, LCD_D2_Pin))
    ret |= 0x04;
  if(HAL_GPIO_ReadPin(LCD_D3_GPIO_Port, LCD_D3_Pin))
    ret |= 0x08;
  if(HAL_GPIO_ReadPin(LCD_D4_GPIO_Port, LCD_D4_Pin))
    ret |= 0x10;
  if(HAL_GPIO_ReadPin(LCD_D5_GPIO_Port, LCD_D5_Pin))
    ret |= 0x20;
  if(HAL_GPIO_ReadPin(LCD_D6_GPIO_Port, LCD_D6_Pin))
    ret |= 0x40;
  if(HAL_GPIO_ReadPin(LCD_D7_GPIO_Port, LCD_D7_Pin))
    ret |= 0x80;
  #endif
  HAL_GPIO_WritePin(LCD_RD_GPIO_Port, LCD_RD_Pin, GPIO_PIN_SET);
  return ret;
}
#endif

//-----------------------------------------------------------------------------
/* Write the data pins */
void LCDWrite8(uint8_t dt8)
{
  #ifdef LCD_WRITE
  LCD_WRITE(dt8);
  #else
  static uint8_t pre_dt8 = 0;
  if(dt8 != pre_dt8)
  {
    pre_dt8 = dt8;
    HAL_GPIO_WritePin(LCD_D0_GPIO_Port, LCD_D0_Pin, dt8 & 0x01);
    HAL_GPIO_WritePin(LCD_D1_GPIO_Port, LCD_D1_Pin, dt8 & 0x02);
    HAL_GPIO_WritePin(LCD_D2_GPIO_Port, LCD_D2_Pin, dt8 & 0x04);
    HAL_GPIO_WritePin(LCD_D3_GPIO_Port, LCD_D3_Pin, dt8 & 0x08);
    HAL_GPIO_WritePin(LCD_D4_GPIO_Port, LCD_D4_Pin, dt8 & 0x10);
    HAL_GPIO_WritePin(LCD_D5_GPIO_Port, LCD_D5_Pin, dt8 & 0x20);
    HAL_GPIO_WritePin(LCD_D6_GPIO_Port, LCD_D6_Pin, dt8 & 0x40);
    HAL_GPIO_WritePin(LCD_D7_GPIO_Port, LCD_D7_Pin, dt8 & 0x80);
  }
  #endif
  HAL_GPIO_WritePin(LCD_WR_GPIO_Port, LCD_WR_Pin, GPIO_PIN_RESET);
  HAL_GPIO_WritePin(LCD_WR_GPIO_Port, LCD_WR_Pin, GPIO_PIN_SET);
}

//=============================================================================
/* Wrtite fill and multi data to Lcd (8 and 16 bit mode)
   - pData: 8 or 16 bits data pointer
   - Size: data number
   - dinc: 0=fill mode, 1=multidata mode
   - bitdepth: 0 = 8bit data, 1 = 16bit data */
void LCDWriteFillMultiData8and16(uint8_t * pData, uint32_t Size, uint32_t Mode)
{
  if(Mode & LCD_IO_FILL)
  { /* fill */
    if(Mode & LCD_IO_DATA8)
    { /* fill 8bit */
      while(Size--) /* fill 8bit */
        LCDWrite8(*pData);
    }
    else if(Mode & LCD_IO_DATA16)
    { /* fill 16bit */
      while(Size--)
      {
        LCDWrite8((*(uint16_t *)pData) >> 8);
        LCDWrite8(*(uint16_t *)pData);
      }
    }
  }
  else
  { /* multidata */
    if(Mode & LCD_IO_DATA8)
    { /* multidata 8bit */
      while(Size--)
      {
        LCDWrite8(*pData);
        pData++;
      }
    }
    else
    { /* multidata 16bit */
      {
        while(Size--)
        {
          LCDWrite8((*(uint16_t *)pData) >> 8);
          LCDWrite8(*(uint16_t *)pData);
          pData += 2;
        }
      }
    }
  }
}

//-----------------------------------------------------------------------------
/* Wrtite fill and multi data to Lcd (convert RGB16 bit (5-6-5) to RGB24 bit (8-8-8) mode, no dma capability)
   - pData: RGB 16 bits data pointer
   - Size: data number
   - dinc: 0=fill mode, 1=multidata mode */
void LCDWriteFillMultiData16to24(uint16_t * pData, uint32_t Size, uint32_t Mode)
{
  union
  {
    uint8_t  c8[4];
    uint32_t c24;
  }rgb888;

  if(Mode & LCD_IO_FILL)
  { /* fill 16bit to 24bit */
    rgb888.c24 = RGB565TO888(*pData);
    while(Size--)
    {
      LCDWrite8(rgb888.c8[0]);
      LCDWrite8(rgb888.c8[1]);
      LCDWrite8(rgb888.c8[2]);
    }
  }
  else
  { /* multidata 16bit to 24bit */
    while(Size--)
    {
      rgb888.c24 = RGB565TO888(*pData);
      LCDWrite8(rgb888.c8[0]);
      LCDWrite8(rgb888.c8[1]);
      LCDWrite8(rgb888.c8[2]);
      pData++;
    }
  }
}

//=============================================================================
/* Read */

#if LCD_DATADIR == 1

//-----------------------------------------------------------------------------
/* Read data from Lcd
   - pData: 8 or 16 bits data pointer
   - Size: data number
   - bitdepth: 0 = 8bit data, 1 = 16bit data */
void LCDReadMultiData8and16(uint8_t * pData, uint32_t Size, uint32_t Mode)
{
  { /* not DMA mode */
    if(Mode & LCD_IO_DATA8)
    { /* 8bit */
      while(Size--)
      {
        *pData = LCDRead8();
        pData++;
      }
    }
    else
    { /* 16bit */
      while(Size--)
      {
        *(uint16_t *)pData = (LCDRead8() << 8) | LCDRead8();
        pData += 2;
      }
    }
  }
}

//-----------------------------------------------------------------------------
/* Read 24bit (8-8-8) RGB data from LCD, and convert to 16bit (5-6-5) RGB data
   - pData: 16 bits RGB data pointer
   - Size: pixel number */
void LCDReadMultiData24to16(uint16_t * pData, uint32_t Size, uint32_t Mode)
{
  union
  {
    uint8_t  c8[4];
    uint32_t c24;
  }rgb888;

  { /* not DMA mode */
    while(Size--)
    {
      rgb888.c8[0] = LCDRead8();
      rgb888.c8[1] = LCDRead8();
      rgb888.c8[2] = LCDRead8();
      *pData = RGB888TO565(rgb888.c24);
      pData++;
    }
  }
}

#endif /* #if LCD_DATADIR == 1 */

//=============================================================================
/* Public functions */

/* n millisec delay */
void LCD_Delay(uint32_t Delay)
{
  #ifndef  osCMSIS
  HAL_Delay(Delay);
  #else
  osDelay(Delay);
  #endif
}

/* Backlight on-off (Bl=0 -> off, Bl=1 -> on) */
//-----------------------------------------------------------------------------
void LCD_IO_Bl_OnOff(uint8_t Bl)
{
  #if defined(LCD_BL_GPIO_Port) && defined (LCD_BL_Pin)
  if(Bl)
    #if LCD_BLON == 0
    HAL_GPIO_WritePin(LCD_BL_GPIO_Port, LCD_BL_Pin, GPIO_PIN_RESET);
    #elif LCD_BLON == 1
    HAL_GPIO_WritePin(LCD_BL_GPIO_Port, LCD_BL_Pin, GPIO_PIN_SET);
    #endif
  else
    #if LCD_BLON == 0
    HAL_GPIO_WritePin(LCD_BL_GPIO_Port, LCD_BL_Pin, GPIO_PIN_SET);
    #elif LCD_BLON == 1
    HAL_GPIO_WritePin(LCD_BL_GPIO_Port, LCD_BL_Pin, GPIO_PIN_RESET);
    #endif
  #endif
}

//-----------------------------------------------------------------------------
/* Lcd IO init, reset, spi speed init, get the freertos task id */
void LCD_IO_Init(void)
{
  #if defined(LCD_RST_GPIO_Port) && defined (LCD_RST_Pin)
  HAL_Delay(10);
  HAL_GPIO_WritePin(LCD_RST_GPIO_Port, LCD_RST_Pin, GPIO_PIN_RESET);
  HAL_Delay(10);
  HAL_GPIO_WritePin(LCD_RST_GPIO_Port, LCD_RST_Pin, GPIO_PIN_SET);
  #endif
  LCD_Delay(10);
}

//-----------------------------------------------------------------------------
/* Lcd IO transaction
   - Cmd: 8 or 16 bits command
   - pData: 8 or 16 bits data pointer
   - Size: data number
   - DummySize: dummy byte number at read
   - Mode: 8 or 16 or 24 bit mode, write or read, fill or multidata (see the LCD_IO_... defines) */
void LCD_IO_Transaction(uint16_t Cmd, uint8_t *pData, uint32_t Size, uint32_t DummySize, uint32_t Mode)
{
  #if LCD_DATADIR == 0  /* only TX mode */
  if(Mode & LCD_IO_READ)
    return;
  #endif

  HAL_GPIO_WritePin(LCD_CS_GPIO_Port, LCD_CS_Pin, GPIO_PIN_RESET);

  /* Command write */
  HAL_GPIO_WritePin(LCD_RS_GPIO_Port, LCD_RS_Pin, GPIO_PIN_RESET);
  if(Mode & LCD_IO_CMD8)
    LCDWrite8(Cmd);
  else if(Mode & LCD_IO_CMD16)
  {
    LCDWrite8(Cmd >> 8);
    LCDWrite8(Cmd);
  }
  HAL_GPIO_WritePin(LCD_RS_GPIO_Port, LCD_RS_Pin, GPIO_PIN_SET);

  if(Size == 0)
  { /* only command byte or word */
    HAL_GPIO_WritePin(LCD_CS_GPIO_Port, LCD_CS_Pin, GPIO_PIN_SET);
    return;
  }

  /* Datas write or read */
  if(Mode & LCD_IO_WRITE)
  { /* Write Lcd */
    if(Mode & LCD_IO_DATA16TO24)
      LCDWriteFillMultiData16to24((uint16_t *)pData, Size, Mode);
    else
      LCDWriteFillMultiData8and16(pData, Size, Mode);
  }
  #if LCD_DATADIR == 1
  else if(Mode & LCD_IO_READ)
  { /* Read LCD */
    LCDDirRead();
    uint8_t RxDummy __attribute__((unused));
    while(DummySize--)
      RxDummy = LCDRead8();
    if(Mode & LCD_IO_DATA24TO16)
      LCDReadMultiData24to16((uint16_t *)pData, Size, Mode);
    else
      LCDReadMultiData8and16(pData, Size, Mode);
    LCDDirWrite();
  }
  #endif /* #if LCD_DATADIR == 1 */
  HAL_GPIO_WritePin(LCD_CS_GPIO_Port, LCD_CS_Pin, GPIO_PIN_SET);
}
