CullenSharp/Etch-A-Tune/(commit log)

2025-11-03 Adds ST7796 driver as a submodule.
2025-11-03 Moves st7796 component driver into to main project
2025-11-03 Adds XPT2046 driver as a submodule
2025-11-03 Configures spi and updates include paths
2025-11-03 Changes url due to renaming remote repository stm32_st7796
2025-11-03 Adds lcd and ts classes to the board support package
2025-11-05 Attempt to implement example code from an LCD HAL Display library. It is receiving data, based on the faint image. But it is not correct
    [TouchDemo.ioc, lcd_io_spi_hal.c, lcd_io_spi_hal.h, main.c, main.h]
2025-11-06 Changed Example to LCD Speed test and updated pin defines
2025-11-06 Updated schematic and preliminary PCB doc
    did rough PCB layout
    [Battery.kicad_sch, Controllers.kicad_sch, DAC.kicad_sch, Etch_A_Tune.kicad_pcb, Etch_A_Tune.kicad_sch, PCB_Project.kicad_pcb, Power.kicad_sch, untitled.kicad_sch]
2025-11-06 The Bread board prototype
    The current progress of the board as of 11-5-2025
2025-11-07 Working LCD Demo
    The great and powerful Cullen Sharp rewrote the drive initialization to work with the st7796s that our display uses. To be rewritten further
2025-11-07 Updated Bread Board Prototype
    The prototype works and can run example code. Example code is located on the mcma branch and is unmerged as of date.
2025-11-08 Touch Screen Calibrated, Connected, and Controlling
    The Demo is set for paint, if new hardware is used, calibration is probably needed/
2025-11-10 Moves st7796 function prototypes into st7796.h
2025-11-11 Updated Clocks and Changed orientation
    Current BitmapTest is 69ms
2025-11-12 Allocates frame buffers
2025-11-12 Fixes reversed images on draw RGBImage
    [stm32_adafruit_lcd.c]
2025-11-13 Adds demo code for DAC with TIM6 and DMA
2025-11-13 Schematic Update
    Fixed component Footprints and added new switches/rotary encoders. Wired and placed bypass capacitors for most devices. Removed 5V boost converter because external DAC is no longer being utilized. Placed uC onto board design and implemented charging through USB-C connector.
    [Battery.kicad_sch, Controllers.kicad_sch, DAC.kicad_sch, Etch_A_Tune.kicad_pcb, Etch_A_Tune.kicad_sch, Microcontroller.kicad_sch, Power.kicad_sch]
2025-11-13 Etch A Tune V.02
    Updated more foot prints and components onto bom, specifically SWD debug header and 1x14 pin header for touch and screen module. Added 4pin header for SD card reader.
    [Battery.kicad_sch, Controllers.kicad_sch, Etch_A_Tune.kicad_pcb, Etch_A_Tune.kicad_sch, Microcontroller.kicad_sch, Power.kicad_sch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]
2025-11-13 Etch A Tune BOM
    Forgot to add bom in last push
    [Etch a Tune Bom.xlsx]
2025-11-14 Incorporates the CMSIS DSP library and demo wav
    I added the CMSIS DSP library, which was painless... mostly. I haven't had a lot of luck with audio playback though.
    The output from the DAC sounds like a buzz saw.
    There's now a raw unsigned 8-bit 11025Hz WAV file programmed to flash. This is copied to RAM in main.c. From there,
    the data is pushed to the DAC by the DMA.
    The audio file was created with Audacity and xxd. The relevant command was
    xxd -i guitar.raw guitar.h
    [SPI_screen.ioc, main.c]
2025-11-15 Started Enclosure Modeling
    Rough draft without all measurements of the front panel and the knobs.
    Will likely need to scale the knobs down, and re-dimension tolerances once I can measure the parts we have
    [Assembly V1.SLDASM, Front Panel.SLDPRT, Knob.SLDPRT]
2025-11-16 Updated parallel power supply
    Updated USB and battery operation and added DAC output
    [Battery.kicad_sch, Controllers.kicad_sch, Etch a Tune Bom.xlsx, Etch_A_Tune.kicad_pcb, Etch_A_Tune.kicad_sch, Microcontroller.kicad_sch, Power.kicad_sch]
2025-11-16 Added v.03 schematic pdf
2025-11-17 V.04 Schematic
    added 64 pin header LEDS
    [Battery.kicad_sch, Etch_A_Tune.kicad_sch, Microcontroller.kicad_sch, Power.kicad_sch]
2025-11-17 Updated schematic
    [Battery.kicad_sch, Etch_A_Tune.kicad_sch, Microcontroller.kicad_sch]
2025-11-18 Final Layout before routing
    [Battery.kicad_sch, Controllers.kicad_sch, Etch_A_Tune.kicad_pcb, Etch_A_Tune.kicad_sch, Microcontroller.kicad_sch, Power.kicad_sch]
2025-11-19 Another Update! :D
    [Battery.kicad_sch, Controllers.kicad_sch, Etch_A_Tune.kicad_pcb, Etch_A_Tune.kicad_sch, Microcontroller.kicad_sch, Power.kicad_sch]
2025-11-19 pdf docs
    [Battery.kicad_sch, Controllers.kicad_sch, Etch_A_Tune.kicad_pcb, Etch_A_Tune.kicad_sch, Microcontroller.kicad_sch, Power.kicad_sch]
2025-11-19 PCB about 75% done
    [Etch_A_Tune.kicad_pcb, Microcontroller.kicad_sch]
2025-11-19 2 Layer Board
    Changed from 4 to 2 layers
    [Etch_A_Tune.kicad_pcb]
2025-11-20 Update
    Finished Analog Power Domain
    [Battery.kicad_sch, Etch_A_Tune.kicad_pcb, Microcontroller.kicad_sch]
2025-11-20 95% finished PCB
    Only changes needed for completion is ferrite bead footprint and DNP crystal osc.
    [Etch_A_Tune.kicad_pcb, Etch_A_Tune.kicad_sch, Microcontroller.kicad_sch]
2025-11-20 Update
    Added headers for ADC Pins and 4 extra GPIOs
    [Etch_A_Tune.kicad_pcb]
2025-11-20 Finished PCB
    Added ferrite bead and crystal oscillator. Added silkscreen text and tidied up component designators.
    [Etch_A_Tune.kicad_pcb, Microcontroller.kicad_sch]
2025-11-20 Update
    Changed DC blocking cap to 1206 footprint, added SVG silkscreen to back of board and added team name date and version
    [Etch_A_Tune.kicad_pcb, Etch_A_Tune.kicad_sch]
2025-11-20 Adding GBR files
    adding gbr files for 1.0 build of etch a tune, added schematic pdf files as well
    [Etch_A_Tune-B_Cu.gbr, Etch_A_Tune-B_Mask.gbr, Etch_A_Tune-B_Paste.gbr, Etch_A_Tune-B_Silkscreen.gbr, Etch_A_Tune-Edge_Cuts.gbr, Etch_A_Tune-F_Cu.gbr, Etch_A_Tune-F_Mask.gbr, Etch_A_Tune-F_Paste.gbr]
2025-11-20 Added PDF files
    added pdf alternatives for PCB
2025-11-22 Updated BOM
    Changed Values for an accurate BOM, and exported results
    [Battery.kicad_sch, Controllers.kicad_sch, Etch a Tune Bom.xlsx, Etch_A_Tune.csv, Etch_A_Tune.kicad_sch, Microcontroller.kicad_sch, Power.kicad_sch]
2025-11-22 Created Interactive BOM
    Make an interactive html bom using KiCAD plugin
2025-11-22 Updated Interactive BOM to exclude DNP
    Reading the Card Explains the Card
2025-11-25 Updates IO configuration
    This brings IO configuration to parity with board design.
2025-11-27 More in depth modeling of enclosure
    Created a PCB and screen parts for assembly and placement visualization
    [Assembly V1.SLDASM, Back Plate.SLDPRT, Front Panel Test Print 2.SLDPRT, Front Panel Test Print 2.STL, Front Panel Test Print V3.STL, Front Panel Test Print V4.SLDPRT, Front Panel Test Print V4.STL, Front Panel Test Print.SLDPRT]
2025-11-27 Making Parts Fit Together
    Spent time making the screen and pcb line up, and fixing the front screen model to match.
    Will need to make a version with a new model of the screen
    [Assembly V1.SLDASM, Back Plate.SLDPRT, Front Panel.SLDPRT, Knob.SLDPRT, PCB.SLDPRT, Screen.SLDPRT]
2025-11-29 Replace XPT2046 driver with simple analog touch driver
    [ts.c]
2025-12-02 Shells and Better Fitting
    Still need to account for tolerances that will be needed, but unsure how best to accomplish this.
    Made the shells 1/8 of an inch thick through global variables, so that should make more modeling easier
    [Assembly V1.SLDASM, Back Plate.SLDPRT, Battery Cover.SLDPRT, Battery Holder.SLDPRT, Front Panel(Old Screen).SLDPRT, Old Screen Assembly.SLDASM, PCB.SLDPRT, Screen(Old).SLDPRT]
2025-12-05 Reconfigure project to use 8bit parallel rgb interface
    I've verified that the wiring, io configuration, and lcd module are
    sound, so I'm leaving this a recovery point.
2025-12-06 Simplifies lcdSpeedTest program
    This is to simplify the integration process with the grts and lcd panel
    driver.
2025-12-06 Incorporate changes to GRTS from cullen_test
    lcd_grts_integration and cullen_test have the same driver for the GRTS
    now.
2025-12-06 Fixes GRTS bugs
    I initially had issues with the ADC sampling while the screen was
    drawing. This was fixed by adding pull downs on the adc inputs, adding
    external rc filters to Xm and Xp pins, increasing the settling time, and
    implementing a stronger digital low-pass filter.
    [SPI_screen.ioc, main.c, ts.c]
2025-12-07 Implment double buffering with hardware timer
    I setup one of the hardware timers to implement a 30Hz refresh rate. It
    handles this by swapping `write_to` and `draw_from` pointers.
2025-12-07 Implement drawing and displaying tasks
    Using FreeRTOS, I created two tasks `touch_io` and `lcd_display`.
    `touch_io` samples touch input from the resistive touch screen every 20ms and writes it to a
    buffer. `lcd_display` takes the buffer and draws it to the screen.
2025-12-07 Adds placeholder for mode switch interrupt handler
2025-12-07 Adds stub for encoder object
    I still need to implement the IRQ handlers. These should interpret the
    state of the encoder and emit an event to the calling system.
2025-12-08 Adds initial version of encoder driver
    It has one weird bug that turning clockwise decrements the position
    variable. I fixed this by changing the gpio signals associated with
    channel a and channel b.
    [encoder.c]
2025-12-08 Adds pinout data to documentation
    I generated this with CubeMX. Under the pinout tab, select "export
    pinout".
    [pinout.csv]
2025-12-08 Integrates single interrupt based encoder
2025-12-08 Removes alternate functions from pinout listing
    [pinout.csv]
2025-12-11 Made Model Presentable
    [Assembly V1.SLDASM, Back Plate.SLDPRT, Battery Cover.SLDPRT, Button.SLDPRT, Front Panel(Old Screen).SLDPRT, Knob.SLDPRT, Old Screen Assembly.SLDASM, PCB.SLDPRT]
